Jan-Philipp-Munsch/kartonaut/hardware/mainboard/Fertiger_2026-10-21.md

# Mainboard rev B – Wo fertigen lassen?

Stand 2026-10-21. Gegenstand ist der Auftrag aus `ORDER.md`: 5 Platinen, 4 Lagen, 54 × 120 × 1,6 mm,
ENIG, davon 2 nur oben SMD-bestückt. THT-Teile werden selbst gelötet. Die Zahlen stammen aus einer
Webrecherche von Preisseiten, Hilfe-Artikeln und Forenberichten, **nicht aus Angeboten**. Nur JLCPCB
veröffentlicht vollständige Bestückungspreise; alle Euro-Summen sind Schätzungen (1 USD ≈ 0,92 EUR).
Am Bestelltag mit der echten BOM und CPL in den Kalkulatoren nachrechnen.

**Zoll seit 01.07.2026:** Die Zollfreiheit für Sendungen unter 150 € ist entfallen. Je Warenposition
(HS-Code) fallen pauschal 3 € Zoll an, dazu 19 % Einfuhrumsatzsteuer. Dieser Auftrag liegt über
150 €, IOSS greift also nicht. Die Abgaben werden entweder über die Versandart vorab bezahlt oder bei
Lieferung (dann zusätzlich mit DHL-Auslagenpauschale).

## Entscheidung (21.10.2026 nachts, nach dem Review)

**JLCPCB, 4 Lagen, ENIG, 5 Platinen, davon 2 mit Economic-Bestückung (Oberseite), Versand Global Standard
Direct Line mit vorab bezahlten Abgaben.** Gründe: Die Bibliothek ist für JLC gemacht (LCSC-Footprints), drei der vier
schwierigen Teile liegen dort, die 54-mm-Breite passt zu Economic, und der Preis liegt mit geschätzten 150 bis 220 €
(Bestellplan §3.4) rund 100 € unter Aisler und 150 € unter PCBWay. Eine dritte bestückte Platine kostet nur die
Bauteile (ca. 25 USD) und ist die billigste Versicherung gegen einen Bestückungsfehler; Jan entscheidet das am
Bestelltag.

**Barometer:** Der BMP390 (C5124834) ist bei LCSC am 21.10. nachts „Not available now“, ohne Bestand und Preis. Der
BMP388 (C779278) liegt mit 7362 Stück zu 7,67 USD auf Lager, ist pin- und bibliothekskompatibel und bei Bosch
abgekündigt, was für fünf Platinen keine Rolle spielt. **Für diesen Lauf wird der BMP388 bestückt**; der BMP390
kommt, sobald er wieder gelistet ist. Falls JLC den BMP388 nicht bestückt: Footprint leer lassen und ein Breakout an
J_QWIIC oder (Review B6) an SPI1 anschließen.

**Was das Review an der Fertigung ändert:** zwei Polyfuses, zwei weitere P-FETs, fünf Polymer-Elkos in 7343 (statt
dreier THT-Elkos, die sonst von Hand kämen), ein SN74LV1T34 statt zweier 74AHCT1G125, ein Kelvin-Shunt-Footprint, zwei
zusätzliche Pyro-Kanäle als DNP. Netto etwa 15 USD mehr an Rüstgebühren und Teilen, dafür drei Handlötstellen weniger.
Economic bleibt möglich; das Risiko für Standard-PCBA sind nach wie vor die WS2812B-2020 (dann 5050-Gehäuse nehmen).

**Rückfall Aisler** (Aachen, kein Zoll, ab 1 bestückter Platine), wenn am Bestelltag eines eintritt: ICM-42688-P,
TPS63070 oder E22-400T22S sind bei JLC nicht bestellbar und nicht per Global Sourcing zu bekommen; JLC verlangt
Standard-PCBA mit über 60 USD Mehrkosten; oder die Abgaben lassen sich nicht vorab abrechnen. Dann E22 beistellen
(+15 €), ICM über Distributor; rund 400 bis 480 € gesamt.

**Am Bestelltag** gilt die Liste unten unverändert; dazu Bestellplan §3.3 (Teilestatus) und §7.2 (neue Teile).

## Vergleich

| Fertiger | Leiterplatte | Bestückung | Kritische Teile | Lieferzeit nach DE | Zoll/USt | Gesamt, geschätzt |
|---|---|---|---|---|---|---|
| **JLCPCB** (CN) | 4L ENIG auch in *Economic* möglich; ca. 35–55 $ | Economic ab 2 Stk, eine Seite; Einrichtung 8,18 $, Schablone 1,53 $, 3,07 $ je Extended-Teil, ca. 0,0017 $ je Lötstelle; LGA/QFN automatisch geröntgt | ICM-42688-P, TPS63070, E22-400T22S im LCSC-Lager; **BMP390 nicht verfügbar** | 3–7 Tage Fertigung + 7–11 Tage Direct Line (Express 3–5) | Direct Line: Abgaben vorab bezahlt | **ca. 320–380 €** |
| **PCBWay** (CN) | Preis nur im Angebot | Prototyp-Bestückung ab 29 $ (Aktion), Teile über Digikey/Mouser mit Aufschlag oder beigestellt; Angebot von Hand, 1–2 Tage | E22 nur über Ebyte/LCSC, anfragen oder beistellen | 3–5 Tage + Teilebeschaffung, Express 3–5 Tage | meist bei Lieferung an DHL | ca. 350–500 € |
| **Aisler** (Aachen) | 4L 1,6 mm ENIG Standard; netto 14 € + 0,13 €/cm², nur in 3er-Sätzen (Preisstand 2023) | ab 1 Stk; Teile über Distributoren; **Beistellung 15 € je Position** | E22 beistellen | ca. 2–3 Wochen gesamt | Inland, 19 % USt | ca. 400–480 € |
| **Eurocircuits** (BE) | ENIG wählbar | *PCB Proto* 1–5 Stk, Schablone inklusive, SPI und Röntgen | Beschaffung über Mouser/Digikey/Farnell/TME, E22 beistellen | ca. 6 Werktage + 1–3 Tage Versand | EU, kein Zoll | nicht veröffentlicht, vermutlich > 500 € |
| **Multi-CB** (DE) | ja | keine Prototyp-Bestückung | – | – | **nur an Firmen** | scheidet aus |
| **Beta Layout / PCB-Pool** (DE) | ja, ab 1 Stk | Bestückung mit Kitting angeboten | offen | 8 h bis 6 Werktage | Inland | nur im Kalkulator |

## Empfehlung

**JLCPCB, Economic-Bestückung, 2 von 5 Platinen, Versand per Global Standard Direct Line.**

- Die Bibliothek dieses Projekts ist für JLC gemacht: Die LCSC-Footprints in
  `kicad/lib/lcsc.pretty` sind genau die, mit denen JLC bestückt.
- Drei der vier schwierigen Teile liegen dort auf Lager. Das E22-Modul gibt es außerhalb von Ebyte/LCSC
  kaum.
- 54 mm Breite passt nur zu *Economic*: *Standard* verlangt 70 × 70 mm und bräuchte einen Nutzen oder
  Randstreifen.
- Mit Abstand am günstigsten.

**Das BMP390** ist der offene Punkt. Möglichkeiten in dieser Reihenfolge:

1. Global Sourcing oder Vorbestellung über JLC.
2. Den Platz als DNP bestücken lassen und den Chip selbst mit Heißluft löten: LGA-10, 2 × 2 mm, heikel.
3. BMP388 (pinkompatibel, aber abgekündigt) als Ersatz.
4. Ein Breakout an J_QWIIC (`ORDER.md` §5).

Eigene Teile zu JLC zu schicken (Consignment) lohnt bei 2 Stück nicht.

**Rückfall in der EU: Aisler.** Kein Zoll, deutscher Support, ab 1 bestückter Platine. Das E22 wird
beigestellt (+15 €), das ICM-42688-P beschafft Aisler über Distributoren. Rund 100 € teurer als JLC.

**Billigste Variante:** nur Platinen und Schablone bei JLC, alles selbst bestücken. Lohnt sich nur, wenn
LGA-14 mit 0,5 mm Raster und VQFN-15 per Reflow sicher gelingen.

## Am Bestelltag prüfen

1. Bestand im **JLC**-Teilekatalog (nicht nur bei LCSC) von ICM-42688-P, TPS63070, E22-400T22S und BMP390.
   Dazu Mindestabnahme und Rüstgebühr der Extended-Teile.
2. Ob die Direct Line für Deutschland bei über 150 € Warenwert die Abgaben vorab abrechnet. Welcher Zoll
   je HS-Position angesetzt wird.
3. Ob Economic mit 4L/ENIG/1,6 mm ohne Aufpreis durchgeht. Ob Röntgen automatisch berechnet wird.
4. Bauteildrehungen in der Bestückungsvorschau (WS2812B-2020, E22, HTSSOP-16 mit Wärmepad, VQFN-15).
5. BMP390-Bestand bei Digikey, Mouser und LCSC. Zuletzt waren es bei Digikey zeitweise 0 Stück mit
   8–12 Wochen Lieferzeit.
6. Aisler: Kalkulator mit aktuellen Preisen. Gelten die 3er-Sätze noch? Steht LGA im
   Bestückungsportfolio? Wie läuft die Beistellung?
7. Für einen echten Vergleich mit derselben BOM/CPL ein Angebot bei PCBWay und Eurocircuits einholen.
   Nimmt Eurocircuits Privatkunden an?

## Quellen

- JLCPCB: [Bestückungspreise](https://jlcpcb.com/help/article/pcb-assembly-price), [Fähigkeiten Economic/Standard](https://jlcpcb.com/capabilities/pcb-assembly-capabilities), [Prototyp-Bestückung](https://jlcpcb.com/solutions/pcb-prototype-assembly), [Teilebeschaffung](https://api.jlcpcb.com/help/article/pcba-parts-sourcing-instruction), [Beistellung](https://jlcpcb.com/help/article/how-to-consign-parts-to-jlcpcb), [EU-USt/IOSS](https://jlcpcb.com/help/article/EU-VAT-E-commerce-Rules-%26-Adjustments), [Fertigungszeiten](https://jlcpcb.com/help/article/pcb-fabrication-services-and-production-time)
- Teile: [JLC ICM-42688-P](https://jlcpcb.com/partdetail/TDK_InvenSense-ICM42688P/C1850418), [JLC BMP390](https://jlcpcb.com/partdetail/BoschSensortec-BMP390/C5124834), [LCSC TPS63070](https://www.lcsc.com/product-detail/C109322.html), [LCSC E22-400T22S](https://fat.lcsc.com/product-detail/image/E22-400T22S_C2903765.html), [Digikey BMP390](https://www.digikey.es/en/products/detail/bosch-sensortec/BMP390/16164575)
- Zoll: [EU-Kommission, 3-€-Zoll ab 01.07.2026](https://commission.europa.eu/news-and-media/news/ensuring-fairness-and-safety-eur3-customs-duty-low-value-parcels-2026-06-29_en), [DHL zu den Zollregeln 2026](https://www.dhl.com/de-de/home/wichtige-informationen/2026/new-customs-rules.html)
- Foren zum Versand nach DE und zu Preisen: [EEVblog](https://www.eevblog.com/forum/manufacture/jlcpcb-shipping/msg5538881/), [mikrocontroller.net](https://www.mikrocontroller.net/topic/517292), [EEVblog 4L-Preis](https://eevblog.com/forum/manufacture/a-good-pcb-manufacture-for-hobby-pcb/msg5569241), [EEVblog PCBWay-Turnkey](https://www.eevblog.com/forum/manufacture/turnkey-assembly-costs-price-check/)
- [PCBWay Bestückung](https://www.pcbway.com/pcb-assembly.html), [Aisler Preise](https://community.aisler.net/t/our-simple-pricing/102), [Aisler Bestückung](https://aisler.net/en/products/assembly), [Multi-CB Bestückung](https://www.multi-circuit-boards.eu/en/pcb-assembly.html), [Eurocircuits PCB Proto](https://www.eurocircuits.com/pcb-assembly-proto/), [Beta Layout Prototypen](https://eu.beta-layout.com/pcb/pcb-types/prototype/)
