Jan-Philipp-Munsch/kartonaut/hardware/mainboard/datasheet/MS-MB-B.tex

% Datenblatt Kartonaut Mainboard rev B1. Gebaut mit build.py (pdflatex, MiKTeX).
% Stückliste: bom_generated.tex aus kicad/circuit.py (make_bom.py), nie von Hand.
\documentclass[10pt,a4paper,twoside]{article}
\usepackage[T1]{fontenc}
\usepackage[utf8]{inputenc}
\usepackage[ngerman]{babel}
\usepackage{lmodern}
\usepackage[sfdefault]{roboto}
\usepackage{textcomp}
\usepackage[top=22mm,bottom=20mm,left=18mm,right=18mm,headheight=14pt]{geometry}
\usepackage{graphicx}
\usepackage{booktabs}
\usepackage{longtable}
\usepackage{array}
\usepackage{tabularx}
\usepackage{xcolor}
\usepackage{fancyhdr}
\usepackage{titlesec}
\usepackage{multicol}
\usepackage{enumitem}
\usepackage{siunitx}
\usepackage{tcolorbox}
\usepackage{caption}
\usepackage{microtype}
\usepackage{float}
\usepackage{needspace}
\usepackage[hidelinks]{hyperref}
\input{bom_summary.tex}

\definecolor{msblue}{HTML}{1F4E79}
\definecolor{msred}{HTML}{C0392B}
\definecolor{msgrey}{HTML}{555555}
\definecolor{rowgrey}{HTML}{F2F2F2}
\sisetup{locale=DE,mode=text,per-mode=symbol,range-phrase={ bis },range-units=single,product-units=single}
\setlist{nosep,leftmargin=*}
\captionsetup{font=small,labelfont={bf,color=msblue}}
\renewcommand{\arraystretch}{1.15}
\setlength{\tabcolsep}{4pt}
\setlength{\parindent}{0pt}
\setlength{\parskip}{4pt}
\raggedbottom   % sonst dehnt \flushbottom die Seiten vor unverschieblichen Tabellen und Bildern
\newcolumntype{L}[1]{>{\raggedright\arraybackslash}p{#1}}
\newcommand{\pn}{MS-MB-B1}
\newcommand{\docrev}{0.2}
\newcommand{\docdate}{26.\,10.\,2026}
\newcommand{\pin}[1]{\texttt{#1}}

% --- Kopf- und Fußzeile im Datenblattstil
\pagestyle{fancy}
\fancyhf{}
\fancyhead[L]{\small\bfseries\color{msblue}\pn{} Flugcomputer-Mainboard rev B1}
\fancyhead[R]{\small\color{msgrey}Kartonaut \,·\, Datenblatt \docrev{} \,·\, \docdate}
\fancyfoot[L]{\scriptsize\color{msgrey}Bestellfassung. Schaltung und Layout als KiCad-Projekt \texttt{hardware/mainboard/kicad/} (DRC 0 Fehler, 26.\,10.\,2026); Stückliste aus \texttt{circuit.py}. Kennwerte sind Rechenwerte, am Gerät noch nicht gemessen.}
\fancyfoot[R]{\small\thepage}
\renewcommand{\headrulewidth}{0.6pt}
\renewcommand{\headrule}{\color{msblue}\hrule width\headwidth height\headrulewidth}

\titleformat{\section}{\Large\bfseries\color{msblue}}{\thesection}{0.6em}{}[\vspace{-6pt}{\color{msblue}\rule{\textwidth}{0.4pt}}]
\titleformat{\subsection}{\large\bfseries\color{msblue}}{\thesubsection}{0.6em}{}
\titleformat{\subsubsection}{\normalsize\bfseries}{\thesubsubsection}{0.6em}{}
\titlespacing{\section}{0pt}{14pt}{8pt}
\titlespacing{\subsection}{0pt}{10pt}{4pt}

\begin{document}

% ============================================================ Seite 1
\thispagestyle{empty}
\begin{minipage}[t]{0.62\textwidth}
  \vspace{0pt}
  {\color{msblue}\Huge\bfseries \pn}\\[2pt]
  {\LARGE\bfseries Flugcomputer-Mainboard rev B1}\\[4pt]
  {\large\color{msgrey}Trägerplatine für Teensy 4.1 mit IMU, Barometer, Strommonitor, LoRa, vier Servo-, einer Motor- und vier Pyro-Endstufen für eine 75-mm-Modellrakete mit Schubvektorsteuerung}\\[6pt]
  {\small\color{msgrey}Kartonaut \,·\, Jan-Philipp Munsch \,·\, Datenblatt Version \docrev{} vom \docdate{} \,·\, \textcolor{msblue}{\bfseries BESTELLFASSUNG}}
\end{minipage}
\hfill
\begin{minipage}[t]{0.34\textwidth}
  \vspace{0pt}
  
  \par{\scriptsize\color{msgrey}Platine rev B1, Stand 26.\,10.\,2026 (KiCad-Render)}
\end{minipage}

\vspace{8pt}
\begin{multicols}{2}
\subsection*{Merkmale}
\begin{itemize}
  \item Teensy 4.1 (i.MX RT1062, \SI{600}{MHz}) als gestecktes Modul, SD-Slot und USB bleiben nutzbar
  \item 6-Achsen-IMU LSM6DSV16X an SPI1, exakt auf der Rollachse, \SI{\pm 16}{g}, \SI{\pm 2000}{\degree/s}
  \item Barometer BMP390 (zweites als Footprint), Strom-/Spannungsmonitor INA239 mit \SI{20}{\milli\ohm}-Kelvin-Shunt, alle Flugsensoren an SPI1 über einen CS-Decoder
  \item Magnetometer LIS3MDL und Feuchte/Temperatur SHT40 an I²C, Footprint für ADXL375 (\SI{\pm 200}{g})
  \item LoRa E22-400T22S (SX1268, \SI{433}{MHz}, \SI{22}{dBm}) auf der Platine, IPEX-Antennenanschluss; GPS-Anschluss für ein u-blox-Modul in der Spitze
  \item Zwei getrennte Akkupfade mit Verpolschutz, Polyfuse und FET-Lastschalter: 1S für Elektronik (Buck-Boost \SI{5}{V}/\SI{2}{A}), 2S für Servos, Rollmotor und Pyro; Laden in der Rakete
  \item Vier Servoausgänge am 2S-Akku (bis \SI{8.4}{V}), DRV8833-Motortreiber
  \item Vier Pyro-Kanäle low-side (zwei bestückt) mit externem Arming, Durchgangsprüfung und TVS
  \item Beide Akkuspannungen, Arming und Pyro-Durchgang über einen Analogmux am ADC; WS2812B-Kette, Summer, Kamera-Trigger
  \item Stapelstecker J\_STACK (2 × 10) für Zusatzplatinen: SPI0 mit drei CS, I²C, UART, PWM, IRQ, Reset, \SI{3.3}{V}-LDO; alle Stecker verriegelt
  \item \qtyproduct{54 x 120}{mm}, 4 Lagen, ENIG, Bestückung einseitig
\end{itemize}

\subsection*{Anwendungen}
\begin{itemize}
  \item Flugcomputer einer Modellrakete mit kardanisch aufgehängtem Motor (TVC)
  \item Lageregelung mit \SI{100}{Hz}, Höhenschätzung, Datenlogger, Telemetrie
  \item Bergung mit CO\textsubscript{2}-Ausstoß (Servo) oder pyrotechnisch, später Landung mit zweitem Motor und Landebeinen
  \item TVC-Prüfstand mit Propellerantrieb (Gasausgang über PWM\_EXT)
\end{itemize}

\subsection*{Beschreibung}
Das \pn{} ersetzt den Breakout-Aufbau des Flugcomputers durch eine Platine, die den Teensy 4.1 trägt und alle Sensoren, die Funkstrecke, die Versorgung, die Lader und die Endstufen für Servos, Motor und Zünder enthält. Die beiden Akkus sind so getrennt, dass Servo- und Pyro-Spitzen den Rechner nicht in den Neustart ziehen können; \SI{940}{\micro F} hinter einer Schottky-Diode halten den Teensy über kurze Einbrüche. Die IMU liegt auf der Rollachse der Rakete; die Lage entsteht in der Firmware aus dem Gyro. Die Pyro-Kanäle führen nur mit externem Arming Spannung. Die Platine sitzt als Längs-Schlitten in einem Ring-Stack im Kuppler der Rakete und ist mit beiden Akkus als Modul herausziehbar.
\end{multicols}

\begin{figure}[H]
  \centering
  
  \caption{Blockschaltbild. Extern bleiben nur Akkus, Schalterbrett, Servos, Motor, Zünder, GPS und Antenne.}
\end{figure}

\clearpage
\tableofcontents
\vfill
\begin{tcolorbox}[colback=rowgrey,colframe=msblue,title=Stand dieses Datenblatts]
Schaltung und Layout beschreiben den KiCad-Stand vom 26.\,10.\,2026 (ERC 0/0, DRC 0 Fehler, 0 offene Verbindungen, Schaltplan-Parität 0), nach dem Review vom 21.\,10., den Entscheidungen E1 bis E12 und der Abschlussprüfung vom 26.\,10. Die Stückliste in Abschnitt~\ref{sec:bom} wird aus \texttt{kicad/circuit.py} erzeugt. Fertigungsdaten in \texttt{kicad/fab/} (Gerber, Bohrdaten, BOM, CPL, 26.\,10.\,2026). Verbindlich bleibt die Spezifikation \texttt{hardware/mainboard/README.md}; Abweichungen mit Begründung in \texttt{kicad/README.md} §6.
\end{tcolorbox}
\clearpage

% ============================================================
\section{Grenzwerte und Betriebsbedingungen}

\subsection{Absolute Grenzwerte}
Überschreiten kann die Platine dauerhaft beschädigen. Kein Betrieb an diesen Grenzen.

\begin{tabularx}{\textwidth}{L{44mm} L{16mm} L{16mm} L{12mm} X}
\toprule
\textbf{Größe} & \textbf{min.} & \textbf{max.} & \textbf{Einheit} & \textbf{Bemerkung}\\
\midrule
Spannung J\_BAT1 (1S) gegen GND & $-$16 & 16 & V & Verpolschutz-FET Q2; TPS63070 bis \SI{17}{V}\\
Spannung J\_BAT2 (2S) gegen GND\_PWR & $-$12 & 12 & V & Verpolschutz-FET Q1; TVS SMAJ12CA, DRV8833 \SI{10.8}{V}\\
Spannung J\_CHG1 (USB-C VBUS) & $-$0,3 & 6 & V & MCP73831\\
Strom 1S-Pfad, Dauer & & 2 & A & Polyfuse F2 (Haltestrom)\\
Strom 2S-Pfad, Dauer & & 3 & A & Polyfuse F1 (Haltestrom); \SI{6}{A} Auslösestrom; Shunt \SI{1}{W} bis \SI{7}{A}\\
Strom Pyro-Kanal, Puls & & 5 & A & AO3400A, Puls $\le$ \SI{100}{ms}; Kurzschluss der E-Match möglich\\
Strom je Servo-Stecker & & 2 & A & JST-XH Kontakt\\
Strom J\_STACK VSERVO / 5V\_SYS / 3V3\_EXP & & 2 / 1 / 0,5 & A & zwei VSERVO-Pins; AP2112K \SI{600}{mA}\\
Spannung an Teensy-Pins & $-$0,3 & 3,6 & V & \SI{3.3}{V}-Logik, \emph{nicht} \SI{5}{V}-tolerant\\
Spannung an J\_QWIIC, J\_GPS, J\_CAM, J\_LED, J\_STACK & $-$0,3 & 3,6 & V & außer Versorgungspins\\
USB am Teensy gleichzeitig mit Akku & & & & zulässig (Schottky D1, Abschnitt~\ref{sec:power})\\
Lagertemperatur & $-$40 & 85 & \si{\degreeCelsius} & LiPo-Akkus getrennt lagern\\
\bottomrule
\end{tabularx}

\subsection{Empfohlene Betriebsbedingungen}
\begin{tabularx}{\textwidth}{L{44mm} L{12mm} L{12mm} L{12mm} L{12mm} X}
\toprule
\textbf{Größe} & \textbf{min.} & \textbf{typ.} & \textbf{max.} & \textbf{Einheit} & \textbf{Bemerkung}\\
\midrule
1S-Akku (J\_BAT1) & 3,1 & 3,7 & 4,2 & V & Buck-Boost schaltet ab \SI{3.1}{V} ein, unter \SI{2.7}{V} ab (A2)\\
2S-Akku (J\_BAT2) & 6,0 & 7,4 & 8,4 & V & W5652H bis \SI{8.4}{V}, DRV8833 bis \SI{10.8}{V}\\
1S-Akku Kapazität / Entladerate & 450 & 500 & 600 & mAh & 20--30 C, \emph{ohne} Schutzschaltung (Spitze \SI{1.6}{A})\\
2S-Akku Kapazität / Entladerate & 450 & 850 & & mAh & 50 C; 850 mAh für Landung mit zweitem Motor\\
Ladestrom 1S (J\_CHG1) & & 0,5 & & A & MCP73831, PROG \SI{2}{k\ohm}, Thermoregelung\\
Strom 5V\_SYS gesamt & & 0,4 & 1,5 & A & TPS63070 \SI{2}{A}; Reserve für J\_STACK\\
Strom 3V3\_RF & & 0,15 & 0,5 & A & AP2112K \SI{600}{mA}; LoRa-Sendepuls 100--140 mA\\
Strom 3V3\_EXP (J\_STACK) & & & 0,5 & A & eigener AP2112K\\
Strom Teensy-3V3 für Sensoren und Logik & & 0,03 & 0,25 & A & Teensy-LDO; 3V3\_SENS über Ferrit\\
SPI1-Takt (IMU, BMP390, INA239) & & 7 & 10 & MHz & LSM6DSV16X \SI{10}{MHz}, BMP390 \SI{10}{MHz}\\
SPI0-Takt zur Zusatzplatine & & 4 & 8 & MHz & \SI{114}{mm} MISO mit 16 Vias\\
I²C-Takt & & 400 & 1000 & kHz & \SI{4.7}{k\ohm} Pull-ups an 3V3\\
Zündpuls Pyro & 20 & 50 & 100 & ms & Firmware begrenzt, Abbruch bei Durchgangsverlust; E-Match 3--5 A\\
Betriebstemperatur & $-$10 & 20 & 50 & \si{\degreeCelsius} & begrenzt durch die LiPo-Akkus\\
\bottomrule
\end{tabularx}

\Needspace{80mm}
\subsection{Elektrische Kennwerte}
Rechenwerte aus Datenblättern, Spezifikation und Layoutmessung; am Gerät noch nicht gemessen.

\begin{tabularx}{\textwidth}{L{44mm} L{26mm} L{11mm} L{11mm} L{11mm} L{19mm} X}
\toprule
\textbf{Parameter} & \textbf{Bedingung} & \textbf{min.} & \textbf{typ.} & \textbf{max.} & \textbf{Einheit} & \textbf{Quelle}\\
\midrule
5V\_SYS Ausgangsspannung & 1S 3,1--4,2 V, 0--2 A & 4,93 & 4,98 & 5,03 & V & TPS63070, FB 680 k / 130 k\\
Einschaltschwelle 1S (steigend / fallend) & EN-Teiler 330 k / 115 k & 2,98 & 3,10 / 2,71 & 3,21 & V & TPS63070 $V_{\mathrm{THR}}$ 0,77--0,83 V\\
Anlauf 5V\_SYS & \SI{940}{\micro F} hinter D1 & & 10 & & ms & Softstart, Eingangsstrom typ. \SI{1}{A}\\
Teensy VIN & hinter Schottky D1 & & 4,6 & & V & SS14, \SI{0.4}{V}\\
Hold-up Teensy VIN bei Ausfall 5V\_SYS & \SI{0.15}{A}, 4,6 $\to$ 3,6 V & & 6 & & ms & \SI{940}{\micro F} Polymer\\
3V3\_RF, 3V3\_EXP & $\le$ \SI{0.5}{A} & 3,23 & 3,3 & 3,37 & V & AP2112K\\
Ruhestrom 1S-Pfad & Teensy 600 MHz, Funk Empfang & & 0,6 & & A & Strombudget\\
Betriebsdauer Elektronik & 500 mAh 1S & & 45 & & min & \\
Strommessung Bereich / Auflösung & 20 m$\Omega$, ADCRANGE 0 & & 0,25 & $\pm$8,19 & A / mA & INA239, \SI{163.84}{mV}\\
Spannungsmessung Akkus, ARM & Teiler 100 k / 33 k, 12 bit & & 3,3 & 13,3 & V / mV & über 74HC4051\\
Servo-Spitzenstrom VSERVO & 2 × W5652H blockiert & & 2 & & A & \SI{660}{\micro F} Puffer\\
Pyro-Durchgangsprüfung & Arming an, E-Match gesteckt & & VBAT & & & Teiler 100 k / 33 k am Drain\\
IMU Rauschen Gyro / Accel & High-Performance & & 3,8 / 60 & & mdps, \textmu g je $\sqrt{\mathrm{Hz}}$ & LSM6DSV16X\\
Barometer Rauschen & OSR ×8, IIR 3 & & 0,085 & & Pa & BMP390 (ca. \SI{1}{cm})\\
LoRa Sendeleistung & 433 MHz, 2,4 kbps & & 22 & & dBm & E22-400T22S, 158 mW\\
Kupferbreite 2S-Pfad (XT30 bis Shunt, Arming, Pyro) & gemessen in der Platinendatei & 1,0 & & 1,6 & mm & \SI{2.4}{A} dauernd bei 10 K (IPC-2221)\\
Kupferbreite 1S-Pfad & gemessen & 0,6 & & & mm & In2-Stück 1,2 mm (0,5 oz)\\
Masse Platine bestückt & ohne Teensy, Akkus & & 45 & & g & Schätzung\\
\bottomrule
\end{tabularx}

% ============================================================
\section{Anschlüsse und Pinbelegung}

\subsection{Stecker}
\begin{tabularx}{\textwidth}{L{22mm} L{34mm} L{34mm} X}
\toprule
\textbf{Ref} & \textbf{Typ} & \textbf{Belegung} & \textbf{Funktion}\\
\midrule
J\_BAT2 (J1) & XT30PW-M liegend & 1 +, 2 $-$ & 2S-LiPo 6,0--8,4 V: Servos, Motor, Pyro\\
J\_BAT1 (J2) & JST-PH 2 & 1 +, 2 $-$ & 1S-LiPo 3,1--4,2 V: Elektronik\\
J\_SW (J3) & JST-PH 4 & 1 SW1\_G, 2 GND, 3 SW2\_G, 4 GND\_PWR & zweipoliger Hauptschalter am Schalterbrett (Luke B); schaltet nur die Gates der Lastschalter, führt Mikroampere. JP1/JP2 überbrücken am Tisch; ohne Stecker ist die Rakete aus\\
J\_CHG1 (J17) & JST-PH 3 & 1 VBUS, 2 GND, 3 STAT & USB-C-Buchse am Schalterbrett, 1S-Lader \SI{500}{mA}, Lade-LED (STAT, open-drain)\\
J\_CHG2 (J18) & JST-PH 2 & 1 +, 2 $-$ & 2S-Ladebuchse (XT30 mit Balancer am Schalterbrett), parallel zum Akku vor dem Lastschalter\\
J\_ARM (J4) & JST-XH 2 & 1 VBAT\_PROT, 2 VBAT\_ARMED & Arming-Schlüsselschalter $\ge$ \SI{5}{A}, führt den Zündstrom\\
J\_SERVO1/2 (J5/J6) & JST-XH 3 liegend & S / + / $-$ & TVC Yaw (Pin 28) / Pitch (Pin 29), VSERVO = Akku direkt\\
J\_SERVO3/4 (J7/J16) & JST-XH 3 stehend & S / + / $-$ & Fallschirm (Pin 9) / Landebeine (Pin 10), VSERVO\\
J\_MOT (J8) & JST-XH 2 & OUT1, OUT2 & Rollmotor, DRV8833 Brücken parallel an VSERVO\\
J\_PYRO1/2 (J9/J10) & JST-XH 2 liegend & +, $-$ & E-Matches, + von VBAT\_ARMED\\
J\_PYRO3/4 (J19/J20) & JST-XH 2 liegend & +, $-$ & Kanäle 3/4: Stecker, FET und TVS DNP, Teiler bestückt\\
J\_GPS (J11) & JST-GH 4 & 3V3\_RF, GND, TX, RX & u-blox-Modul in der Spitze, Serial1\\
J\_QWIIC (J12) & JST-SH 4 & GND, 3V3, SDA, SCL & I²C-Erweiterung, Qwiic-Belegung\\
J\_CAM (J13) & JST-GH 3 & 5V, TRIG, GND & Kamera-Auslöser, Pin 7 über \SI{1}{k\ohm}\\
J\_LED (J14) & JST-GH 3 & 5V, DATA, GND & Fortsetzung der WS2812B-Kette (\SI{5}{V}-Pegel)\\
J\_STACK (J15) & Stiftleiste 2 × 10 & siehe Tabelle unten & Zusatzplatinen, Flachband oder Stapel\\
ANT & IPEX (u.FL) am E22 & & Pigtail \SI{10}{cm} zur $\lambda/4$-Antenne in der Spitze; ANT-Pad offen\\
TP1--TP7 & Testpunkte & & VBAT\_PROT, VSYS\_IN, 5V\_SYS, VSERVO, 3V3\_RF, 3V3\_EXP, GND\\
JP1 / JP2 & Lötbrücken & & SW1\_G $\to$ GND / SW2\_G $\to$ GND\_PWR: Hauptschalter am Tisch überbrücken\\
\bottomrule
\end{tabularx}

\subsection{Stapelstecker J\_STACK (2 × 10, 2,54 mm)}
\begin{tabularx}{\textwidth}{L{10mm} L{22mm} X L{10mm} L{22mm} X}
\toprule
\textbf{Pin} & \textbf{Signal} & \textbf{Bemerkung} & \textbf{Pin} & \textbf{Signal} & \textbf{Bemerkung}\\
\midrule
1 & GND & Logikmasse & 11 & CS\_EXT1 & 74HC138 Y5\\
2 & GND\_PWR & Masse Aktoren & 12 & CS\_EXT2 & 74HC138 Y6\\
3 & 3V3\_EXP & eigener LDO, \SI{0.5}{A} & 13 & IRQ\_EXT & Teensy 17\\
4 & 5V\_SYS & \SI{1}{A} & 14 & SDA & Wire, Pull-ups auf der Platine\\
5 & VSERVO & 2S, \SI{2}{A} je Pin & 15 & SCL & Wire\\
6 & VSERVO & & 16 & EXT\_RX & Teensy 21 (RX5)\\
7 & SPI0\_SCK & Teensy 13 & 17 & EXT\_TX & Teensy 20 (TX5)\\
8 & SPI0\_MOSI & Teensy 11 & 18 & PWM\_EXT & Teensy 33\\
9 & SPI0\_MISO & Teensy 12 & 19 & ARM\_EXT & VBAT\_ARMED über \SI{10}{k\ohm} (Sense)\\
10 & CS\_EXT0 & 74HC138 Y4 & 20 & NRST\_EXT & Teensy 15, open-drain\\
\bottomrule
\end{tabularx}

SPI0 ist bewusst ein eigener Bus: Ein Fehler auf der Zusatzplatine kann den Flugbus SPI1 nicht stören (E11).

\subsection{Teensy 4.1}
Alle 42 Pins sind belegt. Die Netzlistenprüfung \texttt{kicad/check\_design.py} vergleicht Schaltung und Tabelle; die Firmware-Pinbelegung prüft \texttt{firmware/tools/check\_board\_pins.py} in der CI.

\begin{tabularx}{\textwidth}{L{24mm} L{40mm} X L{40mm}}
\toprule
\textbf{Pin} & \textbf{Signal} & \textbf{Ziel} & \textbf{Schnittstelle}\\
\midrule
0 / 1 & RX1 / TX1 & J\_GPS & Serial1, \SI{3.3}{V}\\
2 / 3 & MOT\_IN1 / MOT\_IN2 & DRV8833 AIN1=BIN1 / AIN2=BIN2 & PWM \SI{20}{kHz}\\
4 & IMU\_INT & LSM6DSV16X INT1 & Interrupt\\
5 & LED\_DATA & SN74LV1T34 $\to$ WS2812B-Kette $\to$ J\_LED & Digital\\
6 & LORA\_NRST & E22 RESET, \SI{10}{k\ohm} nach 3V3\_RF & Digital, open-drain betreiben\\
7 & CAM\_TRIG & J\_CAM über \SI{1}{k\ohm} & Digital\\
8 & MOT\_FAULT & DRV8833 nFAULT, \SI{10}{k\ohm} Pull-up & Digital, Eingang\\
9 / 10 & SERVO\_CHUTE / SERVO\_LEGS & J\_SERVO3 / J\_SERVO4 & PWM Servo\\
11 / 12 / 13 & SPI0 MOSI / MISO / SCK & J\_STACK 8 / 9 / 7 & SPI0, $\le$ \SI{8}{MHz}\\
14 & PYRO4\_FIRE & Gate Pyro 4 (DNP) & Digital, beim Boot tief\\
15 & NRST\_EXT & J\_STACK 20 & Digital, open-drain\\
16 & LORA\_M0 & E22 M0 & Digital\\
17 & IRQ\_EXT & J\_STACK 13 & Interrupt\\
18 / 19 & SDA / SCL & LIS3MDL (0x1E), SHT40 (0x44), ADXL375 (0x53, DNP), J\_QWIIC, J\_STACK & I²C (Wire), \SI{4.7}{k\ohm}\\
20 / 21 & TX5 / RX5 & J\_STACK 17 / 16 & Serial5\\
22 / 23 & PYRO2\_FIRE / PYRO1\_FIRE & Gate Q4 / Q3 über \SI{100}{\ohm} & Digital, beim Boot tief\\
24 & MUX\_OUT & 74HC4051: Pyro 1--4, VBAT1, VBAT2, ARM, GND & ADC (A10)\\
25 / 30 / 38 & SEL1 / SEL2 / SEL0 & 74HC138 und 74HC4051 gemeinsam & Digital\\
26 / 27 / 39 & MOSI1 / SCK1 / MISO1 & LSM6DSV16X, BMP390 (×2), INA239 & SPI1, \pin{SPI1.setMISO(39)}\\
28 / 29 & SERVO\_YAW / SERVO\_PITCH & J\_SERVO1 / J\_SERVO2 über \SI{220}{\ohm} & PWM Servo\\
31 & CS\_EN & 74HC138 E0, \SI{10}{k\ohm} Pull-up & Digital; hoch = alle CS inaktiv\\
32 & LORA\_M1 & E22 M1 & Digital\\
33 & PWM\_EXT & J\_STACK 18 & PWM\\
34 / 35 & RX8 / TX8 & E22 TXD / RXD & Serial8\\
36 & LORA\_AUX & E22 bereit / Sendepuffer frei & Digital, Eingang (nicht treiben)\\
37 & BUZZER & AO3400A $\to$ Summer & Digital\\
40 & MOT\_NSLEEP & DRV8833 nSLEEP (interner Pull-down) & Digital\\
41 & PYRO3\_FIRE & Gate Pyro 3 (DNP) & Digital, beim Boot tief\\
\bottomrule
\end{tabularx}

\begin{figure}[H]
  \centering
  
  \caption{Pinbelegung des Teensy 4.1 auf dem \pn{} (rev B1). Netzliste gegen diese Tabelle geprüft.}
\end{figure}

\subsection{Chip-Selects und Analogmux}
\textbf{74HC138} (U12): Adresse SEL0..2, Freigabe CS\_EN (aktiv tief). Y0 IMU, Y1 BMP390, Y2 BMP390 Nr.\,2 (DNP), Y3 INA239, Y4--Y6 CS\_EXT0--2 an J\_STACK, Y7 frei. Die Firmware setzt die Adresse und zieht dann CS\_EN tief; zwischen zwei Transfers bleibt CS\_EN hoch, dann sind alle CS inaktiv.

\textbf{74HC4051} (U13): dieselben Adressleitungen; Kanal 0--3 PYRO1--4\_SENSE, 4 VBAT1\_SENSE, 5 VBAT2\_SENSE, 6 ARM\_SENSE, 7 GND (Nullpunkt). Gelesen wird bei CS\_EN hoch, also ohne laufenden SPI-Transfer; Einschwingzeit \SI{10}{\micro s}. Alle Teiler 100 k / 33 k mit \SI{100}{nF} am Mux-Eingang, Vollausschlag \SI{13.3}{V}.

\subsection{Bus-Adressen und Kennungen}
\begin{tabularx}{\textwidth}{L{26mm} L{30mm} L{48mm} X}
\toprule
\textbf{Gerät} & \textbf{Bus} & \textbf{Adresse / Kennung} & \textbf{Bibliothek}\\
\midrule
LSM6DSV16X & SPI1, CS Y0 & WHO\_AM\_I = 0x70 & \texttt{STMicroelectronics/LSM6DSV16X} oder eigener Registertreiber\\
BMP390 & SPI1 4-Draht, CS Y1 (Y2) & CHIP\_ID = 0x60 & Adafruit \texttt{BMP3XX} (SPI)\\
INA239 & SPI1, CS Y3 & MANUFACTURER\_ID = 0x5449 & eigener Treiber, \pin{SHUNT\_CAL} aus \SI{20}{\milli\ohm}\\
LIS3MDL & I²C & 0x1E (SA1 hoch), WHO\_AM\_I = 0x3D & Adafruit \texttt{LIS3MDL}\\
SHT40 & I²C & 0x44 & Sensirion \texttt{arduino-sht}\\
ADXL375 (DNP) & I²C & 0x53 (SDO an GND), DEVID = 0xE5 & Adafruit \texttt{ADXL375}\\
E22-400T22S & Serial8, 9600 Bd & Adresse/Kanal per M0=M1=1 & eigenes \texttt{Radio.cpp}\\
W25Q128 & QSPI-Pads des Teensy & JEDEC 0xEF4018 & \texttt{LittleFS}\\
\bottomrule
\end{tabularx}

% ============================================================
\section{Funktionsbeschreibung}

\subsection{Stromversorgung}\label{sec:power}
\begin{figure}[H]
  \centering
  
  \caption{Versorgungsbaum: 1S-Pfad für die Elektronik, 2S-Pfad für Aktoren und Pyro, Lastschalter in beiden Pfaden, Sternpunkt der Massen am 2S-Minus.}
\end{figure}

\textbf{1S-Pfad.} Der 1S-Akku speist über den Verpolschutz-FET Q2, die Polyfuse F2 (\SI{2}{A}) und den Lastschalter Q7 (AO3401A, Gate über J\_SW oder JP1 an GND) den Buck-Boost U2 (TPS63070, Eingang 2--16 V, Ausgang \SI{5}{V} / \SI{2}{A}, \SI{1.5}{\micro H}, 3 × \SI{22}{\micro F} am Ausgang). Der Buck-Boost statt eines reinen Boosts ist Absicht: Ein versehentlich an J\_BAT1 gesteckter 2S-Akku zerstört nichts. Der EN-Teiler 330 k / 115 k schaltet den Pfad ab \SI{3.1}{V} ein und unter \SI{2.7}{V} ab (A2). 5V\_SYS versorgt über die Schottky D1 den Teensy mit 2 × \SI{470}{\micro F} Polymer als Hold-up (A1; USB darf gleichzeitig stecken, die VIN--VUSB-Brücke auf dem Teensy bleibt), die WS2812B-Kette über den Pegelwandler, den Summer, J\_CAM, J\_LED, und über zwei LDOs (AP2112K) die Schienen 3V3\_RF (Funk, GPS, \SI{100}{\micro F}) und 3V3\_EXP (J\_STACK). INA239, Decoder, Mux und die I²C-Sensoren hängen an den \SI{3.3}{V} des Teensy; IMU und Barometer bekommen daraus über Ferrit FB1 und \SI{10}{\micro F} die ruhige Schiene 3V3\_SENS. Der Lader U11 (MCP73831, \SI{500}{mA}) liegt vor dem Lastschalter an VBAT1\_F und lädt bei ausgeschalteter Rakete aus der USB-C-Buchse am Schalterbrett (E2). Beim Einschalten lädt der TPS63070 die \SI{940}{\micro F} hinter D1 in seiner Softstart-Strombegrenzung (typ. \SI{1}{A}), der Anlauf dauert etwa \SI{10}{ms}.

\textbf{2S-Pfad.} Der 2S-Akku speist über Q1, die Polyfuse F1 (\SI{3}{A} / \SI{6}{A}) und den Lastschalter Q6 (Gate über J\_SW oder JP2 an GND\_PWR) das Netz VBAT\_PROT. Davon zweigen vor dem Shunt der Arming-Pfad (J\_ARM $\to$ VBAT\_ARMED $\to$ Pyro 1--4) ab; Zündströme laufen nicht durch die Strommessung. Hinter dem \SI{20}{\milli\ohm}-Shunt R\_SH1 (2512, Kelvin-Pads, INA239) liegt VSERVO (Akku direkt, 2 × \SI{330}{\micro F} Polymer) für alle vier Servostecker, den DRV8833 und J\_STACK. Die Ladebuchse J\_CHG2 liegt direkt am Akku vor dem Lastschalter. Die Teiler für beide Akkuspannungen liegen vor den Lastschaltern, der Teensy am USB sieht beide Akkus auch bei ausgeschalteter Rakete.

\textbf{Hauptschalter.} Der zweipolige Schiebeschalter am Schalterbrett schaltet nur die Gates der beiden Lastschalter (je \SI{100}{k\ohm} nach Source, \SI{1}{k\ohm} zum Stecker); der Akkustrom bleibt auf der Platine (E1). Die Lastschalter arbeiten mit $V_{\mathrm{GS}} = -V_{\mathrm{Bat}}$, also $-2{,}7$ bis \SI{-4.2}{V} (1S) und $-6$ bis \SI{-8.4}{V} (2S); der AO3401A ist bei \SI{-2.5}{V} spezifiziert.

\textbf{Masse.} GND (Logik, 1S) und GND\_PWR (Servos, Motor, Pyro, 2S) treffen sich in genau einem Punkt, der Netzbrücke NT1 am 2S-Minus. Servo- und Pyro-Rückströme laufen über die GND\_PWR-Fläche auf B.Cu dorthin (gemessen $\ge$ \SI{2.3}{mm} breit zu jedem Servostecker), nicht durch die Massefläche unter IMU und Barometer.

\textbf{Strombudget.}

\begin{tabularx}{\textwidth}{L{30mm} X L{40mm} L{14mm}}
\toprule
\textbf{Akku / Schiene} & \textbf{Verbraucher} & \textbf{Dauer} & \textbf{Spitze}\\
\midrule
1S $\to$ 5V\_SYS & Teensy 0,1 A, 2 × WS2812B 0,12 A, Summer 0,03 A, 3V3\_RF 0,15 A & 0,4 A (0,6 A aus dem Akku) & 0,8 A\\
2S $\to$ VSERVO & 2 × W5652H (TVC), Blockierstrom je ca. 1 A & 0,2 A & 2 A\\
2S $\to$ VSERVO & Servo 3 und 4, Rollmotor ca. 1 A (PWM begrenzt) & 0,3 A & 2 A\\
2S $\to$ Pyro & E-Match 3--5 A für 20 ms & -- & 5 A\\
\bottomrule
\end{tabularx}

\subsection{Sensorik}
\textbf{IMU LSM6DSV16X} (U4, LGA-14, \qtyproduct{2.5 x 3}{mm}) an SPI1 mit \SI{7}{MHz}, CS aus dem Decoder (Y0), auf der Rollachse unter der Teensy-Mitte, Chip so gedreht, dass X quer und Y zur Spitze zeigt; die Achsenlage zur Platine unterscheidet sich vom ICM-42688-P und wird in der Firmware geprüft. Betrieb: Gyro \SI{\pm 2000}{\degree/s}, Accel \SI{\pm 16}{g}, ODR \SI{960}{Hz}, Tiefpass ca. \SI{50}{Hz}; die Firmware mittelt auf die \SI{100}{Hz}-Schleife. Die Sensorfusion im Chip (SFLP) ist eine Option, der Plan bleibt die Gyro-Quaternion in der Firmware, auf der Rampe mit dem Beschleunigungssensor initialisiert. INT1 an Pin 4. SDx/SCx (Pins 2, 3) an GND, INT2 und Aux-Pins (9--11) offen (AN5763 Tab.\,1). Vdd und Vdd\_IO an 3V3\_SENS, Abblockung \SI{100}{nF} + \SI{2.2}{\micro F} und \SI{10}{nF}. Im Radius \SI{5}{mm} um die IMU liegen nur ihre eigenen fünf GND-Vias, keine Bahnen auf In2. Der Spitzenschub des TSP E12 (\SI{28}{N}) ergibt bei \SI{705}{g} etwa \SI{5}{g} am Sensor.

\textbf{Barometer BMP390} (U5, LGA-10) an SPI1 im 4-Draht-Modus (E3), CS Y1, VDD/VDDIO an 3V3\_SENS; Oversampling Druck ×8, Temperatur ×1, IIR 3, \SI{50}{Hz}. Lage im rechten Streifen neben dem DRV8833, Schaum darüber; die Druckausgleichsbohrungen im Rohr B liegen auf dieser Höhe. Ein zweites BMP390 (U15, CS Y2) ist als DNP-Footprint vorgesehen; Rückfall BMP388 ist pinkompatibel.

\textbf{Strommonitor INA239} (U6, VSSOP-10) an SPI1 (CS Y3) mit \SI{20}{\milli\ohm}-Shunt (2512, \SI{1}{\percent}, \SI{1}{W}). Der Footprint teilt beide Lötflächen des Shunts in Strom- und Messfläche (Kelvin, A5); je \SI{10}{\ohm} und \SI{100}{nF} dazwischen filtern die Servo-PWM, VBUS liegt am lastseitigen Kelvin-Abgriff. Bei ADCRANGE 0 (\SI{\pm 163.84}{mV}) misst er \SI{\pm 8.19}{A} mit \SI{0.25}{mA} Auflösung. Nur Telemetrie, nicht in der \SI{100}{Hz}-Schleife.

\textbf{Zusatzsensoren an I²C} (23.\,10.): Magnetometer LIS3MDL (U16, 0x1E) in der linken Spitzenecke, \SI{12}{mm} von den Pyro-FETs; Feuchte/Temperatur SHT40 (U18, 0x44) neben J\_QWIIC; Footprint für den Hoch-g-Beschleunigungssensor ADXL375 (U17, \SI{\pm 200}{g}, 0x53, DNP) hinter dem USB-Ende. Alle drei an 3V3, nicht an 3V3\_SENS. Im Flug ist das Magnetometer durch Servo- und Pyroströme gestört (ca. \SI{9}{\micro T} bei \SI{2}{A} in \SI{45}{mm}); es regelt nichts.

\subsection{Funk und GPS}
\textbf{LoRa E22-400T22S} (U10, SMD \qtyproduct{16 x 26}{mm}, SX1268) an 3V3\_RF mit \SI{100}{\micro F}; TXD/RXD an Serial8 (\SI{3.3}{V}-Pegel, ohne Widerstände), M0/M1 an Pins 16/32, AUX an Pin 36 (nur lesen; extern nach unten gezogen startet das Modul im Upgrade-Modus), RESET an Pin 6 mit \SI{10}{k\ohm} nach 3V3\_RF (Low-Puls $>$ \SI{100}{\micro s}, nur im Fehlerfall). Konfiguration (Adresse, Kanal \SI{433}{MHz}, \SI{9600}{Bd}, Luftrate \SI{2.4}{kbps}, \SI{22}{dBm}) einmalig per M0 = M1 = 1 aus der Firmware. IPEX-Buchse zum Pigtail, $\lambda/4$-Antenne (\SI{17}{cm}) in der Spitze, frei von Kupfer und Akku; das ANT-Pad bleibt offen. Das Modul liegt auf einer Massefläche, Sperrflächen auf F.Cu und In2 darunter. Sendestrom 100--140 mA. Die Bodenstation nutzt das DIP-Modul E22-400T22D mit SMA-Antenne.

\textbf{GPS} nicht auf der Platine: u-blox MAX-M10S oder NEO-M9N in der Spitze, Patchantenne nach oben, mindestens \SI{10}{cm} von der LoRa-Antenne, über J\_GPS an Serial1. Dynamikmodell \emph{airborne $<$ 4 g}.

\subsection{Aktoren}
\textbf{Servos} an J\_SERVO1--4, Signal über \SI{220}{\ohm} von den Pins 28/29/9/10, Versorgung VSERVO = 2S-Akku direkt (E4): FrSky Xact W5652H (\SI{10}{g}, Hall-Sensor, 3,7--8,4 V, \SI{4.8}{kg.cm} und \SI{0.05}{s/60\degree} bei \SI{8.4}{V}) für TVC Yaw/Pitch, Servo 3 für die Bergung (CO\textsubscript{2}-Auslöser in \emph{Kartonaut 1}), Servo 4 für Landebeine. \textbf{Rollmotor} über U7 DRV8833 mit beiden Brücken parallel (AIN=BIN, AOUT=BOUT, ISEN an GND\_PWR), VM an VSERVO (E9), \SI{20}{kHz}-PWM auf Pins 2/3 mit begrenztem Tastverhältnis (\pin{ROLL\_PWM\_MAX} $\approx$ \SI{60}{\percent} für \SI{5}{V} aus \SI{8.4}{V}), nSLEEP an Pin 40 (Motor aus beim Booten), nFAULT an Pin 8. \emph{Kartonaut 1} fliegt ohne Rollmotor.

\subsection{Pyro-Kanäle und Arming}
\begin{figure}[H]
  \centering
  
  \caption{Ein Pyro-Kanal: Plus nur hinter dem externen Arming-Schalter, Low-Side-FET, Durchgangsprüfung am Drain über den Analogmux, TVS.}
\end{figure}
Vier Kanäle (E5), Kanal 1 und 2 bestückt, 3 und 4 nur als Footprint (FET, TVS, Stecker DNP, Teiler bestückt). Jeder Kanal ist ein Low-Side-Schalter AO3400A (\SI{30}{V}, \SI{5.7}{A}) mit \SI{100}{\ohm} am Gate und \SI{100}{k\ohm} Pull-down, damit der FET beim Booten sicher aus bleibt. Plus kommt von VBAT\_ARMED, das nur hinter dem externen Schlüsselschalter Spannung führt: Ohne Arming kann die Firmware nichts zünden. Die Durchgangsprüfung misst den Drain über 100 k / 33 k (Mux-Kanal 0--3): mit Arming und E-Match liegt er auf VBAT, ohne E-Match ziehen \SI{100}{k\ohm} nach GND. Eine bidirektionale TVS SMAJ12CA fängt die Abschaltspitze der Zuleitung. Stecker JST-XH 2 liegend an der Spitzen-Kante, Kabel mit Kabelbinder gesichert. Kupfer: Arming und Pyro-Plus \SI{1.6}{mm}, Rückleitung \SI{1.0}{mm}, FET-Source zur Fläche \SI{1.1}{mm}.

\begin{tcolorbox}[colback=red!4,colframe=msred,title=Sicherheit]
Tischtests nur mit Glühlämpchen oder \SI{2}{\ohm}-Widerstand, nie mit Ladung. Firmware-Regeln: Zünden nur in den Zuständen \emph{Apogäum} oder \emph{Landung}, Puls 50--100 ms mit Abschaltung bei Durchgangsverlust, jeder Kanal höchstens einmal, ohne ARM\_SENSE keine Freigabe; vor dem Start meldet der Summer den Durchgang. Für Schwarzpulver gilt das Sprengstoffrecht.
\end{tcolorbox}

\subsection{Anzeige und Signale}
Zwei WS2812B-2020 auf der Platine als Kette hinter einem SN74LV1T34 als Pegelwandler \SI{3.3}{V} $\to$ \SI{5}{V} (Pin 5, \SI{330}{\ohm} in Reihe), Ausgang zu J\_LED für eine externe Fortsetzung (B8). Aktiver \SI{5}{V}-Summer (BZ1, \SI{12}{mm}) über AO3400A an Pin 37 mit Freilaufdiode (B7). Kamera-Trigger Pin 7 über \SI{1}{k\ohm} an J\_CAM. Der Program-Taster des Teensy ist durch die Luke erreichbar; ein eigener Reset-Taster entfällt.

% ============================================================
\section{Mechanik und Einbau}
\begin{figure}[H]
  \centering
  
  \caption{Längsschnitt des Einbaus: Schlitten im Ring-Stack, Akkus im Träger darunter, Antenne in der Spitze.}
\end{figure}

\begin{itemize}
  \item \textbf{Platine} \qtyproduct{54 x 120}{mm}, \SI{1.6}{mm}, 4 Lagen, ENIG, Eckradius \SI{2}{mm}. Koordinaten: $u$ quer (0 auf der Rollachse), $v$ längs (0 am TVC-Ende). Bestückung nur oben, unten THT-Lötstifte unter \SI{2}{mm} (kürzen, Isolierlage \SI{1}{mm} zum Akkuträger).
  \item \textbf{Einbau} zwischen den Endringen des Ring-Stacks (Ø \SI{69}{mm}) im Kuppler (innen \SI{70.2}{mm}, \SI{150}{mm} lang). Die 8 M2-Stangen laufen \SI{5.7}{mm} neben den Längskanten. Befestigung 4 × M3 bei $u = \pm 23{,}5$, $v = 3{,}5 / 116{,}5$ (NPTH \SI{3.2}{mm}, Kupfer hält \SI{0.25}{mm} Abstand) auf dem gedruckten Träger.
  \item \textbf{Akkus} im Träger unter der Platine: 2S (\qtyproduct{56 x 25.5 x 8}{mm}) bei $v \approx 8$--64, 1S (ca. \qtyproduct{50 x 30 x 7}{mm}) bei $v \approx 68$--118, mit Klettband.
  \item \textbf{Bauhöhe} mittig über \SI{30}{mm} (Teensy auf \SI{8.5}{mm}-Buchsenleisten), am Rand ($|u| > 25$) höchstens \SI{5}{mm}; dort liegen nur 0603, WS2812-2020, SOT-23-5 und das E22-Modul ($\le$ \SI{2.6}{mm}).
  \item \textbf{Teensy} mittig ($v = 30$--91), SD-Slot zum TVC, USB zur Spitze; Freiflächen \SI{6}{mm} vor dem SD-Slot, \SI{12}{mm} vor USB. Luke im Kuppler bei $v \approx 25$--100; Schalterbrett (Schiebeschalter, USB-C, Lade-LED, Ladebuchsen) an Luke B, Kabel zu J\_SW, J\_CHG1, J\_CHG2.
  \item \textbf{IMU} bei $(u, v) = (0, 60{,}5)$, Pfeile im Bestückungsdruck; \textbf{Barometer} rechts bei $v \approx 60$; \textbf{Funkmodul} links bei $v \approx 48$--74, IPEX zur Spitze; \textbf{Wandler} links neben dem Teensy, $\ge$ \SI{25}{mm} von der IMU; \textbf{Magnetometer} in der linken Spitzenecke.
\end{itemize}

\begin{figure}[H]
  \centering
  
  \caption{Platzierungsplan und Querschnitt im Kuppler (\texttt{outline.py}): alle Bauteil-Hüllen bleiben im Kuppler und berühren die M2-Stangen nicht.}
\end{figure}

\begin{figure}[H]
  \centering
  \hfill
  
  \caption{KiCad-Render der Platine rev B1 von oben und unten (Stand 26.\,10.\,2026). Auf der Rückseite die Steckerbelegung und das Missionsabzeichen.}
\end{figure}

\subsection{Lagenaufbau und Layout}
\begin{tabularx}{\textwidth}{L{14mm} L{14mm} X L{60mm}}
\toprule
\textbf{Lage} & \textbf{Kupfer} & \textbf{Inhalt} & \textbf{Regel}\\
\midrule
F.Cu & 1 oz & Bauteile, Signale, 2S-Pfad und Pyro als Kupferflächen & Stromnetze nur hier (A6)\\
In1.Cu & 0,5 oz & durchgehend GND & keine Bahnen; keine Vias im Radius \SI{5}{mm} um die IMU\\
In2.Cu & 0,5 oz & Signale, 3V3-Verteilung & keine 2S-Netze; Sperrfläche unter dem Funkmodul\\
B.Cu & 1 oz & GND\_PWR-Fläche unter allem am 2S, 5V\_SYS-Fläche unter der 1S-Seite, 13 kurze Signalstücke & keine Bauteile\\
\bottomrule
\end{tabularx}

Stackup JLC04161H-7628, DRC-Regeln 0,15 mm Abstand (0,2 mm zur Stromklasse), Via 0,6 / 0,3 mm, Loch-zu-Loch 0,5 mm, Kupfer zum Rand 0,2 mm. Gemessene Mindestbreiten: 2S-Pfad vom XT30 bis zum Shunt \SI{1.0}{mm}, Arming und Pyro-Plus \SI{1.6}{mm}, Pyro-Rückleitung \SI{1.0}{mm}, VSERVO zu den TVC-Servos \SI{1.22}{mm}, zu Servo 3/4 0,72/0,61 mm, 1S-Pfad \SI{0.6}{mm} (In2-Stück \SI{1.2}{mm} in 0,5 oz), GND\_PWR-Rückweg $\ge$ \SI{2.3}{mm}. SPI0\_MISO zur Zusatzplatine ist \SI{114}{mm} lang mit 16 Vias, daher $\le$ \SI{8}{MHz}. Shunt mit Kelvin-Abgriff. Jede Schiene mit Testpunkt. Abschlussprüfung gegen die JLCPCB-Grenzen in \texttt{Abschlusspruefung\_2026-10-26.md}, Bewertung der Strompfade in \texttt{Review\_Bewertung\_2026-10-26.md}.

% ============================================================
\section{Inbetriebnahme}
\begin{enumerate}
  \item Ohne Teensy, beide Akkupfade am Labornetzteil mit \SI{100}{mA} Begrenzung, Schalter über JP1/JP2: 1S-Pfad mit \SI{3.7}{V} $\to$ 5V\_SYS, 3V3\_RF und 3V3\_EXP messen; 2S-Pfad mit \SI{7.4}{V} $\to$ VSERVO messen. Verpolung testen. Lastschalter: ohne JP1/JP2 und ohne Schalterbrett muss alles aus sein. Beim ersten Einschalten den Anlauf von 5V\_SYS mit dem Oszilloskop ansehen (Softstart in die \SI{940}{\micro F}).
  \item Teensy stecken, nur USB: beide Akkuspannungen über den Analogmux; LSM6DSV16X (WHO\_AM\_I = 0x70), BMP390 (CHIP\_ID = 0x60) und INA239 (MANUFACTURER\_ID = 0x5449) über SPI1 und den Decoder; I²C-Scan findet 0x1E und 0x44.
  \item 1S-Akku, Testkonsole \texttt{revb\_test} nach \texttt{firmware/Tischtest\_revB1.md}: Loop-Timing, Teleplot IMU/Baro, Kalibrierung, beide Akkuspannungen, INA239. Lader: USB-C am Schalterbrett, Rakete aus, Ladestrom \SI{500}{mA}, Lade-LED.
  \item 2S-Akku dazu: Servos einzeln bis zum Blockieren, Rollmotor mit begrenztem Tastverhältnis; der Teensy darf nicht neu starten (Watchdog-Zähler im Log 0). Einbruch von VBAT2 und 5V\_SYS mit dem Oszilloskop.
  \item Pyro nur mit Glühlämpchen oder \SI{2}{\ohm}: ohne ARM keine Zündung, ARM\_SENSE, Durchgang, Pulsdauer 50--100 ms, Abbruch bei Durchgangsverlust.
  \item LoRa-Strecke zur Bodenstation im Freien (Reichweite, Paketverlust), GPS-Fix in der Spitze bei sendendem LoRa; Versuche E01/E02 (Servo $\to$ Kardan) nach \texttt{firmware/Versuche\_revB1.md}.
\end{enumerate}

\textbf{Firmware für rev B1} (\texttt{firmware/}): Pinbelegung und Treiber in \texttt{lib/mainboard\_revb/} (BMP390, INA239, LIS3MDL, SHT40, ADXL375, CS-Decoder, Analogmux; der Treiber für den LSM6DSV16X hinter \texttt{Imu.h} ist offen), Testkonsole \texttt{revb\_test} mit Kalibrierung im EEPROM-Emulat, Flug-Firmware in \texttt{src/} mit Gyro-Quaternion, Zustandsautomat (Pad $\to$ Boost $\to$ Coast $\to$ Apogäum $\to$ Bergung $\to$ Landung), Pyro-Logik mit Arming, Telemetrie, Watchdog und Zustandsspeicher. Die CI prüft die Pinbelegung gegen \texttt{circuit.py}.

% ============================================================
\section{Fertigung und Bestellung}
\begin{tabularx}{\textwidth}{L{40mm} X}
\toprule
\textbf{Parameter} & \textbf{Wert}\\
\midrule
Fertiger & JLCPCB, Economic-PCBA (Aisler als Rückfall in der EU, \texttt{Fertiger\_2026-10-21.md})\\
Platine & \qtyproduct{54 x 120}{mm}, 4 Lagen JLC04161H-7628, \SI{1.6}{mm} FR-4 TG135, LeadFree HASL, \SI{1}{oz} außen / \SI{0.5}{oz} innen, Lötstopp grün (bestellt 26.\,10.; ENIG und blau waren 22 USD teurer)\\
Stückzahl & 5 Platinen, davon 2 bestückt (Oberseite SMD); THT (Stecker, Buchsenleisten, Stiftleiste, Summer) selbst; E22 und WS2812B selbst löten (Bestand bzw. Standard-PCBA-Zwang), ggf. BMP390\\
Fertigungsdaten & \texttt{kicad/fab/}: \texttt{mainboard\_gerber.zip} (Gerber, Excellon PTH+NPTH), \texttt{mainboard\_bom.csv} (\bomLines{} Zeilen), \texttt{mainboard\_cpl.csv} (132 SMD-Teile, oben), \texttt{FAB.md}; Export 26.\,10.\,2026 mit \texttt{./make.sh fab}\\
Bohrungen & 0,3 mm (Vias, auch die 12 Thermovias des DRV8833 mit 0,5 mm Pad), 0,75 / 0,95 / 1,0 (JST, Teensy), 1,9, 3,2 NPTH; Via-Option 0,3 mm (Standard, kein Aufpreis)\\
Auftragsnummer & Platzhalter \texttt{JLCJLCJLCJLC} im Bestückungsdruck unter dem Teensy (\emph{Specify a location})\\
Extended-Teile & LSM6DSV16X (C5267406), BMP390 (C5124834), TPS63070 (C109322), DRV8833 (C50506), MCP73831, LIS3MDL, SHT40, Polyfuses, Polymer-Elkos u.\,a.; 111 BOM-Positionen bekommen ihre LCSC-Nummer am Bestelltag (\texttt{Angebot\_JLCPCB\_2026-10-23.md})\\
Lieferrisiken & BMP390 zeitweise ohne Bestand (Rückfall BMP388 C779278, pinkompatibel); E22 geringer Bestand (Handlötung); INA239 nicht bei LCSC (DigiKey, Handlötung VSSOP-10); WS2812B-2020 C965555 ausverkauft (Zweithersteller oder Handlötung)\\
Kosten Platinenlauf & ca. 165 USD für 2 bestückte Platinen plus Versand und Einfuhrumsatzsteuer (Testangebot 23.\,10. mit rev-B-Dateien); Fixkosten ca. 100 USD unabhängig von der Stückzahl\\
Lieferzeit & 2--3 Wochen ab Upload\\
Prüfungen vor dem Upload & ERC 0/0; DRC 0 Fehler, 0 offen, Parität 0 (17 Druckwarnungen, kosmetisch); Netzliste gegen Spezifikation §4; Layoutskript (A5--A8); JLCPCB-Grenzen (Abschlussprüfung 26.\,10.); Reviewfragen 1--10 bewertet, kein A-Punkt\\
\bottomrule
\end{tabularx}

\subsection*{Bestellbezeichnung}
\begin{tabularx}{\textwidth}{L{22mm} X L{52mm}}
\toprule
\textbf{Bezeichnung} & \textbf{Beschreibung} & \textbf{Status}\\
\midrule
MS-MB-B-A & rev A, Längs-Schlitten, ein 2S-Akku, ICM-20948, HC-12 & nur Spezifikation (\texttt{rev\_a\_2026-10-15.md})\\
MS-MB-B & rev B, zwei Akkus, ICM-42688-P, INA219, BMP390 an I²C, J\_EXP & KiCad-Stand 21.\,10., nicht gefertigt\\
\pn{} & rev B1: Review A1--A8, E1--E12, Lastschalter, Lader, SPI1-Flugbus mit Decoder, INA239, LSM6DSV16X, J\_STACK, Zusatzsensoren & \textbf{Bestellfassung}, Fertigungsdaten 26.\,10.\,2026\\
MS-MB-B2 & offene Punkte B4, B5, C1, C2 der Review-Bewertung & geplant\\
\bottomrule
\end{tabularx}

% ============================================================
\section{Stückliste}\label{sec:bom}
Erzeugt aus \texttt{kicad/circuit.py} mit \texttt{make\_bom.py}: \bomParts{} Bauteile in \bomLines{} Positionen (12 davon DNP), \bomNets{} Netze, Stand 26.\,10.\,2026. Gleiche Passivteile eines Blocks sind zusammengefasst. LCSC-Nummern am Bestelltag prüfen; „–“ heißt THT, DNP oder noch ohne Nummer; die Zuordnung erfolgt im JLC-Teileprogramm, Vorschläge stehen im Testangebot vom 23.\,10.

\small
\input{bom_generated.tex}
\normalsize

\subsection*{Extern, nicht auf der Platine}
\begin{tabularx}{\textwidth}{L{70mm} L{30mm} X}
\toprule
\textbf{Teil} & \textbf{Anschluss} & \textbf{Bemerkung}\\
\midrule
Teensy 4.1 & 2 × Buchsenleiste 1 × 24 & vorhanden; W25Q128 auf die QSPI-Pads des Teensy\\
1S-LiPo 450--600 mAh, JST-PH, ohne PCM & J\_BAT1 & RC-Zelle, 20--30 C\\
2S-LiPo 450--850 mAh 50 C, XT30 & J\_BAT2 & \\
Schalterbrett an Luke B: Schiebeschalter (DPDT), USB-C mit \SI{5.1}{k\ohm} CC-Widerständen, Lade-LED mit Vorwiderstand, XT30-Ladebuchse mit XH-3 Balancer & J\_SW, J\_CHG1, J\_CHG2 & Platine oder gedruckt (\texttt{cad/})\\
Schlüsselschalter Arming $\ge$ \SI{5}{A} & J\_ARM & führt den Zündstrom\\
2 × FrSky Xact W5652H, Servo 3 (CO\textsubscript{2}-Auslöser), Servo 4 (Beine) & J\_SERVO1--4 & Servokabel auf JST-XH umcrimpen\\
Rollmotor & J\_MOT & nicht in \emph{Kartonaut 1}\\
E-Matches & J\_PYRO1/2 & \\
u-blox MAX-M10S / NEO-M9N & J\_GPS & in der Spitze\\
Pigtail IPEX $\to$ Draht \SI{17}{cm} & ANT & $\lambda/4$ in der Spitze\\
E22-400T22D mit SMA-Antenne & -- & Bodenstation\\
\bottomrule
\end{tabularx}

% ============================================================
\section{Änderungen gegenüber rev B}\label{sec:changes}
Eingearbeitet aus dem Zweitmeinung-Review (\texttt{review\_kicad\_2026-10-21.md}, A1--A8, B-Punkte), der Fragerunde vom 22.\,10. (\texttt{Komponenten\_2026-10-22.md}, E1--E10), den Entscheidungen E11/E12 vom 23.\,10. und der Review-Bewertung vom 26.\,10.

\begin{tabularx}{\textwidth}{L{14mm} X L{34mm}}
\toprule
\textbf{Nr.} & \textbf{Änderung} & \textbf{Abschnitt}\\
\midrule
A1 / A2 & 2 × \SI{470}{\micro F} Hold-up hinter D1 an TEENSY\_VIN, am TPS63070-Ausgang 3 × \SI{22}{\micro F}; EN-Teiler 330 k / 115 k (3,1 V ein, 2,7 V aus) & 1.2, 3.1\\
A3 / E1 & Hauptschalter schaltet die Gates zweier P-FET-Lastschalter (Q6/Q7), J\_SW führt Mikroampere, JP1/JP2 am Tisch & 2.1, 3.1\\
A4 & Polyfuse je Akku direkt hinter dem Verpolschutz (2S 3 A/6 A, 1S 2 A); Zündpuls 50--100 ms mit Abbruch & 1.1, 3.4\\
A5 & Shunt mit Kelvin-Footprint, \SI{10}{\ohm} + \SI{100}{nF} am INA-Eingang & 3.2\\
A6--A8 & 2S-Netze nur auf F.Cu als Flächen, VSYS\_IN $\ge$ \SI{0.6}{mm}, Sperrzone \SI{5}{mm} um die IMU & 4.1\\
E2 & Laden in der Rakete: MCP73831 an J\_CHG1 (USB-C am Schalterbrett), 2S-Ladebuchse J\_CHG2; beides vor dem Lastschalter & 2.1, 3.1\\
E3 & Alle Flugsensoren an SPI1 über 74HC138: BMP390 im SPI-Modus, INA239 (SPI) statt INA219; I²C nur noch Zusatzsensoren, J\_QWIIC, J\_STACK & 2.2--2.5, 3.2\\
E4 / E9 & Alle Servos und der Rollmotor an VSERVO (2S direkt, PWM begrenzt); TPS563201 und 5V\_SERVO entfallen & 1.2, 2.1, 3.1, 3.3\\
E5 & Vier Pyro-Kanäle (3/4 DNP), vierter Servo-Stecker (Pin 10), DRV8833 nSLEEP (Pin 40), zweites BMP390 als DNP (Y2), E22 RESET an Pin 6 & 2.1, 2.3\\
B7 / B8 & Summer auf Pin 37; eine WS2812B-Kette mit einem SN74LV1T34 (Pin 5) & 2.3, 3.6\\
E10 & Stapelstecker J\_STACK (2 × 10) statt J\_EXP: I²C, Serial5, PWM, IRQ, ARM, nRST, 3V3\_EXP (eigener LDO), 5V\_SYS, VSERVO; 74HC4051 für alle langsamen Analogsignale (Pin 24) & 2.1, 2.2, 2.4\\
E11 & J\_STACK Pins 7--9 an SPI0 (Teensy 13/11/12) statt an SPI1; dafür nSLEEP 40, PYRO3 41, PWM\_EXT 33, LORA\_M0 16 & 2.2, 2.3\\
E12 & IMU LSM6DSV16X statt ICM-42688-P (gleicher Footprint, gleiche Rauschklasse, JLC 3,4 statt 21,5 USD) & 1.3, 3.2\\
B3 / B4 & Polymer-Elkos 7343 statt THT; Ferrit + \SI{10}{\micro F} als 3V3\_SENS für IMU und Barometer & 3.1, 3.2, BOM\\
23.\,10. & Magnetometer LIS3MDL und SHT40 bestückt, ADXL375 als DNP-Footprint, alle an I²C & 2.5, 3.2\\
26.\,10. & Review-Bewertung B1--B3: VSYS\_IN 0,6 mm außen / 1,2 mm innen, Stich zu D1 0,6 mm, Korridor zum DRV8833 VM-Pin; Netzlistenexport in \texttt{make.sh} & 4.1\\
\bottomrule
\end{tabularx}

\textbf{Offen für rev B2:} GND\_PWR an DRV8833 BISEN 0,4 mm (B4); VSERVO/GND\_PWR zu Servo 3/4 unter 1,0 mm (B5); ADXL375 Pin 3 RESERVED an GND statt VS/offen, vor Bestückung prüfen (C1); TPS63070 PS/SYNC ohne Vorwiderstand an VIN (C2).

% ============================================================
\section{Änderungsverlauf}
\begin{tabularx}{\textwidth}{L{16mm} L{24mm} X}
\toprule
\textbf{Version} & \textbf{Datum} & \textbf{Änderung}\\
\midrule
0.1 & 22.\,10.\,2026 & Erste Fassung aus Spezifikation rev B, KiCad-Projekt (Stand 21.\,10.) und Komponentenübersicht vom 22.\,10. Stückliste aus \texttt{circuit.py}.\\
0.2 & \docdate & Bestellfassung rev B1: Lastschalter, Lader, SPI1-Flugbus mit CS-Decoder und Analogmux, INA239, LSM6DSV16X, J\_STACK, Zusatzsensoren, vier Pyro-Kanäle; Pinbelegung, Kennwerte und Layoutregeln nach der Abschlussprüfung und Review-Bewertung vom 26.\,10.; Abbildungen und Renders rev B1; Stückliste \bomParts{} Bauteile.\\
\bottomrule
\end{tabularx}

\vspace{10pt}
{\small\color{msgrey}\raggedright Quellen im Repository \texttt{kartonaut}: \texttt{hardware/mainboard/README.md} (Spezifikation rev B1), \texttt{kicad/} (Schaltung als Code, Schaltplan-PDF in \texttt{kicad/out/}, Fertigungsdaten in \texttt{kicad/fab/}), \texttt{review\_kicad\_2026-10-21.md}, \texttt{review\_brief\_2026-10-23.md}, \texttt{Review\_Bewertung\_2026-10-26.md}, \texttt{Abschlusspruefung\_2026-10-26.md}, \texttt{ORDER.md}, \texttt{Komponenten\_2026-10-22.md}, \texttt{docs/DesignGuide\_Mainboard\_revB.md}. Datenblätter: TI TPS63070 (SLVSC58B), INA239, DRV8833; ST LSM6DSV16X und AN5763, LIS3MDL; Bosch BMP390; Sensirion SHT4x; Analog Devices ADXL375; Microchip MCP73831; Ebyte E22-T-Serie; PJRC Teensy 4.1.\par}

\end{document}
