Jan-Philipp-Munsch/kartonaut/PROJECT.md

# Kartonaut – Projektdatei

Die zentrale Übersicht über das Raketenprojekt: was es gibt, wo es liegt, wie weit es ist
und was als Nächstes kommt. **Bei jedem Arbeitsschritt hier den Fortschritt und das
Änderungsprotokoll nachtragen.**

Stand: 2026-10-23 (Zusammenführung der Sessions vom 22.10., Leichtbau, Gewichtshebel, Reglergewinne, Landestudie)

Kartonaut 1 in Modulbauweise (Z1)

## 1. Ziel

Eine Modellrakete mit Schubvektorsteuerung (TVC), aufgebaut nach dem Vorbild von BPS.space
„Scout F“. Sie fliegt mit kardanisch aufgehängtem Motor, Fallschirmbergung und später Landebeinen,
Landebrennen mit einem zweiten Motor und Rollregelung. An Bord sitzt ein selbst programmierter
Flugcomputer (Teensy 4.1) mit Funk-Telemetrie zu einer Bodenstation, die vom Handy bedient wird.

**Erstflug *Kartonaut 1*** (Entscheidungen Jan 21./22.10.2026): geregelter Aufstieg mit einem TSP E12,
Fallschirm über CO₂-Ausstoß, keine Beine, kein Rollmotor, kein Pyro. Ziel ist Stabilisierung und
sichere Bergung, nicht Höhe. Gebaut wird nach der Bauanleitung in Modulbauweise, Stand 2b.

## 2. Eckdaten (Ist-Stand aus Modellen und Code)

| Größe | Wert | Quelle |
|---|---|---|
| Rumpf *Kartonaut 1* | Klima-Rohr Ø 75 mm außen, **72,6 mm innen**, 0,24 g/mm, in drei Modulen: **Rohr A 125 mm** (Kardan, gebaut), **Rohr B 176 mm** (Avionik, gebaut), **Rohr C 195 mm** (Bergung, Reststück); zwei halbe Kuppler 75 mm (72,4/70,2); Klima-Spitze 8539. Gesamtlänge **731 mm**. Alle Radialschrauben M3 auf 0°/90°/180°/270°, Rohr C um 45° versetzt | `cad/modular_params.py`, `docs/Bauanleitung_Kartonaut1.md` §2.4 |
| Rumpf (Konfiguration `voll`, später) | 2 × 500 mm + Kuppler 150 mm, 1000 mm; Landebeine aus Carbonstäben | `cad/params.py`, `docs/BUILD.md` §1 |
| Spitze | Klima-Kunststoffspitze 75 mm (Artikel 8539) mit Holzplatte und Haken 25 mm über der Unterkante; sitzt über dem zweiten halben Kuppler (25 mm in der Spitze verklebt, 50 mm in Rohr C). Der Schirm passt nicht in die Spitze, er liegt in Rohr C | Klima 23.10.2025, Jan 22.10.2026 |
| Motor | **TSP E12-0** (24 mm, 39 Ns, 28 g Treibstoff, 64 g, Brennschluss 3,55 s, ohne Ausstoßladung), 4 Stück vorhanden, im 29→24-mm-Adapter, bündig mit der Unterkante von Rohr A. Die E12-Schubkurve der Simulation ist diese TSP-Kurve | SRT 28.04.2025, thrustcurve.org, `simulation/data/` |
| Masse *Kartonaut 1* | **704 g** im Massenbudget (Stand 2d, 27.10.; vorher 705 g) (Stand 2b mit den Leichtbau-Druckteilen Stand 2c vom 23.10.: ein Motor, zwei Akkus, CO₂-Modul mit Kapsel und Servo, LoRa-Wendel, GPS); Brennschluss 677 g, ohne Motor 641 g. Ziel unter 750 g mit 45 g Reserve erreicht. Weitere Hebel bis 593 g (Befund 21). Vorgänger: `voll` 981 g, `erstflug` 761 g, Stand 2b 723 g. Gewogen ist noch nichts | `cad/mass_stand2b.md`, `docs/Gewicht_und_Landung_2026-10-23.md` |
| Schwerpunkt, Hebelarm | Schwerpunkt **260 mm** über der Düse (Start, Stand 2d). Kardanpunkt der gebauten Druckdatei 69,5 mm → **Hebelarm Kardan–Schwerpunkt 0,190 m**. Firmware rechnet noch mit 0,30 m, `voll` hatte 0,372 m; mit dem echten Wert müssen die Gewinne kleiner werden (Befund 22) | `cad/mass_stand2b.md`, `Config.h` |
| Trägheitsmomente *Kartonaut 1* | Ixx = Iyy = 0,0211 kg·m², Izz = 0,00047 kg·m² (Start), ein Fünftel des Werts, für den die Gewinne gefunden wurden. `voll`: 0,110 / 0,00105 | `cad/mass_stand2b.json` |
| Schub-Gewicht, Flugbild | 12 N / 6,9 N = **1,7** (Spitzenschub 28,3 N: 4,1). Simulation (Firmware-Regler mit wahrer Masse und wahrem Hebelarm, ein Motor, Treibstoff 28 g, Boden, kein Luftwiderstand): Gipfel **74 m** (mit Luftwiderstand etwa 10 % weniger), Brennphase 2,4 bis 2,5° Kipp mit Kp 2 / Ki 1 / Kd 0,45 (Bayes-Optimierung), mit den alten Gewinnen Kp 5 / Kd 1 zwei Drittel der Brennzeit am Anschlag | `simulation/README.md`, `docs/Gewicht_und_Landung_2026-10-23.md` |
| TVC | **Schubstangen-Kardan, gebaut** (Druckdateien `outer/inner_gimbal_dual_TVC.blend` vom 12.06.2025): 2 × FrSky Xact W5652H (10 g, 3,7–8,4 V, Hall-Sensor) flach über dem Außenrahmen, Hebel 15 mm, Stangen 2 mm Stahl; Kardanschrauben 4 × M3 bei 44 mm, Servofenster ca. 20 × 20 ab 60 mm bei 207°/336°. `cad/tvc.py` (Direktantrieb) ist ein nicht gedruckter Entwurf. Servo-Umrechnung (`SERVO_*_GAIN`, 23 oder 6) am gebauten Kardan messen | Jan 22.10.2026 (Fotos, Maße), `cad/modular_params.py`, Befund 13 |
| Bergung | **CO₂-Kapsel 8 g** (ca. 2 l Gas, Aufbau ca. 10 g, Auslösung über ein Servo an `J_SERVO3`) auf dem Spant; Fallschirm 125 cm gepackt 100 × Ø 70 in Rohr C, Schockschnur Kevlar + Gummi im Spitzen-Kuppler, Spitze ohne Abscherstifte (Spant 5 mm hält bis 2,6 bar, falls sie klemmt). Schwarzpulver-Kolben und Pyro-Kanäle bleiben für später | Bauanleitung §1.1, §5.6; 5 × CO₂-Kapsel vorhanden |
| Flugcomputer | Mainboard rev B als Längs-Schlitten 54 × 120 mm auf vier Säulen eines **gedruckten Schlittens mit Spant** in Rohr B (z 167 … 287), keine Gewindestangen, kein Ring-Stack mehr. Luke A1 (SD) und A2 (USB) bei 90°, Luke B (Schalterbrett: Hauptschalter, USB-C-Laden, LED, XT30- und XH-3-Laden) bei 270°, Schraubschalter für ARM daneben | `docs/Bauanleitung_Kartonaut1.md`, `hardware/mainboard/` |
| Akku | **Zwei Akkus:** 2S LemonRC 450 mAh 35C (55 × 30 × 10, 29 g, XT30, Reichelt) für Servos; 1S 600 mAh für Teensy, Sensorik, Funk und GPS über Buck-Boost. Mechanischer Hauptschalter schaltet nur die Gates zweier P-FET-Lastschalter (E1); beide Akkus laden in der Rakete (E2) | `hardware/mainboard/Komponenten_2026-10-22.md` |
| Funk, GPS | LoRa E22-400T22S auf der Platine, Antenne als **433-MHz-Wendel axial unten am Schlitten** (ragt durch die untere Scheibe); GPS-Modul 20 × 20 flach unter dem Spant, Patch nach oben, ca. 12 cm Abstand. Bodenstation mit E22-400T22D. Offen: Sendeleistung und Tastgrad im SRD-Band (Befund 18) | Bauanleitung §1.1, `groundstation/README.md` §6 |
| Schnittstellen rev B | Alle Flugsensoren an SPI1 (ICM-42688-P, BMP390, INA239) mit Chip-Selects aus einem 74HC138, Analogkanäle über 74HC4051, I²C nur `J_QWIIC`; alle Servos und der Rollmotor direkt am 2S, kein 5-V-Buck; vier Pyro-Kanäle (2 bestückt), Stapelstecker `J_STACK`; 40 → 31 belegte Teensy-Pins | `hardware/mainboard/Komponenten_2026-10-22.md` §5, §8, §9 |
| Bodensystem | **Bodenstation:** ESP32-S3-DevKitC, E22-400T22D, 3S-Akku, Relais + MOSFET im Zündpfad, Schlüssel und ARM, WLAN-Zugangspunkt mit Weboberfläche, Zündleitung 15 m, Sparvariante ca. 80 €. **Startrampe:** Siebdruckplatte 600 × 600 mit Loch Ø 130, drei M10-Beine (bis 23° Neigung), drei Führungen 160 mm mit 1,5 mm Luft, Zündkasten mit LEITUNG- und SHUNT-Buchse; 6,5 kg, ca. 86 € | `groundstation/`, `cad/landingpad.py`, `docs/Schnittstellen_Bodensystem_2026-10-22.md` |
| Budget bis zum Erstflug | noch ca. **870 €** offen (Platinenlauf 350, Tischelektronik 190, Bodenstation 80, Rampe 90, Mechanik und Bergung 70, Prüfstand 60, Prüfmittel 30; Versicherung entfällt), mit 15 % Reserve ca. 1000 €; schon ausgegeben grob 350 … 500 € plus Servos | `docs/Budget_2026-10-22.md` |

## 3. Wo liegt was

| Bereich | Ort | Inhalt |
|---|---|---|
| Flug-Firmware | `firmware/` | PlatformIO, Teensy 4.1. `src/` ist modular: main, Config, Sensors, KalmanZ, Control, SDLogger, Timing, Indicators. `lib/mainboard_revb/`: Pinbelegung mit CS-Decoder und Analogmux, SPI-Treiber ICM-42688-P, BMP390, INA239 (22.10.2026). `examples/`: Test-Sketches als eigene Umgebungen (Funk-Beacon, I²C-Scan, Pyro-MOSFET, `revb_bringup`). `tools/check_board_pins.py` prüft die Pins gegen `circuit.py`. Die alten Monolithe (`sketches/`) sind seit dem 20.10.2026 nur noch in der Git-Historie (bis `3b152c9`). Doku: `firmware/README.md` |
| CI | `.github/workflows/ci.yml` | bei jedem Push: alle PlatformIO-Umgebungen bauen, Simulationstests, Pin-Abgleich rev B |
| **Bodenstation (neu)** | `groundstation/` | Konzept, Sicherheitskonzept, Ablauf am Startplatz, Stückliste in zwei Varianten (`README.md`), Schaltung mit Zündkreis und Pinbelegung (`Schaltung.md`), PlatformIO-Firmware für ESP32-S3 (`firmware/`: Zustandsautomat `Launch`, Zündkreis `Igniter`, E22 `Radio`, Platzhalter-Protokoll `Protocol`, Webserver und WebSocket `Web`, Oberfläche `index.html`) |
| Bodenstation (alt) | `kartonaut-ground/` | Eigenes Repo (`git.rwth-aachen.de:jan_philipp.munsch/space`), hier per `.gitignore` ausgeklammert. Arduino Nano mit HC-12-Empfänger, MPU6050-Test, Fan-ESC-Test. Wird von `groundstation/` abgelöst |
| Mainboard | `hardware/mainboard/` | Spezifikation rev B (`README.md`, Stand 21.10.), **Entscheidungen E1–E10 und Bauteile nach Schiene/Schnittstelle** (`Komponenten_2026-10-22.md`), Bestellplan (`ORDER.md`), Umriss-DXF, Platzierungsplan, Abbildungen (`figures.py` → `img/`). Design Guide: `docs/DesignGuide_Mainboard_revB.md` (+ PDF). **Datenblatt** `hardware/mainboard/datasheet/MS-MB-B.pdf` (LaTeX, `build.py`, Stückliste aus `kicad/circuit.py`). KiCad aus Code: `kicad/` (`circuit.py`, Generatoren, Prüfskripte, Renders). Reviews: `review_netlist_2026-10-21.md`, `review_kicad_2026-10-21.md`; Fertiger: `Fertiger_2026-10-21.md`. Rev A: `rev_a_2026-10-15.md` |
| **Bauanleitung *Kartonaut 1* (Modulbauweise, Stand 2b)** | `docs/Bauanleitung_Kartonaut1.md` (+ PDF, Zeichnungen und Bohrschablonen in `docs/bauanleitung/`) | Entscheidungen und Prüfbefunde, Module M1–M4 mit Trennstellen, Winkel, Stapel (z-Tabelle), Masse, Teileliste mit Bestell- und Druckstatus (Reichelt, Berrybase, Ebyte, Schrauben), Druckeinstellungen, Bauschritte, Wartung, Flugvorbereitung, Kabelplan, offene Punkte O1–O8. Zeichnungen Z1–Z6 und Schablonen S1–S4 aus `docs/bauanleitung/zeichnungen.py`; Druckteile, Kollisionsprüfung, Gesamtmodell (STEP/GLB mit dem gedruckten Kardan als Netz) aus `cad/modular.py`, Maße in `cad/modular_params.py` |
| **Massenbudget Stand 2b** | `cad/mass_stand2b.py` → `mass_stand2b.md/.json` | Stabmodell der Modulbauweise: Masse, Schwerpunkt, Hebelarm, Trägheit je Flugzustand, Teileliste, Vergleich mit `voll`, `erstflug` und `modular.py`; JSON liest die Simulation (`--vehicle stand2b`) |
| **Startrampe (neu)** | `cad/landingpad.py`, Abschnitt in `cad/README.md` | Rampe in Raketenkoordinaten, Prüfung gegen die Rakete (Kardan ±7°, Abheben 200 mm, Strahlkegel, Kippsicherheit), `export/landingpad.step`, drei Renders `docs/img/cad/landingpad*.png`, Stückliste |
| **Schnittstellen Bodensystem** | `docs/Schnittstellen_Bodensystem_2026-10-22.md` | S1 Rakete→Pad (mechanisch), S2 Station↔Pad (Zündleitung), S3 Station↔Rakete (Funk, Rahmen, Startsperre), S4 Handy↔Station (WLAN, WebSocket); wer was baut |
| **Budget** | `docs/Budget_2026-10-22.md` | offene Ausgaben bis zum Erstflug nach Blöcken, Inventar, Zeitplan, Sparhebel, Unsicherheiten (Versicherung, Recht, Funk) |
| Baudokumentation | `docs/BUILD.md` | Inventar (Bestellungen, Elektronik, Drucke), Mechanik, Verdrahtung as-built, Software-Stand, Tests, Bautagebuch, Regeln. Angelegt 21.10.2026, viele `[?]` |
| Planung | `docs/Plan_2026-10-21.md`, `docs/Plan_2026-10-22.md` | 21.10.: Platinen-Review, Portierung der Simulation, Baudokumentation. 22.10.: Arbeitsstränge A–E und Meilensteine M1–M7 bis zum Erstflug |
| Recherche | `docs/Rohrmaterial_2026-10-22.md` | Verbundrohre 75 mm gegen Klima-Pappe: Pappe bleibt |
| Marke | `docs/brand/` | Missionsabzeichen und Logo (SVG), aus `hardware/mainboard/kicad/logo.py` |
| Elektronik-Notizen | `eLab/` (lokal, per `.gitignore` ausgeklammert) | OneNote-Abschnitt (HC-12-Modul, 14.10.2025) |
| Simulation | `simulation/` | Python-Paket `tvcsim`: 1:1-Port des Simulink-6DOF (Dynamik, Schub, Rauschen, Regler, Servo-PT2, Boden), zweiter Regler wie `Control.cpp`, Fahrzeugsätze `nominal`, `preload`, `cad` (981 g), `stand2b` (723 g), Monte-Carlo, PID-Raster, Servo-Fit, 25 Tests. Doku: `simulation/README.md`. Das MATLAB-Original `6DOF_model` bleibt lokal |
| Simulation (Vorlage) | lokal, MATLAB-Projekt `BPS_TVC` (nicht im Repo) | MathWorks-Beispiel „simpleTVCRocketModel“ |
| CAD (eigen) | `cad/` | Parametrisches CadQuery-Modell (`params.py` mit Konfigurationen `voll`/`erstflug`, Module Rumpf/Kardan/Flugcomputer/Kolben/Beine, `build.py` mit Export, Kollisionsprüfung, Renderbildern), Massenmodell `mass_model.py`, Prüfstand `testrig.py`, Startrampe `landingpad.py`, Modulbauweise `modular.py`/`modular_params.py` mit Massenbudget `mass_stand2b.py`, Inventur der Blender-Dateien `blender_inventory.md`. Doku: `cad/README.md` |
| CAD (Blender, abgelöst) | lokal (nicht im Repo); der gedruckte Kardan als STL in `cad/export/asbuilt/` | `model_rocket`, `flight_computer`, `TVC`, `TVC_V2`, `Inner_gimbal(_V2)`, `dual_tvc`, `inner/outer_gimbal_dual_TVC` (gedruckt, 12.06.2025), `LegConnectors`, `rocket nose`, `flywheel(V2)` |
| CAD/Doku (fremd) | lokal, Ordner „Space Mission“ (nicht im Repo) | BPS.space Scout F STEP/OBJ, BPS-Blip-Platine, Piston-Ejection-Bulkheads, `Gewicht.csv`, `Übersicht.ods` |

Die Blender-Dateien sind in Millimetern modelliert, obwohl die Szene auf „Meter“ steht.
`docs/render_blend.py` rendert eine Ansicht aus einer .blend-Datei.

## 4. Fortschritt

Status: ✅ fertig · 🟡 in Arbeit · ⬜ offen

| # | Arbeitspaket | Status | Stand / Nachweis |
|---|---|---|---|
| 1 | Konzept, Massen- und Strombudget | ✅ | `Gewicht.csv` (Juni 2025), `Übersicht.ods` (März 2025); Strombudget je Akku in `hardware/mainboard/README.md`; Massenbudget Stand 2b (Befund 16) |
| 2 | 6DOF-Simulation und PID-Auslegung | 🟡 | MATLAB (Mai/Juni 2025) nach Python portiert (21.10.2026, `simulation/`). Physik-Durchsicht 23.10.2026 (`docs/Physik_Review_2026-10-23.md`): Luftwiderstand als Option (`cd_a`), Landemodus für den zweiten Motor, Bodenkontakt; Befunde P1–P8. Ergebnis: Firmware-Gewinne stabilisieren, Tuner-Gewinne schwingen (Befund 11). Offen: `tf5` aus MATLAB exportieren, W5652H vermessen (**Experiment E01 vorbereitet, 22.10.2026**: `docs/experiments/E01_servo_ident.md`, Sketch `servo_ident`, Auswertung `ident_servo.py`), Trägheitsmomente aus `cad/`. Mit `stand2b` (723 g, Zusammenführung 22.10.): 63 m Gipfel, Brennphase ≤ 1,9° Kipp; Stand 2c (705 g): Gewinne Kp 2 / Ki 1 / Kd 0,45 per Bayes-Optimierung (Befunde 16, 22). |
| 3 | TVC-Kardan | ✅ gebaut | **Schubstangen-Kardan mit zwei W5652H in Rohr A 125 mm gebaut und eingepasst** (Jan, 22.10.2026; Druckdateien vom 12.06.2025, STL in `cad/export/asbuilt/`, Lage im Gesamtmodell nach den Schrauben bei 44 mm). `cad/tvc.py` beschreibt einen anderen, nicht gedruckten Direktantrieb (Bauanleitung O4). Offen: Servo-Umrechnung messen (Befund 13), Spiel am Gestänge prüfen, Servoarme in den Fenstern |
| 4 | Rumpf und Spitze | 🟡 | **Modulbauweise Stand 2b** (`cad/modular.py`, Bauanleitung): Rohr A 125 (gebaut), Rohr B 176 (gebaut, vier alte Löcher werden Druckausgleich), Rohr C 195 (Reststück ablängen), zwei halbe Kuppler (Kuppler J1 in B verkleben, Spitzen-Kuppler in der Spitze), Luken A1/A2/B und Schraubschalter-Loch in Rohr B, Schrauben T1–T3. 1:1-Bohrschablonen S1–S4. Das Erstflug-CAD vom 22.10. nachmittags (`config="erstflug"`, 500 + 200 mm, Luken im Kuppler, 761 g) ist durch Stand 2b überholt, bleibt aber als Variante in `params.py`. Landebeine (Carbonstäbe gekauft) erst für `voll` |
| 5 | Bergung | 🟡 | **Entschieden 22.10. abends: CO₂-Ausstoß** (Kapsel 8 g quer auf dem Spant, Auslösung über Servo an `J_SERVO3`), Schirm 100 × Ø 70 in Rohr C unter der Spitze, Schnur im Spitzen-Kuppler, Ringschraube M4 im Spant, Spant 5 mm gegen den Gasdruck, keine Abscherstifte bis zum Test. Offen: CO₂-Modul konstruieren (Anstecher, Kapselgröße, O6), Bodentest dreimal, auch kalt. Pyro-Tests mit ca. 1 g Schwarzpulver bleiben als Erfahrung für später |
| 6 | Flugcomputer-Mechanik | 🟡 | **Stand 2d (27.10.):** GPS-Halter für den vorhandenen NEO-6M (Querleisten mit Auflagekante), Fenster in beiden Zapfen und neben den Akkus, Kabeldurchführung verlegt; Schlitten 64 → 58 g, Start bleibt 705 g (GPS +6 g), Kollisionsprüfung frei. **Stand 2c (23.10.): Leichtbau umgesetzt**, Druckteile 96 → 80 g (Slicer-Modell), STL neu, Kollisionsprüfung frei: Spantplatte 3,5 mm mit 5-mm-Rand, Zapfen 2 mm, U-Profil statt Klotz, Bodenfenster, Scheibe 2 mm, Schraubring 2 mm. Vorher: **Schlitten mit Spant** (ein Druckteil 74 g: Band Ø 75 × 5 zwischen B und C, Zapfen nach unten und oben mit je vier Augen, Träger mit vier Säulen für die Platine, Fächer für 2S und 1S, GPS-Leisten, Kabeldurchführung, Ringschraube), untere Scheibe mit Steckerfenster und Kabelloch, Schalterbrett hinter Luke B, Schraubring J1. Muttern in Sechskant-Taschen statt Einschmelzmuttern. STL in `cad/export/modular/`, Kollisionsprüfung frei. Der Ring-Stack mit M2-Stangen und die Luken im Kuppler (Erstflug-CAD) sind verworfen. [Leichtbau erledigt 23.10., siehe oben] |
| 7 | Sensorik: IMU (DMP), Barometer, INA219 | ✅ | `Sensors.cpp` (Okt. 2025, Breakouts). Für rev B: SPI-Treiber ICM-42688-P, BMP390, INA239 in `lib/mainboard_revb/` (22.10.2026, nicht am Gerät getestet) |
| 8 | Höhenschätzung (Kalman z/vz) | ✅ | `KalmanZ.cpp` |
| 9 | SD-Logger (Binär → CSV) | ✅ | `SDLogger.cpp` |
| 10 | Regler Pitch/Yaw und Roll | 🟡 | Commit „Controls under control“ (21.10.2025). Seit 22.10.2026 nachts: Reglergleichungen in `ControlLaw.*` ohne Hardware, Software-in-the-Loop gegen `tvcsim` identisch (Branch `firmware/flight-core`); Regelfehler aus der Gyro-Quaternion statt `rot_deg += ω·dt` (Befund 3 erledigt); Servos als 16-Bit-PWM mit `SERVO_FRAME_HZ`. In `Config.h` sind beide aus. Prüfstand (E02) und Flugtest stehen aus. **Rollregler entfällt für *Kartonaut 1*** (kein Rollmotor); Masse, Hebelarm und Gewinne nach dem Wiegen aus `cad/mass_stand2b.md` in `Config.h` (Befund 22). |
| 11 | Funkstrecke HC-12 | 🟡 | Beacon-Test Teensy → Nano (Okt. 2025). **Telemetrieprotokoll definiert (22.10.2026 nachts, `firmware/src/Telemetry.h`):** Rahmen A5 5A mit CRC-16/CCITT, TLM 16 Byte bei 10 Hz, EVT bei jedem Zustandsübergang, ACK, Kommandos PING/CALIBRATE/PAD_READY/ABORT/SAFE. Die Bodenstation übernimmt die Datei; Funktest offen. Rev B: LoRa E22-400T22S, Antenne als Wendel unten am Schlitten. Die Bodenstation (`groundstation/firmware/src/Protocol.h`) hat noch den Platzhalter S3 und übernimmt `Telemetry.h`/`Crc16.h`. |
| 12 | GPS | ⬜ | Platz 20 × 20 × 7 unter dem Spant, `J_GPS` an Serial1. Altes Modul (Typ `[?]`, Bauanleitung §3.6) oder u-blox M10. Für den Erstflug verzichtbar |
| 13 | Flugzustandsautomat (Pad → Boost → Coast → Apogäum → Bergung → Landung) | 🟡 | **Geschrieben und ohne Hardware getestet (22.10.2026 nachts, Branch `firmware/flight-core`):** `FlightState.*` mit SAFE → PAD_READY → BOOST → COAST → APOGEE → DESCENT → LANDED und ABORT, Schwellen in `Config.h`, Ereignisse mit Zeitstempel; Pyro-Logik `Pyro.*` (Zustand, Flugzeit, ARM, Durchgang; auf Breakouts gesperrt); Watchdog 250 ms und Zustandsspeicher in DMAMEM für die Wiederaufnahme nach einem Neustart; Sensoren hinter einer Schnittstelle mit Rückenden für Breakouts (ICM-20948 roh) und rev B; 32 native Tests (`pio test -e native`), darunter die Zustandsfolge auf dem simulierten Flug. Nicht am Gerät gelaufen. Für *Kartonaut 1* löst die Bergung die CO₂-Kapsel über den Servo an `J_SERVO3` aus statt eines Pyro-Kanals; noch nicht im Zustandsautomaten. |
| 14 | **Mainboard rev B** | 🟡 | Rev B spezifiziert 21.10. (zwei Akkus, ICM-42688-P, BMP390, LoRa, W5652H am 2S, 20-mΩ-Shunt). Design Guide, Bestellplan, Datenblatt (17 Seiten). **KiCad aus Code** (`circuit.py`, 134 Bauteile, 89 Netze, 7 Blätter, ERC 0/0; Platine 4 Lagen, alle Teile platziert und geroutet, DRC 0, 3 offene Verbindungen; Renders, Lagenbilder, Bestückungsdruck mit Abzeichen, Lötstopp blau). Zweitmeinung-Review mit acht A-Punkten (Buck-Boost-Ausgangskapazität, 1S-Abschaltung, Hauptschalter im Strompfad, Sicherungen, Kelvin-Shunt, 2S-Netze auf In2, Leiterbreiten). Fertiger JLCPCB Economic, Aisler als Rückfall. **Entscheidungen 22.10. (E1–E10, `Komponenten_2026-10-22.md`):** FET-Lastschalter hinter mechanischem Schalter, Laden in der Rakete (MCP73831 + USB-C, 2S-Ladebuchse mit Balancer), BMP390 und INA239 an SPI1, alle Servos am 2S, vier Pyro-Kanäle, nSLEEP, zweites Barometer DNP, E22-NRST, Rollmotor direkt am 2S ohne Buck, Stapelstecker `J_STACK`, 74HC138-CS-Decoder und 74HC4051-Mux (40 → 31 Pins). **Rev B1 in Arbeit** (Session „Rev B Platine“, Branch `claude/rev-b1`): A1–A8 und E1–E10 in `circuit.py`/`gen_pcb.py`, IMU-Drehung in `BoardRevB.h`, Papierprobe im gedruckten Rohr B, Gerber/BOM/CPL. **Bestellt wird erst nach Jans Freigabe.** Aus der Bauanleitung: Antennenlage (GPS unter dem Spant, LoRa-Wendel unten) in die Spezifikation (O7); Stecker J5/J6/J1 ragen 12 mm über die TVC-Stirnseite (untere Scheibe mit Fenster) |
| 15 | Bodentests | 🟡 | **TVC-Prüfstand** (`cad/testrig.py`, 21.10.; **27.10. auf die gebaute Rakete umgestellt**): eigenständiges Skript um `modular.build_all()`, Antrieb im gebauten Motorrohr (Adapter mit Zapfen Ø 28,4 und Flansch Ø 34, kippt unter den Kardanrahmen durch), Drehpunkt im Schwerpunkt mit Antrieb (908 g, z = 200), Klemmkragen um Rohr B mit Fenstern für Luke B, Schraubschalter und Luke A1, Käfig-Klemmring an Rohr A unter den Kardanschrauben; Prüfungen frei (Kardan ±7°, Rig ±20°), fünf Druckteile als STL in `cad/export/testrig/`. Offen: Gurt-Anschläge, Kabel, Gas-Ausgang in der Firmware, BR2814 und Motorrohr-Bohrung nachmessen, Drehpunkt nach dem Auswiegen. **CO₂-Bodentest** (Bauanleitung §5.6, dreimal, auch kalt). **Funk:** Reichweite mit zwei E22, GPS-Fix bei sendendem LoRa. **Startsperre Ende zu Ende** (Meilenstein M5): Countdown vom Handy, Zündung in ein Lämpchen. Pyro-Test 1 g erledigt (Datum `[?]`) |
| 16 | Erstflug *Kartonaut 1* | ⬜ | Ein Motor, Fallschirm über CO₂, keine Beine, kein Rollmotor. **Landung mit Beinen statt Fallschirm geprüft und für den Erstflug verworfen** (Befund 23). Flugbereitschaft (M6): gewogene Masse, Schwerpunkt, Ausstoßtest, Checkliste (Bauanleitung §6.1). Startplatz, Erlaubnis, Versicherung klären (Befund 19) |
| 17 | **Bodenstation** | 🟡 | Konzept, Sicherheitskonzept (Schlüssel, ARM, Relais, MOSFET, zwei Sicherungen, Durchgangsprüfung, Herzschlag vom Handy, Fehlerfälle), Ablauf am Startplatz, Schaltung (`Schaltung.md`), Stückliste Sparvariante ca. 80 € (Module, Schraubklemmen, ein Abend) und Lochraster-Referenz ca. 130 €, ESP32-S3-Firmware mit Zustandsautomat, Startsperre S3, WebSocket 10 Hz und eingebetteter Oberfläche. Nicht gebaut, nicht geflasht. Offen: Protokoll mit der Flug-Firmware, Luftrate/Tastgrad, Zündkreis mit Lastwiderstand abgleichen, E22-Register prüfen, Test mit zweitem E22 am USB-UART |
| 18 | **Startrampe** | 🟡 | Zweiter Stand 22.10. (`cad/landingpad.py`): Siebdruckplatte 600 × 600 × 18 mit Loch Ø 130 (Strahl in die Erde), Stahlblech 250 × 250, drei M10-Beine einzeln verstellbar (Platte 80 … 274 mm über dem Boden, bis 23° Neigung), drei Startstützen aus Alu-Vierkantrohr (Führung 160 mm, Auflage unter der Rohrunterkante, Schrägstrebe, Fußplatte mit Langlöchern), Libelle. **27.10. auf die gebaute Rakete umgestellt:** Stützen bei 45°/135°/250°, 2 mm Führungsluft, Zündkasten entfällt (Bordzündung); 6,1 kg, ca. 68 €; Prüfungen gegen `modular.build_all()` mit Schraubenköpfen frei (Kardan ±7°, Abheben, Strahlkegel, Kippfaktor 2,1). Der erste Entwurf (Achteck 1250 mit Stahldeck, 34 kg, 230 €) ist verworfen; Landefläche für `voll` später. **Offen:** Steifigkeit der Stützen am Muster, Temperatur der Alu-Auflagen, Servoarme in den Fenstern (O1) |
| 19 | **Bauanleitung *Kartonaut 1*** | 🟡 | Stand 2b vom 22.10. abends (Session läuft weiter): Entscheidungen, neun Prüfbefunde, Module, Winkel, Stapel, Masse, Teileliste mit Status (bestellen: 2 × LemonRC 450, SMA-Pigtail und Antennen, XT30, USB-C-Breakout, 2 × E22-400T22D, M3-Schrauben und Muttern, Ringschraube; drucken: Schlitten mit Spant, untere Scheibe, Schalterbrett, Schraubring, CO₂-Modul), Druckeinstellungen, Bauschritte 5.1–5.6, Wartung, Flugvorbereitung, Kabelplan, offene Punkte O1–O8. PDF, Zeichnungen Z1–Z6, Bohrschablonen S1–S4. Gesamtmodell `Kartonaut1_Stand2b.step/.glb` mit dem gedruckten Kardan, Servos und Gestänge |
| 20 | **Budget** | ✅ | `docs/Budget_2026-10-22.md`: offen ca. 930 € (mit Reserve 1070 €), ausgegeben grob 350 … 500 € plus Servos; Zeitplan der Ausgaben, Sparhebel, Unsicherheiten |
| 21 | **Landung mit zweitem Motor** | 🟡 | **Studie und Code 23.10.2026** (`docs/Physik_Review_2026-10-23.md`): Zündplaner über Aufsetzkosten in Simulation (`tvcsim/landing.py`, Landemodus mit Bodenkontakt und Hüpfern) und Firmware (`LandingBurn.*`, Zustand `LANDING_BURN`, `RECOVERY_MODE`, Rückfall auf den Fallschirm). Befund: mit der E12 auf beiden Seiten landet die Rakete nur bei 0,75 bis 0,80 kg nominal unter 3 m/s; leichter wird härter (0,6 kg: 9 m/s, 0,5 kg: 18 m/s), weil der E12-Gipfel schneller fällt, als die E12 bremsen kann, und der Schwanz der Kurve (11 N, T/W > 1) kein Schweben erlaubt. Schubtoleranz ±10 % dominiert die Streuung. **Mit Schubdrossel (Scout-F-Pads, Jan 23.10.):** Drosselmodell, Landeregler (Zündung mit Reserve, Schubschätzung in der Spitze, zeitbasierte Führung zum Brennschluss) in Simulation (`tvcsim/throttle.py`) und Firmware (`ThrottleLaw.*`, dritter Servokanal); das Bild dreht sich: die leichte Rakete (0,5–0,6 kg) wird landbar (nominal 1,5–2 m/s, Monte-Carlo 2–3 m/s), ab 0,7 kg hilft die Drossel nichts. Kennlinie der Pads: Experiment E05. Nicht am Gerät. |

## 5. Befunde aus den Durchsichten

Das ist beim Einlesen aufgefallen. Was davon erledigt ist, steht beim jeweiligen Punkt in eckigen Klammern.

1. **Masse uneinheitlich:** `Config.h` rechnet mit `MASS_KG = 0.70`, die Simulation mit 0,94 kg, `Gewicht.csv` mit 902 g. Die Masse geht direkt in den TVC-Winkel ein (`asin(M / (l·m·|a|))`). [22.10.2026: maßgeblich ist jetzt das Massenbudget Stand 2b, 723 g, Hebelarm 0,186 m; `Config.h` nach dem Wiegen setzen.]
2. **Reglerparameter weichen von der Simulation ab:** Die Firmware nutzt für Pitch/Yaw Kp = 5, Ki = 0, Kd = 1 auf skalierten Grad. `pid_tuner.m` hat zuletzt Kp = 3,1, Ki = 5, Kd = 0,385 gesucht. [aufgelöst in Befund 11]
3. **Lage rein aus dem Gyro, aber komponentenweise aufsummiert:** Rein inertial ist für den Flug richtig. Die DMP-Quaternion (`Quat9`, mit Magnetometer) ist bewusst verworfen worden, weil sie sprang und den PID verrauschte. Schwach ist nur `rot_deg += omega·dt`: Das gilt nur ohne Rollen und bei kleinen Winkeln. Rollt die Rakete, landet ein Neigungsfehler in der falschen Servoachse. Besser wäre eine eigene Quaternion nur aus dem Gyro, auf der Rampe mit dem Beschleunigungssensor initialisiert. Der Regelfehler kommt dann aus dem Oben-Vektor im Körpersystem, `u = R(q)ᵀ·ẑ`, mit Pitch = atan2(u.x, u.z) und Yaw = atan2(u.y, u.z). [erledigt 20.10.2026: der doppelte Integrationsschritt ist weg. **Quaternion ist seit dem Verzicht auf den Rollmotor (22.10.) Pflicht vor dem Erstflug**; laut Jan (22.10. nachts) schon umgestellt, der Code liegt aber noch in keinem Branch des Repos (`main.cpp` integriert dort weiter `rot_deg`), bitte committen. `a_nav` weiter offen.]
4. **Beschleunigungsbereich ±4 g:** Die E12-Schubkurve hat ihr Maximum bei 28,3 N. Bei 0,72 kg misst der Beschleunigungssensor dann 4,0 g, also an der Grenze des ICM-20948-DMP. [rev B: ICM-42688-P mit ±16 g (E6); am Breakout-Aufbau bleibt die Grenze.]
5. **Gyro-Offsets fest im Code.** [20.10.2026: nach `Config.h` verschoben (`GYRO_BIAS_LSB_*`), Rampenkalibrierung weiter offen.]
6. **SDFrame-Felder** `load_V`, `power_mW` und `ina_overflow` werden nicht befüllt.
7. **Fallschirm-Servo** läuft über `Servo`, die TVC-Servos über `PWMServo`. Zwei Bibliotheken teilen sich die Timer. [Der Fallschirm-Servo löst jetzt die CO₂-Kapsel aus, der Punkt bleibt.]
8. **Verkabelung** mit Breakouts und Dupont-Kabeln ist das größte Ausfallrisiko im Flug (Vibration). Das löst Paket 14.
9. **Gyro-Dekodierung am falschen FIFO-Bit** (20.10.2026). [erledigt 20.10.2026, am Gerät noch nicht gegengeprüft.]
10. **Logger ohne Slack** (20.10.2026). [erledigt 20.10.2026.]
11. **Reglergewinne, aufgelöst (21.10.2026, Simulation):** Firmware (Kp 5, Ki 0, Kd 1 auf Skala −100) entspricht im Simulink-Regler kp 5, ki 0, kd 0,01 und **stabilisiert** die Rakete in der Brennphase. Die Tuner-Gewinne kp 3,1, ki 5, kd 0,385 haben einen 40-mal größeren D-Anteil: sofort ±5°-Sättigung, Grenzzyklus bei 3 bis 4 Hz. Ein kleines Ki würde den statischen Servo-Fehler ausregeln. Warum `pid_tuner.m` 0,385 fand, klärt nur ein Export von `tf5` aus MATLAB.
12. **Schub-Gewichts-Verhältnis (21.10.2026, Simulation):** Mit 1,0 kg hebt der TSP E12 kaum ab (Schub-Gewicht 1,1, mit Boden 20 m Gipfel), mit 0,7 kg sind es 62 m. [22.10.2026: Der Motor bleibt der E12 (E6); die Rakete wurde leichter: Erstflug-CAD 761 g, Stand 2b 723 g (Befund 16). Verbundrohre lohnen nicht (`docs/Rohrmaterial_2026-10-22.md`).]
13. **Servo-Umrechnung (21.10.2026, Simulation):** Mit `SERVO_*_GAIN = 23` und dem Fenster 70 bis 115 Servo-Grad hat die Firmware nur ±0,98° TVC; die Identifikation von 2025 sagt 6 Servo-Grad je TVC-Grad (±3,75°). Am gebauten Schubstangen-Kardan messen (Hebel 15 mm, Stangen 29/30 mm): Servo um 10° stellen, Kardanwinkel messen.
14. **Eigenheiten des Simulink-Modells (21.10.2026):** zwei Nominalsätze, Beschleunigungssensor misst `rdd`, kein Boden, zweite Zündung nach Zeit. [Boden eingebaut 21.10.; `--single-motor` für den Erstflug.]
15. **Massenmodell `voll` (21.10.2026, CAD):** Start 981 g, Hebelarm 0,37 m, Ixx = Iyy = 0,110 kg·m², **Izz = 0,0011 kg·m²**, hundertmal kleiner als der Platzhalter 0,1. Landesystem und Flugcomputer waren Vorgaben ohne Konstruktion.
16. **Massenbudget Stand 2b (22.10.2026 nachts, `cad/mass_stand2b.py`):** Die Modulbauweise wiegt im Stabmodell **723 g** beim Start (Brennschluss 695 g), Schwerpunkt 256 mm, **Hebelarm 0,186 m** (halb so lang wie bei `voll`), Ixx = Iyy = 0,0213 kg·m², Izz = 0,00047 kg·m². Das 750-g-Ziel ist mit 27 g Reserve erreicht; die Schätzung in `modular.py` (689 g) vergaß LoRa-Wendel (5 g), CO₂-Servo (9 g), Schalterbrett-Bauteile (8 g), Ringschraube (4 g), Servohebel (3 g), 1S (+2 g), Holzplatte der Spitze (3 g). Größte Posten: Rohre und Kuppler 136 g, Flugcomputer mit Akkus 109 g, Spitze 100 g, Druckteile 98 g, Kardan 88 g. Simulation (`--vehicle stand2b`, Firmware-Regler, ein Motor, Boden, Rauschen, statischer Fehler 1°/0,6°): **Gipfel 63,7 m**, Monte-Carlo 100 Läufe 63,4 ± 0,4 m, Kipp in der Brennphase max. 1,9° (Gain 23) bzw. 1,9° (Gain 6), seitlich 0,9 m bei Brennschluss, Landung 9,3 s. Der kurze Hebelarm und das kleine Trägheitsmoment machen die Rakete wendiger; der Firmware-Regler bleibt stabil, die Tuner-Gewinne kippen in der Brennphase auf 14°. Nach Brennschluss gibt es keine Stellmöglichkeit, der Kippwinkel bis zur Landung ist deshalb kein Reglermaß. Alles Modellwerte; der Schlitten ist mit 75 % Volumen eher zu schwer angesetzt (mit 3 Wänden und 25 % Füllung etwa 60 g), die Spitze (100 g Shop-Angabe) und die Kapsel (25 g gefüllt) sind zu wiegen.
17. **Rampenführungen gegen Schrauben und Servofenster (22.10.2026):** **Erledigt 27.10.:** `landingpad.py` hat jetzt Stützen bei 45°/135°/250°, 2 mm Führungsluft (Linsenköpfe M3 gehen bei jeder Rolllage durch) und prüft gegen `modular.build_all()` samt Schraubenköpfen, alles frei; der Zündkasten ist mit der Bordzündung entfallen. Vorher: Die Startrampe hatte Stützen bei 60°/180°/300° und wurde gegen das Erstflug-CAD geprüft (Schlüsselschalter +x, Luken ±y). Die Modulbauweise hat alle Schrauben bei 0°/90°/180°/270°, Luken bei 90° und 270° und laut Druckdatei Servofenster bei 207° und 336°; `modular_params.py` schlägt Führungen bei **45°/135°/250°** vor, die Bauanleitung (O1, O8) bittet, die Fensterlage am Rohr nachzusehen. `landingpad.py` muss die Führungen auf diese Winkel setzen und gegen `modular.py` statt gegen `build.py` prüfen; das Schlüsselschalter-Loch entfällt. Ein Problem ist es nur, wenn ein Servoarm über die Rohroberfläche ragt (prüfen, Bauanleitung §3.4).
18. **Funk im 433-MHz-SRD-Band (22.10.2026, Bodenstation):** höchstens 10 mW ERP und 10 % Tastgrad ohne Amateurfunkgenehmigung. Die E22 senden bis 22 dBm; 10 Hz Telemetrie mit 33 Byte je Rahmen überschreitet die 10 % auch bei 9,6 kbit/s Luftrate (S3 sah 2,4 kbit/s vor, das reicht für 10 Hz nicht). Lösungen: Amateurfunk (70 cm, Rufzeichen), weniger Telemetrie (2 Hz am Boden, volle Rate nur im Flug) oder 868 MHz (E22-900T22, zwei neue Module ca. 20 €). Station und Rakete müssen dieselbe Luftrate haben (`groundstation/firmware/src/Config.h`, `E22_AIR_RATE`). [Entscheidung Jan 22.10.2026: Gestartet wird in einer sehr abgelegenen Region, der Tastgrad ist dort praktisch nicht relevant; 10 Hz bei 9,6 kbit/s bleiben. Kein Modulwechsel.]
19. **Versicherung und Recht (22.10.2026, Budget):** Verbandsversicherungen für Modellflug decken Raketenmodelle oft nur bis 20 g Treibsatz; der TSP E12 hat 28 g. Vor dem Abschluss schriftlich klären (AGM, DAeC). Mit dem CO₂-Ausstoß fällt die Schwarzpulver-Frage für *Kartonaut 1* weg; ob Motoren über 20 g eine Erlaubnis oder Aufstiegsgenehmigung brauchen, ist offen. [Entscheidung Jan 22.10.2026: Start in einer sehr abgelegenen Region, keine Versicherung über einen Verband nötig; Block I im Budget entfällt.]
20. **Gestänge-Kardan statt Direktantrieb (22.10.2026, Bauanleitung Befund 4):** Gebaut ist ein Schubstangen-Kardan (Servos flach über dem Außenrahmen, Hebel 15 mm, Draht Ø 2), `cad/tvc.py` zeichnet einen Direktantrieb mit der Welle auf der Drehachse. Für den Bau gilt das gebaute Teil; `tvc.py` nachziehen oder als Entwurf kennzeichnen. Die Servo-Übertragungsfunktion (`ServoParams`, SG90-Fit von 2025) und die Umrechnung sind neu zu messen.

21. **Gewichtshebel über die ganze Rakete (23.10.2026, `cad/mass_stand2b.py`, `docs/Gewicht_und_Landung_2026-10-23.md`):** Ausgangslage mit den Leichtbau-Druckteilen 705 g. Ohne Konzeptänderung (2S 300 mAh −9 g, Motoradapter als Ringe −8 g, Mikroservo −4 g, Spitzen-Kuppler 50 mm −12 g) **672 g (P1)**; mit Federausstoß statt CO₂ (−31 g) und 100-cm-Schirm (−20 g, Sinkrate 4,3 statt 3,4 m/s) **631 g (P2)**; mit gedruckter Spitze (−38 g) **593 g (P3)**, dann aber Hebelarm 157 statt 190 mm. Die Druckteile sparen real nur 16 g, obwohl ihr Volumen um 36 % sinkt: dünne Wände druckt der Slicer voll, dicke waren innen schon hohl. Massen nach einem Slicer-Modell (Oberfläche × 1 mm voll, Rest 25 %) statt 75 % des Volumens.
22. **Reglergewinne für die leichte Rakete (23.10.2026, `scripts/check_stand2b_levers.py`, `scripts/tune_bayes.py`):** Rechnet die Firmware mit der wahren Masse und dem wahren Hebelarm (so wird `Config.h` nach dem Wiegen gesetzt), steht der Kardan mit Kp 5 / Kd 1 bei 705 g zwei Drittel der Brennzeit am Anschlag (67 %, bei 593 g 82 %). Das Quer-Trägheitsmoment ist fünf- bis achtmal kleiner als bei den Fahrzeugen, für die die Gewinne gefunden wurden. Raster und Bayes-Optimierung (Gauß-Prozess, vier Flüge je Punkt mit Servo-Totzeit 30 und 50 ms) finden übereinstimmend **Kp ≈ 2, Kd ≈ 0,45** (Raster: 2 / 0,5) mit 2,3 bis 2,5° Kipp und nie am Anschlag (705 und 672 g); der reine Raster-Satz Kp 2 / Kd 0,5 ohne I-Anteil steht mit 50 ms Servo-Totzeit bei 631 g schon 19 % am Anschlag. Ki ≈ 1 drückt den seitlichen Versatz um ein Drittel, liegt aber am Rand des Suchraums und ist mit Vorsicht zu nehmen (Windup auf der Rampe). Unter 600 g muss Kd auf etwa 0,25. Die Läufe vom 22.10. nachts (unter 2° Kipp, 63 m) waren zu gut: `Config.h` rechnete mit 0,30 m Hebelarm, und das Simulink-Treibstoffmodell setzte 60 statt 28 g an. Alles hängt an der Servo-Umrechnung (6 angenommen) und der Servo-Dynamik (SG90-Fit); nach Experiment E01 neu suchen.
23. **Landung mit Beinen statt Fallschirm (23.10.2026, Landestudie der Cloud-Session `landing-burn` mit unseren Massen nachgerechnet):** Eine Landeversion von Stand 2c wöge bei der Landezündung 762 bis 882 g (Beine 80 bis 200 g, ohne Schirm und CO₂, mit zweitem Motor, leerer Hülse und Doppelhalter). Mit je einem E12 für Aufstieg und Landung setzt sie nominal bei 0,85 bis 0,90 kg mit 0,6 bis 1,5 m/s auf, im Monte-Carlo (Schub ±10 %, Zündverzug 50 bis 200 ms, Masse ±20 g, Höhe ±0,3 m) aber nur in 2 bis 5 % der Läufe unter 2 m/s, im Median mit 7 bis 8 m/s. Leichter macht es härter (0,70 kg: 0 % unter 2 m/s, Median 12 m/s). Dazu fehlen Doppelmotor-Halter (+95 mm am gebauten Kardan) und Beinmechanik, und die Lage im freien Fall ist unbekannt. **Entscheidung offen bei Jan, Empfehlung: Kartonaut 1 am Fallschirm**, Daten für die Landung im Erstflug sammeln (Schubkurve, freier Fall 1 bis 2 s vor dem Schirm, Barometer), Zündverzug am Boden messen, Laser-Höhe für die letzten Meter.

## 6. Nächste Schritte

1. **Platine rev B1** (PR #5, gemergt 24.10.): fertig geroutet, Bestelldateien in `hardware/mainboard/kicad/fab/`, IMU LSM6DSV16X. Jetzt: Review nach der Prüfanleitung, 1:1-Papierausdruck im Rohr B, JLCPCB-Angebot mit den rev-B1-Dateien. **Bestellt wird erst nach Jans Freigabe** (M1).
2. **Bauanleitung umsetzen:** Druckteile Stand 2c drucken (PETG, 3 Wände, 25 %) und wiegen; Gewichtspaket P1 (Befund 21) entscheiden, CO₂-Modul konstruieren (O6), Bestellliste §3.1 abschicken (Reichelt, Berrybase, Ebyte, Schrauben), GPS bestimmt und Halter angepasst (O3, 27.10.), Servofenster am Rohr nachsehen (O1), `tvc.py` auf den gebauten Kardan (O4).
3. **Firmware:** ~~Gyro-Quaternion, Zustandsautomat, Telemetrie, Watchdog, Zustandsspeicher, native Tests, Sensor-Schnittstelle~~ (B1–B8, gemergt 26.10.). Offen: Treiber LSM6DSV16X hinter `Imu.h`, CO₂-Auslösung im Zustandsautomaten, Kalibrierwerte aus `lib/calstore/` an den rev-B-Sensorpfad, `Telemetry.h` in die Bodenstation übernehmen, `Config.h` auf die gewogene Masse und die Gewinne Kp 2 / Ki 1 / Kd 0,45 (Befund 22), Befunde 1–4 aus §5 vor dem ersten Flug mit aktiver Regelung.
4. **Rakete aufbauen und messen:** nach Bauanleitung §5; wiegen, Schwerpunkt auswiegen, Servo-Umrechnung messen (Experiment E01 am alten Kardan als Prüfung der Messkette, dann E02 auf rev B1), Bifilarpendel; `mass_stand2b.py`, `Config.h` und `ServoParams` korrigieren; Simulation mit den gemessenen Werten neu rechnen.
5. **Bodentests:** Tischtest rev B1 mit `revb_test` (`firmware/Tischtest_revB1.md`), CO₂-Ausstoß dreimal (auch kalt), Barometer-Druckausgleich, Funkreichweite und GPS-Fix bei sendendem LoRa, TVC-Prüfstand bauen (`cad/testrig.py`, Druckteile in `cad/export/testrig/`, Drehpunkt 200 mm nach dem Auswiegen setzen; Gas-Ausgang in der Firmware), geschlossener Regelkreis am Prüfstand (M4).
6. **Bodensysteme bauen:** Bodenstation Sparvariante (ca. 80 €, Messplatine löten, Module verdrahten, flashen, Zündkreis mit Lastwiderstand abgleichen), Startrampe (ca. 68 €, CAD seit 27.10. auf der gebauten Rakete, Stützen 45°/135°/250°, kein Zündkasten); Startsperre Ende zu Ende vom Handy bis zum Lämpchen (M5).
7. **Erstflug vorbereiten:** Startplatz ist eine sehr abgelegene Region (Jan, 22.10.; Versicherung und Funk-Tastgrad damit nicht relevant), Checklisten (Bauanleitung §6.1, Bodenstation §4), Flugbereitschaft (M6), *Kartonaut 1* (M7).
8. **Später, nach dem Erstflug:** Landung mit zweitem Motor und Schubdrossel (Paket 21): Drosselmechanik konstruieren (Pads, zwei Servos, ca. 60 g), Experiment E05, dann `THROTTLE_F_MIN` und `LANDING_IGNITER_DELAY_S` eintragen und die Studie wiederholen; TVC-Prüfstand-Teile nach `cad/testrig.py` beschaffen.
9. **Repo:** Umbenennung des Bodenstation-Repos `groundcode` → `kartonaut-ground` auf GitHub/RWTH steht noch aus.

## 7. Änderungsprotokoll

| Datum | Was |
|---|---|
| 2025-03 | Projektstart: PlatformIO-Projekt `spacecode` (heute `firmware/`), erste TVC- und Schwungrad-Modelle, Strombudget |
| 2025-04 bis 06 | MATLAB-6DOF und PID-Tuning, TVC V2 und dual TVC, Landebeine, Gesamtmodell, Massenbudget, Piston Ejection; Kardan `inner/outer_gimbal_dual_TVC` (12.06.2025) gedruckt |
| 2025-10-12 bis 31 | Git-Repo angelegt, Firmware modularisiert, Kalman, SD-Logger, HC-12-Test, Regler. `flight_computer.blend` überarbeitet. |
| 2026-10-15 | `groundcode/` (heute `kartonaut-ground/`) als eigenes Repo ausgeklammert. Projektdatei angelegt. Mainboard rev A spezifiziert (`hardware/mainboard/`), erst rund, dann als Längs-Schlitten neu ausgelegt. Befund 3 korrigiert: Lage nur aus dem Gyro ist richtig. |
| 2026-10-20 | Aufräumrunde für die Veröffentlichung. Repo: `README.md` angelegt, `eLab/` und die maschinenabhängige VS-Code-Datei aus dem Index genommen, PlatformIO-Platzhalter und die auskommentierten Monolithe in `sketches/` gelöscht. Firmware: `Main.ino` → `main.cpp` mit wiederhergestellter Flugschleife, alle Gewinne, Servo-Geometrie, Fenster und Gyro-Offsets in `Config.h`, Regler-Schnittstelle ohne doppelte Integration (`RollOutput`), Slack an den Logger, Gyro-Bit-Fix (Befund 9), CSV-Format-Fix (Befund 10), `lib_deps` auf die genutzten Bibliotheken gekürzt. Test-Sketches als Umgebungen unter `examples/` (`radio_beacon`, `i2c_scanner`, `pyro_mosfet_test`). Alle vier Umgebungen bauen warnungsfrei. Nicht am Gerät getestet. Danach: MIT-Lizenz, englisches `README.md` (deutsch als `README.de.md`), lokale Pfade aus dieser Datei entfernt, Repo auf GitHub öffentlich geschaltet. |
| 2026-10-21 | Planungsrunde: `docs/Plan_2026-10-21.md` (Review Mainboard rev A, Bauteilalternativen ICM-42688-P / BMP390 / LoRa E22-400T22D, Kostenschätzung, Portierungsplan der Simulink-Simulation nach Python, Konzept Baudokumentation, Fragen). `docs/BUILD.md` angelegt mit dem Inventar aus den Bestellungen bei Klima (09.06. und 23.10.2025) und Space Rocket Technology (28.04.2025). Dabei geklärt: Rohr innen 72,6 mm, Motor ist der TSP E12-0 (4 Stück), die E12-Schubkurve der Simulation ist die TSP-Kurve. Jan: Funk wird LoRa, Servos FrSky W5652H bestellt. Danach Plan §2.5 (Versorgung) und §2.6 (Layout-Checkliste). Jan entscheidet Variante B: 1S-Akku für die Elektronik, 2S für Servos, Rollmotor und Pyro. Weitere Entscheidungen: ICM-42688-P, erster Flug mit einem Motor, Pyro-Bergung mit Kolben und Klima-Spitze, Flugcomputer im Kuppler (70,2 mm), CAD-Neuaufbau in eigener Session (`cad/`). Abends: Design Guide `docs/DesignGuide_Mainboard_revB.md` (Markdown und PDF), Bestellplan `hardware/mainboard/ORDER.md`; READMEs auf rev B. Simulation nach Python portiert (`simulation/`, 21 Tests, Befunde 11–14), Blender-Inventur, Massenmodell und parametrisches CAD in `cad/` (Befund 15), README in beiden Sprachen neu gegliedert, Stand auf GitHub und RWTH gepusht. Bestellungen Conrad (Carbonstäbe) und Banggood (Prüfstand-Antrieb) ins Inventar, Prüfstand als `cad/testrig.py` konstruiert. Simulation: Boden eingebaut; Befund 12 korrigiert (20 m statt 9 m). KiCad-Projekt rev B angelegt (Session „Rev B Platine“): Schaltplan aus `circuit.py`, ERC sauber, Platinen-Generator. Tor-1-Prüfung der Netzliste (`review_netlist_2026-10-21.md`). Nachts: Platine komplett platziert und geroutet (DRC 0 Fehler, 3 offene Verbindungen, Renders und Lagenbilder), Fertigervergleich. Zweitmeinung-Review (`review_kicad_2026-10-21.md`, `review_check_layout.py`) mit acht A-Punkten; READMEs, Projektdatei, Design Guide, Bestellplan (§7 Bestellliste nach Händlern) und Fertiger-Entscheidung nachgezogen. |
| 2026-10-22 | **Vormittag, Fragerunde mit Jan.** Entscheidungen E1–E8 (`hardware/mainboard/Komponenten_2026-10-22.md`): Hauptschalter mechanisch an FET-Gates; Laden in der Rakete (MCP73831 mit USB-C, 2S-Ladebuchse mit Balancer, beides vor dem Lastschalter); alle Flugsensoren an SPI1 (BMP390 mit CS, INA239 statt INA219), I²C nur `J_QWIIC`; alle Servos am 2S; Zukunftsfähigkeit (vier Pyro-Kanäle, vierter Servo, nSLEEP, zweites Barometer DNP, E22-NRST); `J_EXP` verkleinert; Motor bleibt E12, Masse muss runter. Recherche Rohrmaterial (`docs/Rohrmaterial_2026-10-22.md`): Verbundrohre 3- bis 4-mal schwerer als Klima-Pappe, Pappe bleibt. Schnittstellen Rakete/Pad/Bodenstation/Handy (`docs/Schnittstellen_Bodensystem_2026-10-22.md`), Sessions Landepad und Bodenstation gestartet. Reihenfolge: erst Platine, Firmware nur design-unabhängig parallel; noch nichts bestellt. **Nachmittag.** E9 (Rollmotor direkt am 2S, kein Buck), E10 (Stapelstecker `J_STACK`), Pin-Bilanz mit 74HC138 und 74HC4051 (40 → 31 Pins). CAD-Session: Erstflug-Konfiguration zuerst 719 g (`284c2dc`), nach unabhängiger Prüfung **761 g** bei 700 mm Rohr (500 + 200 mit Stoßkuppler; `1fcb17e`), zwei Luken im Kuppler, Schlüsselschalter-Kragen; 750-g-Ziel um 11 g verfehlt. Datenblatt `hardware/mainboard/datasheet/MS-MB-B.pdf` (17 Seiten). Name **Kartonaut** (Karton + Astronaut), Flüge hochgezählt (*Kartonaut 1*), „Papputnik“ als Spitzname einer späteren Nutzlast; Missionsabzeichen aus `kicad/logo.py` (`docs/brand/`); Ordner `spacecode/` → `firmware/`, Bodenstation-Repo `groundcode` → `kartonaut-ground` (lokal). Platine: Lötstopp blau, Bestückungsdruck neu (`gen_pcb.py silk`), Druckwarnungen 167 → 14. **Abends.** Firmware für rev B vorbereitet: `firmware/lib/mainboard_revb/` (Pins mit Decoder und Mux, SPI-Treiber ICM-42688-P/BMP390/INA239), `examples/revb_bringup/`, `tools/check_board_pins.py`; baut warnungsfrei, nicht am Gerät getestet. Plan bis zum Erstflug (`docs/Plan_2026-10-22.md`, Stränge A–E, Meilensteine M1–M7). CI auf GitHub Actions. PR #1 (`firmware-revb`) nach `main` gemergt. **Bodenstation** (Session, Branch `claude/bodenstation-498fb1`, Paket 17): Konzept, Sicherheitskonzept, Schaltung mit Zündkreis, Stückliste (Sparvariante 80 €, Lochraster 130 €), ESP32-S3-Firmware mit Weboberfläche; **Budgetplan** `docs/Budget_2026-10-22.md`. **Start- und Landepad** (Session, Branch `claude/landepad-923e99`, Paket 18): erster Entwurf Achteck 1250 mit Stahldeck (34 kg, 230 €), nach Jans Einwand zweiter Stand als **Startrampe** 600 × 600 mit Loch, drei M10-Beinen und drei Stützen (6,5 kg, 86 €), Landefläche später. **Bauanleitung in Modulbauweise** (Session, Branch `claude/bauanleitung`, Paket 19): Prüfung des Erstflug-CAD (Kolben blockiert am Stoßkuppler, Antenne und GPS in der abgesprengten Spitze, Stecker ragen in den Endring, Druckteile zu leicht angesetzt, Kardanschrauben an der Rampenführung), Konzept ohne Gewindestangen (≈ 757 g), Zeichnungen und Bohrschablonen. **Stand 2** nach Jans gebautem Kardan (Schubstangen, W5652H, Rohr A 125, Rohr B 176, halber Kuppler): kein Rollmotor, CO₂-Ausstoß statt Schwarzpulver, Schraubschalter statt Schlüsselschalter, Schirm im neuen Rohr C, GPS unter dem Spant, LoRa-Wendel unten, alle Schrauben auf 0/90/180/270° (≈ 706 g). **Stand 2b:** Muttern in Taschen statt Einschmelzmuttern, 2S LemonRC 450, Spitze über den zweiten halben Kuppler (Rohr C 195 mm, 731 mm, Schätzung ≈ 689 g), konkrete Bestellliste. Gedruckter Kardan (Blender 12.06.2025) als Netz ins Gesamtmodell, Servos und Gestänge schematisch, Servofenster aus der Druckdatei (207°/336°), Rampenführungen 45°/135°/250°. |
| 2026-10-22, nachts (Firmware) | Nachts: **Experimente als vorgefertigte Versuche** (`docs/experiments/`): E01 Servo → Kardan mit Sketch `servo_ident` (Treppe, Sprünge, Wechselsprünge, zwei Chirps; ICM-20948 auf dem Motorrohr, 500-Hz-CSV über USB), Aufnahme `firmware/tools/capture_serial.py`, Auswertung `simulation/scripts/ident_servo.py` (Modul `tvcsim/ident.py`, 7 Tests, auf einer künstlichen Messung geprüft: Kennlinie, Hysterese, Totzeit, Rate, PT2-Fit, Frequenzgang). Dabei gefunden: der Fit von 2025 hat die Totzeit nie bewegt (ganzzahliger Shift), mit gebrochener Totzeit kommt trotzdem 30 ms heraus. Nicht am Gerät gefahren; Reihenfolge SG90 zuerst, dann W5652H bei 5 V und 2S (Jan, 22.10.). **Später nachts: Plan B1–B8 abgearbeitet** (Jan: „hake diese Punkte ab“; Entscheidungen: IMU roh über Register, Watchdog 250 ms, Pyro auf Breakouts gesperrt, Servos später mit 250 Hz): Gyro-Quaternion `Attitude.*`, Zustandsautomat `FlightState.*`, Pyro `Pyro.*`, Telemetrie `Telemetry.h`/`Crc16.h`, Watchdog `Watchdog.*`, Zustandsspeicher `StateMemory.*`/`StateStore.*`, Reglergleichungen `ControlLaw.*` (SIL gegen `tvcsim`), Sensor-Schnittstelle mit zwei Rückenden, Umgebungen `teensy41_revb` und `native` (32 Tests, eigenes Testgerüst ohne Unity), `Config.h` mit Erstflug-Masse und Hebelarm, neue `main.cpp`. CI-Job für die nativen Tests. Branch `firmware/flight-core`. |
| 2026-10-22, nachts | **Zusammenführung** (Branch `claude/konsolidierung`, von `claude/bauanleitung` abgezweigt): Bodenstation und Startrampe gemergt. **Massenbudget Stand 2b** als eigenes Stabmodell (`cad/mass_stand2b.py` → `.md/.json`): **723 g** Start, Schwerpunkt 256 mm, Hebelarm 0,186 m, Ixx 0,0213, Izz 0,00047 kg·m²; ergänzt gegenüber `modular.py` LoRa-Wendel, CO₂-Servo, Schalterbrett-Bauteile, Ringschraube, Servohebel (Befund 16). Simulation: Fahrzeugsatz `stand2b` (`--vehicle stand2b`, Test), Nominal- und Monte-Carlo-Läufe: Gipfel 63 m, Brennphase ≤ 1,9° Kipp, Landung 9,3 s; 25 Tests grün. Befunde 16–20 (Massenbudget, Rampenführungen gegen Modulbauweise, 433-MHz-Tastgrad, Versicherung 20 g, Gestänge-Kardan gegen `tvc.py`), Arbeitspakete 17–20 (Bodenstation, Startrampe, Bauanleitung, Budget). READMEs (de/en) auf *Kartonaut 1* Stand 2b umgeschrieben (Übersicht, Projektstand, Bauanleitung, Massenbudget, Simulation, Hardware mit E1–E10, Bodenstation und Startrampe, Dokumente), `cad/README.md`, `simulation/README.md`, `docs/BUILD.md` (Inventar und Tagebuch 22.10.), `docs/Budget_2026-10-22.md` (Rampe 86 statt 230 €, Name Kartonaut), `groundstation/` (Verweise `spacecode/` → `firmware/`), `hardware/mainboard/README.md` (Hinweis auf E1–E10 und rev B1), `docs/Schnittstellen_Bodensystem_2026-10-22.md` (S1 auf Stand 2b) nachgezogen. |
| 2026-10-23 | **Gewicht und Landung** (Branch `claude/konsolidierung`): neuen Stand der Bauanleitung (Servohebel nach Jans Fotos) gemergt; Cloud-Branches gesichtet (`firmware/flight-core`: Gyro-Quaternion, Zustandsautomat, Telemetrie, Watchdog; `firmware-flightcore`: Gewichtshebel, SIL, Landung mit E12 nicht machbar; `landing-burn`: Physik-Durchsicht, Landebrennen; `experiments/servo-ident`: Experiment E01), nicht gemergt. **Druckteile Stand 2c** im Leichtbau (`cad/modular.py`, `modular_params.py`): 96 → 80 g nach einem Slicer-Modell, STL, Zeichnungen, Schablonen und Renders neu, Kollisionsprüfung frei. **Massenbudget** 723 → 705 g mit Hebeltabelle und Paketen P1–P3 bis 593 g (Befund 21). **Regelung:** `scripts/check_stand2b_levers.py` zeigt, dass die alten Gewinne mit echtem Hebelarm zwei Drittel der Brennzeit am Anschlag stehen; Bayes-Optimierer `tvcsim/bayesopt.py` (Gauß-Prozess mit Expected Improvement, nur numpy/scipy, Test) und `scripts/tune_bayes.py` finden Kp 2 / Ki 1 / Kd 0,45 (Befund 22). **Landung:** Landestudie mit 0,70 bis 0,90 kg nachgerechnet, 2 bis 5 % weiche Landungen, Empfehlung Fallschirm für den Erstflug (Befund 23). Dokument `docs/Gewicht_und_Landung_2026-10-23.md`; READMEs, Bauanleitung, cad- und simulation-README nachgezogen. |
| 2026-10-23 (Landung) | Jan: Physik prüfen und Landung mit zweitem Motor schreiben/simulieren; Entscheidungen: E12 als Landemotor, Massen deutlich unter 700 g durchrechnen, Simulation und Firmware. Physik-Durchsicht mit acht Befunden (`docs/Physik_Review_2026-10-23.md`): Luftwiderstand fehlte (jetzt `cd_a`), Beschleunigungsmodell, Treibstoffmodell, Zündung nach Zeit, Boden ohne Hüpfer, Servos im freien Fall, Trägheitsplatzhalter, konstante Masse. Landebrennen: Zündplaner über Aufsetzkosten (1D mit Bodenkontakt) in `tvcsim/landing.py` und `firmware/src/LandingBurn.*`, Landemodus in `sim.py`, Studie `scripts/landing_study.py` (Massen 0,5–0,9 kg, Monte-Carlo), Firmware-Zustand `LANDING_BURN` mit `RECOVERY_MODE`, Pyro je Kanal, Rückfall auf den Fallschirm; 6 Simulations- und 6 Firmware-Tests neu (38 native). Ergebnis: leichter landet härter, 0,75–0,80 kg ist mit der E12 die einzige weiche Zone (Paket 17). Branch `landing-burn`. Danach Jans Hinweis auf die geplante Schubdrossel nach Scout F: Drosselmodell und Landeregler in Simulation und Firmware (Zündung mit Reserve, Schubspitze ungedrosselt mit Schubschätzung, zeitbasierte Führung, Schubabbruch beim Aufsetzen), 1D-Monte-Carlo nach Masse und Drosselspanne, 6DOF-Lauf, E05-Anleitung; drei verworfene Reglervarianten dokumentiert. 42 Simulations- und 42 Firmware-Tests grün, beide Teensy-Umgebungen bauen. |
| 2026-10-26 | Zusammenführung in `main` (Jan: „alles mergen und pushen“): PR #2 (E01), #3 (Flug-Firmware B1–B8) und #4 (Physik-Durchsicht, Landebrennen, Schubdrossel) sowie `claude/konsolidierung` (Bauanleitung, Massenbudget Stand 2b/2c, Bodenstation, Startrampe, Budget) gemergt; Konflikte mit rev B1 (#5) und dem Tischtest (#6) gelöst: `main.cpp` lädt die Kalibrierung und startet Watchdog/Zustandsspeicher, `revb_test` erbt die Teensy-Basis. READMEs auf den gemeinsamen Stand, `CLAUDE.md` mit der Regel zur README-Pflege. |
