Jan-Philipp-Munsch/kartonaut/docs/Plan_2026-10-22.md

# Plan ab 22.10.2026: vom Platinenentwurf zum Erstflug *Kartonaut 1*

Stand 2026-10-22, abends. Grundlage: `PROJECT.md` §4 und §6, Entscheidungen E1–E10
(`hardware/mainboard/Komponenten_2026-10-22.md`), CAD-Ergebnis Erstflug (761 g), Schnittstellen
Bodensystem. Ziel ist der geregelte Aufstieg mit einem TSP E12, Fallschirm über Pyro-Kolben, ohne
Landesystem.

## 1. Was heute neu ist: Firmware für rev B vorbereitet

E7 sagte „Treiber warten auf die fertige Platine“. Das gilt für die **Pinbelegung**, nicht für die
**Bausteine**: ICM-42688-P, BMP390 und INA239 stehen fest, ihre Registerkarten ändern sich nicht mit
dem Layout. Deshalb liegt jetzt in `firmware/lib/mainboard_revb/`:

| Datei | Inhalt |
|---|---|
| `BoardRevB.h` | Pins, CS-Decoder-Slots und Mux-Kanäle nach dem Stand der Platinen-Session (74HC138 + 74HC4051) |
| `BusRevB.*` | SPI1 auf 26/27/**39** (ab Werk wäre MISO1 Pin 1 = GPS), CS über den Decoder, Analogmessung über die Mux |
| `ICM42688.*` | ±2000 °/s, ±16 g, 1 kHz, INT1 „Daten bereit“, ohne DMP |
| `BMP390.*` | SPI mit Füllbyte, Kalibrierung, Kompensation nach Bosch, BMP388 wird erkannt |
| `INA239.*` | SPI Modus 1, SHUNT_CAL für 20 mΩ, Bus/Shunt/Strom/Leistung/Temperatur |

Dazu `examples/revb_bringup/` (Umgebung `revb_bringup`): das erste Programm für die bestückte Platine,
prüft Mux, IMU, Barometer, INA239, LoRa-Parameter und GPS und meldet je Baustein OK/FEHL.
`firmware/tools/check_board_pins.py` vergleicht `BoardRevB.h` mit `circuit.py`; solange die Platine
sich ändert, vor jedem Commit laufen lassen.

Zwei Regeln aus der Decoder-Lösung gelten ab jetzt für die ganze Firmware (stehen in `BusRevB.h`):
kein SPI-Zugriff aus einer ISR, und Analogmessungen nie zwischen `select()` und `deselect()`.

Nicht am Gerät getestet; es gibt die Platine noch nicht.

## 2. Arbeitsstränge

Der kritische Pfad ist die Platine: Bestellung, 2–3 Wochen Fertigung und Versand, Inbetriebnahme.
Alles andere läuft daneben.

### A. Platine (Session „Rev B Platine“, Worktree `rev-b1`)

1. A1–A8 und E1–E10 fertig einarbeiten, `make.sh`, letzte Verbindungen, DRC 0.
2. Lage der IMU auf der Platine festhalten (Drehung Chip → Körperachsen) und in `BoardRevB.h`
   eintragen; `check_board_pins.py` grün.
3. 1:1-Papierausdruck, Probe im gedruckten Kuppler (Luken, Stecker, Schlüsselschalter).
4. Gerber, BOM, CPL; Bestellung JLCPCB Economic, dazu INA239 (DigiKey), Buchsenleisten, Stecker.
   **Bestellen erst nach Jans Freigabe** (Jan, 22.10.).

### B. Firmware, jetzt möglich

Reihenfolge nach Nutzen für den Erstflug:

1. **Gyro-Quaternion und Oben-Vektor** (Befund 3): `q̇ = ½ q ⊗ ω`, auf dem Pad aus dem
   Beschleunigungssensor initialisiert; Regelfehler aus `u = R(q)ᵀ ẑ`. Ersetzt `rot_deg += ω·dt`.
2. **Flugzustandsautomat**: `SAFE → PAD_READY → BOOST → COAST → APOGEE → DESCENT → LANDED`, dazu
   `ABORT`. Start erkannt bei > 2 g für 50 ms, Brennschluss über die Beschleunigung, Apogäum über
   Kalman-vz < 0 **und** Barometer, Rückfall über die Zeit (Brennschluss + x s). Jeder Übergang mit
   Zeitstempel ins Log und in die Telemetrie.
3. **Pyro-Logik**: zünden nur im Zustand APOGEE/DESCENT, nur bei ARM-Spannung und Durchgang, Puls
   50–100 ms, abschalten beim Verlust des Durchgangs (A4). Zwei unabhängige Bedingungen pro Zündung.
4. **Telemetrieprotokoll** (S3 in `docs/Schnittstellen_Bodensystem_2026-10-22.md`): Rahmen `A5 5A`,
   Typ, Länge, Nutzlast, CRC-16/CCITT, 10 Hz bei 2,4 kbit/s Luftrate (≈ 25 Byte je Rahmen möglich).
   Als eigene Header-Datei, die die Bodenstation übernimmt; mit der Bodenstation-Session abstimmen.
5. **Watchdog und Zustandsspeicher**: Teensy-WDT, Flugzustand und Lage im `DMAMEM`/noinit-RAM, damit
   ein Neustart im Flug nicht wieder in `SAFE` beginnt.
6. **Tests ohne Hardware**: Umgebung `native` mit Unity für Quaternion, Zustandsautomat (Flugdaten aus
   `tvcsim` als Eingabe) und CRC. Danach Software-in-the-loop: der Regler aus `Control.cpp` gegen die
   Python-Simulation.
7. **Sensoren hinter eine Schnittstelle**: `Sensors.*` bekommt zwei Rückenden (Breakouts heute,
   rev B morgen), umgeschaltet über eine Build-Variable. Dann läuft die Flug-Firmware am Tag der
   Platine ohne Umbau.
8. `Config.h` auf den Erstflug: Masse 0,761 kg, Hebelarm 0,242 m, Ixx/Izz aus `cad/`; Servo-Werte
   nach der Vermessung der W5652H (Befund 13).

### C. Mechanik und Bodentests

1. Kardan für die W5652H drucken, Servo-Sprungantwort messen, `simulation/` neu anpassen (`fit_servo.py`).
2. TVC-Prüfstand bauen (`cad/testrig.py`), Gas-Ausgang in der Firmware (Pin `PWM_EXT` 13 oder ein Servo-Ausgang).
3. Erstflug-Teile drucken, alles wiegen, Schwerpunkt auswiegen; 11 g über dem 750-g-Ziel.
4. Bodentest Ausstoß: Kolben mit Platine und E-Match zünden, Fallschirm kommt frei.
5. Funkreichweite mit zwei E22 messen.

### D. Bodensysteme (eigene Sessions)

Bodenstation (`groundstation/`, ESP32-S3, Handy-Oberfläche) und Landepad (`cad/landingpad.py`)
laufen schon. Gemeinsame Abhängigkeit: das Telemetrieprotokoll aus B4.

### E. Erstflug

Startplatz, Erlaubnis und Versicherung klären (Verein oder Modellfluggelände), Checklisten für Aufbau,
Scharfschalten und Bergung, Flugbereitschaftsprüfung.

## 3. Meilensteine

| # | Meilenstein | Hängt ab von | Nachweis |
|---|---|---|---|
| M1 | Platine bestellt | A1–A4 | Bestellbestätigung, Gerber im Repo |
| M2 | Platine in Betrieb | M1, Lieferung | `revb_bringup` alles OK, Strom im Ruhezustand gemessen |
| M3 | Flug-Firmware in der Simulation | B1–B6 | `pio test -e native` grün, Zustandsfolge am simulierten Flug |
| M4 | Geschlossener Regelkreis am Prüfstand | M2, C1, C2 | Log mit Störung und Ausregelung |
| M5 | Funkstrecke und Startsperre Ende zu Ende | B4, Bodenstation | Countdown vom Handy, Zündung in ein Lämpchen |
| M6 | Flugbereitschaft | M4, M5, C3, C4 | gewogene Masse, Ausstoßtest, Checkliste |
| M7 | *Kartonaut 1* | M6, E | Log, Video |

## 4. Was die nächste Firmware-Runde braucht

Nichts von Jan, außer der Reihenfolge in B. Vorschlag: B1 und B2 zuerst (sie machen den Regler
flugfähig und sind in der Simulation prüfbar), dann B6 als Netz darunter, dann B3–B5.
