Jan-Philipp-Munsch/kartonaut/docs/Plan_2026-10-21.md

# Plan vom 21.10.2026: Platine neu durchdenken, Simulation nach Python, Bau dokumentieren

Dieses Dokument ist die Planungsrunde vor der Arbeit. Es bewertet die Mainboard-Spezifikation
rev A (`hardware/mainboard/README.md`), schlägt Bauteile und eine Kostenschätzung vor, legt die
Portierung der MATLAB-Simulation nach Python fest und entwirft die Baudokumentation. Die
offenen Fragen stehen in §6; erst nach ihrer Beantwortung beginnt die Umsetzung.

Grundlage: `PROJECT.md` (Stand 20.10.2026), die Firmware in `firmware/` (damals `spacecode/`), das Simulink-Modell
`TVC6DOF_sim.slx` mit `TVC6DOF.m` und `pid_tuner.m` (lokal, OneDrive), die Blender-Modelle und
`Gewicht.csv`/`Übersicht.ods` (lokal, D:).

## 1. Wo das Projekt steht

Die Hardware existiert als Breakout-Aufbau: Teensy 4.1, ICM-20948, BMP280, INA219, HC-12,
SD-Karte, zwei SG90 im Kardan, Rollmotor an einer H-Brücke, alles mit Dupont-Kabeln. Die
Firmware läuft am Tisch, geflogen ist noch nichts. Die Reglerparameter der Firmware und der
Simulation passen nicht zusammen (Befund 2 in `PROJECT.md`), die Masse ist dreimal verschieden
notiert (Befund 1), und die Lage wird komponentenweise integriert (Befund 3).

Das Ziel nach dem Vorbild Scout F ist eine geregelte Aufstiegsphase, Fallschirmbergung und
später eine Landung mit zweitem Motor. Das Simulink-Modell enthält diese zweite Zündung schon
(Variable `secondburn = 730`, also 7,3 s nach dem Start). Mein Vorschlag für die Reihenfolge:

1. **Erst der geregelte Aufstieg mit Fallschirm.** Dafür reicht ein Motor, und das ist der
   Meilenstein, an dem sich Regler, Sensorik und Mechanik beweisen müssen.
2. **Die Landung als eigene Stufe danach.** Sie braucht die zweite Zündung, Beine und ein ganz
   anderes Fehlerbudget. In der Simulation bleibt sie drin, in der Hardware zunächst nicht.

Das verändert die Platine nicht, nur die Reihenfolge der Tests.

## 2. Platine: Bewertung von rev A und was ich ändern würde

Die Grundentscheidungen von rev A halte ich für richtig: Teensy 4.1 als gestecktes Modul,
Längs-Schlitten 54 × 120 mm mit IMU auf der Rollachse, zwei getrennte 5-V-Wandler, zwei
Pyro-Kanäle mit externem Arming, Stecker an den Stirnseiten, 4 Lagen bei JLCPCB mit Bestückung.
Ändern würde ich die Sensorwahl und den Funk, und ein paar Kleinigkeiten.

### 2.1 Was bleibt

| Block | Bauteil | Grund |
|---|---|---|
| MCU | Teensy 4.1 auf Buchsenleisten | vorhanden, Firmware fertig, SD-Slot und USB bleiben |
| Buck 5 V (1×, Aktoren) | TPS563201, 2,2 µH | 3 A, ca. 0,10 € bei LCSC, Basic Part, bewährt. Der zweite Buck aus rev A entfällt, siehe §2.5 |
| Buck-Boost 5 V (Elektronik, aus 1S) | TPS63070, 1,5 µH | 2–16 V ein, 2 A, ca. 2 €; neu, §2.5 |
| LDO 3,3 V Funk | AP2112K-3.3 | 600 mA, reicht für LoRa und GPS |
| Strommessung | INA219 + 20 mΩ 2512 (rev A: 0,1 Ω) | Code vorhanden, Kalibrierung auf 20 mΩ ändern. INA226 wäre feiner, bringt hier nichts |
| Rollmotor | DRV8833, beide Brücken parallel | 2× 1,5 A, ca. 0,70 € |
| Pyro | 2× AO3400A low-side, Pull-down, TVS, Durchgangsprüfung | Konzept aus rev A ist sauber |
| Schutz | AO3401A Verpolschutz, Schottky zu VIN | wie rev A |
| Signal | 2× WS2812B-2020 mit 74AHCT1G125, aktiver Summer | wie rev A |
| Flash | W25Q128 unter den Teensy löten | erschütterungsfestes Zweit-Log, LittleFS ist schon in `lib_deps` |

### 2.2 Was ich ändern würde

**IMU: ICM-20948 ersetzen.** Der ICM-20948 ist bei TDK und bei DigiKey als *Not For New Designs*
geführt, der Bestand bei LCSC schwankt zwischen 0 und ein paar hundert Stück, der Preis
zwischen 8 und 21 USD. Für eine Platine, die in einem Jahr nachbestellt werden soll, ist das
ein Risiko. Die Firmware nutzt vom ICM-20948 nur noch Rohdaten aus dem DMP-FIFO; die
DMP-Quaternion ist für die Regelung schon verworfen (Befund 3), und das Magnetometer ist im
Flug ohnehin nutzlos. Der Ersatz ist der **ICM-42688-P** (6 Achsen, SPI bis 24 MHz, ±16 g,
±2000 °/s, rauschärmer als der 20948, LGA-14 2,5 × 3 mm, ca. 10–17 USD). Damit fällt auch
Befund 4 (±4 g reichen nicht für die F35) weg, weil der Bereich frei wählbar ist. Der Preis: die
Treiberschicht in `Sensors.cpp` wird neu geschrieben, ohne DMP, mit eigener
Gyro-Quaternion. Das war ohnehin der nächste Schritt.

Wer das Risiko lieber vermeidet, lässt den 20948 und kauft ein paar Stück auf Vorrat; die
Platine muss dann nicht geändert werden. Beides zugleich auf dem Board (zwei Footprints) ist
nicht sinnvoll, weil nur einer auf der Achse liegen kann.

**Barometer: BMP280 durch BMP390 ersetzen.** Gleiches Gehäuse-Prinzip (LGA-10, 2 × 2 mm),
etwa halbes Rauschen (0,085 Pa statt 0,16 Pa), Adafruit-Bibliothek `BMP3XX` mit derselben
Schnittstelle, ca. 3–4 USD. Der Kalman-Filter bekommt dadurch eine kleinere `KALMAN_MEAS_STD_M`
und reagiert schneller am Apogäum.

**Funk: HC-12 durch ein LoRa-UART-Modul ersetzen (Jan am 21.10.: ja).** Der HC-12 (Si4438,
FSK) ist in der Praxis auf wenige hundert Meter begrenzt. Ein LoRa-Modul mit UART-Schnittstelle
wie das **Ebyte E22-400T22D** (SX1268, 433 MHz, 22 dBm, 3,3 V) hängt an derselben Serial8 und
bekommt in der Firmware nur einen anderen Konfigurationsblock. Zum Preis: Die UART-Variante
mit Stiftleiste kostet beim Hersteller über eBay oder Tindie etwa 8 bis 12 € je Stück, die
SMD-Variante E22-400T22S bei LCSC 3,30 USD. Zwei Module liegen also bei 20 bis 25 €, der
Unterschied zum HC-12 (2 × 4 €) ist für die Reichweite gut angelegt. Die Bodenstation braucht das
gleiche Modul statt des HC-12. 433 MHz bleibt erlaubt, der Antennenanschluss ist SMA statt
Drahtantenne, also ein kurzes Pigtail in die Spitze. Alternative, wenn die Bodenstation nicht
angefasst werden soll: HC-12 behalten und die Stiftleiste so legen, dass beide passen (beide
sind 2,54-mm-Leisten, aber mit anderer Belegung, also zwei Leisten nebeneinander).

**GPS: nicht auf die Platine, sondern als Modul am JST-GH.** Das ist in rev A schon so
vorgesehen und bleibt. Empfehlung für das Modul: **u-blox MAX-M10S** oder **NEO-M9N** als
Breakout (17–30 €), weil sich bei u-blox das Dynamikmodell *airborne <4 g* setzen lässt und
10 Hz möglich sind. Der billige ATGM336H (ca. 5 €) funktioniert, hält aber bei 3 g Beschleunigung
den Fix schlechter. Für den ersten Flug ist GPS ohnehin nur Komfort zum Wiederfinden.

**Servos: erledigt, FrSky Xact W5652H sind bestellt (Jan, 21.10.2026).** 10 g, 19 × 8 × 23 mm,
Hall-Sensor statt Poti, 3,7 bis 8,4 V. Bei 4,2 V 2,4 kg·cm und 0,10 s/60°, bei 8,4 V 4,8 kg·cm
und 0,05 s/60°. Das ist eine andere Klasse als der SG90 und hat zwei Folgen für die Platine:

- Die Servos dürfen **direkt am 2S-LiPo** laufen und sind dort doppelt so schnell wie an 5 V.
  Rev B bekommt deshalb für die Servo-Schiene eine Wahl per Lötbrücke: `5V_SERVO` aus dem Buck
  (wie rev A) oder `VBAT_PROT` direkt. Der Buck bleibt bestückt, weil der Fallschirm-Servo
  und der Rollmotor-Treiber 5 V brauchen können. Die Firmware braucht nach dem Wechsel neue
  `SERVO_PULSE_*`, und die Servo-Systemidentifikation (`tf5`) muss wiederholt werden, weil die
  Simulation sonst mit der Trägheit des SG90 rechnet.
- Der Abtrieb hat 15 Zähne auf 4 mm (SG90: 21 Zähne, 4,8 mm). Die Servohörner und die
  Aufnahme im Kardan (`dual_tvc.blend`) müssen angepasst werden, ebenso die Gehäusemaße
  (19 × 8 mm statt 23 × 12 mm). Das ist eine CAD-Änderung am inneren Rahmen.

**Kleinigkeiten an rev A**

- `J_SW`: statt JST-XH einen zweipoligen Stecker mit Verriegelung (JST-PH mit Rastnase oder
  Molex PicoBlade), damit der Hauptschalter im Flug nicht abrutscht. Gleiches für `J_ARM`.
- Pyro-Klemmen 3,5 mm sind schwer; zweipolige JST-XH mit Zugentlastung sind leichter und
  rütteln weniger. Oder die Klemmen behalten und die Kabel verkleben.
- Der Elko 470 µF stehend (11,8 mm) ist der höchste Punkt im Streifen WANDLER. Zwei
  Polymer-Elkos 220 µF liegend oder ein 330-µF-Tantal-Polymer in 7343 sparen Höhe und
  halten Vibration besser.
- Ein Testpunkt pro Schiene (VBAT, 5V_SERVO, 5V_SYS, 3V3_RF) und einer an SDA/SCL.
- Ein Reset-Taster neben dem Teensy, erreichbar durch die Luke.

### 2.3 Kostenschätzung

Die Preise sind aus Händlerseiten und Erfahrungswerten zusammengetragen, nicht aus einem
Angebot. JLCPCB rechnet in USD, dazu kommen Versand und bei der Einfuhr 19 % Einfuhrumsatzsteuer.
Alle Zahlen sind Schätzungen für eine Kleinserie von 5 Platinen, davon 2 bestückt.

| Posten | Schätzung | Bemerkung |
|---|---|---|
| Platine 4 Lagen, 54 × 120 mm, 5 Stück | 25–40 USD | über 100 mm Kantenlänge, also außerhalb des 2-USD-Angebots |
| Bestückung (Setup, Schablone, Lötstellen) für 2 Platinen | 15–25 USD | Economic PCBA, ca. 250 Lötstellen je Board; Extended Parts kosten 3 USD Ladegebühr je Typ |
| SMD-Bauteile je bestückter Platine (mit ICM-42688-P und BMP390) | 20–35 USD | IMU 10–17, BMP390 3–4, INA219 ca. 1, DRV8833 ca. 0,7, 2× TPS563201 ca. 0,2, Rest Kleinteile |
| Versand und Einfuhrumsatzsteuer | 25–35 EUR | DHL/Euro-Packet, 19 % auf Ware plus Versand |
| **Summe Platinenlauf** | **ca. 100–150 EUR** | für 5 Platinen, 2 davon bestückt |
| Teensy 4.1 | 0 (vorhanden), Ersatz 33–40 EUR | Elecena/Reichelt 2026 |
| 2× LoRa E22-400T22D (Rakete und Boden) | 16–20 EUR | entfällt, wenn der HC-12 bleibt |
| GPS-Modul u-blox M9/M10 | 17–30 EUR | optional für den ersten Flug |
| Servos FrSky Xact W5652H | 0 (bestellt) | ca. 20–25 € je Stück, schon gekauft |
| THT-Teile (XT30, JST, Buchsenleisten, Summer, Elkos, zweipoliger Schalter) | 10–15 EUR | aus Deutschland (Reichelt, Eckstein) |
| 1S-LiPo 450–600 mAh mit JST-PH, Ladegerät-Adapter | 8–12 EUR | neu durch Variante B, §2.5 |
| **Summe Elektronik gesamt** | **ca. 170–280 EUR** | ohne Teensy, ohne Motoren und Akku |

Sources für die Zahlen: [JLCPCB 4-Lagen-Angebot](https://jlcpcb.com/news/discount-on-quality-4-layer-pcbs),
[JLCPCB Bestückungsgebühren](https://lcsc.com/pcba), [LCSC ICM-20948](https://fat.lcsc.com/product-detail/C726001.html),
[LCSC TPS563201](https://www.lcsc.com/product-image/C116592.html), [LCSC DRV8833](https://www.lcsc.com/product-image/C50506.html),
[DigiKey ICM-20948 (Not For New Designs)](https://www.digikey.com/en/products/detail/tdk-invensense/ICM-20948/6623535),
[BMP390 Rauschen](https://learn.adafruit.com/adafruit-bmp388/overview), [TME MAX-M10S](https://www.tme.eu/dk/en/katalog/moduly-gnss-gps_113723/),
[Teensy 4.1 Preise](https://elecena.pl/product/18537146/rss), [HC-12 vs. LoRa](https://forum.arduino.cc/t/modern-replacement-for-the-hc-12/1204225).

### 2.4 Weg zur Platine

1. KiCad 9 installieren (fehlt noch). Projekt `hardware/mainboard/kicad/`.
2. Spezifikation rev A nach den Antworten aus §6 zu **rev B** fortschreiben (IMU, Baro, Funk,
   Kleinigkeiten). Pinbelegung und Stückliste mit LCSC-Nummern.
3. Schaltplan, dann Layout mit `mainboard_outline.dxf`. Maßgeblich ist nicht das Rohr
   (innen 72,6 mm), sondern der **Kuppler, in dem der Flugcomputer sitzt: innen 70,2 mm**.
   Die 69 mm aus rev A waren also richtig, die Platine bleibt 54 mm breit. Vorher die Lage
   der Servoachsen zum Schlitten festlegen (offene Punkte §9 in rev A).
4. Firmware parallel: `Sensors.cpp` für den neuen IMU-Treiber, Gyro-Quaternion,
   Flugzustandsautomat, Pyro-Logik. Das lässt sich am Breakout-Aufbau mit einem
   ICM-42688-P-Breakout (ca. 10 €) vorab testen.
5. Bestellung bei JLCPCB, Inbetriebnahme nach dem Testplan in rev A §8.

### 2.5 Versorgung: eine Batterie oder zwei (Jans Punkt vom 21.10.)

Die Sorge ist berechtigt: Ein Neustart des Teensy im Flug ist das Ende des Flugs. Die Frage
ist, ob zwei Akkus die beste Antwort sind. Erst die Zahlen, dann die beiden Varianten.

**Wo die Spannung einbricht.** Zwischen Akku und Wandler liegen in rev A:

| Glied | Widerstand | Abfall bei 3 A Spitze |
|---|---|---|
| 2S-LiPo 450–850 mAh, 50 C (ca. 25 mΩ je Zelle) | 50 mΩ | 0,15 V |
| XT30 und 2 × 15 cm AWG 22 (53 mΩ/m) | ca. 20 mΩ | 0,06 V |
| Verpolschutz-FET AO3401A | ca. 50 mΩ | 0,15 V |
| Shunt INA219 (rev A: 0,1 Ω) | 100 mΩ | **0,30 V** |
| Leiterbahnen, Stecker | ca. 20 mΩ | 0,06 V |
| **Summe** | ca. 240 mΩ | **ca. 0,7 V** |

Ein leerer 2S-Akku liegt bei 6,0 V unter Last. Minus 0,7 V bleiben 5,3 V am Eingang des
5-V-Bucks. Der TPS563201 schafft 5 V daraus gerade noch, aber ohne Reserve. Ein Pyro-Puls
(E-Match, bis 5 A für 20 ms, Kurzschluss beim Durchbrennen) macht denselben Einbruch noch
einmal, liegt in rev A aber vor dem Shunt und trifft nur Akku, Stecker und FET.

Drei Maßnahmen nehmen den größten Teil weg, ganz ohne zweiten Akku:

1. **Shunt 20 mΩ statt 100 mΩ.** Der INA219 misst bis ±320 mV, mit 20 mΩ also bis 16 A bei
   2 mA Auflösung. Das reicht. Spart 0,24 V.
2. **Buck-Boost statt Buck für die Elektronik.** Ein TPS63070 (2 bis 16 V Eingang, 2 A,
   ca. 2 €) liefert 5 V auch dann, wenn der Eingang auf 4 V einbricht. Damit ist die
   Elektronik-Schiene von Servo- und Pyro-Spitzen entkoppelt, solange der Akku nicht unter
   etwa 3,5 V fällt, was bei 2S nie vorkommt.
3. **Energiespeicher hinter dem Wandler.** 1000 µF Polymer-Elko an 5V_SYS plus die Schottky
   zum Teensy-VIN überbrücken einen 10-ms-Einbruch bei 0,3 A mit 3 V Reserve. Wer mehr will,
   setzt einen 0,5-F-Supercap mit Ladewiderstand hinter die Schottky; das hält den Teensy
   Sekunden.

Dazu die Servo-Schiene getrennt: Die W5652H laufen direkt am Akku (VBAT_PROT), nicht über
einen Wandler, mit 1000 µF Low-ESR und einer eigenen Polyfuse 3 A. Ihre Stromspitzen sehen den
Shunt und den FET, aber nicht den Buck-Boost, der davor sitzt und seinen Eingang bis 4 V
toleriert. Funk und GPS kommen hinter den Buck-Boost auf eine eigene LDO-Schiene mit 100 µF;
ein LoRa-Sendepuls mit 130 mA ist dort unkritisch.

**Variante A: ein 2S-Akku mit den drei Maßnahmen.** Vorteile: ein Akku, ein Ladegerät, ein
Schalter, ein Arming, weniger Masse (ein 1S-Akku mit Stecker wiegt 15 bis 25 g, dazu ein
zweiter Schalter), und die Strommessung sieht alles. Nachteil: Elektronik und Aktoren teilen
sich die Masse und den Akku-Innenwiderstand, der Buck-Boost muss das abfangen.

**Variante B: 1S für die Elektronik, 2S für Servos, Rollmotor, Pyro.** Vorteile: Die
Elektronik sieht keinen Servo- oder Pyro-Einbruch, egal was passiert, und ein leerer
Servo-Akku lässt den Flugcomputer weiterlaufen und loggen. Nachteile: Der 1S-Akku liefert 3,0
bis 4,2 V, der Teensy-VIN braucht aber 3,6 bis 5,5 V und die WS2812B und der Summer 5 V, also
kommt ein Boost (oder derselbe TPS63070) ohnehin dazu. Zwei Akkus heißt zwei Ladezustände, zwei
Stecker, zwei Spannungen im Telemetriestrom, 20 bis 30 g mehr, und die Masse muss zwischen
beiden Systemen trotzdem verbunden sein, sonst haben die Servosignale keinen Bezug.

**Entscheidung (Jan, 21.10.2026): Variante B, fest ausgelegt.** Ein 1S-Akku versorgt die
Elektronik, ein 2S-Akku Servos, Rollmotor und Pyro. Die Schaltung für rev B:

```
1S LiPo (3,0–4,2 V) ─ J_BAT1 (JST-PH 2) ─ Q2 Verpolschutz ─ SW1a ─ VSYS_IN ─ Teiler → ADC (VBAT1_SENSE)
   └─ U2 TPS63070 Buck-Boost (2–16 V ein, 5 V / 2 A) → 5V_SYS, 1000 µF
         ├─ D1 Schottky → Teensy VIN (USB darf gleichzeitig stecken)
         ├─ WS2812B (über 74AHCT1G125), Summer
         └─ U3 AP2112K-3.3 → 3V3_RF (100 µF): LoRa, GPS
   Teensy 3V3 → IMU, Barometer, INA219, I²C-Pull-ups

2S LiPo (6,0–8,4 V) ─ J_BAT2 (XT30) ─ Q1 Verpolschutz ─ SW1b ─ VBAT_PROT ─ Teiler → ADC (VBAT2_SENSE)
   ├─ J_ARM (Arming-Schalter) ─ VBAT_ARMED ─ Pyro 1/2 (+), TVS
   └─ R_SHUNT 20 mΩ (INA219, Kelvin) ─ VBAT_MEAS
         ├─ Polyfuse 3 A → VSERVO = VBAT direkt, 1000 µF Low-ESR: 2× W5652H (TVC)
         └─ U1 TPS563201 Buck → 5V_SERVO (3 A), 470 µF: Fallschirm-Servo, DRV8833 (Rollmotor)

GND beider Akkus auf der Platine an einem Punkt verbunden (Sternpunkt am 2S-Minus).
```

- **Ein Hauptschalter mit zwei Polen** (`SW1a/b`, zweipoliger Schiebeschalter am Rumpf)
  schaltet beide Akkus zugleich; so kann keiner vergessen werden. Der Arming-Schalter bleibt
  getrennt. Auf dem Tisch überbrücken zwei Lötbrücken die Schalter.
- **TPS63070 als Buck-Boost** statt eines reinen Boosts: Er nimmt 2 bis 16 V. Wer versehentlich
  den 2S-Akku an `J_BAT1` steckt, zerstört nichts; die Stecker sind trotzdem verschieden
  (JST-PH gegen XT30).
- **Die W5652H laufen direkt am 2S-Akku** (bis 8,4 V, dort am schnellsten). Sollte der
  Fallschirm-Servo ein SG90 bleiben, hängt er an 5V_SERVO. Der DRV8833 (2,7 bis 10,8 V)
  könnte auch direkt an VBAT, bekommt aber 5V_SERVO, weil der Rollmotor für 5 V ausgelegt ist.
- **Messung:** INA219 misst Strom und Spannung des 2S-Pfads vor Servo-Schiene und Buck, Pyro
  liegt davor. Beide Akkuspannungen gehen zusätzlich über Teiler auf ADC-Pins (rev A: Pin 40
  für VBAT2, neu Pin 41 für VBAT1; ARM_SENSE wandert auf Pin 24). Die Firmware loggt beide und
  warnt per Summer, wenn einer unter seine Grenze fällt (1S: 3,5 V, 2S: 6,6 V).

**Strombudget nach Akkus**

| Akku | Verbraucher | Dauerstrom | Spitze | Vorschlag |
|---|---|---|---|---|
| 1S | Teensy 0,1 A, 2× WS2812B 0,12 A, Summer 0,03 A, LoRa + GPS 0,15 A, zusammen 0,4 A an 5 V, also 2 W | ca. 0,6 A bei 3,7 V | 0,8 A (LoRa-Sendepuls) | 1S 450–600 mAh, 20 C, JST-PH, ca. 10–12 g |
| 2S | 2× W5652H (Blockierstrom je ca. 1 A bei 8,4 V), Fallschirm-Servo 0,65 A, Rollmotor 1 A, Pyro-Puls 3–5 A für 20 ms | ca. 0,5 A | ca. 4 A | 2S 450–850 mAh, 50 C, XT30, 30–55 g |

Die Masse im Budget (`Gewicht.csv`: Flugcomputer 100 g) steigt um den 1S-Akku, seinen Stecker
und den zweiten Verpolschutz um etwa 15 bis 20 g. Dafür entfällt in der Telemetrie die Sorge,
ob eine Servospitze gerade den Logger gestört hat.

Verworfen damit: der zweite Buck `5V_SYS` aus rev A, die Schottky vom 2S-Pfad zum Teensy und
die Lötbrücke für einen gemeinsamen Akku.

Zwei Dinge gehören in die Firmware, egal welche Variante: ein **Watchdog**, der einen hängenden
Teensy in 100 ms neu startet, und ein **Zustandsspeicher** (Flugphase, Startzeit, Nullpunkt
der Höhe) im nichtflüchtigen Speicher, aus dem der Zustandsautomat nach einem Neustart in
der laufenden Phase weitermacht, statt wieder auf der Rampe zu stehen. Dann ist ein Neustart
im Flug ein Aussetzer von 200 ms und nicht das Ende.

### 2.6 Layout-Checkliste für rev B

Punkte, die vor der Bestellung abgehakt werden. Sie kommen als Prüfliste in die
rev-B-Spezifikation.

**Strompfade**

- Leiterbahnbreite nach IPC-2221 für 1 oz Kupfer, 10 K Erwärmung: 1 mm trägt 2,5 A, 2 mm 4 A,
  3 mm 5,5 A. VBAT, Servo-Schiene und Pyro-Pfad 2 mm auf beiden Außenlagen, mit Vias
  verbunden; Pyro-Rückleitung ebenso. 5V_SYS 0,8 mm, 3V3 0,5 mm, Signale 0,2 mm.
- Vias für Hochstrom: mindestens 4 × 0,5 mm je Übergang.
- Masse: Lage 2 durchgehend. Servo- und Pyro-Masse laufen auf Lage 1 als breite Bahn zum
  Akku-Minus und treffen die Massefläche erst dort (Sternpunkt), damit der Servostrom nicht
  unter IMU und Barometer durch die Fläche fließt.
- Shunt mit Kelvin-Anschluss (vier Pads), Messleitungen direkt vom Shunt zum INA219.
- Jede Schiene bekommt einen Testpunkt und eine Polyfuse: Servo 3 A, 5V_SYS 1 A, 3V3_RF 0,5 A.

**Stecker**

- Alle Stecker auf der Bestückungsseite (oben), keiner unter dem Akku. Jeder Stecker mit
  Verriegelung oder Rastnase: XT30 (Akku), JST-PH mit Rastnase oder JST-GH (Schalter, Arming,
  Motor, GPS, Kamera), JST-XH 3-polig mit Gehäuse für die Servos statt offener Stiftleisten,
  damit sich kein Servostecker verdreht oder abrüttelt. Die Servokabel der W5652H bekommen
  dafür ein JST-XH-Gehäuse (Crimpzange nötig) oder die Stiftleiste bleibt und bekommt eine
  gedruckte Steckerführung.
- Pin-1-Markierung und Belegung (S / + / −) im Bestückungsdruck neben jedem Stecker, Plus und
  Minus zusätzlich als Text. Stecker, die gleich aussehen (Servo 1/2/3, Pyro 1/2), haben
  unterschiedliche Lage oder Farbe der Gehäuse.
- Steckrichtung: Servo- und Akkustecker zeigen axial zum TVC-Ende, Pyro, Funk und GPS zur
  Spitze, wie in rev A. Keiner zeigt seitlich auf das Rohr.
- THT-Stecker werden von oben bestückt und unten gelötet; die Lötstifte bleiben unter 2 mm,
  sonst treffen sie den Akku. Für JLC-Bestückung: THT entweder selbst löten oder als
  „THT assembly“ bestellen (teurer).

**IMU**

- Genau auf der Rollachse, möglichst nah am Schwerpunkt (Hebelarm zum Schwerpunkt unter
  50 mm, sonst sieht der Beschleunigungssensor bei Drehraten Zentripetalanteile).
- Steif montiert: Die Platine sitzt mit vier M3 auf dem gedruckten Träger, der Träger
  formschlüssig zwischen den Endringen. Keine Gummipuffer unter der Platine; die Servos und
  der Rollmotor regen bei 50 bis 300 Hz an, das filtert man digital (IMU-Tiefpass auf
  50 Hz, 1 kHz abtasten, auf 100 Hz mitteln), nicht mechanisch mit einer Platine, die dann
  selbst schwingt.
- Freiraum: 5 mm um den Chip keine Spulen, keine Elkos, keine Hochstrombahnen auf allen
  Lagen; auf der Rückseite unter dem Chip eine ruhige Massefläche ohne Vias.
- Thermisch: nicht neben Wandler und Teensy-CPU; Gyro-Bias driftet mit der Temperatur, die
  Rampenkalibrierung fängt den Startwert, nicht die Drift.
- Achsenrichtung als Pfeile im Bestückungsdruck (x quer, y zur Spitze, z aus der Platine).

**Funk und GPS**

- LoRa-Modul am Spitzen-Ende, Antenne per u.FL-Pigtail oder SMA-Winkel in die gedruckte
  Spitze; Antenne (λ/4 bei 433 MHz = 17 cm) frei von Kupfer, Kohlefaser und dem Akku.
- GPS-Patchantenne braucht freie Sicht nach oben und eine Massefläche unter sich: in der
  Spitze, oben auf dem Modul, nicht unter dem Fallschirm, mindestens 10 cm von der
  LoRa-Antenne, sonst stopft der Sendepuls den GPS-Empfänger zu. Modul mit SAW-Filter und LNA
  (u-blox M9/M10).
- Unter beiden Modulen eine Massefläche auf Lage 1, kein Teiler und kein Signal darunter.
- Antennenkabel so verlegen, dass sie beim Fallschirmausstoß nicht abreißen; lieber 5 cm
  länger und mit Schlaufe.

**Barometer**

- Von Schaum abgedeckt (Licht, Fahrtwind), 3 bis 4 Druckausgleichsbohrungen Ø 2 mm im Rohr
  auf seiner Höhe, Avionik-Sektion sonst dicht gegen den Fallschirmraum (Ausstoßdruck).

**Kabel**

- Akku: AWG 20 Silikon, 10 bis 15 cm, XT30. Servos: AWG 22 Silikon oder das Originalkabel,
  verdrillt, 15 bis 25 cm, keine Verlängerung. Pyro: AWG 22, verdrillt, zweipolig gesteckt.
  Signale (GPS, Kamera, I²C): AWG 26–28 Silikon, JST-GH-Konfektion.
- Keine Dupont-Kabel im Flug. Jeder Stecker mit Zugentlastung (Kabelbinder an der Platine
  oder Tropfen Heißkleber), Kabel in gedruckten Clips geführt, nicht lose im Rohr.
- Servokabel laufen gebündelt an einer Seite der Platine entlang, auf der Seite des Bucks,
  nicht auf der IMU-Seite.

**Allgemein**

- 4 Lagen, 1,6 mm, ENIG (planare Pads für LGA), Bestückung nur oben.
- DRC mit JLC-Regeln (0,127 mm Bahn/Abstand, 0,3 mm Via), Prüfung der 3D-Ansicht gegen die
  Hüllen aus `outline.py`.
- Vor der Bestellung: Ausdruck 1:1 auf Papier, Teensy und Stecker drauflegen, in das Rohr
  halten.

## 3. Simulation: von MATLAB/Simulink nach Python

### 3.1 Was im Simulink-Modell steckt

Aus `TVC6DOF_sim.slx` gelesen (die MATLAB-Function-Blöcke stehen im Klartext in der Datei):

| Teil | Inhalt |
|---|---|
| **Dynamics Model** | Starrkörper mit Quaternion. Schubvektor im Körpersystem über zwei Drehungen `th_y`, `th_z` (Grad), Hebelarm `r = [-l, mis_y, mis_z]`, Moment `M = r × T_b`, Euler-Gleichungen mit `Ix, Iy, Iz`, Translation im Inertialsystem mit `g`. Masse `m = m_dry + m_fuel/1000`, `m_fuel` aus einem Signal Builder (nicht lesbar, Annahme §3.3). Prozessrauschen auf `w` (Varianz 0). |
| **Schub** | Lookup auf `time/thrust` (E12), zweiter Motor mit `Delay` um `secondburn = 730` Schritte (7,3 s). F35-Lookups liegen daneben, unbenutzt. Die E12-Kurve ist punktgleich mit der RASP-Datei des **TSP E12** auf thrustcurve.org (39 Ns, 28 g Treibstoff, 64 g gesamt, Brennschluss 3,55 s), also mit dem Motor, der gekauft ist (4× TSP E12-0). Die Estes-E12-Kurve (27 Ns, 2,44 s) ist ein anderer Motor. |
| **Avionics** | Zero-Order-Hold mit `dt = 0,01`. Quaternion mit zufälliger Kleinstdrehung (σ = 0,01 rad) verfälscht, Drehrate mit σ = 0,4 °/s, Beschleunigung mit Zufallszahl. |
| **Estimator** | Durchreichen: `w_est = w_n`, `q_est = q_n`, `T_est = |a| · m_meas`. |
| **Controller** | Regelgröße `rot = ∫ w_est` in Grad, mit `-0,01` skaliert (entspricht `PY_ERROR_SCALE = -100` in `Config.h`). Je Achse PID `kp, ki, kd` (D auf `-w_est`), Integratoren werden bei `secondburn/100` zurückgesetzt. `Moments2Commands`: `T_b = [0, Mz/l, -My/l]`, `th_y = asin(T_b3/T_est)`, `th_z = asin(T_b2 / (-T_est cos th_y))`. |
| **Aktuator** | ZOH, Sättigung ±5°, identifizierte Servo-Übertragungsfunktion `tf5` (aus den Sprungantworten in `system identification*.xls`), Gain 6 (Servo-Grad → TVC-Grad, DC-Gain-Korrektur), statischer Fehler `static_error_y/z` (y als Stufenprofil bei 2, 7, 9 s). |
| **Monte-Carlo** | `TVC6DOF.m`: 100 Läufe, Streuung von `I`, `m_dry`, `l`, Servo-Delay, Fehlausrichtung, statischem Fehler. `pid_tuner.m`: Raster über `kp, ki, kd`, Zielgröße `maxHeight`. |

`tf5` ist ein `idtf`-Objekt (System Identification Toolbox) und ohne MATLAB nicht lesbar.
Die Rohdaten der Sprungantworten liegen aber vor (`system identification.txt`: Zeit in ms,
Servo-Soll in Grad, gemessener Kardanwinkel in Grad). Daraus fitte ich die Übertragungsfunktion
in Python neu (PT2 mit Totzeit) und vergleiche sie mit `servo_delay_n = 0,08 s`.

### 3.2 Zielstruktur im Repo

Vorschlag: ein Python-Paket `simulation/` in diesem Repo (das Raketen-Repo hat noch keinen
Python-Teil; `docs/render_blend.py` und `hardware/mainboard/outline.py` bleiben, wo sie sind).

```
simulation/
  pyproject.toml           numpy, scipy, matplotlib; pip install -e .
  README.md                Modell, Koordinaten, wie man läuft
  data/
    E12_thrustcurve.csv    aus dem MATLAB-Projekt übernommen
    F35_thrustcurve.csv
    servo_step_response.csv   aus system identification.txt
  tvcsim/
    params.py              VehicleParams, ControlParams, NoiseParams (Nominalwerte aus TVC6DOF.m)
    motors.py              Schubkurve laden, interpolieren, zweite Zündung
    dynamics.py            EOM: Port der Simulink-Function, Quaternion-Kinematik
    actuator.py            Servo-PT2 mit Totzeit, Sättigung, statischer Fehler
    sensors.py             Rauschmodelle aus dem Avionics-Block
    controller.py          PID + Moments2Commands (1:1 wie Simulink) und
                           FirmwareController (1:1 wie Control.cpp, mit asin(M/(l·m·|a|)))
    sim.py                 Lauf mit 100-Hz-Regelschleife und scipy-Integrator dazwischen
    montecarlo.py          Port von TVC6DOF.m
    tuning.py              Port von pid_tuner.m, Raster und Zielgröße
    plots.py               Trajektorien, Winkel, Servo-Winkel
  tests/
    test_dynamics.py       Quaternionnorm, Schwebe-Gleichgewicht, Momentenvorzeichen
    test_controller.py     Simulink-Regler und Firmware-Regler liefern bei gleichen Gewinnen dasselbe
  scripts/
    run_nominal.py, run_montecarlo.py, tune_pid.py, fit_servo.py
```

Der Punkt, der über die Simulation hinaus hilft: `FirmwareController` rechnet genau wie
`Control.cpp`. Damit lässt sich Befund 2 (Gewinne der Firmware gegen die Simulation) in der
Simulation klären, bevor etwas fliegt. Später kann derselbe Code die SD-Logs eines Flugs gegen
die Simulation legen.

### 3.3 Annahmen, bis sie bestätigt sind

- Treibstoffmasse: 28 g (TSP E12), abgebrannt proportional zum Impuls der Schubkurve, zweiter
  Motor gleich. Der Signal Builder im Modell ist nicht auslesbar.
- `tf5` wird aus den Sprungantworten neu gefittet; der DC-Gain 1/6 aus dem Simulink-Gain 6
  dient als Kontrolle. Die 23 Servo-Grad je TVC-Grad aus `Config.h` passen nicht zu diesen 6;
  das ist eine Frage an dich (§6).
- Trägheitsmomente 0,1 kg m² auf allen Achsen aus `TVC6DOF.m` sind Platzhalter. [erledigt 21.10.2026:
  Massenmodell in `cad/mass_properties.json`: Ixx = Iyy = 0,110, Izz = 0,0011 kg·m², Hebelarm 0,37 m.]
- Nominalwerte wie in `TVC6DOF.m`: m = 0,94 kg, l = 0,30 m, Servo-Delay 0,08 s, dt = 0,01 s.

### 3.4 Abnahme

[erledigt 21.10.2026: `simulation/` ist portiert, 21 Tests grün, Monte-Carlo und Gewinnvergleich
in `simulation/README.md`; Ergebnisse als Befunde 11–14 in `PROJECT.md`.]

Die Python-Simulation gilt als portiert, wenn der Nominallauf (ohne Rauschen) die Flugbahn des
Simulink-Nominallaufs trifft (Vergleich mit `Images/Monte-Carlo (1).png` reicht als
Plausibilität, einen MATLAB-Export habe ich nicht) und die Monte-Carlo-Streuung in derselben
Größenordnung liegt. Die beiden Tests in `tests/` laufen mit `pytest`.

## 4. Baudokumentation

Der Bau ist bisher nur über Git-Commits, Dateidaten und `PROJECT.md` rekonstruierbar. Vorschlag:
eine Datei `docs/BUILD.md` (deutsch, wie `PROJECT.md`) mit festem Aufbau, dazu ein Bilderordner.

```
docs/BUILD.md
  1. Inventar: was physisch existiert (Bauteil, Stückzahl, Quelle, Zustand)
  2. Mechanik: Rohr, Spitze, Koppler, TVC-Generation, Ring-Stack, Beine; Maße, Druckparameter
  3. Elektronik as-built: Verdrahtungsplan des Breakout-Aufbaus (welcher Pin an welchem Modul),
     Akku, Schalter
  4. Software-Stand: welcher Commit auf dem Teensy ist, welche Config.h-Schalter
  5. Durchgeführte Tests mit Datum und Ergebnis (Servo-Fenster, I2C-Scan, Beacon, Pyro-MOSFET)
  6. Bautagebuch: ein Eintrag je Arbeitssitzung (Datum, was, Fotos, offene Punkte)
  7. Regeln für die Zukunft (unten)
docs/img/build/YYYY-MM-DD_<thema>.jpg
```

Die Abschnitte 1 bis 5 fülle ich vor, so weit es aus Code, CAD und Git hervorgeht, und
markiere alles Unbekannte als `[?]`. Die Lücken sind dann deine Liste für einen Abend am
Basteltisch mit dem Handy: Inventar aufnehmen, messen, fotografieren.

Regeln ab jetzt, damit es nicht wieder auseinanderläuft:

- Jede Arbeitssitzung am Gerät bekommt einen Tagebuch-Eintrag in `BUILD.md`, auch ein
  Dreizeiler. Fotos dazu nach `docs/img/build/`.
- Jede Änderung an Verdrahtung oder Pins wird am selben Tag in `Config.h` **und** in
  `BUILD.md` §3 nachgezogen.
- Was auf dem Teensy läuft, ist immer ein Commit; `BUILD.md` §4 nennt den Hash.
- Messwerte (Servo-Pulsbreiten, Gyro-Offsets, Massen) stehen mit Datum und Methode in
  `BUILD.md`, `Config.h` verweist darauf.

## 5. Reihenfolge der Umsetzung

1. `docs/BUILD.md` anlegen und vorfüllen (hängt nicht von den Fragen ab).
2. `simulation/` aufbauen: Daten übernehmen, Servo fitten, Dynamik und Regler portieren,
   Tests, Nominallauf, Monte-Carlo, PID-Raster. Dann die Firmware-Gewinne in der Simulation
   nachrechnen (Befund 2).
3. Mainboard rev B spezifizieren (nach den Antworten), KiCad-Projekt beginnen.
4. Firmware: IMU-Treiber, Gyro-Quaternion, Zustandsautomat. Erst danach Bestellung.

## 6. Fragen

Beantwortet am 21.10.2026: Funk wird LoRa (Frage 2), Servos sind FrSky W5652H (Frage 3), der
Motor ist der TSP E12-0 (4 Stück vorhanden), das Rohr hat innen 72,6 mm. Die Bestellungen bei
Klima und Space Rocket Technology stehen im Inventar in `docs/BUILD.md` §1.

Alle weiteren Fragen hat Jan am 21.10.2026 beantwortet:

1. **IMU:** ICM-42688-P. Folge: neuer Treiber in `Sensors.cpp` ohne DMP, Gyro-Quaternion in
   der Firmware; zum Vorabtest am Breakout-Aufbau ein ICM-42688-P-Breakout kaufen.
2. **Versorgung:** Variante B (§2.5). Die W5652H laufen direkt am 2S-Akku mit bis zu 8,4 V.
3. **Servo-Umrechnung:** unbekannt. Wird am angepassten Kardan mit den W5652H neu gemessen
   (Sprungantworten wie 2025, dann Faktor und Übertragungsfunktion). Bis dahin Parameter.
4. **Motoren:** Erster Meilenstein ist der geregelte Aufstieg mit **einem** Motor und
   Fallschirm. Die Landung mit zweitem Motor kommt danach; die Simulation behält beide Fälle.
5. **Simulation:** Paket `simulation/` in diesem Repo (läuft).
6. **Trägheitsmomente:** In Simulink stehen nur Platzhalter (0,1 kg·m²), gemessen ist nichts.
   Sie werden aus einem neuen parametrischen CAD-Modell berechnet; dabei werden die
   Blender-Dateien auf Aktualität geprüft und durch ein präsentableres Modell als Code im
   Repo ersetzt (eigene Session, Ordner `cad/`).
7. **Bauzustand:** Der Flugcomputer sitzt **im Kuppler** (innen 70,2 mm), daher der
   Ring-Stack mit Ø 69. Die Klima-Spitze ersetzt die gedruckte; der Fallschirm liegt in der
   Spitze, die lose sitzt und beim Ausstoß von einem Kolben aus einem Kuppler mit
   Schwarzpulver abgestoßen wird (BPS-Prinzip). Das 50-mm-Rohr war vermutlich als
   Motorhalterung gedacht. Jan will eine Rakete, die leicht zu warten und einfach zu montieren
   ist. Das Papprohr ist ihm zu schwer und zu weich; langfristig Alternativen suchen (Glasfaser
   bleibt funktransparent, Kohlefaser nicht).
8. **Bergung:** Pyro. Tests mit etwa 1 g Schwarzpulver haben gut funktioniert. Rev B behält
   beide Pyro-Kanäle; der Servo-Ausgang für den Fallschirm bleibt als Reserve.

Damit ist die rev-B-Spezifikation freigegeben (§2.4, Schritt 2).
