Jan-Philipp-Munsch/kartonaut/hardware/mainboard/kicad/RUNDGANG_PLATINE.pdf

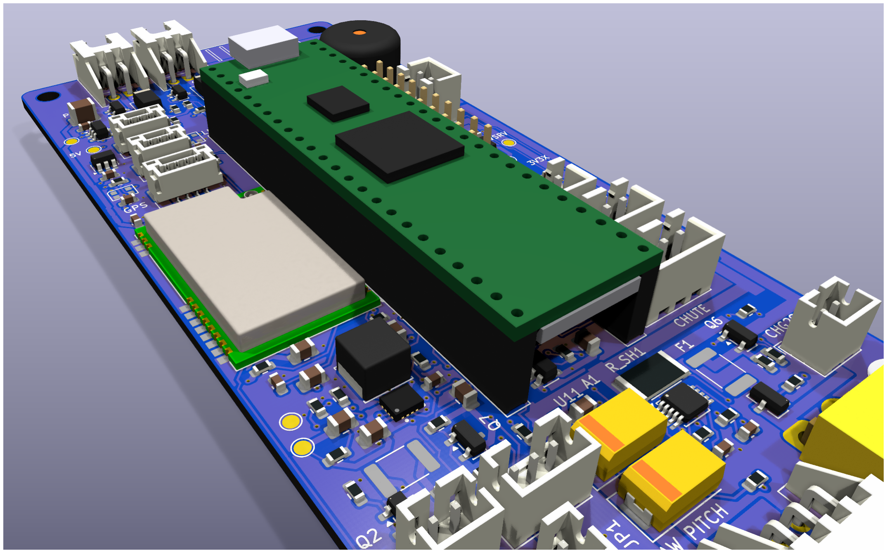
[picture p17: figure]

Kartonaut Mainboard rev B1 · Rundgang durch die Platine | Seite 1

# Rundgang durch die Platine

### Kartonaut Mainboard rev B1 · 54 × 120 mm · vier Kupferlagen · Stand 23.10.2026

3D-Ansicht aus KiCad, mit dem Teensy auf seinen Buchsenleisten und dem LoRa-Modul daneben.

Diese Anleitung erklärt, wo die Bauteile sitzen, wie Leitungen und Vias funktionieren, warum die Platine vier Lagen hat, wie sie entstanden ist und was KiCad dabei prüft. Alle Bilder sind aus der aktuellen Platinendatei gezeichnet. Bei den Draufsichten liegt die Spitze der Rakete oben und das Heck mit dem Triebwerk unten, genau wie im KiCad-Leiterplatteneditor.

Kennzahl | Wert
Bauteile | 166, davon 9 unbestückt (Pyro 3 und 4, zweites Barometer)
Netze (elektrisch getrennte Verbindungen) | 113
Leiterbahn-Segmente | 2194
Vias (Durchkontaktierungen) | 374
Design Rule Check | 0 Fehler, 0 offene Verbindungen, 0 Abweichungen vom Schaltplan

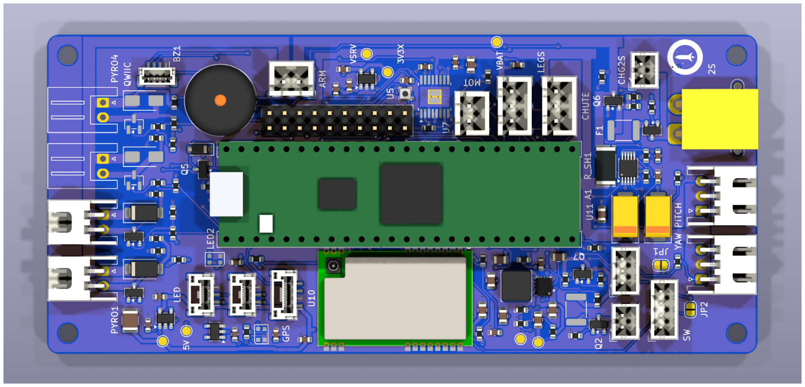
[picture p18: figure]
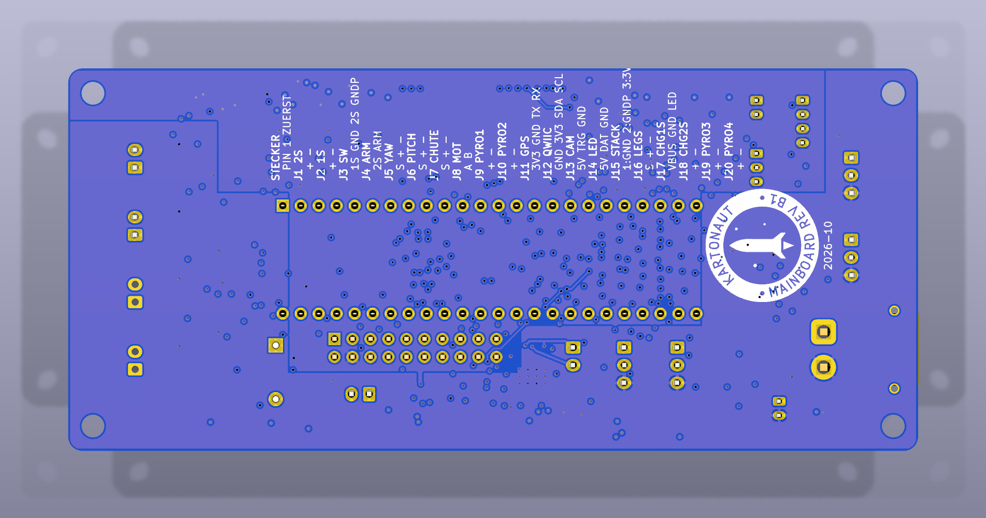
[picture p19: figure]

Kartonaut Mainboard rev B1 · Rundgang durch die Platine | Seite 2

## 1 Orientierung

Draufsicht, hier quer gelegt: links die Spitze mit den vier Pyro-Steckern, rechts das Heck mit dem XT30-Akkustecker (gelb). In der Mitte die Buchsenleisten für den Teensy, darunter das LoRa-Funkmodul.

Eine Platine ist ein Stapel aus Glasfaser-Epoxid (FR4) mit Kupferschichten dazwischen und außen. Die Bauteile sitzen alle auf der Oberseite. Grün oder hier blau ist der Lötstopplack: er deckt das Kupfer ab, nur die Lötflächen (Pads) bleiben frei. Weiß ist der Bestückungsdruck mit Namen und Markierungen.

In KiCad gibt es ein Koordinatensystem in Millimetern: x nach rechts, y nach unten. Unsere Platine liegt zwischen x 100 und 154 und zwischen y 50 (Spitze) und 170 (Heck). Die Statusleiste unten in KiCad zeigt die Position des Mauszeigers. Die Positionsangaben in dieser Anleitung beziehen sich darauf.

Unterseite: keine Bauteile, nur die Versorgungsfläche, Bohrungen und Testpunkte.

## 2 Wo die Bauteile sitzen

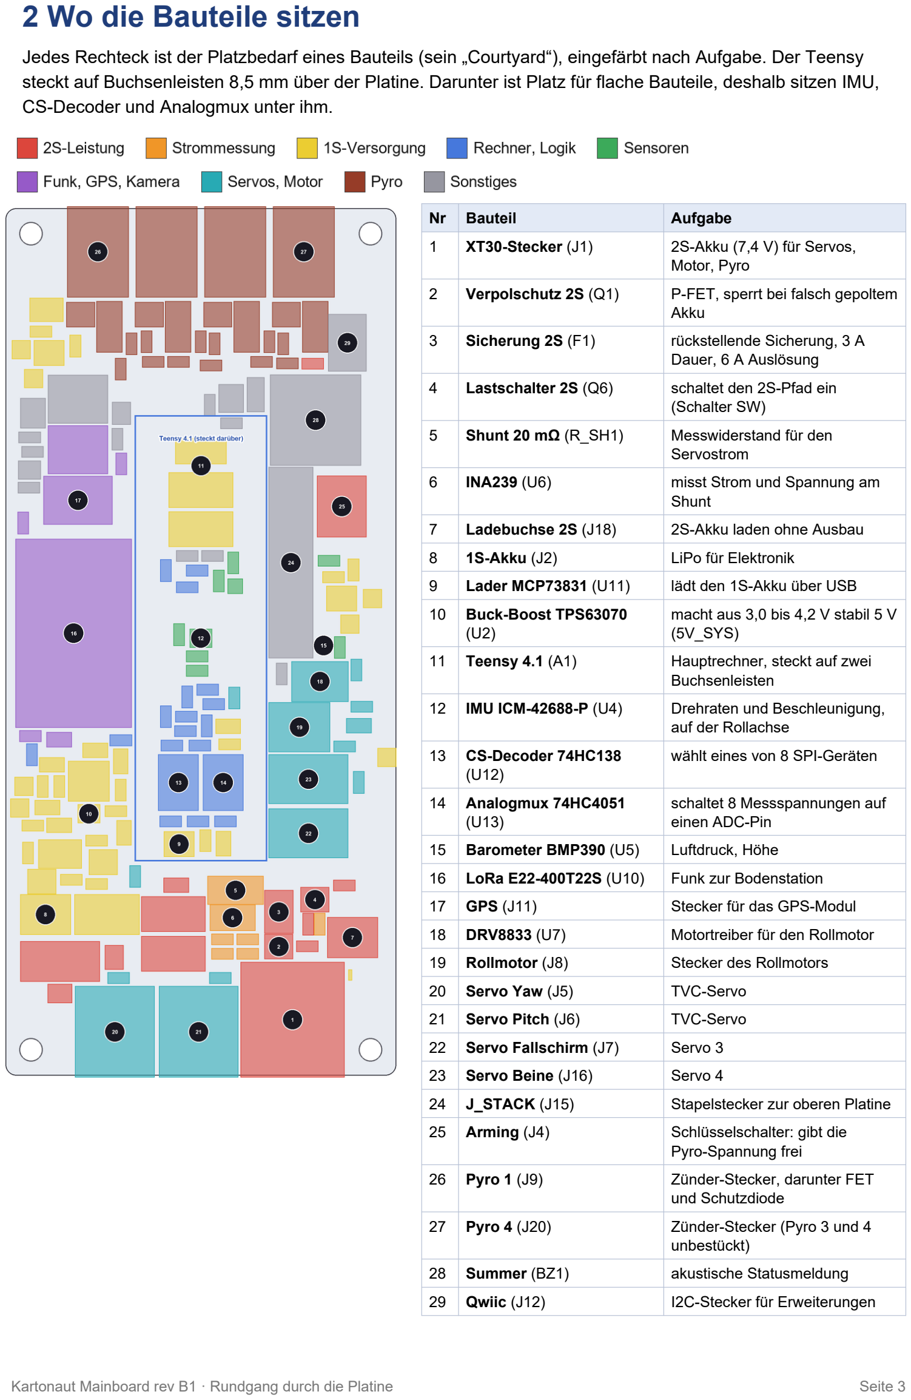
[picture p20: page 3]

Kartonaut Mainboard rev B1 · Rundgang durch die Platine | Seite 3

Jedes Rechteck ist der Platzbedarf eines Bauteils (sein „Courtyard“), eingefärbt nach Aufgabe. Der Teensy steckt auf Buchsenleisten 8,5 mm über der Platine. Darunter ist Platz für flache Bauteile, deshalb sitzen IMU, CS-Decoder und Analogmux unter ihm.

Nr | Bauteil | Aufgabe
1 | XT30-Stecker (J1) | 2S-Akku (7,4 V) für Servos, Motor, Pyro
2 | Verpolschutz 2S (Q1) | P-FET, sperrt bei falsch gepoltem Akku
3 | Sicherung 2S (F1) | rückstellende Sicherung, 3 A Dauer, 6 A Auslösung
4 | Lastschalter 2S (Q6) | schaltet den 2S-Pfad ein (Schalter SW)
5 | Shunt 20 mΩ (R_SH1) | Messwiderstand für den Servostrom
6 | INA239 (U6) | misst Strom und Spannung am Shunt
7 | Ladebuchse 2S (J18) | 2S-Akku laden ohne Ausbau
8 | 1S-Akku (J2) | LiPo für Elektronik
9 | Lader MCP73831 (U11) | lädt den 1S-Akku über USB
10 | Buck-Boost TPS63070 (U2) | macht aus 3,0 bis 4,2 V stabil 5 V (5V_SYS)
11 | Teensy 4.1 (A1) | Hauptrechner, steckt auf zwei Buchsenleisten
12 | IMU ICM-42688-P (U4) | Drehraten und Beschleunigung, auf der Rollachse
13 | CS-Decoder 74HC138 (U12) | wählt eines von 8 SPI-Geräten
14 | Analogmux 74HC4051 (U13) | schaltet 8 Messspannungen auf einen ADC-Pin
15 | Barometer BMP390 (U5) | Luftdruck, Höhe
16 | LoRa E22-400T22S (U10) | Funk zur Bodenstation
17 | GPS (J11) | Stecker für das GPS-Modul
18 | DRV8833 (U7) | Motortreiber für den Rollmotor
19 | Rollmotor (J8) | Stecker des Rollmotors
20 | Servo Yaw (J5) | TVC-Servo
21 | Servo Pitch (J6) | TVC-Servo
22 | Servo Fallschirm (J7) | Servo 3
23 | Servo Beine (J16) | Servo 4
24 | J_STACK (J15) | Stapelstecker zur oberen Platine
25 | Arming (J4) | Schlüsselschalter: gibt die Pyro-Spannung frei
26 | Pyro 1 (J9) | Zünder-Stecker, darunter FET und Schutzdiode
27 | Pyro 4 (J20) | Zünder-Stecker (Pyro 3 und 4 unbestückt)
28 | Summer (BZ1) | akustische Statusmeldung
29 | Qwiic (J12) | I2C-Stecker für Erweiterungen

Kartonaut Mainboard rev B1 · Rundgang durch die Platine | Seite 4

### Die Aufteilung folgt den Strömen

- Heck (unten): Hier kommt die Energie an. Rechts der 2S-Akku über den XT30-Stecker J1, dann die Kette Verpolschutz Q1, Sicherung F1, Lastschalter Q6 und der Shunt R_SH1 zur Strommessung. Links die 1S-Seite: Akku J2, Schalter J3, Lader und der Wandler U2, der daraus 5 V macht. Ganz unten die zwei TVC-Servos, damit ihr Strom kurz bleibt.
- Mitte: der Teensy als Rechner. Die IMU U4 sitzt auf der Rollachse, also genau in der Mitte. Decoder U12 und Mux U13 liegen direkt an den Teensy-Pins, die sie bedienen.
- Rechter Streifen: alles, was Kraft braucht: Servos J7 und J16, Rollmotor J8 mit Treiber U7, dann Stapelstecker J15 und Arming-Stecker J4. Am Rand laufen die breiten Strompfade.
- Linker Streifen: Funk und Peripherie: LoRa-Modul U10, GPS, Kamera, LEDs.
- Spitze (oben): die vier Pyro-Ausgänge. Unter jedem Stecker eine Spalte aus Schutzdiode und Schalt-FET, damit der Zündstrom auf kürzestem Weg fließt.

Faustregel für die Platzierung: Erst kommen die Bauteile, die mechanisch festliegen: Stecker am Rand, Teensy, Bohrungen. Dann die, durch die viel Strom fließt, möglichst kurz hintereinander. Kleinteile wie Kondensatoren gehören direkt an den Pin, den sie versorgen. Erst danach wird verlegt. Fast alle Probleme beim Verlegen haben ihre Ursache in der Platzierung.

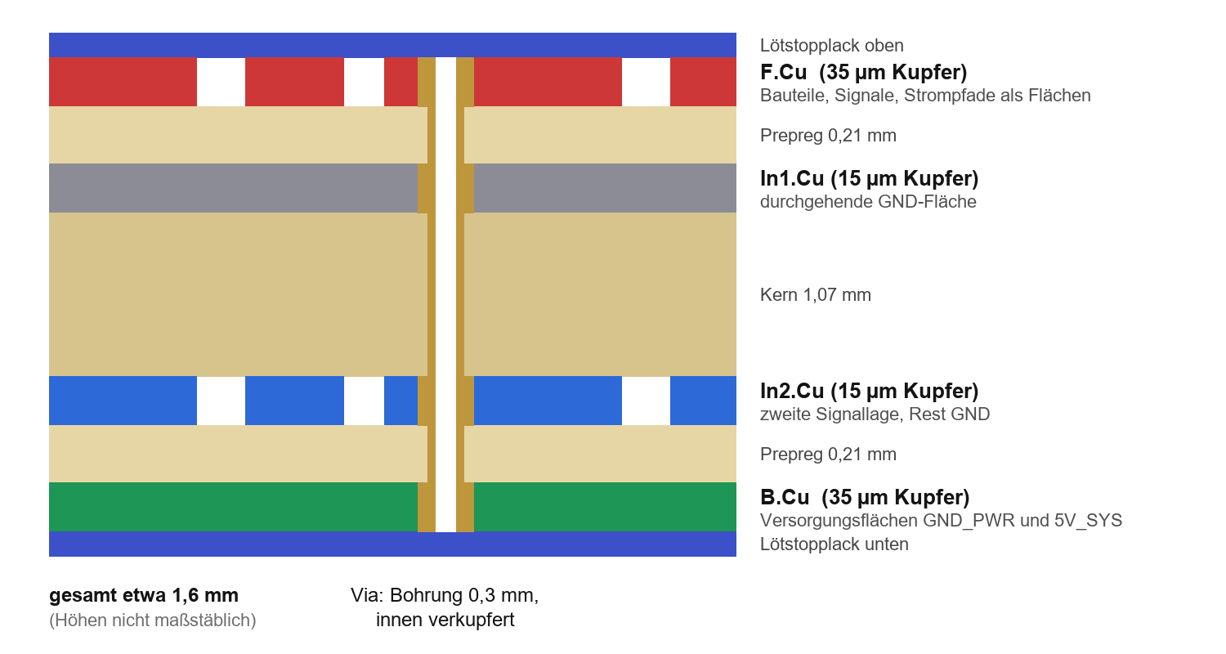
[picture p21: figure]

Kartonaut Mainboard rev B1 · Rundgang durch die Platine | Seite 5

## 3 Warum vier Lagen?

Querschnitt durch die Platine. Kupfer ist farbig, Isolierstoff beige. Ein Via ist eine verkupferte Bohrung, die alle Lagen an einer Stelle verbinden kann.

Eine einfache Platine hat zwei Lagen: oben und unten. Unsere hat zwei weitere im Inneren. Jede hat eine feste Aufgabe:

Lage | Aufgabe | Warum
F.Cu (oben) | Bauteile, die meisten Signale, Strompfade als Flächen | Hier sitzen die Pads, also beginnt und endet hier fast jede Leitung.
In1.Cu | eine durchgehende GND-Fläche | Jede Leitung braucht einen Rückweg für ihren Strom. Liegt direkt unter ihr eine geschlossene Massefläche, fließt der Rückstrom genau darunter zurück. Das hält Störungen klein und die Messwerte ruhig.
In2.Cu | zweite Signallage, Lücken mit GND gefüllt | Mit 166 Bauteilen auf 54 × 120 mm passen nicht alle Leitungen auf eine Lage. Wo sich zwei kreuzen müssen, geht eine über ein Via nach In2.
B.Cu (unten) | Versorgungsflächen GND_PWR und 5V_SYS | Breite Kupferflächen verteilen Strom mit wenig Widerstand, ohne dass dafür Leitungen gezogen werden müssen.

Mit nur zwei Lagen müsste die Massefläche zwischen den Leitungen zerstückelt werden. Rückströme liefen dann Umwege, und genau diese Umwege strahlen und stören. Für die IMU, die feine Drehraten misst, und den Funk ist das kritisch. Bei JLCPCB kostet die vierlagige Platine nur wenig mehr als die zweilagige.

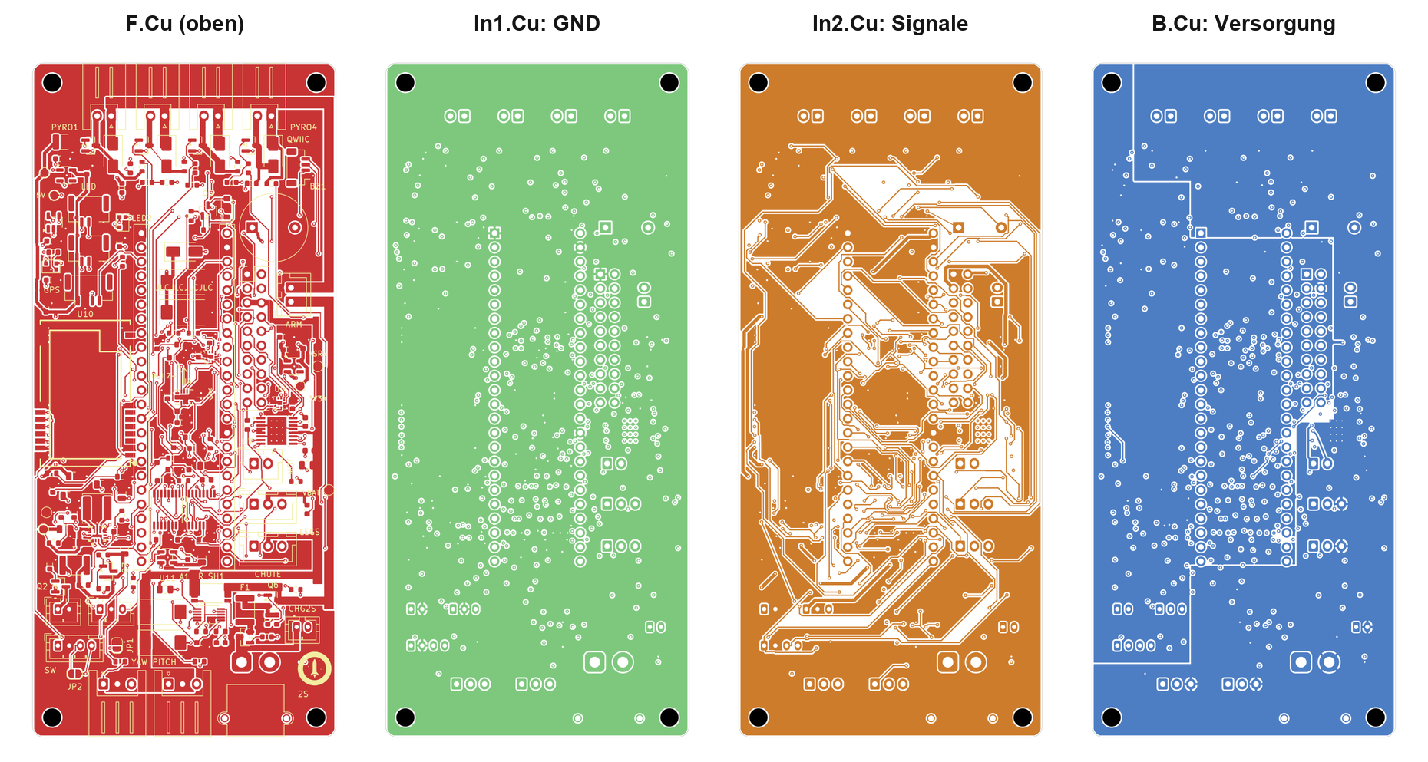
[picture p22: figure]

Kartonaut Mainboard rev B1 · Rundgang durch die Platine | Seite 6

Die vier Kupferlagen einzeln, jede in ihrer KiCad-Farbe: F.Cu rot, In1 grün, In2 orange, B.Cu blau. Weiß ist kupferfrei. In1 ist fast geschlossen, die weißen Punkte sind Vias anderer Netze, die hindurchgehen.

Auf F.Cu sieht man die feinen Leitungen zwischen den Pads, auf In2 die längeren Wege quer über die Platine. In1 ist eine einzige Fläche. Auf B.Cu erkennt man die Teilung in zwei Flächen, mehr dazu auf der nächsten Seite.

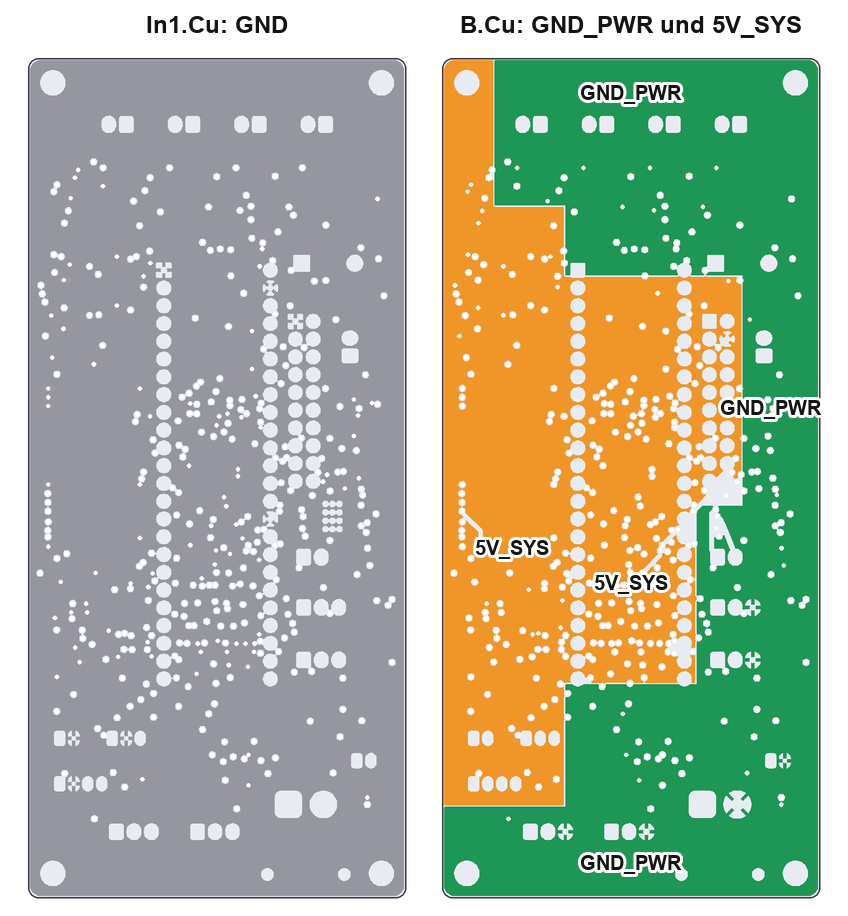
[picture p23: figure]

Kartonaut Mainboard rev B1 · Rundgang durch die Platine | Seite 7

## 4 Die Flächen: Masse und Versorgung

Links In1 (GND, durchgehend), rechts B.Cu: grün GND_PWR, orange 5V_SYS. Weiße Punkte sind Vias, weiße Linien kurze Signalstücke, die auf B.Cu laufen.

- GND ist die Masse der Elektronik: Rechner, Sensoren, Funk. Sie liegt als ganze Lage auf In1. Jedes GND-Pad bekommt direkt daneben ein eigenes Via dorthin.
- GND_PWR ist die Masse der Leistung: Servos, Motor, Pyro und der 2S-Akku. Diese Ströme sind groß und springen beim Anlaufen eines Servos. Sie sollen nicht durch die empfindliche Masse fließen.
- Beide Massen sind an genau einer Stelle verbunden, am Sternpunkt NT1 direkt am Minuspol des XT30. So können die Leistungsströme nicht durch die Elektronikmasse zurückfließen.
- 5V_SYS ist die 5-V-Versorgung aus dem Wandler U2. Sie liegt als Fläche unter der 1S-Seite und unter dem Teensy.

Warum die Flächen nicht zerschnitten werden sollen: Ein Schlitz in einer Fläche zwingt den Strom zu einem Umweg. Deshalb liegen auf B.Cu nur wenige kurze Signalstücke, und die Strom-Netze nie. Wo ein Signal doch durch die Fläche musste, ist das in README §5.5 mit Länge aufgeführt.

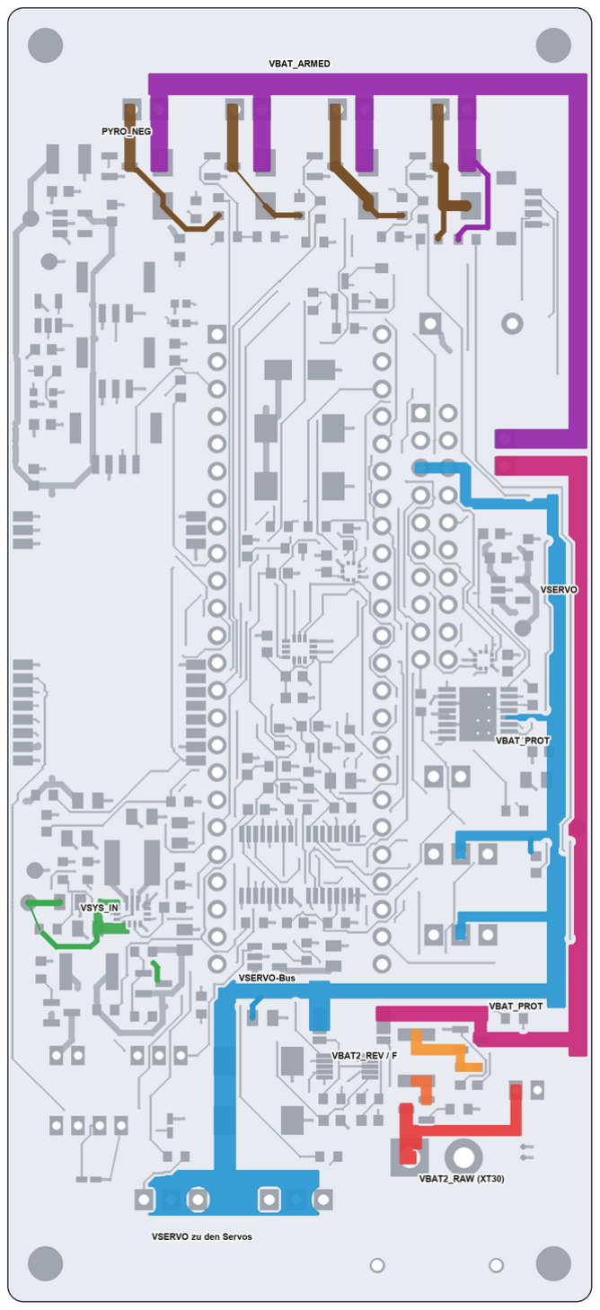
[picture p24: figure]

Kartonaut Mainboard rev B1 · Rundgang durch die Platine | Seite 8

## 5 Die Strompfade

Strompfade auf F.Cu, farbig hervorgehoben. Grau sind alle anderen Leitungen und Pads der Oberseite.

Durch einige Netze fließen mehrere Ampere: der 2S-Akkustrom, die Servo-Versorgung VSERVO und beim Zünden kurz bis zu 5 A durch einen Pyro-Kanal. Dafür reichen normale Leiterbahnen nicht. Diese Netze sind breite Kupferflächen auf der Oberseite, im Generator „Korridore“ genannt:

- 2S-Kette: XT30 J1 → VBAT2_RAW → Verpolschutz Q1 → VBAT2_REV → Sicherung F1 → VBAT2_F → Lastschalter Q6 → VBAT_PROT.
- VBAT_PROT geht von Q6 nach links über F1 zum Shunt und nach rechts an den Rand, dort hoch zum Arming-Stecker J4.
- VBAT_ARMED kommt aus J4 zurück und läuft als Band hinter den vier Pyro-Steckern entlang.
- VSERVO kommt aus dem Shunt, läuft als Bus unter dem Teensy quer zu den TVC-Servos und als Schiene am rechten Rand zu Servo 3 und 4, zum Motortreiber und zum Stapelstecker.
- PYRO_NEG: vom Schalt-FET jedes Kanals senkrecht zum Stecker.
Strom-Netze bleiben ausschließlich auf der Oberseite und haben kein Via. Ein Via verträgt nur etwa 1 A, und die Innenlagen haben dünneres Kupfer (15 statt 35 µm). Außerdem soll die 2S-Spannung nicht neben empfindlichen Innenlagen-Signalen liegen.

Damit kein Autorouter eine fremde Leitung quer durch einen Strompfad legt, hat jeder Korridor eine 0,2 mm schmale Sperre auf seiner Mittellinie. Sie gilt nur während des Routens und wird danach gelöscht.

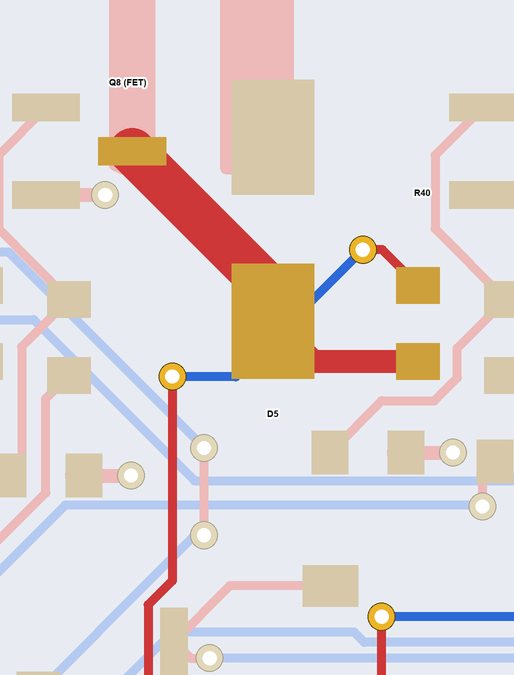
[picture p25: figure]

Kartonaut Mainboard rev B1 · Rundgang durch die Platine | Seite 9

## 6 Leitungen und Vias

Eine Leiterbahn verbindet zwei Pads desselben Netzes. Zwei Größen bestimmen sie: die Breite und der Abstand zu fremdem Kupfer. Beides ist über Netzklassen festgelegt:

Netzklasse | Breite | Abstand | Beispiele
Strom | 1,0 mm (Fläche) | 0,2 mm | VBAT2_*, VBAT_PROT, VSERVO, VBAT_ARMED, PYRO*_NEG
Rückstrom | 0,8 mm | 0,2 mm | GND_PWR, wo es nicht über die Fläche geht
Versorgung | 0,6 mm | 0,2 mm | 5V_SYS, 3V3_RF, VSYS_IN, MOT_A/B
Wandler | 0,4 mm | 0,15 mm | U2_L1, U2_L2 (Spule des Wandlers)
Default | 0,2 mm | 0,15 mm | alle Signale wie SPI, I2C, UART, Chip-Selects

Die Breite richtet sich nach dem Strom: Eine 0,2-mm-Bahn auf der Oberseite trägt etwa 0,5 A, eine 1-mm-Bahn etwa 2,5 A. Der Abstand verhindert Kurzschlüsse bei der Fertigung. JLCPCB fertigt sicher ab 0,127 mm Abstand und 0,09 mm Breite.

### Wann braucht man ein Via?

Zwei Leitungen auf derselben Lage dürfen sich nicht kreuzen. Muss eine Leitung über eine andere hinweg, wechselt sie über ein Via auf eine andere Lage und kommt danach mit einem zweiten Via zurück. Das Beispiel zeigt Pyro-Kanal 3:

Pyro 3. Rot: Oberseite, blau: In2, gelbe Kreise: Vias. Hervorgehoben sind PYRO3_NEG und PYRO3_SENSE, alles andere ist blass.

- Die breite rote Bahn ist PYRO3_NEG: Zündstrom vom FET Q8 zur Schutzdiode D5, als Strom-Netz nur oben.
- Die Messleitung PYRO3_SENSE von R40 musste diese Bahn kreuzen. Sie taucht über ein Via auf In2 ab, läuft unter der Zündbahn durch und kommt über das zweite Via wieder hoch.
- Die anderen Leitungen weichen in Abstand aus, die zwei Wege berühren sich nirgends.

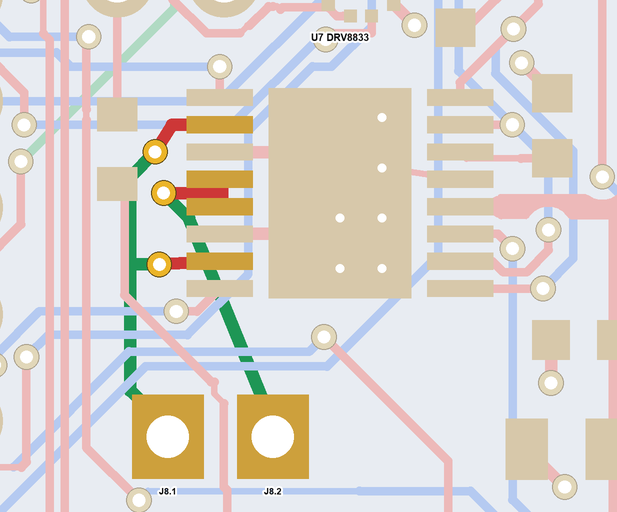
[picture p26: figure]
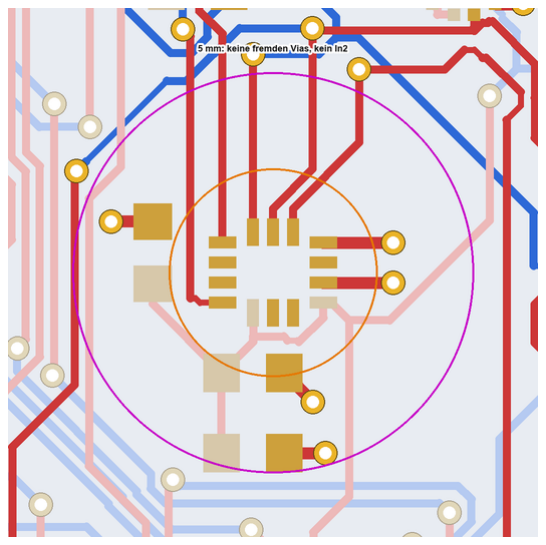
[picture p27: figure]

Kartonaut Mainboard rev B1 · Rundgang durch die Platine | Seite 10

### Ein schwieriges Beispiel: der Motortreiber

DRV8833 (U7). Rot: Oberseite, blau: In2, grün: B.Cu. Hervorgehoben MOT_A und MOT_B zum Motorstecker J8.

Der DRV8833 hat seine Ausgänge abwechselnd an den Pins: MOT_A an Pin 2 und 7, MOT_B an Pin 4 und 5 dazwischen. Auf einer Lage kann man nicht beide Paare zum Stecker J8 führen, ohne dass sich eine Bahn einschließt. Gelöst ist es so: Jeder Ausgang bekommt ein Via direkt am Pin und läuft auf B.Cu (grün) zu seinem Steckerpin. J8 ist ein bedrahteter Stecker, sein Pin geht durch alle Lagen und lässt sich deshalb auch von unten erreichen.

Warum manche Bahnen ihre Breite wechseln: Eine Bahn kann nicht breiter sein als das Pad, in das sie läuft. Der Autorouter verjüngt sie deshalb kurz vor kleinen Pads, etwa von 0,6 auf 0,4 mm. Das ist normal. Elektrisch zählt die engste Stelle, und die ist nur ein kurzes Stück. Die feinen Treppen aus 0,05-mm-Stufen, die beim Nacharbeiten entstanden waren, sind inzwischen zu geraden Stücken zusammengefasst. Keine Bahn ist schmaler als 0,15 mm.

### Sonderzonen

IMU U4: violett der 5-mm-Kreis, orange der 2,6-mm-Kreis direkt unter dem Chip.

- IMU: Im Kreis von 5 mm um den Chip liegen nur seine eigenen fünf GND-Vias und keine Leitungen auf In2. Die Masse unter dem Sensor bleibt so ungestört.
- LoRa-Modul: Unter dem Modul liegen keine Leitungen auf F.Cu und In2. Das Funkmodul braucht eine ruhige Massefläche unter sich. Die Pins sitzen an seinem Rand, die Leitungen gehen außen herum.

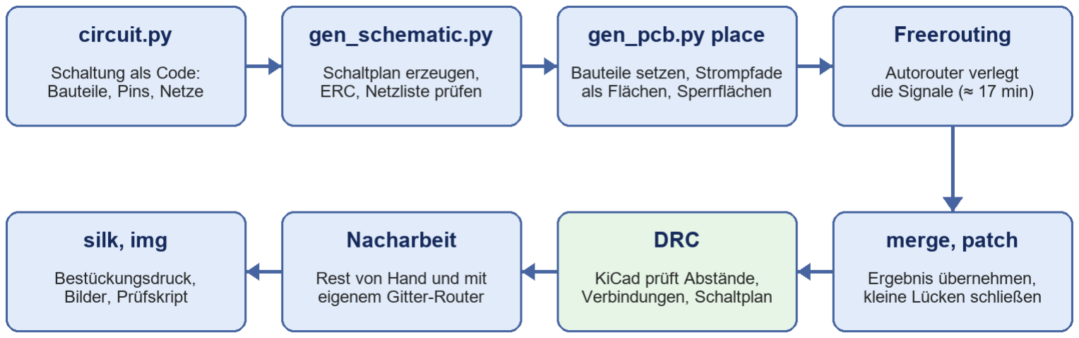
[picture p28: figure]

Kartonaut Mainboard rev B1 · Rundgang durch die Platine | Seite 11

## 7 Wie die Platine entstanden ist

Die Kette aus Skripten, mit der Schaltplan und Platine erzeugt werden.

Die Platine ist nicht von Hand gezeichnet, sondern aus Code erzeugt. Das hat einen Vorteil: Jede Entscheidung steht nachvollziehbar in einer Datei und lässt sich wiederholen.

- circuit.py beschreibt die Schaltung: jedes Bauteil mit Gehäuse und welcher Pin an welchem Netz hängt.
- gen_schematic.py zeichnet daraus den Schaltplan. Der ERC prüft ihn, etwa auf offene Eingänge oder zwei Ausgänge an einem Netz. check_design.py vergleicht die Netzliste mit der Spezifikation.
- gen_pcb.py place setzt die Bauteile: feste Positionen für Stecker, Teensy und Leistungsteile, die Kleinteile sucht ein Platzierer neben ihrem IC. Dann zeichnet es die Strompfade als Flächen, legt Sperrflächen an und setzt die Vias der GND- und Versorgungs-Pads.
- Freerouting ist ein Autorouter. Er bekommt die Platine als Datei, verlegt in etwa 17 Minuten die Signale und gibt das Ergebnis zurück. Zwei kurze Nachläufe versuchen die Reste.
- Der DRC in KiCad prüft das Ergebnis.

### Was am 23.10. passiert ist

- Nach Freerouting blieben 21 Verbindungen offen. Sieben davon gingen von Hand in KiCad und per Skript zu.
- Die anderen 14 lagen an der Platzierung. Ein Beispiel: Der Strompfad VBAT_PROT war im Generator vorgesehen, aber Freerouting legte Signalleitungen quer hindurch, weil die Sperrfläche bei schmalen Pfaden zu nichts schrumpfte. Außerdem saßen zwei Kondensatoren des Motortreibers 8 bis 14 mm von ihm entfernt.
- Also wurde der Generator korrigiert: Jeder Strompfad hat jetzt eine schmale Sperre auf seiner Mittellinie. Die Kondensatoren haben feste Plätze am Treiber, Q6, R2 und R4 sind neu angeordnet, und J18 und J15 bekommen eigene Strompfade.
- Neuer Lauf: 18 offene Stellen, aber andere und leichtere. Die gingen mit einem eigenen Gitter-Router und Einzelkorrekturen zu. Am Ende wurden die Treppenwege begradigt.

Wichtig: Ab jetzt ist die Platinendatei die Quelle. Ein neuer Lauf von ./make.sh pcb würde eine andere Platine erzeugen und die Nacharbeit löschen. Kleine Änderungen macht man ab hier direkt in KiCad.

Kartonaut Mainboard rev B1 · Rundgang durch die Platine | Seite 12

## 8 Was KiCad prüft und was nicht

Der Design Rule Check (DRC) vergleicht jede Bahn, jedes Pad und jedes Via mit den Regeln aus dem Projekt. Er unterscheidet Fehler, die behoben werden müssen, und Warnungen, die man bewerten kann.

KiCad prüft | Beispiel auf unserer Platine
Abstand zwischen Kupfer verschiedener Netze | mindestens 0,127 mm, Strom- und Versorgungsklassen 0,2 mm
Mindestbreite von Bahnen | 0,09 mm (Fertigungsgrenze), tatsächlich ab 0,15 mm
Vias und Bohrungen | Via 0,6/0,3 mm, Restring, Abstand Loch zu Loch
Abstand zum Platinenrand | 0,2 mm
Offene Verbindungen | jedes Pad eines Netzes muss mit den anderen verbunden sein
Kurzschlüsse | zwei Netze, die sich berühren
Sperrflächen | unter dem LoRa-Modul, um die IMU
Bestückungsdruck | Text über Pads oder über dem Rand: bei uns nur Warnungen
Übereinstimmung mit dem Schaltplan | jedes Bauteil und jedes Netz wie im Schaltplan
KiCad prüft nicht | Wer es stattdessen prüft
ob eine Bahn breit genug für ihren Strom ist | Netzklassen und Strompfade im Generator; Liste im Prüfskript
„Strom-Netze nur oben, ohne Via“ | review_check_layout.py
„keine fremden Vias und kein In2 nahe der IMU“ | teils Sperrflächen, sonst review_check_layout.py
Schlitze in den Flächen, Rückstromwege, EMV | Review mit dem Kollegen anhand der Lagenbilder
Wärme, z. B. am Motortreiber | Datenblatt, Wärmepad mit Vias zur GND_PWR-Fläche
ob die Schaltung richtig ist | ERC, check_design.py, Review
ob alles mechanisch passt | 1:1-Ausdruck in den Kuppler halten

Ein bestandener DRC heißt also: Die Platine ist fertigbar und richtig verbunden. Ob sie gut ist, zeigt erst der Blick eines Menschen. Deshalb steht als Nächstes das Review mit dem Kollegen an.

Kartonaut Mainboard rev B1 · Rundgang durch die Platine | Seite 13

## 9 Selbst in KiCad nachsehen

Was | Wie im Leiterplatteneditor
Ein Netz hervorheben | Mauszeiger auf eine Bahn oder ein Pad, Taste ` (Gravis, links neben der 1). Noch einmal drücken hebt es wieder auf.
Eine Lage allein ansehen | Rechts im Panel „Darstellung“ auf das Auge neben einer Lage klicken; Bild hoch und Bild runter wechseln die aktive Lage.
Nur die aktive Lage kräftig zeigen | Menü Ansicht → Hochkontrastmodus
Eigenschaften einer Bahn | Bahn anklicken: links stehen Netz, Breite und Lage.
Messen | Menü Inspektion → Messwerkzeug, dann zwei Punkte anklicken
3D-Ansicht | Menü Ansicht → 3D-Betrachter
DRC laufen lassen | Menü Inspektion → Designregeln überprüfen, dann „DRC starten“

## Kleines Glossar

Begriff | Bedeutung
Pad | Lötfläche eines Bauteils
Leiterbahn (Track) | Kupferstreifen zwischen zwei Punkten auf einer Lage
Via | verkupferte Bohrung, verbindet Lagen an einer Stelle
Netz | alles, was elektrisch zusammengehört, z. B. GND oder SPI1_SCK
Netzklasse | Gruppe von Netzen mit gleicher Breite und gleichem Abstand
Zone, Fläche | Kupferfläche, die KiCad selbst ausfüllt und um fremdes Kupfer herum ausspart
Sperrfläche (Keepout) | Bereich, in dem keine Bahnen oder Vias liegen dürfen
Courtyard | Platzbedarf eines Bauteils; zwei Courtyards dürfen sich nicht überlappen
DRC / ERC | Regelprüfung der Platine / des Schaltplans
Autorouter | Programm, das Leitungen selbst verlegt; hier Freerouting
Schiebe-Router | KiCads Werkzeug, das beim Verlegen fremde Bahnen beiseiteschiebt
Shunt | kleiner, genauer Widerstand, an dem man den Strom misst
Sternpunkt | die eine Stelle, an der zwei Massen verbunden sind
THT / SMD | Bauteil mit Drahtbeinen durch die Platine / Bauteil zum Auflöten auf die Oberfläche
