Jan-Philipp-Munsch/kartonaut/docs/img/cad/blender_dual_tvc.png

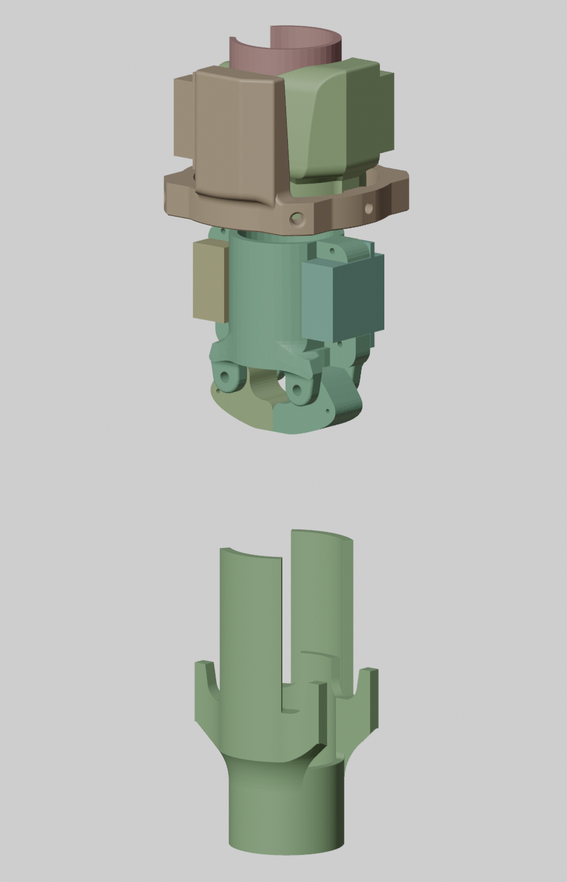
docs/img/cad/blender_dual_tvc.png
