Jan-Philipp-Munsch/kartonaut/docs/img/cad/blender_flight_computer.png

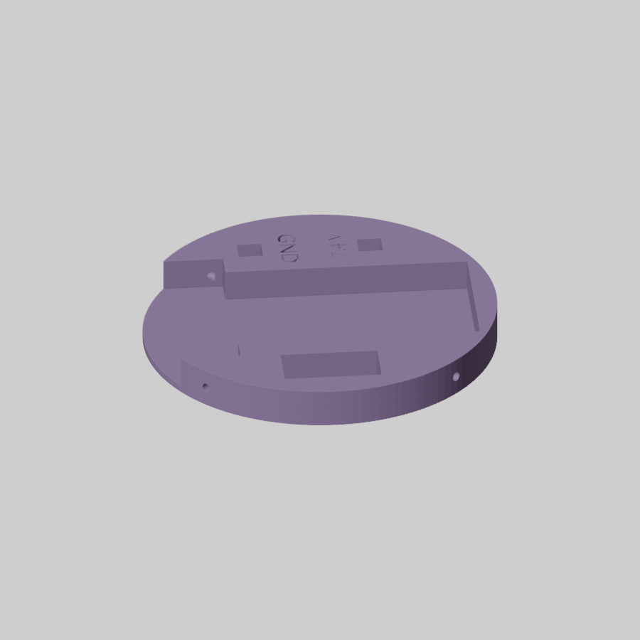
docs/img/cad/blender_flight_computer.png
