Jan-Philipp-Munsch/kartonaut/docs/img/cad/blender_flight_computer_obj.png

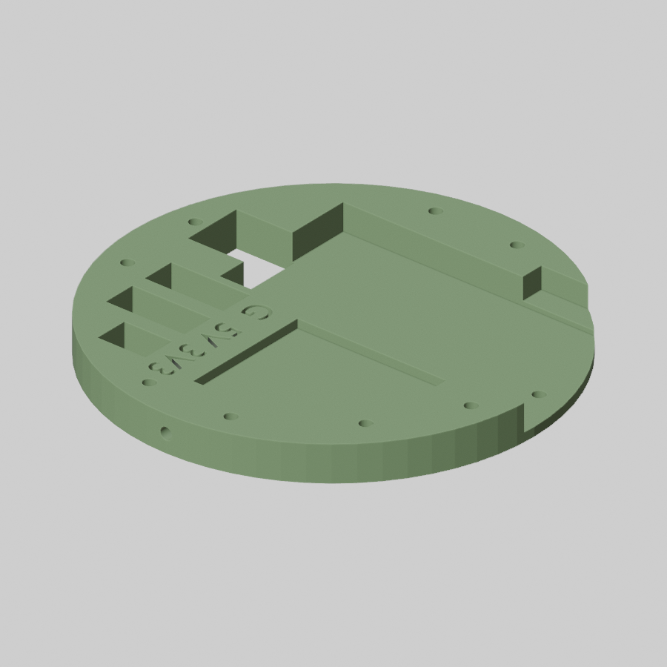
docs/img/cad/blender_flight_computer_obj.png
