Jan-Philipp-Munsch/kartonaut/docs/img/cad/blender_flight_computer_stack.png

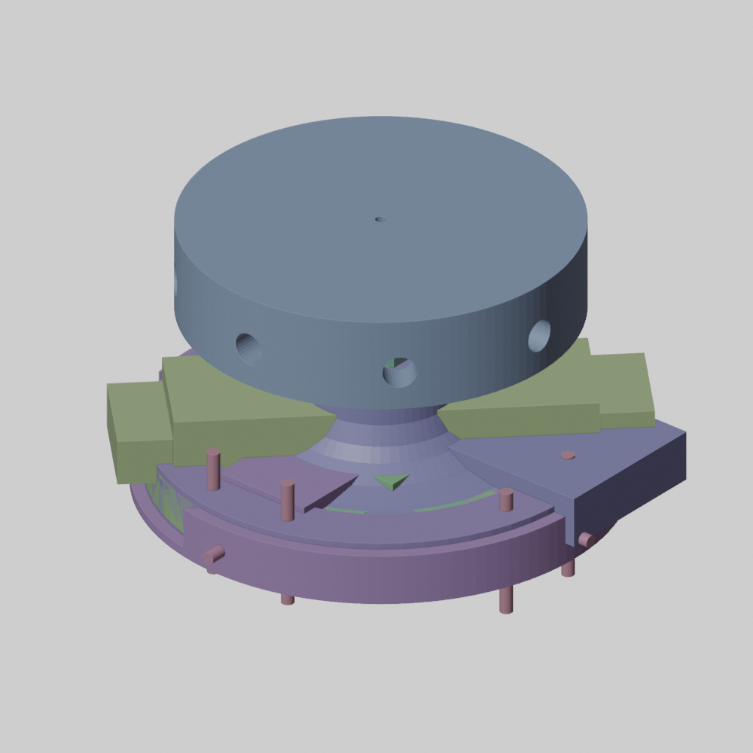
docs/img/cad/blender_flight_computer_stack.png
