Jan-Philipp-Munsch/kartonaut/docs/img/cad/blender_flywheel.png

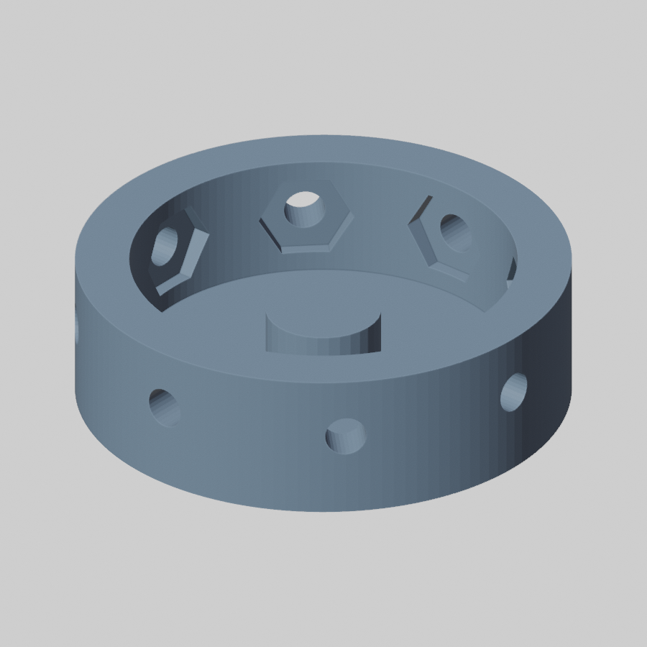
docs/img/cad/blender_flywheel.png
