Jan-Philipp-Munsch/kartonaut/docs/img/cad/blender_Inner_gimbal.png

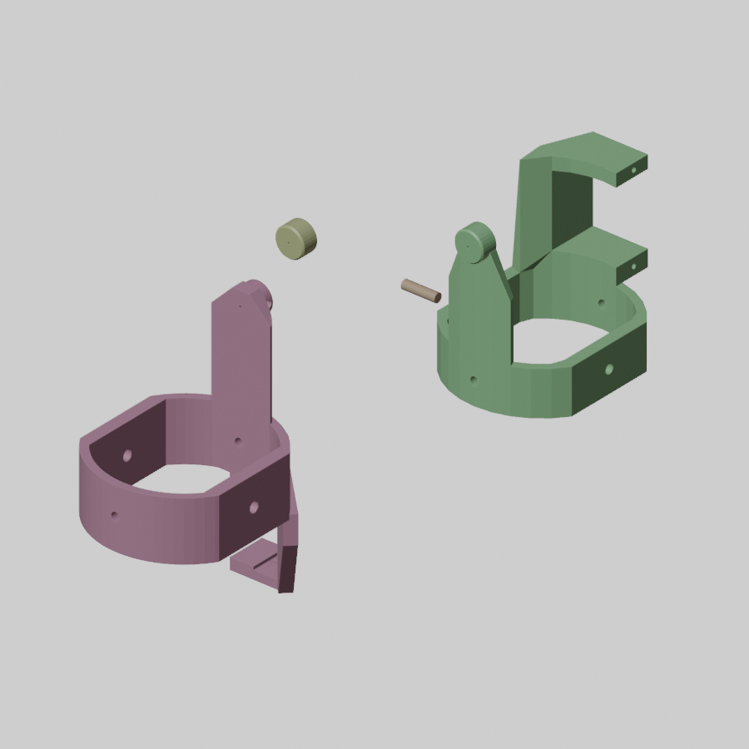
docs/img/cad/blender_Inner_gimbal.png
