Jan-Philipp-Munsch/kartonaut/docs/img/cad/blender_inner_gimbal_dual_TVC.png

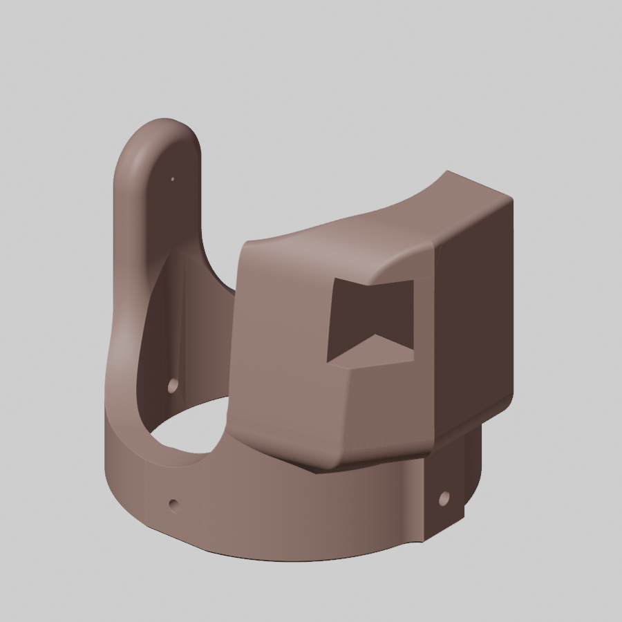
docs/img/cad/blender_inner_gimbal_dual_TVC.png
