Jan-Philipp-Munsch/kartonaut/docs/img/cad/blender_Inner_gimbal_V2.png

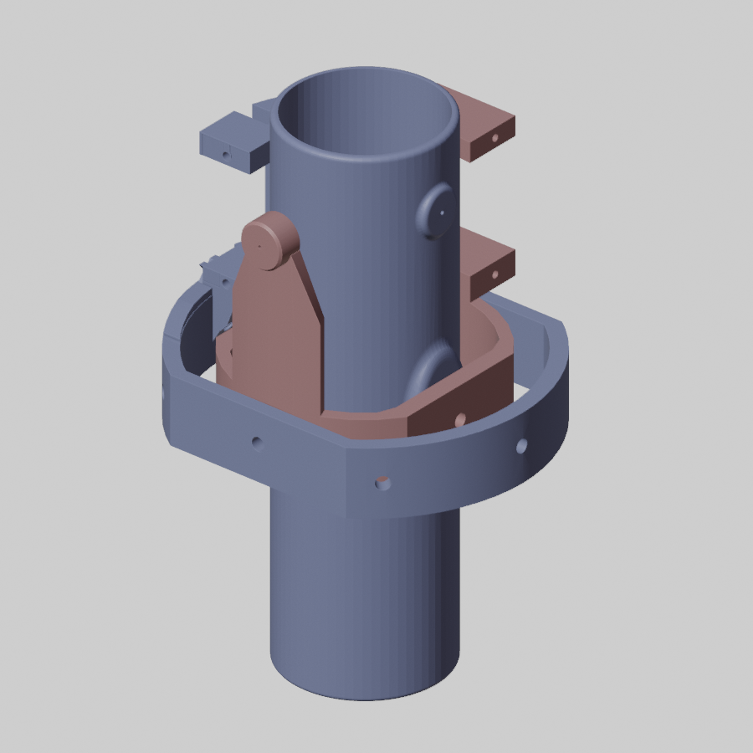
docs/img/cad/blender_Inner_gimbal_V2.png
