Jan-Philipp-Munsch/kartonaut/docs/img/cad/blender_LegConnectors.png

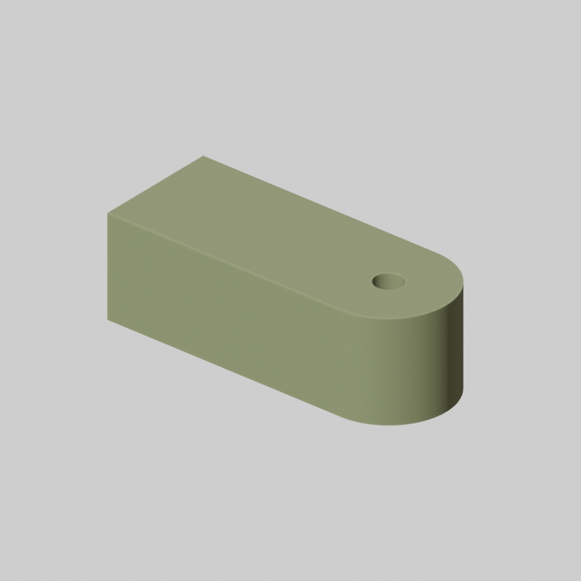
docs/img/cad/blender_LegConnectors.png
