Jan-Philipp-Munsch/kartonaut/docs/img/cad/blender_model_rocket.png

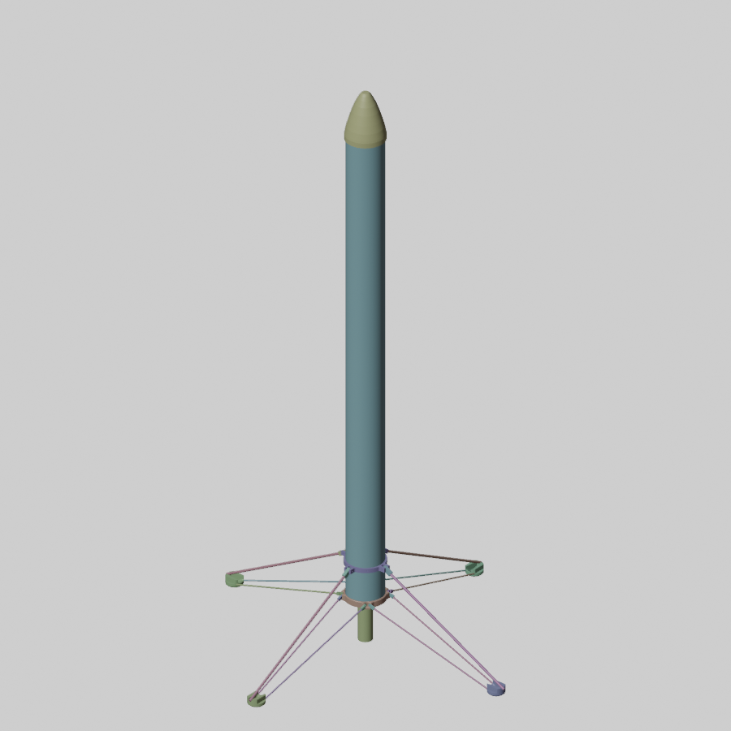
docs/img/cad/blender_model_rocket.png
