Jan-Philipp-Munsch/kartonaut/docs/img/cad/blender_outer_gimbal_dual_TVC.png

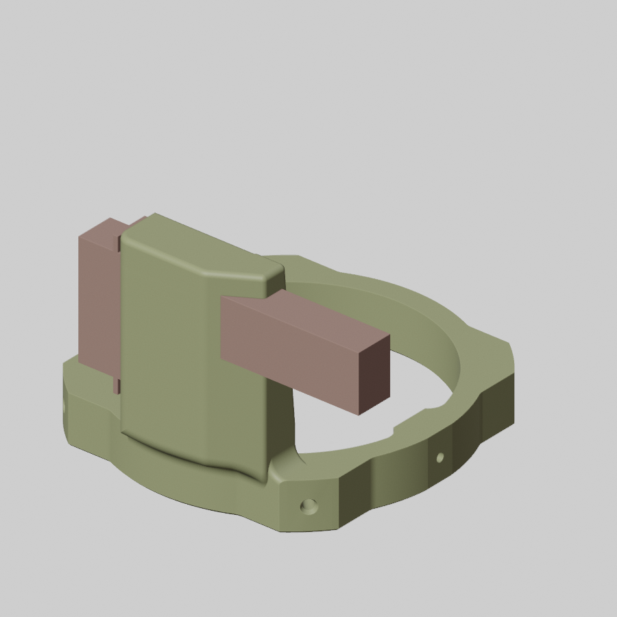
docs/img/cad/blender_outer_gimbal_dual_TVC.png
