Jan-Philipp-Munsch/kartonaut/docs/img/cad/blender_rocket_nose.png

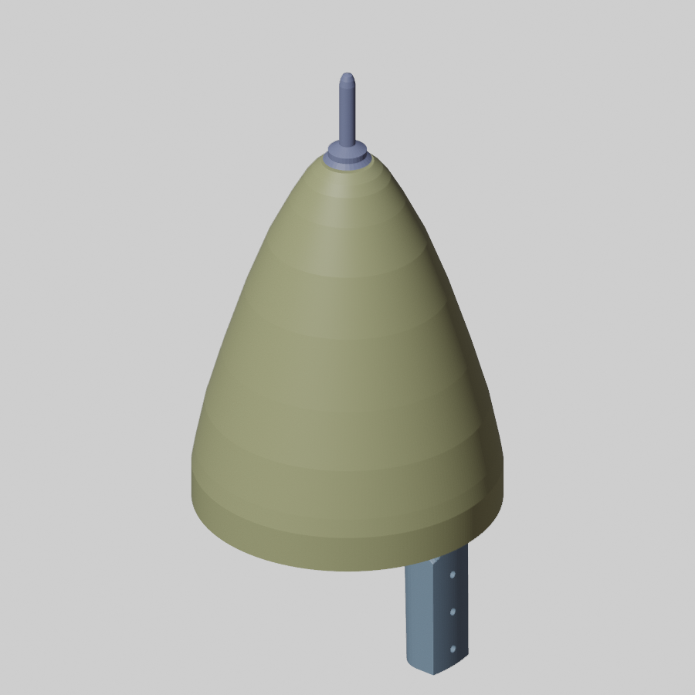
docs/img/cad/blender_rocket_nose.png
