Jan-Philipp-Munsch/kartonaut/docs/img/cad/blender_TVC.png

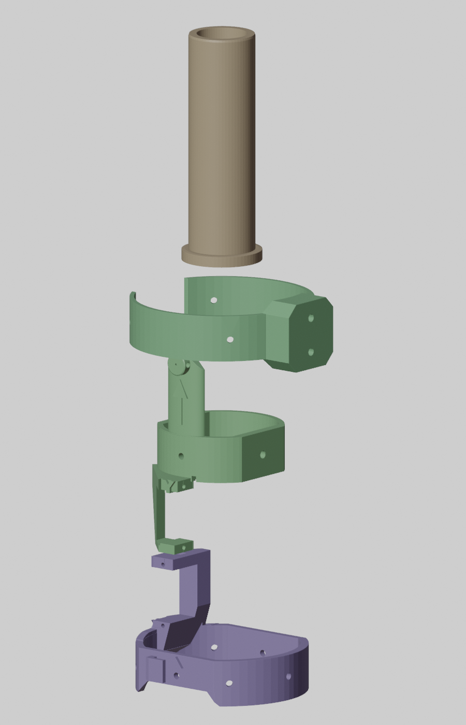
docs/img/cad/blender_TVC.png
