Jan-Philipp-Munsch/kartonaut/docs/img/cad/blender_TVC_V2.png

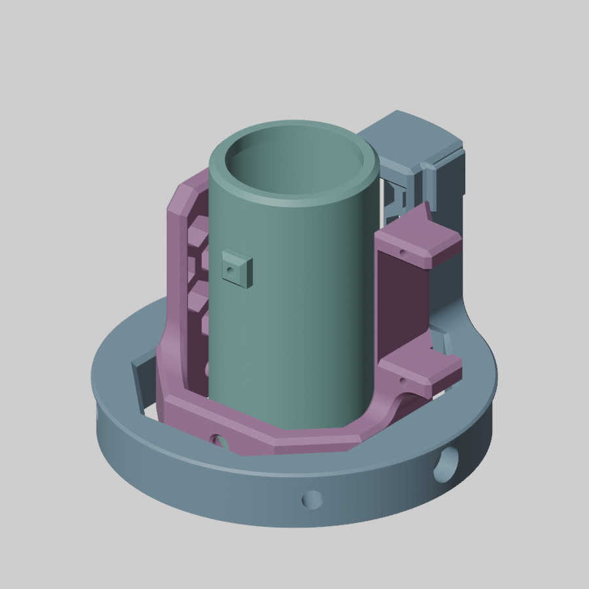
docs/img/cad/blender_TVC_V2.png
