Jan-Philipp-Munsch/kartonaut/docs/img/cad/hatches_b.png

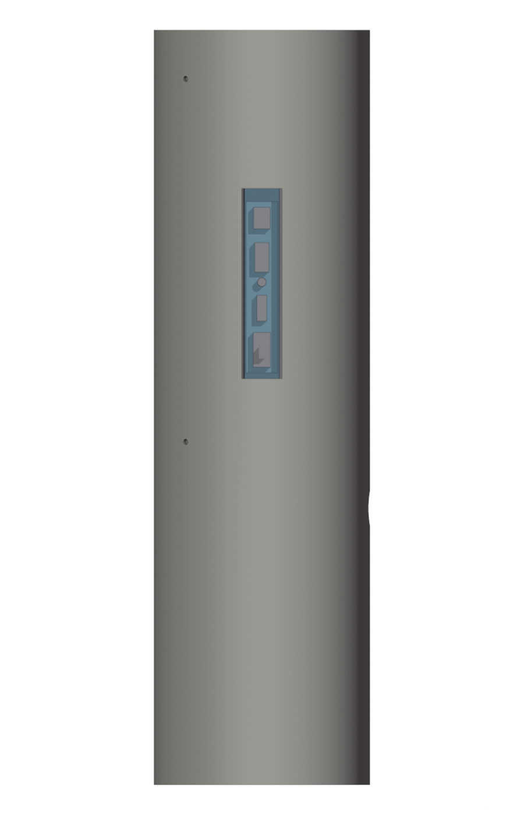
docs/img/cad/hatches_b.png
