Jan-Philipp-Munsch/kartonaut/docs/img/foto/flugcomputer_breakout.jpg

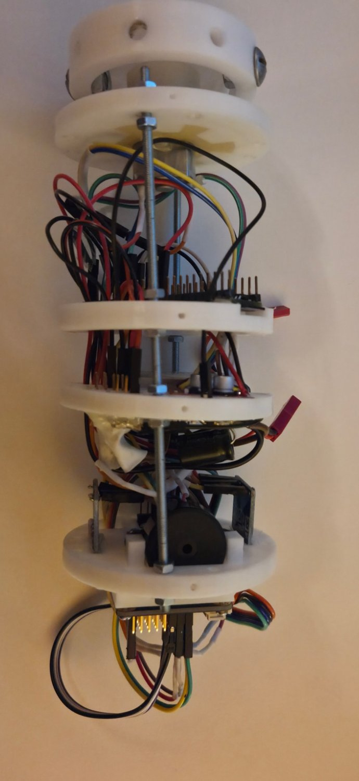
docs/img/foto/flugcomputer_breakout.jpg
