Jan-Philipp-Munsch/kartonaut/docs/img/model_rocket.png

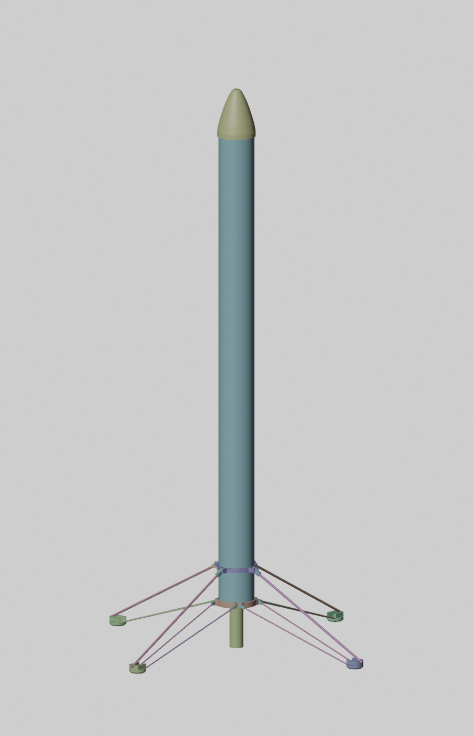
docs/img/model_rocket.png
