Jan-Philipp-Munsch/kartonaut/docs/img/sim/montecarlo_preload.png

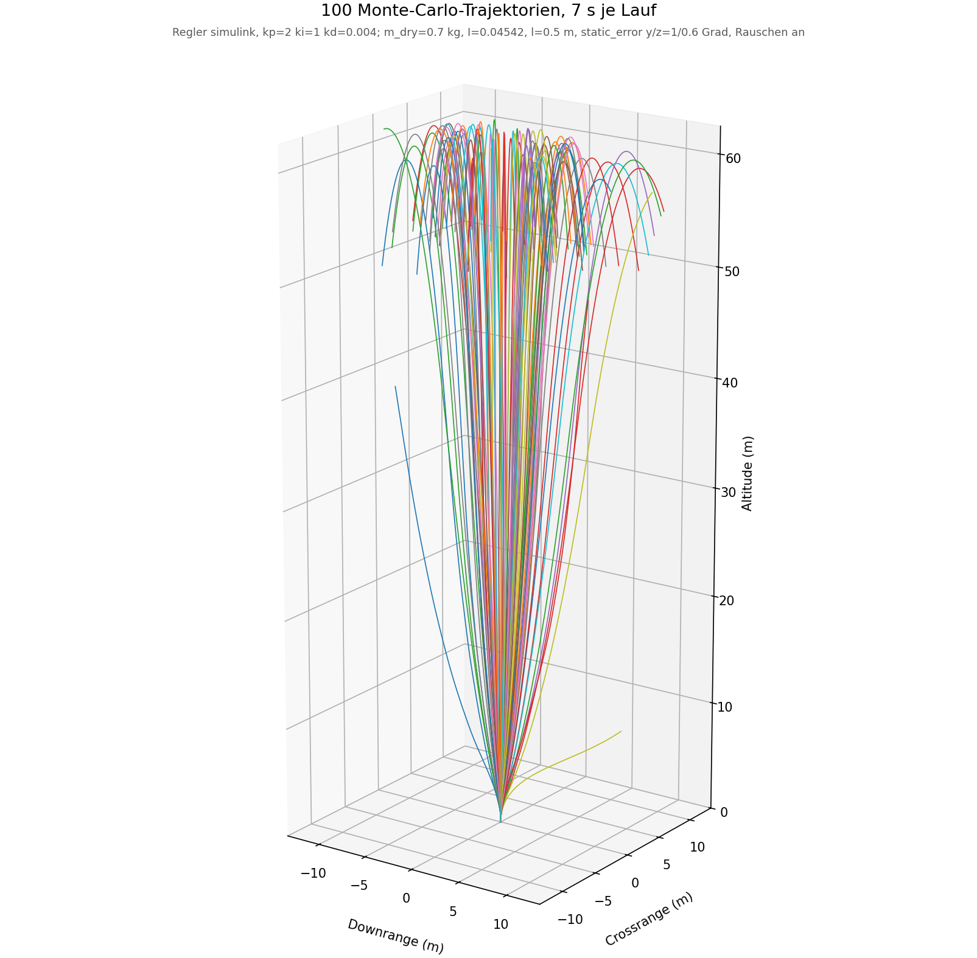
docs/img/sim/montecarlo_preload.png
