Jan-Philipp-Munsch/kartonaut/docs/img/sim/servo_fit.png

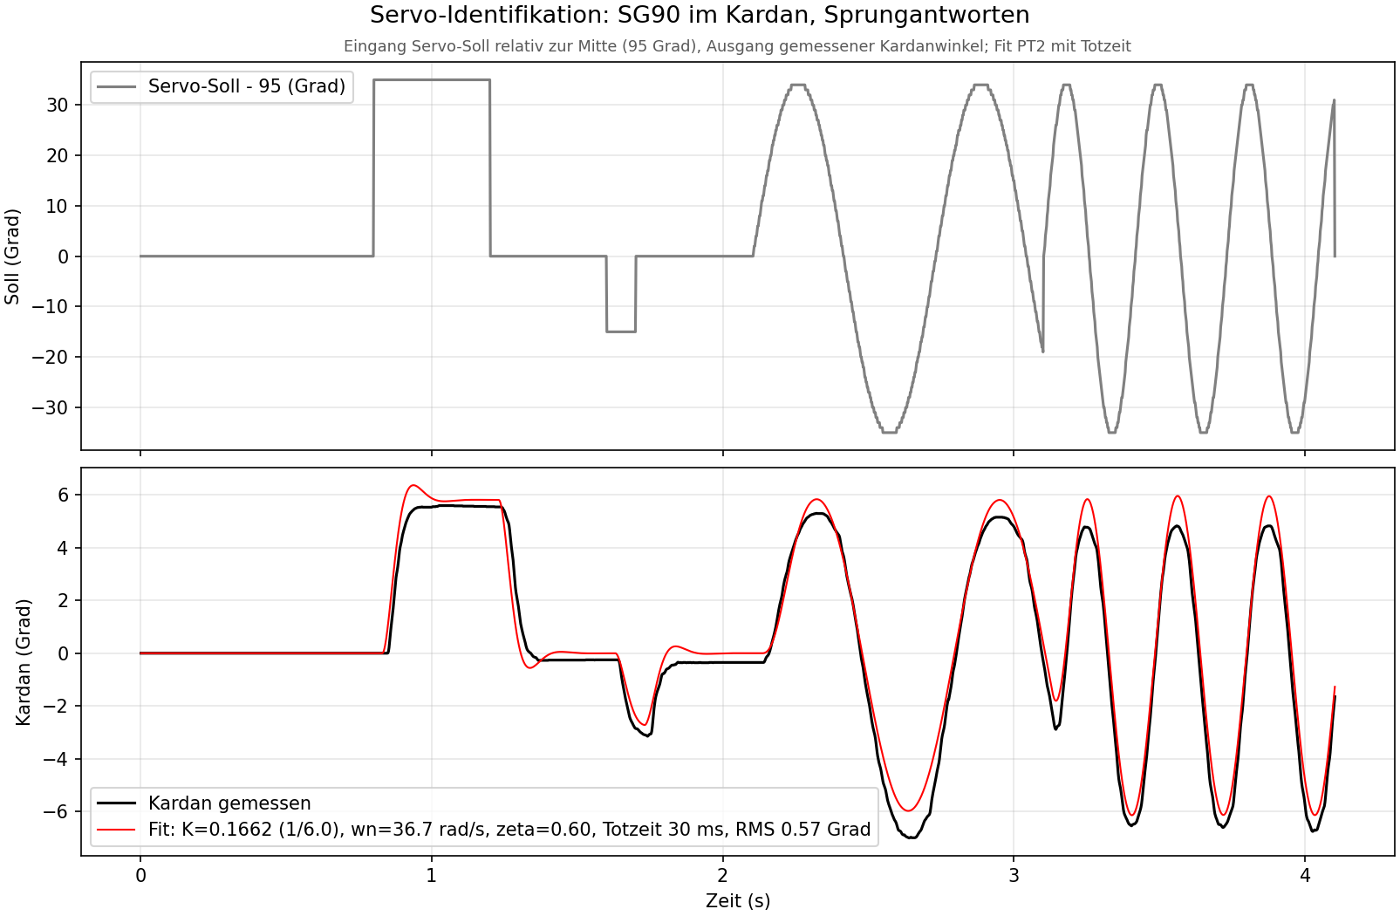
docs/img/sim/servo_fit.png
