Jan-Philipp-Munsch/kartonaut/hardware/mainboard/kicad/img/layer_B_Cu.png

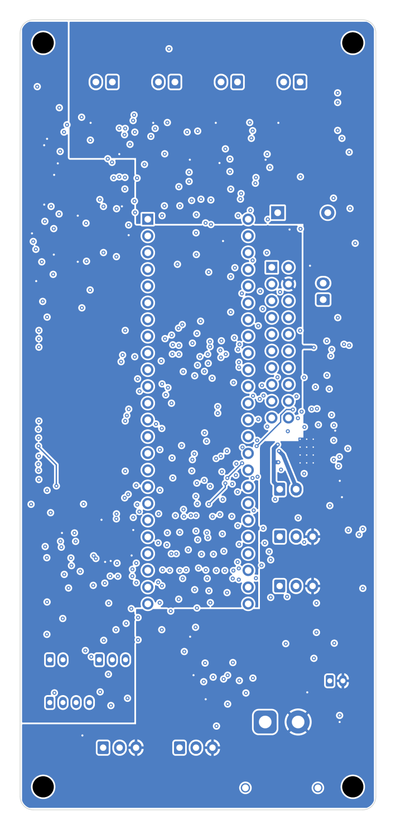
hardware/mainboard/kicad/img/layer_B_Cu.png
