Jan-Philipp-Munsch/kartonaut/hardware/mainboard/kicad/img/layer_Bestueckung.png

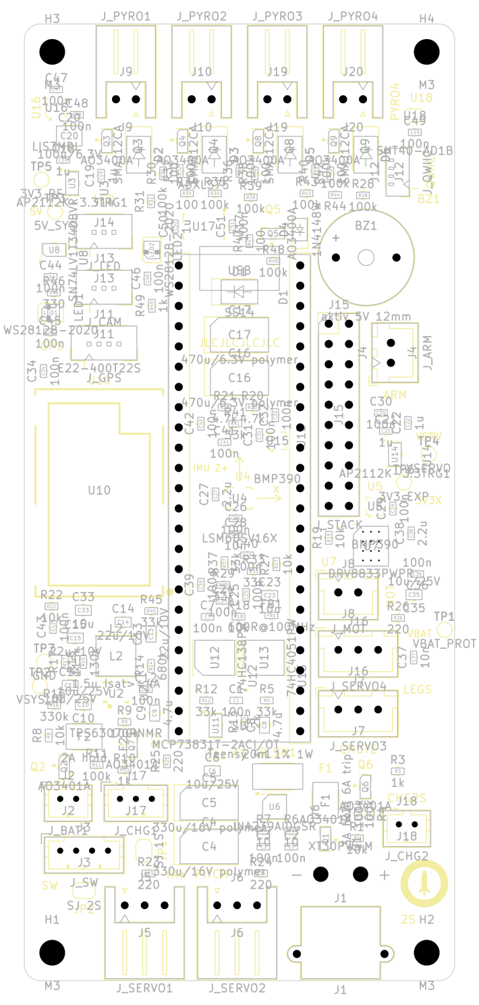
hardware/mainboard/kicad/img/layer_Bestueckung.png
