Jan-Philipp-Munsch/kartonaut/hardware/mainboard/kicad/img/layer_F_Cu.png

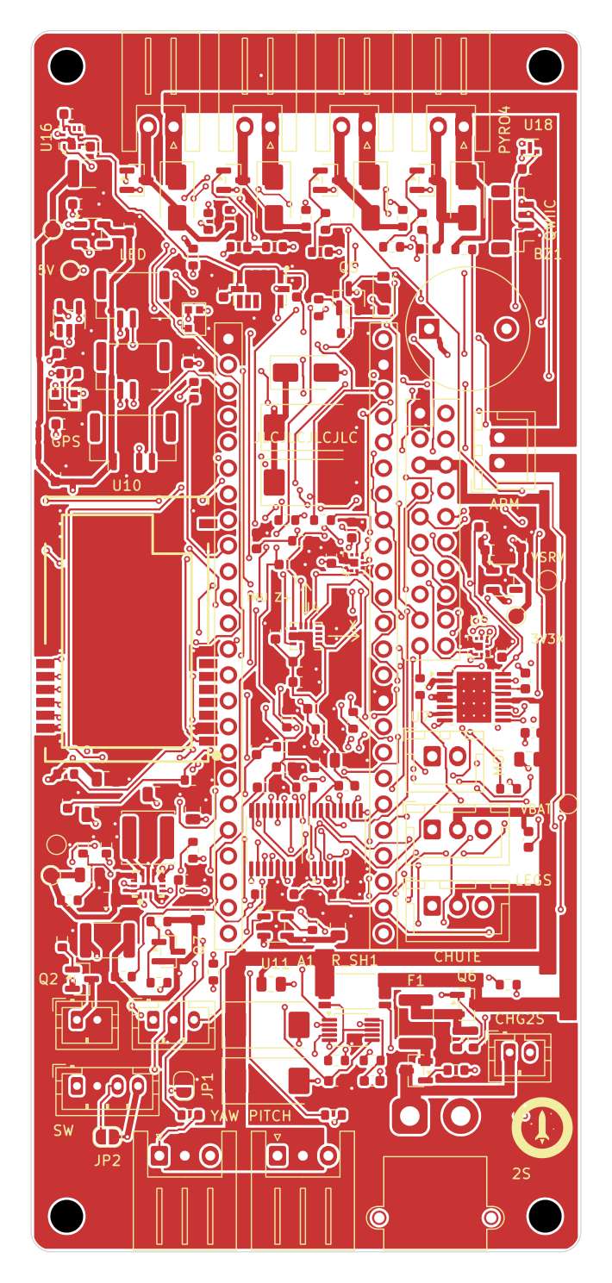
hardware/mainboard/kicad/img/layer_F_Cu.png
