Jan-Philipp-Munsch/kartonaut/hardware/mainboard/kicad/img/layer_In1_Cu.png

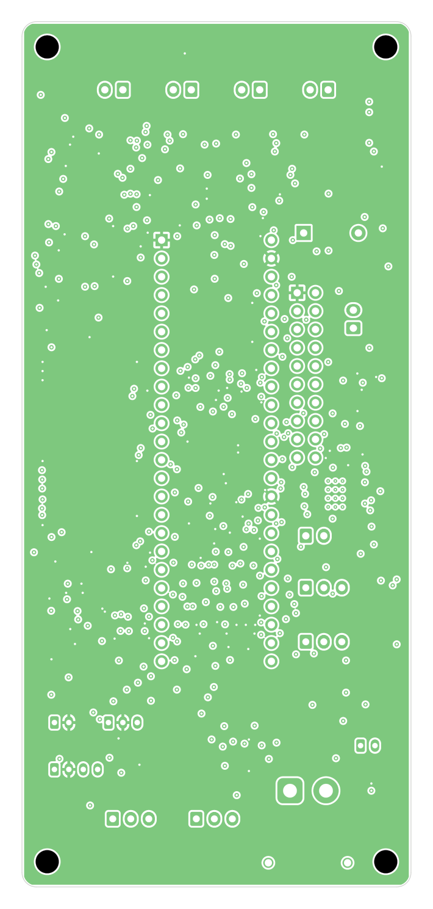
hardware/mainboard/kicad/img/layer_In1_Cu.png
