Jan-Philipp-Munsch/kartonaut/hardware/mainboard/kicad/img/layer_In2_Cu.png

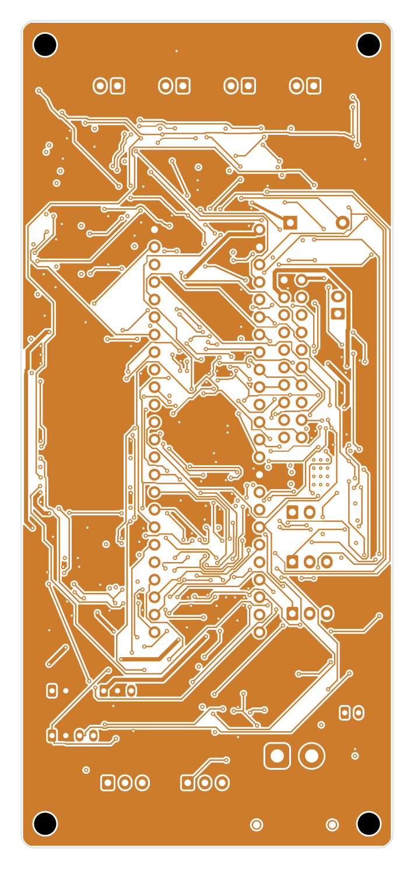
hardware/mainboard/kicad/img/layer_In2_Cu.png
