Jan-Philipp-Munsch/kartonaut/docs/Rohrmaterial_2026-10-22.md

# Körperrohr: Material und Masse (Recherche 22.10.2026)

Frage von Jan: Gibt es günstige Verbundmaterialien für den Raketenkörper, die leichter sind als das
Klima-Papprohr? Hintergrund: Befund 12 (`PROJECT.md`), der TSP E12 hebt 1 kg nur knapp
(Schub-Gewicht 1,1); das Papprohr mit 240 g/m ist der größte Einzelposten im Massenmodell.

## 1. Ergebnis in einem Satz

Fertige Verbundrohre mit 75 mm Außendurchmesser sind **schwerer und viel teurer** als das Klima-Rohr;
Gewicht spart nur ein selbst laminiertes Dünnwandrohr (ca. 100 bis 150 g/m, Aufwand) oder, ohne jeden
Aufwand, ein **kürzeres Rohr** und eine leichtere Erstflug-Konfiguration.

## 2. Was es zu kaufen gibt (75 mm außen)

| Material | Wand | Masse | Preis je m | Quelle | Bewertung |
|---|---|---|---|---|---|
| **Klima Papprohr** (Ist) | 1,2 mm (75 / 72,6) | **240 g/m** (120 g je 0,5 m) | 20 € (2 × 9,90 €) | [Klima](https://www.raketenmodellbau-klima.de/Raketenmodellbau/Zubehoer/Ersatz-Bauteile/Koerperrohre/Koerperrohr-75mm-500mm-lang.htm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), [SRT](https://www.spacerockettechnology-shop.de/en/Klima-body-tube-75mm---500mm.html) | Referenz; 0,86 g/cm³, für Pappe schon dünn |
| CFK Filament Winding 75 / 70 | 2,5 mm | 840 g/m | 213 € | [carbonrohr.net](https://carbonrohr.net/produit.php?cat=TEFC3) | 3,5-mal schwerer, Druckbehälter-Qualität, unbrauchbar |
| CFK Präzisionsrohr 75 / 70 | 2,5 mm | k. A. (ähnlich) | 250 € | [carbon-composite.com](https://www.carbon-composite.com/Carbon-Praezisionsrohr-Telescopic-Tube-OE-75mm-x-oe-70mm/TT075070-1-W) | wie oben |
| GFK Filament Winding 75 / 70 | 2,5 mm | 1080 g/m | ca. 110 € (0,11 €/mm) | [carbonscout](https://www.carbonscout-shop.de/GFK-Glasfaser-Rohr-Filament-Winding-75x70mm-geschliffen.html), [carbonrohr.net](https://carbonrohr.net/produit.php?cat=TFVD) | 4,5-mal schwerer |
| CFK ±45° gewickelt 76 / 69 | 3,5 mm | ca. 1270 g/m (204 g je 160 mm) | hoch | [carbonscout](https://www.carbonscout-shop.de/CFK-Carbon-Rohr-CG-UHP-TUBES-gewickelt-45-76x69x160mm-Wickeloberflaeche.html) | unbrauchbar |
| GFK Feuerwerks-Mörser 3" | 3 mm, 82 mm außen | ca. 4 kg/m | 15 € | [pyroweb](https://www.pyroweb.de/abschussrohr-gfk-kal-75/) | falscher Durchmesser, Gewicht |
| Blue Tube 2.0 / Phenol (USA) | 1,5 – 2 mm | ca. 570 g/m (Größe in der Quelle unklar) | Import | [rocketreviews](https://www.blog.rocketreviews.com/review-251125013805.html), [Vergleichstabelle](https://definityproject.atlassian.net/wiki/spaces/CPLC/pages/6095104) | schwerer als Klima, Zoll-Maße passen nicht zu den Kupplern |
| CFK / GFK mit 1 mm Wand | 1 mm | – | – | [carbonscout 1 mm](https://www.carbonscout-shop.de/Carbon-Made-in-Germany-Wickeltechnik-s-10.html), [carbon-composite 1 mm](https://www.carbon-composite.com/Produkte/Carbon-Rohre-rund/Sortiert-nach-Wandstaerke/Praezisionsrohre-1mm/) | **nicht in 75 mm lieferbar**, nur Sonderanfertigung (Wickelauftrag) |

Rechnung für ein 1-mm-CFK-Rohr, falls es jemand wickelt: Wandvolumen π · 74 · 1 mm² = 232 cm³/m,
bei 1,5 g/cm³ also **350 g/m**. Selbst die dünnste käufliche Wand ist schwerer als Pappe, weil die
Dichte von Verbund (1,5 bis 1,9 g/cm³) das Doppelte von Pappe ist und Wickelrohre nicht unter 1 mm gehen.

## 3. Selbst laminieren: die einzige Verbundlösung, die Gewicht spart

Ein Körperrohr muss nur Knickung, Flossenkräfte und den Ausstoßdruck aushalten; 0,3 bis 0,5 mm Laminat
genügen bei 75 mm (so sind die BPS-Rohre und die 29-mm-Carbonrohre der Modellbauer gebaut). Umfang
0,232 m, Harzanteil 50 % Gewicht:

| Aufbau | Flächengewicht trocken | Rohrmasse | Wand | Material je m |
|---|---|---|---|---|
| 2 × Glasgewebe 163 g/m² Köper | 326 g/m² | **ca. 150 g/m** | 0,35 mm | ca. 8 € |
| 1 × Carbon 200 g/m² + 1 × Glas 49 g/m² außen | 249 g/m² | **ca. 115 g/m** | 0,3 mm | ca. 15 € |
| 2 × Carbon 93 g/m² Köper | 186 g/m² | ca. 90 g/m | 0,25 mm | ca. 20 € |

Ersparnis gegenüber 240 g/m: **90 bis 125 g auf 1 m**. Dazu nötig: ein Kern mit 72,6 mm Außenmaß (damit
die Klima-Kuppler 72,4 mm weiter passen), zum Beispiel ein PVC- oder Alurohr auf Maß gedreht oder das
Klima-Rohr selbst mit Trennfolie als Kern, Epoxid (R&G L + Härter), Abreißgewebe, Schrumpfschlauch oder
Vakuum. Risiko: ein erster Versuch wird selten rund und glatt; Ovalität stört den Kolben-Ausstoß. Aufwand
ein Wochenende plus Trocknung.

## 4. Was mehr bringt als das Material

Massenmodell `cad/mass_properties.md`: Start 981 g. Hebel in der Reihenfolge ihres Ertrags:

1. **Landesystem weglassen für den Erstflug (−200 g).** Entschieden ist ein Erstflug nur mit Fallschirm
   (`PROJECT.md` Paket 16); dann gehören Beine und Landemotor nicht an Bord. 781 g, Schub-Gewicht 1,55.
2. **Rohr kürzen.** 1000 mm sind für Kardan (ca. 150 mm), Avionik-Kuppler (150 mm), Kolben und Fallschirm
   (ca. 200 mm) großzügig; 700 mm sparen 72 g Rohr und etwas Schnur. Prüfen im CAD (`cad/params.py`), ob
   der Fallschirmraum reicht.
3. **Platine statt Breakouts und 2S-Akku 450 statt 850 mAh** (zusammen ca. −40 bis −60 g).
4. **Rohr selbst laminieren (−90 bis −125 g),** erst wenn 1 bis 3 nicht reichen.

Ziel: **unter 750 g** Startmasse für den Erstflug (Schub-Gewicht ≥ 1,6, Gipfel laut Simulation
über 50 m). Die Pappe bleibt dafür die billigste und am schnellsten verfügbare Lösung.

Quellen allgemein: [MIT Rocketry Materialvergleich](https://wikis.mit.edu/confluence/x/sjr_Bg),
[Dichte GFK/CFK](https://www.boote-forum.de/showthread.php?t=216689),
[Klima Katalog Körperrohre](https://www.raketenmodellbau-klima.de/Raketenmodellbau/Zubehoer/Ersatz-Bauteile/Koerperrohre.htm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).
