Jan-Philipp-Munsch/kartonaut/hardware/mainboard/kicad/fab/mainboard_bom_jlc.csv

Comment | Designator | Footprint | LCSC Part #
100n | C1,C2,C3,C7,C12,C24,C25,C26,C29,C30,C34,C36,C39,C40,C41,C42,C43,C44,C45,C46,C47,C48,C49 | C_0603_1608Metric | C14663
330u/16V polymer | C4,C5 | CP_EIA-7343-31_Kemet-D
10u/25V | C6,C10,C11,C35 | C_0805_2012Metric | C15850
4.7u | C8,C9 | C_0805_2012Metric
22u/10V | C13,C14,C15 | C_0805_2012Metric | C45783
470u/6.3V polymer | C16,C17 | CP_EIA-7343-31_Kemet-D
1u | C18,C19,C21,C22 | C_0603_1608Metric | C15849
100u/6.3V | C20 | C_1210_3225Metric | C426103
10u | C23,C33 | C_0805_2012Metric | C15850
2.2u | C27,C38 | C_0603_1608Metric | C23630
10n | C28,C37 | C_0603_1608Metric | C57112
SS14 | D1 | D_SMA | C2480
SMAJ12CA | D2,D3 | D_SMA
1N4148W | D4 | D_SOD-123 | C81598
3A hold 6A trip | F1 | Fuse_1812_4532Metric | C883162
2A hold | F2 | Fuse_1812_4532Metric
600R@100MHz | FB1 | L_0603_1608Metric
J_GPS | J11 | JST_GH_BM04B-GHS-TBT_1x04-1MP_P1.25mm_Vertical | C161692
J_QWIIC | J12 | JST_SH_BM04B-SRSS-TB_1x04-1MP_P1.00mm_Vertical | C160390
J_CAM | J13 | JST_GH_BM03B-GHS-TBT_1x03-1MP_P1.25mm_Vertical | C161691
J_LED | J14 | JST_GH_BM03B-GHS-TBT_1x03-1MP_P1.25mm_Vertical | C161691
1.5u Isat>=4A | L2 | L_Changjiang_FNR5040S | C167955
AO3401A | Q1,Q2,Q6,Q7 | SOT-23 | C15127
AO3400A | Q3,Q4,Q5 | SOT-23 | C20917
10k | R1,R8,R18,R19,R22,R27 | R_0603_1608Metric | C25804
100k | R2,R4,R9,R11,R28,R31,R32,R35,R36,R39,R40,R43,R44,R48 | R_0603_1608Metric | C25803
1k | R3,R10,R49 | R_0603_1608Metric | C21190
33k | R5,R12,R29,R33,R37,R41,R45 | R_0603_1608Metric | C4216
10 | R6,R7 | R_0603_1608Metric
2k | R13 | R_0603_1608Metric
680k | R14 | R_0603_1608Metric | C25822
130k | R15 | R_0603_1608Metric | C22795
330k | R16 | R_0603_1608Metric | C23137
115k | R17 | R_0603_1608Metric
4.7k | R20,R21 | R_0603_1608Metric | C23162
220 | R23,R24,R25,R26 | R_0603_1608Metric | C22962
100 | R30,R34,R38,R42,R47 | R_0603_1608Metric | C22775
330 | R46 | R_0603_1608Metric | C23138
20m 1% 1W | R_SH1 | R_2512_Kelvin
TPS63070RNMR | U2 | VQFN-15_L3.0-W2.5-P0.50-BL | C109322
AP2112K-3.3TRG1 | U3,U14 | SOT-23-5 | C51118
LSM6DSV16X | U4 | LGA-14_L3.0-W2.5-P0.50-TL | C5267406
BMP390 | U5 | LGA-10_L2.0-W2.0-P0.50-BL | C5124834
INA239AIDGSR | U6 | MSOP-10_3x3mm_P0.5mm
DRV8833PWPR | U7 | HTSSOP-16-1EP_4.4x5mm_P0.65mm_EP3.4x5mm_Mask2.46x2.31mm_ThermalVias | C50506
SN74LV1T34DBVR | U8 | SOT-23-5 | C100024
MCP73831T-2ACI/OT | U11 | SOT-23-5 | C424093
74HC138PW | U12 | TSSOP-16_4.4x5mm_P0.65mm
74HC4051PW | U13 | TSSOP-16_4.4x5mm_P0.65mm
LIS3MDL | U16 | LGA-12_L2.0-W2.0-P0.50-BL | C478483
SHT40-AD1B | U18 | DFN-4_L1.5-W1.5-P0.8-TL-EP | C2848306
