Jan-Philipp-Munsch/kartonaut/hardware/mainboard/datasheet/bom_summary.tex

\newcommand{\bomParts}{134}
\newcommand{\bomLines}{110}
\newcommand{\bomNets}{89}
