Jan-Philipp-Munsch/kartonaut/hardware/mainboard/mainboard_outline.dxf

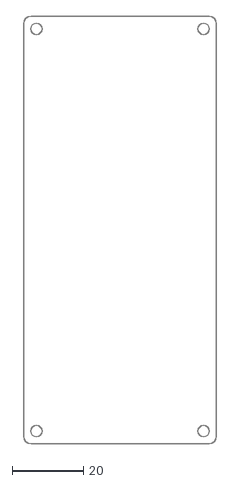
[picture p53: CAD file, 2026-10-20]
hardware/mainboard/mainboard_outline.dxf
54.0 x 120.0
