Jan-Philipp-Munsch/kartonaut/cad/export/asbuilt/MotorTube.003.stl

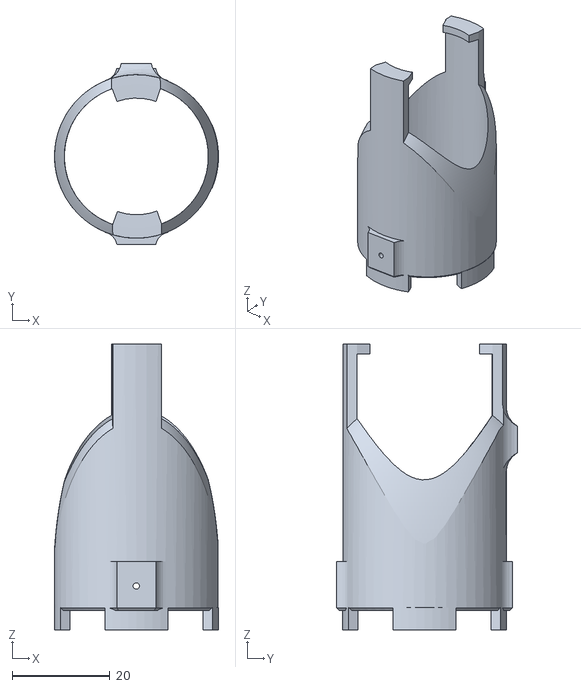
[picture p54: CAD file, 2026-10-26]
cad/export/asbuilt/MotorTube.003.stl
33.6 x 37.0 x 58.6
