Jan-Philipp-Munsch/kartonaut/cad/export/groundbridge/Funkbruecke_Unterteil.stl

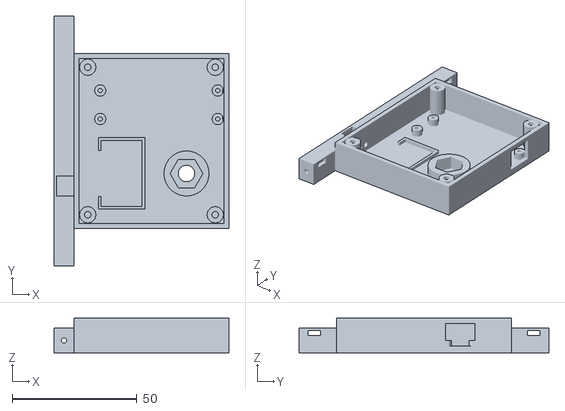
[picture p55: CAD file, 2026-10-27]
cad/export/groundbridge/Funkbruecke_Unterteil.stl
70.0 x 100.0 x 14.0
