Jan-Philipp-Munsch/kartonaut/cad/export/landingpad.step

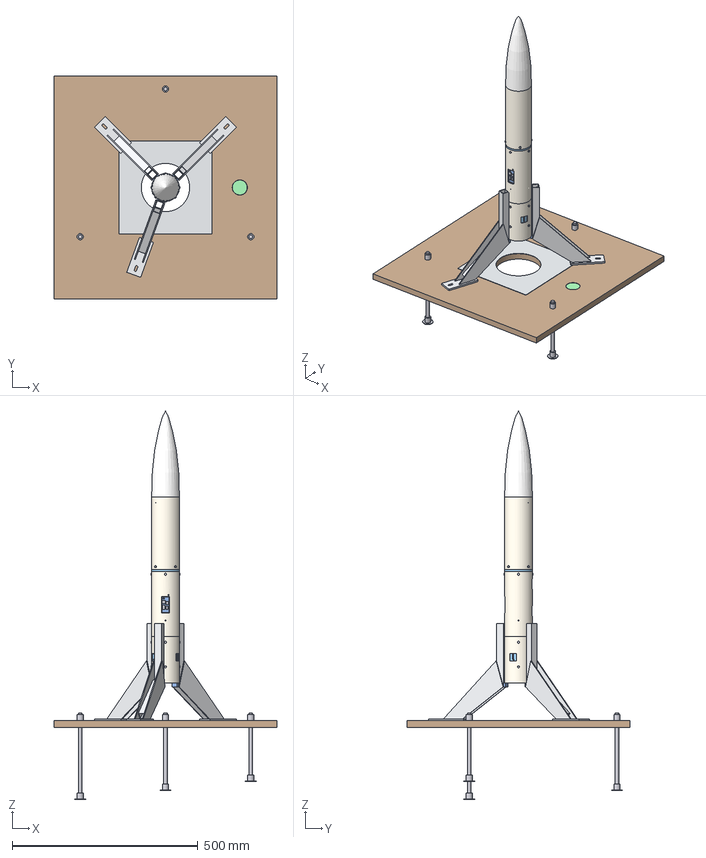
[picture p56: CAD file, 2026-10-27]
cad/export/landingpad.step
600.0 x 600.0 x 1044.1 mm
pad_000_Platte Siebdruck 600x600x18
pad_001_Stahlblech 250x250x1
pad_002_Dosenlibelle
pad_003_Bein 1 Gewindestange M10
pad_004_Bein 1 Muttern und Scheibe
pad_005_Bein 2 Gewindestange M10
pad_006_Bein 2 Muttern und Scheibe
pad_007_Bein 3 Gewindestange M10
pad_008_Bein 3 Muttern und Scheibe
pad_009_StÃ¼tze 45Â° FuÃplatte Alu 40x5
pad_010_StÃ¼tze 45Â° FÃ¼hrung Alu 20x20
pad_011_StÃ¼tze 45Â° Auflage
pad_012_StÃ¼tze 45Â° Strebe Alu 20x20
pad_013_StÃ¼tze 45Â° Knotenbleche Alu 3
pad_014_StÃ¼tze 135Â° FuÃplatte Alu 40x5
pad_015_StÃ¼tze 135Â° FÃ¼hrung Alu 20x20
pad_016_StÃ¼tze 135Â° Auflage
pad_017_StÃ¼tze 135Â° Strebe Alu 20x20
pad_018_StÃ¼tze 135Â° Knotenbleche Alu 3
pad_019_StÃ¼tze 250Â° FuÃplatte Alu 40x5
pad_020_StÃ¼tze 250Â° FÃ¼hrung Alu 20x20
pad_021_StÃ¼tze 250Â° Auflage
pad_022_StÃ¼tze 250Â° Strebe Alu 20x20
pad_023_StÃ¼tze 250Â° Knotenbleche Alu 3
rumpf_024_Rohr A 125 (Kardan, gebaut)
rumpf_025_Rohr B 176 (Avionik)
rumpf_026_Rohr C (Bergung)
rumpf_027_Kuppler J1 75 (in B verklebt)
rumpf_028_Schraubring J1
antrieb_029_Kardan (gebaut, HÃ¼llkÃ¶rper)
antrieb_030_Motor TSP E12-0
antrieb_031_Servo W5652H AuÃenrahmen (treibt Innenrahmen) (schematisch)
antrieb_032_Servohebel W5652H AuÃenrahmen (treibt Innenrahmen) (schematisch)
antrieb_033_DrahtbÃ¼gel W5652H AuÃenrahmen (treibt Innenrahmen) (schematisch)
antrieb_034_Servo W5652H Innenrahmen (treibt Motorrohr) (schematisch)
antrieb_035_Servohebel W5652H Innenrahmen (treibt Motorrohr) (schematisch)
antrieb_036_DrahtbÃ¼gel W5652H Innenrahmen (treibt Motorrohr) (schematisch)
avionik_037_Schlitten mit Spant
avionik_038_Untere Scheibe
avionik_039_Schalterbrett
avionik_040_Hauptschalter 2-polig (J_SW)
avionik_041_USB-C Laden 1S (J_CHG1)
avionik_042_Lade-LED
avionik_043_XT30 Laden 2S (J_CHG2)
avionik_044_XH-3 Balancer 2S
avionik_045_Platine rev B1
avionik_046_Teensy 4.1
avionik_047_Stecker Servo Gieren J5
avionik_048_Stecker Servo Nicken J6
avionik_049_Stecker XT30 2S J1
avionik_050_Akku 2S
avionik_051_Akku 1S
avionik_052_GPS-Modul (Patch nach oben)
avionik_053_LoRa-Wendel 433 MHz
bergung_054_COâ-Modul (Kapsel quer, Servo-AuslÃ¶sung)
bergung_055_Fallschirm (gepackt 100 Ã Ã 70)
spitze_056_Spitze Schulter (Klima)
spitze_057_Spitze Holzplatte mit Haken (Klima)
spitze_058_Spitze Klima 8539
rumpf_059_Schraubenkopf M3 0Â° z 44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
