Jan-Philipp-Munsch/kartonaut/cad/export/modular/Schlitten_mit_Spant.stl

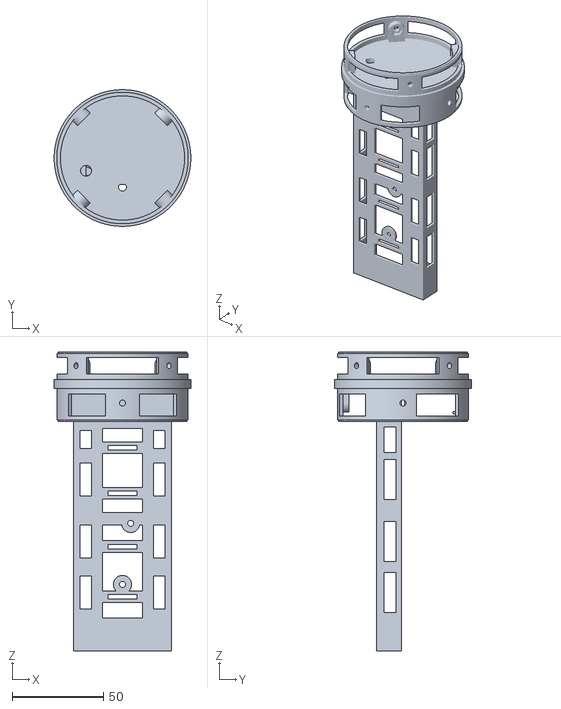
[picture p57: CAD file, 2026-10-27]
cad/export/modular/Schlitten_mit_Spant.stl
75.0 x 75.0 x 164.0
