Jan-Philipp-Munsch/kartonaut/cad/export/testrig/Prop_Adapter.stl

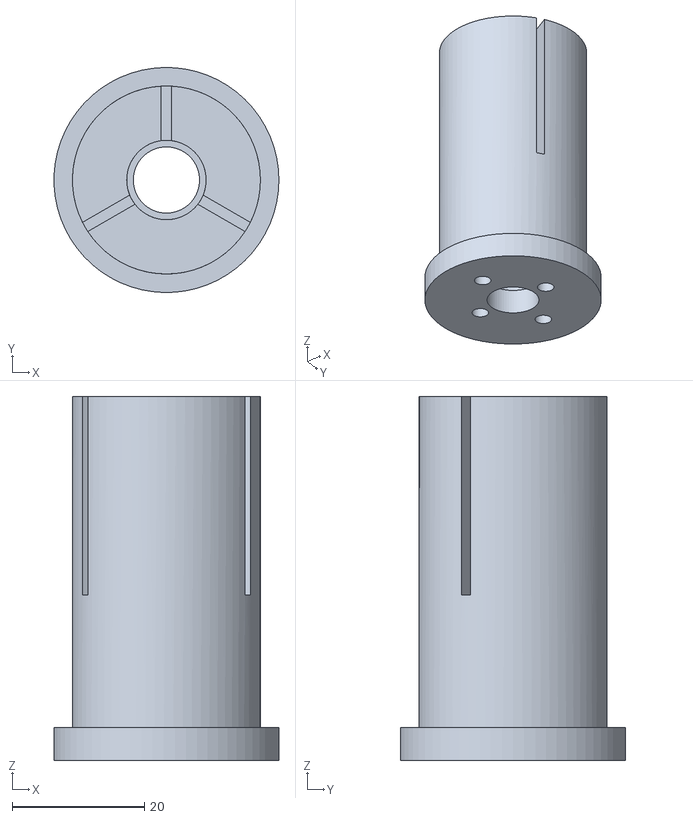
[picture p58: CAD file, 2026-10-27]
cad/export/testrig/Prop_Adapter.stl
34.0 x 34.0 x 55.0
