Jan-Philipp-Munsch/kartonaut/cad/export/modular/Kartonaut1_Stand2b.step

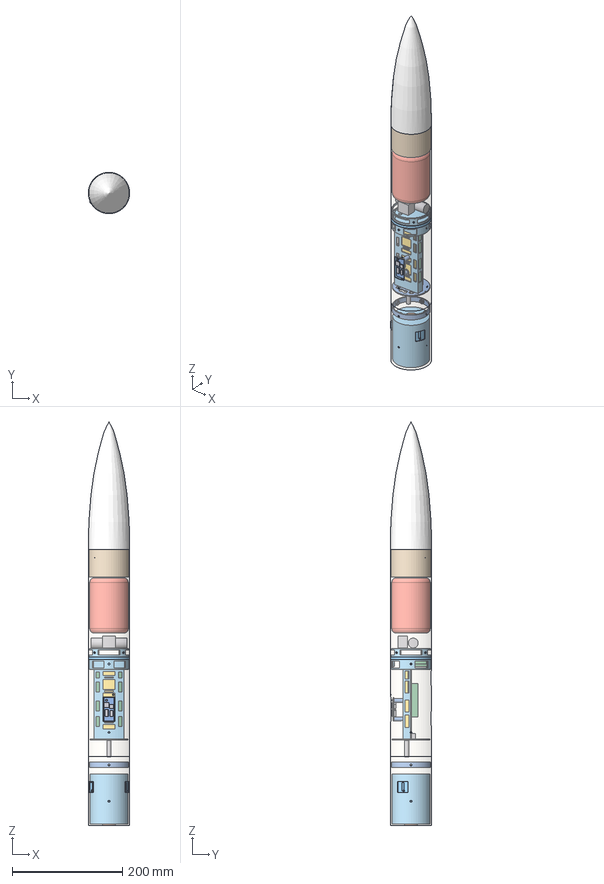
[picture p59: CAD file, 2026-10-27]
cad/export/modular/Kartonaut1_Stand2b.step
75.0 x 75.0 x 731.0 mm
00 Rohr A 125 (Kardan, gebaut)
01 Rohr B 176 (Avionik)
02 Rohr C (Bergung)
03 Kuppler J1 75 (in B verklebt)
04 Schraubring J1
05 Kardan (gebaut, HÃ¼llkÃ¶rper)
06 Motor TSP E12-0
07 Servo W5652H AuÃenrahmen (treibt Innenrahmen) (schematisch)
08 Servohebel W5652H AuÃenrahmen (treibt Innenrahmen) (schematisch)
09 DrahtbÃ¼gel W5652H AuÃenrahmen (treibt Innenrahmen) (schematisch)
10 Servo W5652H Innenrahmen (treibt Motorrohr) (schematisch)
11 Servohebel W5652H Innenrahmen (treibt Motorrohr) (schematisch)
12 DrahtbÃ¼gel W5652H Innenrahmen (treibt Motorrohr) (schematisch)
13 Schlitten mit Spant
14 Untere Scheibe
15 Schalterbrett
16 Hauptschalter 2-polig (J_SW)
17 USB-C Laden 1S (J_CHG1)
18 Lade-LED
19 XT30 Laden 2S (J_CHG2)
20 XH-3 Balancer 2S
21 Platine rev B1
22 Teensy 4.1
23 Stecker Servo Gieren J5
24 Stecker Servo Nicken J6
25 Stecker XT30 2S J1
26 Akku 2S
27 Akku 1S
28 GPS-Modul (Patch nach oben)
29 LoRa-Wendel 433 MHz
30 COâ-Modul (Kapsel quer, Servo-AuslÃ¶sung)
31 Fallschirm (gepackt 100 Ã Ã 70)
32 Spitze Schulter (Klima)
33 Spitze Holzplatte mit Haken (Klima)
34 Spitze Klima 8539
