Jan-Philipp-Munsch/kartonaut/cad/export/rocket_erstflug.step

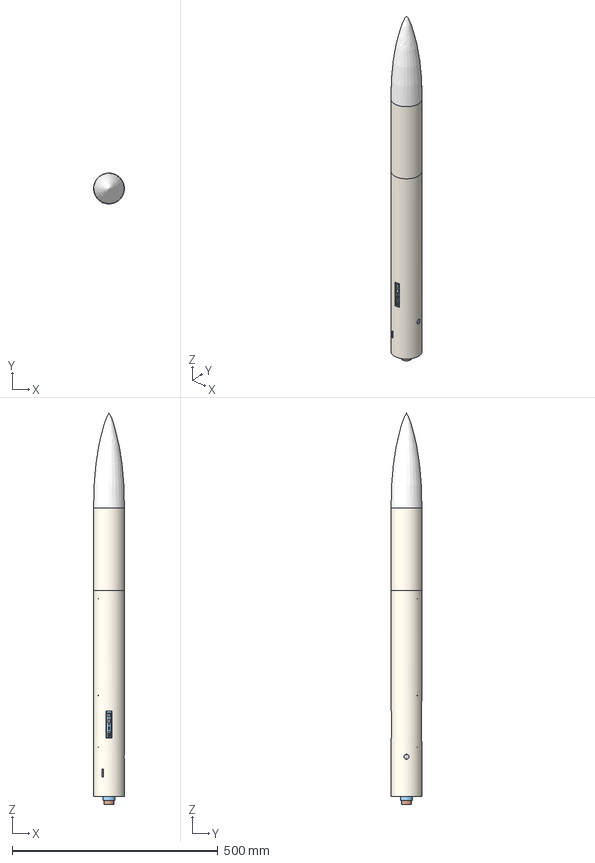
[picture p60: CAD file, 2026-10-22]
cad/export/rocket_erstflug.step
74.9 x 75.0 x 950.0 mm
airframe_000_Rohr unten 75x500
airframe_001_StoÃkuppler (im oberen Rohr verklebt)
airframe_002_Rohr oben 75x500 (mit Luke)
nose_003_Spitze Schulterkuppler
nose_004_Spitze Spant mit Ãse
nose_005_Spitze Klima 8539
tvc_006_AuÃenrahmen
tvc_007_Servo AuÃenrahmen W5652H
tvc_008_Motorrohr
tvc_009_Servohebel innen
tvc_010_Adapter 29â24
tvc_011_Motor TSP E12-0
tvc_012_Innenrahmen
tvc_013_Servo Innenrahmen W5652H
tvc_014_Servohebel auÃen
avionics_015_Kuppler Flugcomputer 150
avionics_016_Endring unten
avionics_017_Endplatte oben (Spant, Ladungsschale)
avionics_018_Gewindestange M2 1
avionics_019_Gewindestange M2 2
avionics_020_Gewindestange M2 3
avionics_021_Gewindestange M2 4
avionics_022_Gewindestange M2 5
avionics_023_Gewindestange M2 6
avionics_024_Gewindestange M2 7
avionics_025_Gewindestange M2 8
avionics_026_TrÃ¤ger (gedruckt)
avionics_027_Platine 54x120
avionics_028_Teensy 4.1
avionics_029_Akku 2S
avionics_030_Akku 1S
avionics_031_Schalterbrett (Luke B)
avionics_032_Schiebeschalter 2-polig
avionics_033_USB-C-Buchse
avionics_034_Lade-LED
avionics_035_XT30-Buchse (2S Laden)
avionics_036_XH-3-Buchse (Balancer)
avionics_037_SchlÃ¼sselschalter-Kragen
avionics_038_SchlÃ¼sselschalter
recovery_039_Kolben (Kuppler-StÃ¼ck mit Platte)
recovery_040_Fallschirm 125 cm (gepackt, Platzhalter)
