Jan-Philipp-Munsch/kartonaut/cad/export/testrig/Klemmkragen_Haelfte_LukeB.stl

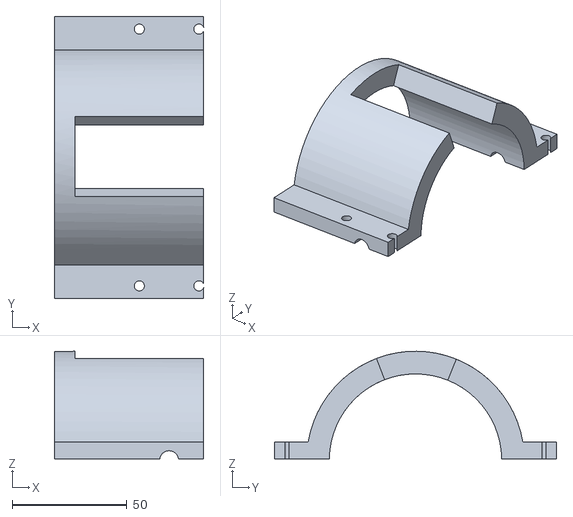
[picture p61: CAD file, 2026-10-27]
cad/export/testrig/Klemmkragen_Haelfte_LukeB.stl
65.0 x 123.0 x 46.9
