Jan-Philipp-Munsch/kartonaut/cad/export/modular/Untere_Scheibe.stl

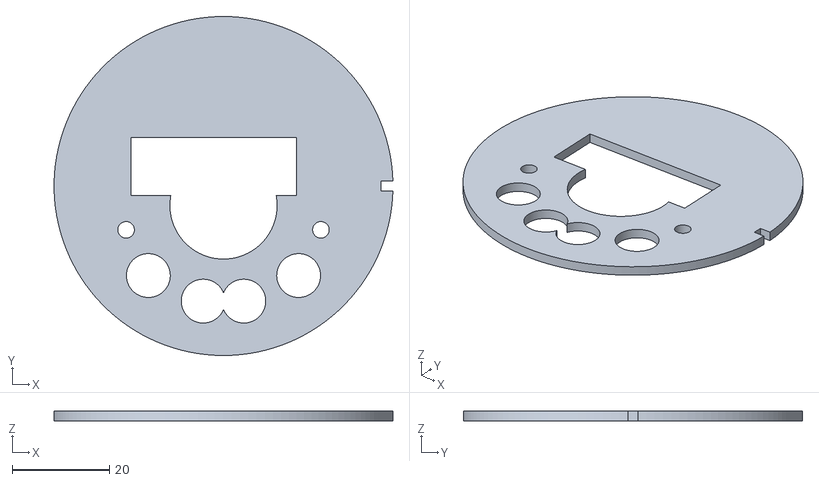
[picture p62: CAD file, 2026-10-26]
cad/export/modular/Untere_Scheibe.stl
69.6 x 69.6 x 2.00
