Jan-Philipp-Munsch/kartonaut/cad/export/rocket.step

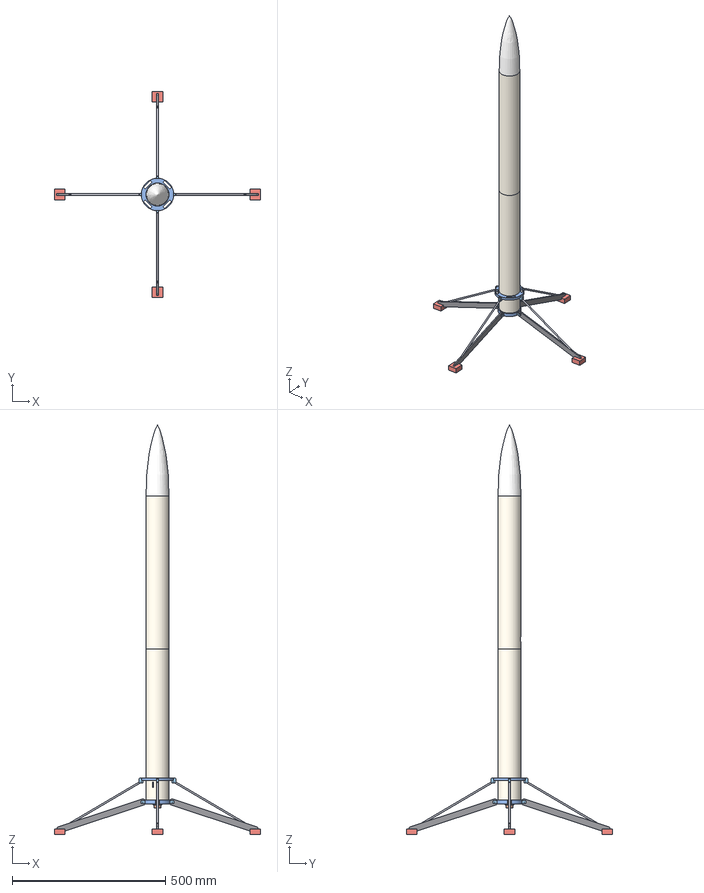
[picture p63: CAD file, 2026-10-22]
cad/export/rocket.step
674.1 x 674.1 x 1335.8 mm
airframe_000_Rohr unten 75x500
airframe_001_Rohr oben 75x500 (mit Luke)
nose_002_Spitze Schulterkuppler
nose_003_Spitze Spant mit Ãse
nose_004_Spitze Klima 8539
tvc_005_AuÃenrahmen
tvc_006_Servo AuÃenrahmen W5652H
tvc_007_Motorrohr
tvc_008_Servohebel innen
tvc_009_Adapter 29â24
tvc_010_Motor TSP E12-0
tvc_011_Innenrahmen
tvc_012_Servo Innenrahmen W5652H
tvc_013_Servohebel auÃen
avionics_014_Kuppler Flugcomputer 150
avionics_015_Endring unten
avionics_016_Endplatte oben (Spant, Ladungsschale)
avionics_017_Gewindestange M2 1
avionics_018_Gewindestange M2 2
avionics_019_Gewindestange M2 3
avionics_020_Gewindestange M2 4
avionics_021_Gewindestange M2 5
avionics_022_Gewindestange M2 6
avionics_023_Gewindestange M2 7
avionics_024_Gewindestange M2 8
avionics_025_TrÃ¤ger (gedruckt)
avionics_026_Platine 54x120
avionics_027_Teensy 4.1
avionics_028_Akku 2S
avionics_029_Akku 1S
recovery_030_Kolben (Kuppler-StÃ¼ck mit Platte)
recovery_031_Fallschirm 125 cm (gepackt, Platzhalter)
legs_032_Beinring unten (HÃ¼lse)
legs_033_Beinring oben
legs_034_Bein 1 Hauptstrebe
legs_035_Bein 1 obere Strebe
legs_036_Bein 1 FuÃ
legs_037_Bein 1 Gelenk unten
legs_038_Bein 1 Gelenkbock oben
legs_039_Bein 2 Hauptstrebe
legs_040_Bein 2 obere Strebe
legs_041_Bein 2 FuÃ
legs_042_Bein 2 Gelenk unten
legs_043_Bein 2 Gelenkbock oben
legs_044_Bein 3 Hauptstrebe
legs_045_Bein 3 obere Strebe
legs_046_Bein 3 FuÃ
legs_047_Bein 3 Gelenk unten
legs_048_Bein 3 Gelenkbock oben
legs_049_Bein 4 Hauptstrebe
legs_050_Bein 4 obere Strebe
legs_051_Bein 4 FuÃ
legs_052_Bein 4 Gelenk unten
legs_053_Bein 4 Gelenkbock oben
