Jan-Philipp-Munsch/kartonaut/cad/export/testrig.step

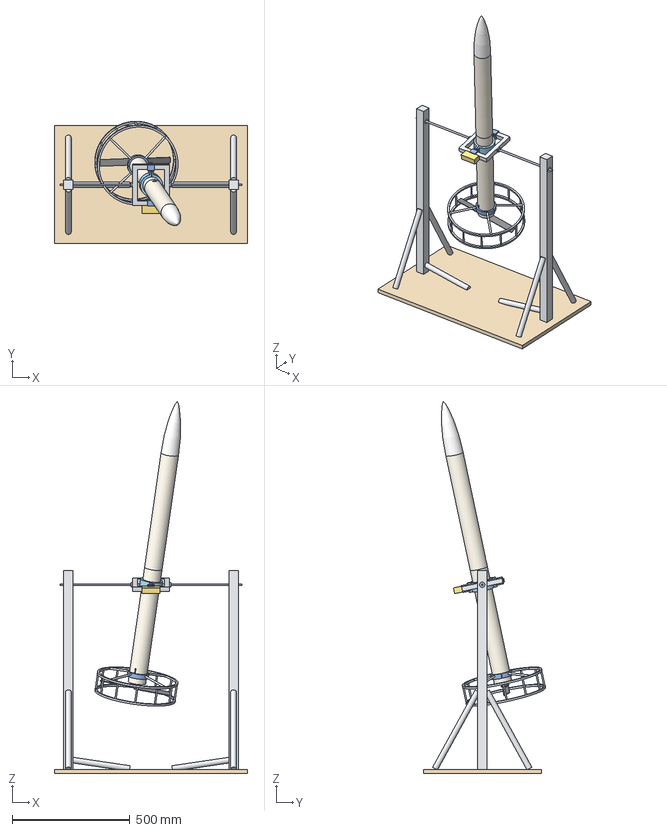
[picture p65: CAD file, 2026-10-22]
cad/export/testrig.step
820.0 x 518.8 x 1576.8 mm
airframe_000_Rohr unten 75x500
airframe_001_Rohr oben 75x500 (mit Luke)
nose_002_Spitze Schulterkuppler
nose_003_Spitze Spant mit Ãse
nose_004_Spitze Klima 8539
tvc_005_AuÃenrahmen
tvc_006_Servo AuÃenrahmen W5652H
tvc_007_Motorrohr
tvc_008_Servohebel innen
tvc_009_Prop-Adapter 29 mm (gedruckt)
tvc_010_Motor BR2814
tvc_011_Propeller 12x6
tvc_012_Innenrahmen
tvc_013_Servo Innenrahmen W5652H
tvc_014_Servohebel auÃen
avionics_015_Kuppler Flugcomputer 150
avionics_016_Endring unten
avionics_017_Endplatte oben (Spant, Ladungsschale)
avionics_018_Gewindestange M2 1
avionics_019_Gewindestange M2 2
avionics_020_Gewindestange M2 3
avionics_021_Gewindestange M2 4
avionics_022_Gewindestange M2 5
avionics_023_Gewindestange M2 6
avionics_024_Gewindestange M2 7
avionics_025_Gewindestange M2 8
avionics_026_TrÃ¤ger (gedruckt)
avionics_027_Platine 54x120
avionics_028_Teensy 4.1
avionics_029_Akku 2S
avionics_030_Akku 1S
recovery_031_Kolben (Kuppler-StÃ¼ck mit Platte)
recovery_032_Fallschirm 125 cm (gepackt, Platzhalter)
testrig_033_Propellerschutz KÃ¤fig
testrig_034_Propellerschutz Klemmring
testrig_035_Klemmkragen (gedruckt, 2-teilig)
testrig_036_Zapfen Ã 8
testrig_037_Rahmen 20x20
testrig_038_Lagerbock ây
testrig_039_Lager 608 Rahmen ây
testrig_040_Lagerbock +y
testrig_041_Lager 608 Rahmen +y
testrig_042_ESC + Akku 4S
testrig_043_Grundplatte Sperrholz
testrig_044_StÃ¼tze links 40x40
testrig_045_Strebe links 1
testrig_046_Strebe links 2
testrig_047_Strebe links 3
testrig_048_Lager 608 StÃ¼tze links
testrig_049_StÃ¼tze rechts 40x40
testrig_050_Strebe rechts 1
testrig_051_Strebe rechts 2
testrig_052_Strebe rechts 3
testrig_053_Lager 608 StÃ¼tze rechts
testrig_054_Achsstummel Ã 8 links
testrig_055_Achsstummel Ã 8 rechts
