Jan-Philipp-Munsch/kartonaut/docs/bauanleitung/Bohrschablonen_1zu1.pdf

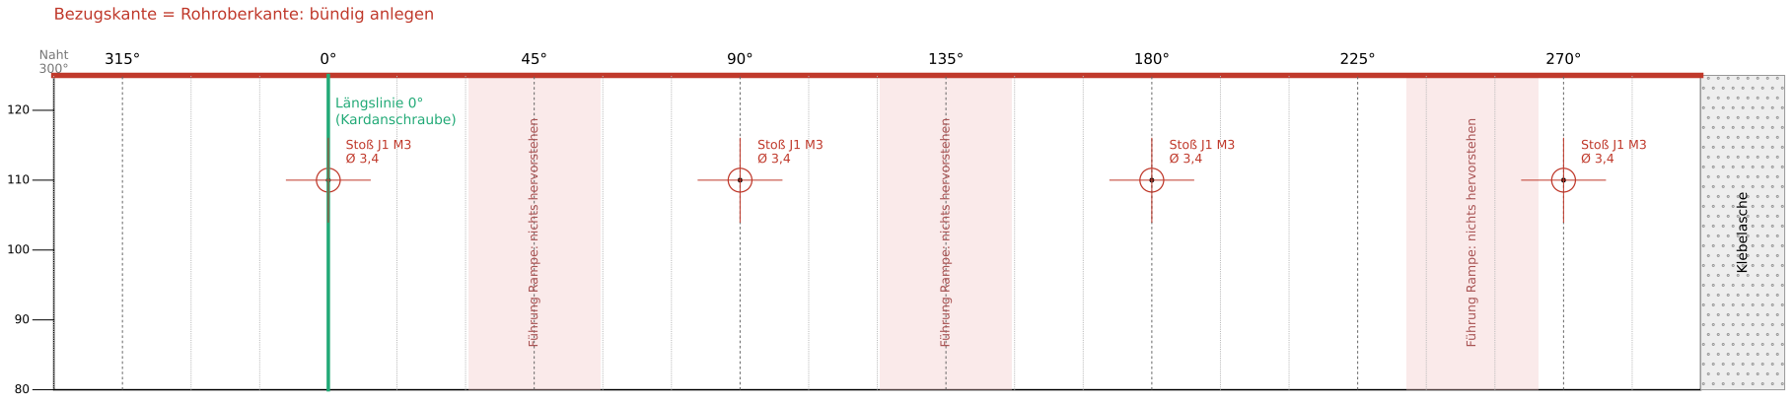
[picture p79: figure]
Klebelasche; Bezugskante = Rohroberkante: bündig anlegen; 270° Naht; Längslinie 0° (Kardanschraube); Führung Rampe: nichts hervorstehen; Stoß J1 M3 Ø 3,4

Prüfmaß 100 mm: nach dem Druck nachmessen | S1 Rohr A, Oberkante (Stoß J1)
| A4 quer drucken, Tatsächliche Größe / 100 % , nicht An Seite anpassen . Umfang 235,6 mm.

Zuerst den Kuppler J1 in Rohr B kleben und Rohr A aufstecken. Streifen um Rohr A, rote Kante an die Oberkante von A (Stoß), grüne Linie auf die Kardanschraube 0°. Die 4 Löcher T1 Ø 3,4 durch Rohr A und Kuppler bohren. Danach den Schraubring (Muttern innen eingedrückt) in den Kuppler schieben, mit M3 durch die Löcher ausrichten und erst dann einkleben.

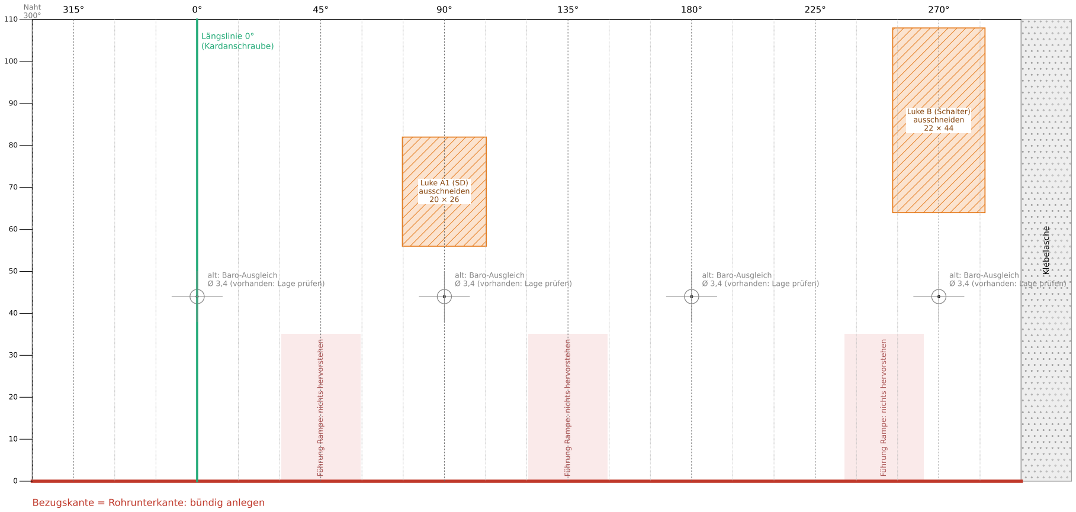
[picture p80: figure]
Klebelasche; Bezugskante = Rohrunterkante: bündig anlegen; 270° Naht; Längslinie 0° (Kardanschraube); Führung Rampe: nichts hervorstehen; alt: Baro-Ausgleich Ø 3,4 (vorhanden: Lage prüfen); Luke A1 (SD) ausschneiden 20 × 26; Luke B (Schalter) ausschneiden 22 × 44

Prüfmaß 100 mm: nach dem Druck nachmessen | S2 Rohr B, Unterkante (Luken A1 und B, Schraubschalter)

Rohr B mit verklebtem Kuppler, Bezugskante an die Unterkante von B (Stoß), Längslinie von Rohr A über den Stoß verlängert. Grau = alte Löcher (bleiben als Druckausgleich offen). Luken mit Cutter, Schalterloch Ø 3.

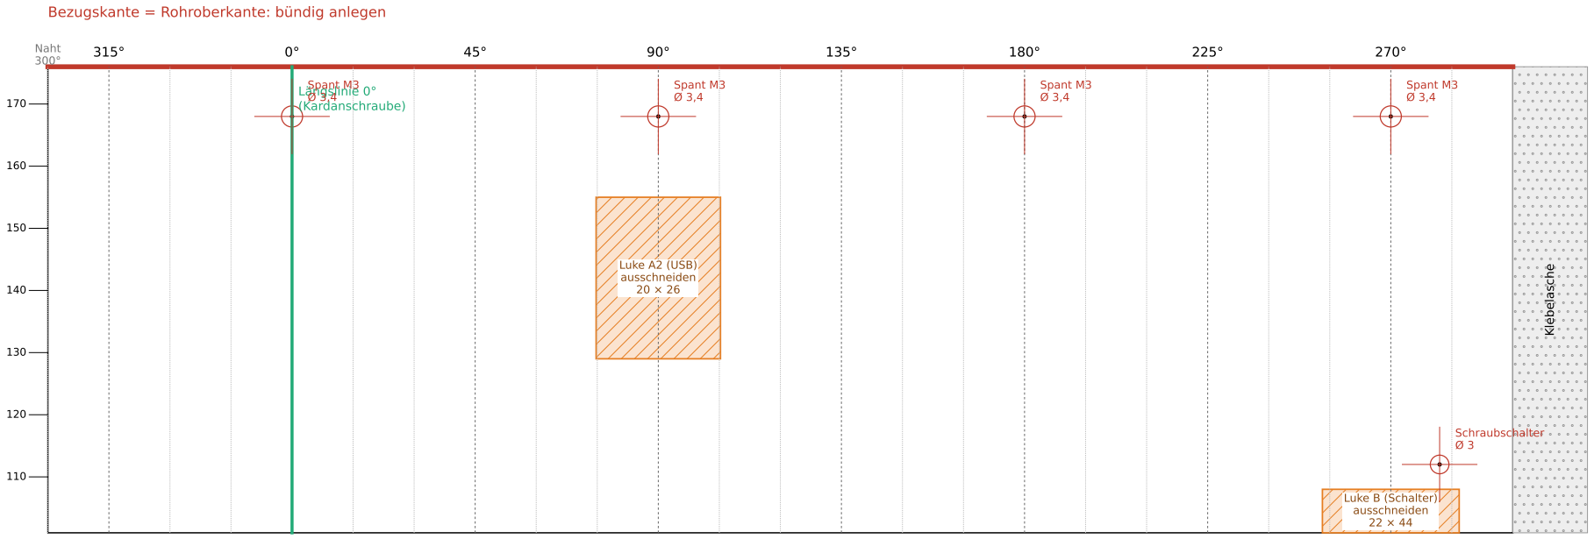
[picture p81: figure]
Klebelasche; Bezugskante = Rohroberkante: bündig anlegen; 270° Naht; Längslinie 0° (Kardanschraube); Spant M3 Ø 3,4; Schraubschalter Ø 3; Luke A2 (USB) ausschneiden 20 × 26; Luke B (Schalter) ausschneiden 22 × 44

Prüfmaß 100 mm: nach dem Druck nachmessen | S3 Rohr B, Oberkante (Luke A2, Spant T2)

Bezugskante an die Oberkante von B. Löcher T2 Ø 3,4, Luke A2 ausschneiden. Danach Schlitten einsetzen: die Augen fluchten in 4 Lagen, die richtige ist die mit Luke A über dem USB-Stecker.

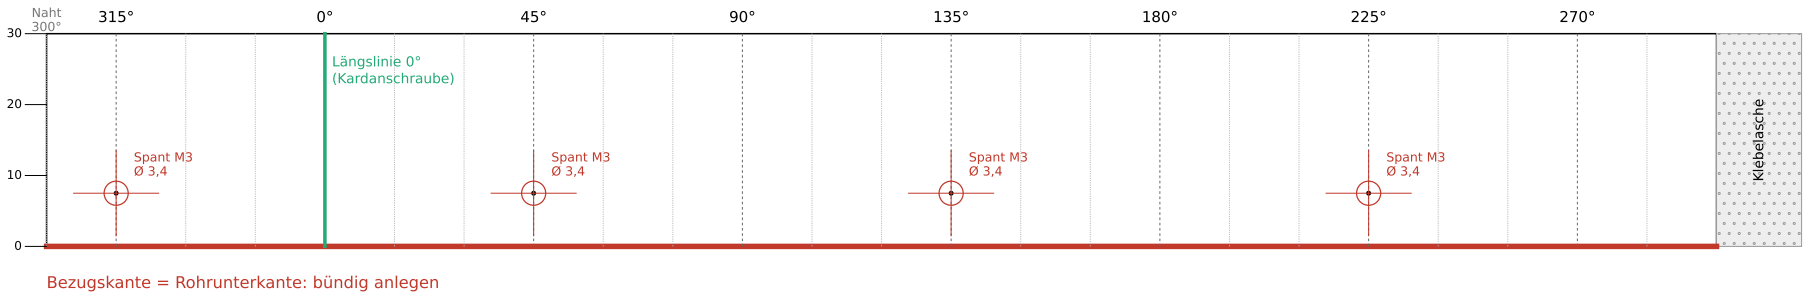
[picture p82: figure]
Klebelasche; Bezugskante = Rohrunterkante: bündig anlegen; 270° Naht; Längslinie 0° (Kardanschraube); Spant M3 Ø 3,4

Prüfmaß 100 mm: nach dem Druck nachmessen | S4 Rohr C, beide Enden (Spant T3, Abscherstifte)

Unteres Ende: Löcher T3 Ø 3,4 bei 45°/135°/225°/315°, 7,5 mm über der Unterkante. Für die Abscherstifte (optional, h = 180) denselben Streifen an der Oberkante anlegen: Stifte bei 45° und 225°, 15 mm unter der Kante.
