Jan-Philipp-Munsch/kartonaut/docs/img/bauanleitung/S1_schablone.png

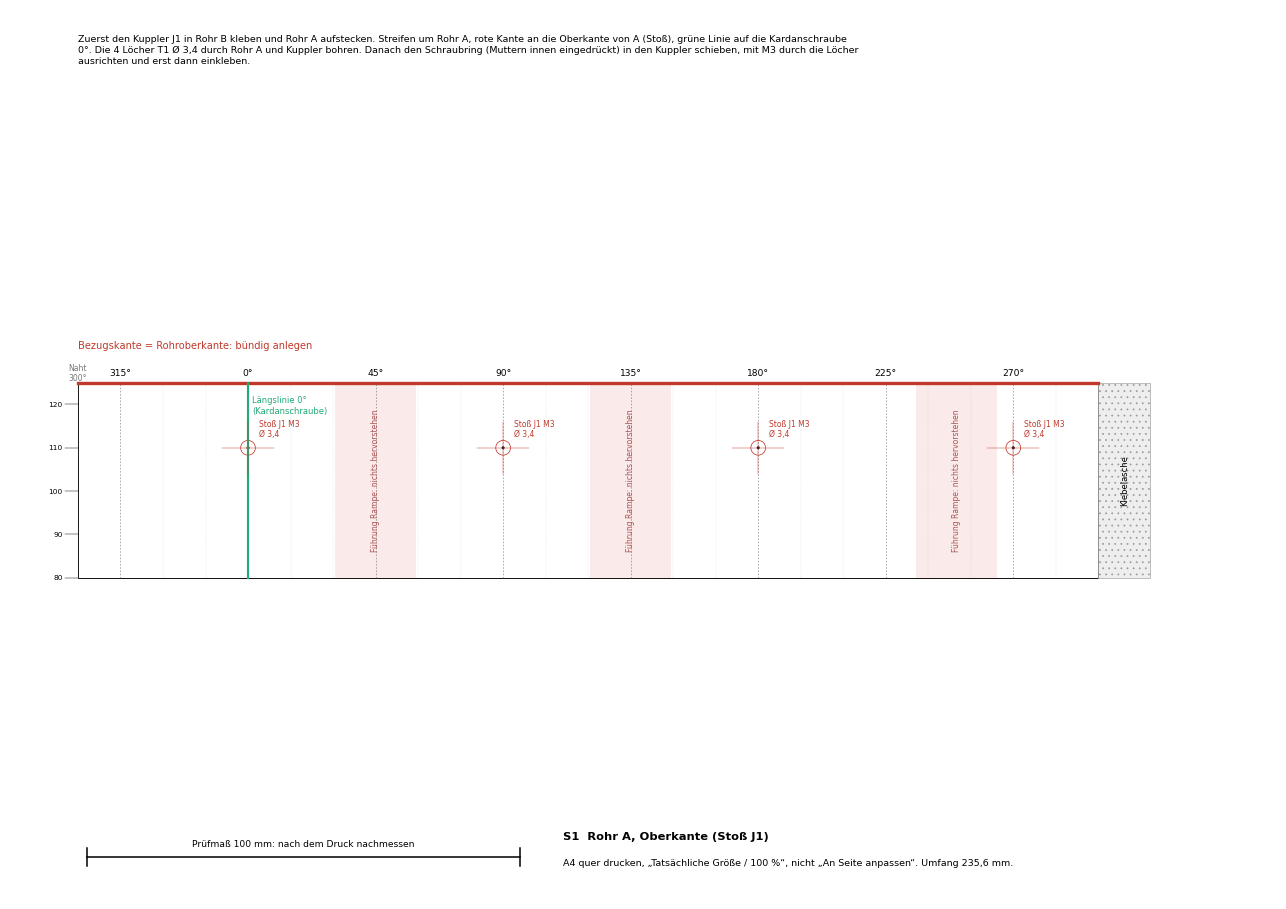
docs/img/bauanleitung/S1_schablone.png
