Jan-Philipp-Munsch/kartonaut/firmware/test/data/sil_controller_ki1.csv

t_s | dt_s | angle_x_deg | angle_y_deg | omega_x_dps | omega_y_dps | a_norm_filt | yaw_moment_nm | pitch_moment_nm | yaw_servo_deg | pitch_servo_deg
0.000 | 0.01 | 0.000000 | 0.000000 | 0.000000 | 0.000000 | 8.829000 | -0.00000000 | -0.00000000 | 92.50000 | 82.50000
0.010 | 0.01 | 0.000000 | 0.000000 | 0.000000 | 0.000000 | 7.956251 | -0.00000000 | -0.00000000 | 92.50000 | 82.50000
0.020 | 0.01 | 0.000000 | 0.000000 | 0.000000 | 0.000000 | 7.180929 | -0.00000000 | -0.00000000 | 92.50000 | 82.50000
0.030 | 0.01 | 0.000000 | 0.000000 | 0.000000 | 0.000000 | 6.492879 | -0.00000000 | -0.00000000 | 92.50000 | 82.50000
0.040 | 0.01 | 0.000000 | 0.000000 | 0.000000 | 0.000000 | 5.881721 | -0.00000000 | -0.00000000 | 92.50000 | 82.50000
0.050 | 0.01 | 0.000000 | 0.000000 | 0.000000 | 0.000000 | 5.339766 | -0.00000000 | -0.00000000 | 92.50000 | 82.50000
0.060 | 0.01 | 0.000000 | 0.000000 | 0.000000 | 0.000000 | 4.860095 | -0.00000000 | -0.00000000 | 92.50000 | 82.50000
0.070 | 0.01 | 0.000000 | 0.000000 | 0.000000 | 0.000000 | 4.435796 | -0.00000000 | -0.00000000 | 92.50000 | 82.50000
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
