Jan-Philipp-Munsch/kartonaut/docs/img/cad/blender_test123.png

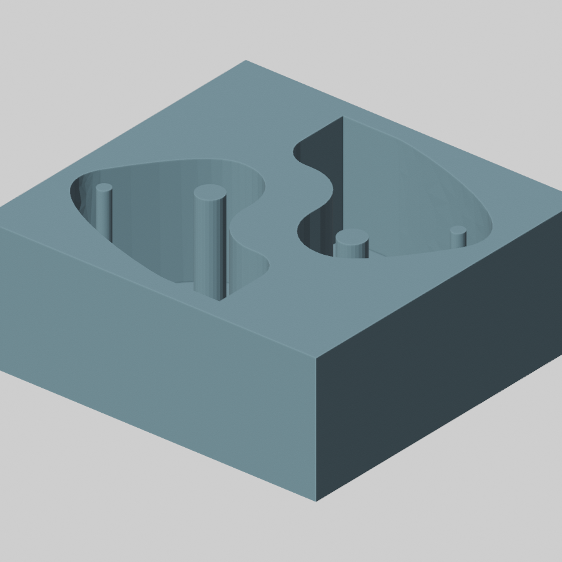
docs/img/cad/blender_test123.png
