Jan-Philipp-Munsch/kartonaut/hardware/mainboard/kicad/out/mainboard_schematic.pdf

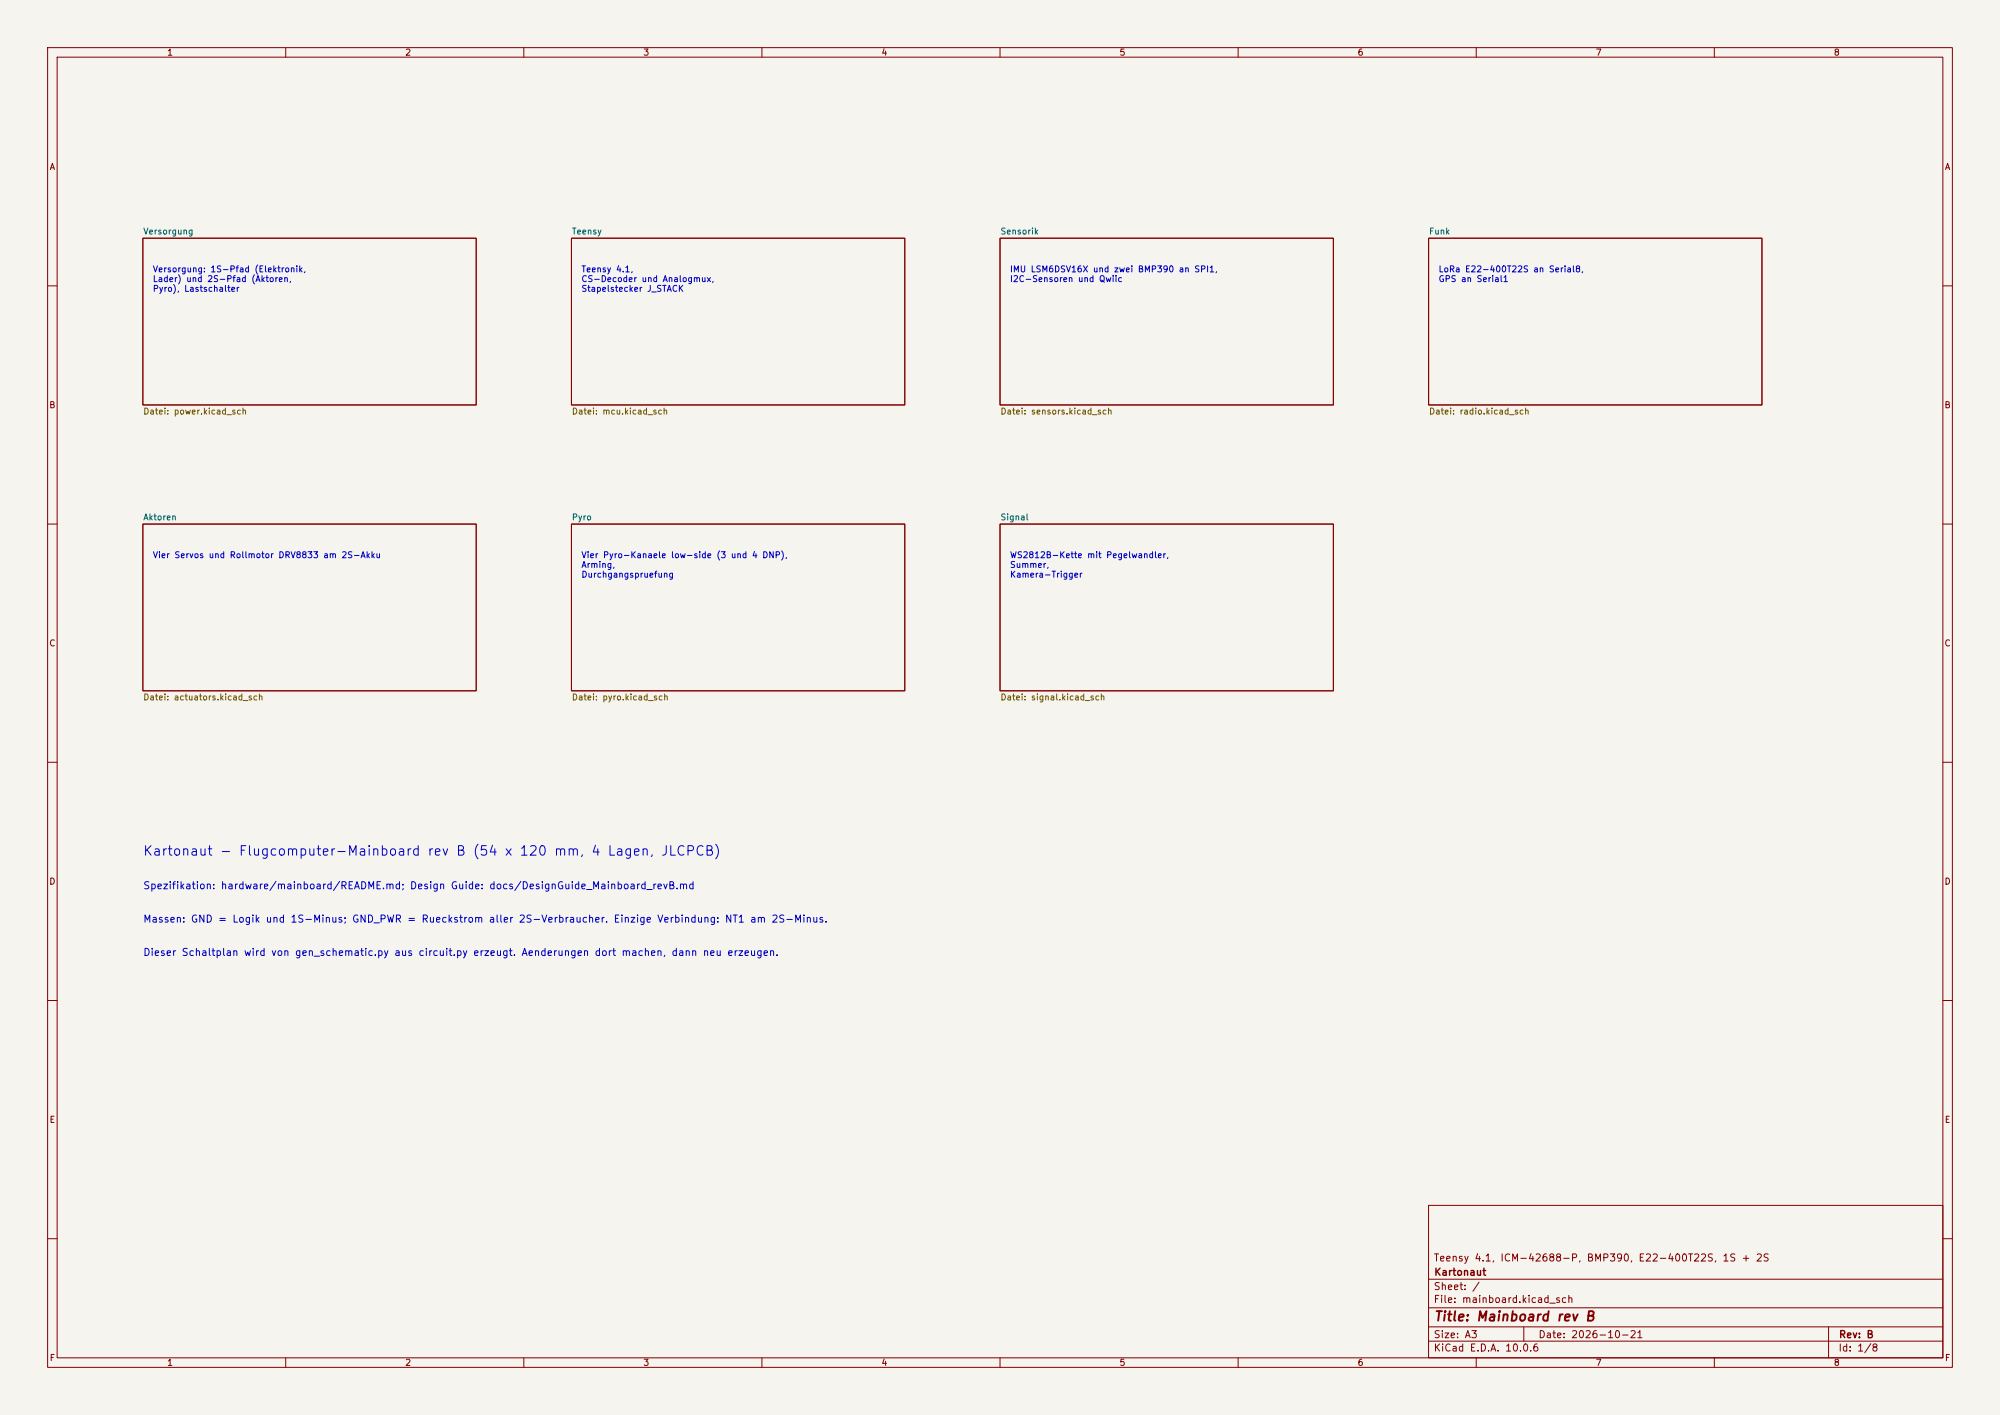
[picture p85: page 1]

Teensy Datei: mcu.kicad_sch Pyro Datei: pyro.kicad_sch

Funk Datei: radio.kicad_sch Signal Datei: signal.kicad_sch

Versorgung: 1S-Pfad (Elektronik, Lader) und 2S-Pfad (Aktoren, Pyro), Lastschalter Vier Servos und Rollmotor DRV8833 am 2S-Akku Kartonaut - Flugcomputer-Mainboard rev B (54 x 120 mm, 4 Lagen, JLCPCB)

Teensy 4.1, CS-Decoder und Analogmux,

LoRa E22-400T22S an Serial8, GPS an Serial1 WS2812B-Kette mit Pegelwandler,
IMU LSM6DSV16X und zwei BMP390 an SPI1,
I2C-Sensoren und Qwiic

Vier Pyro-Kanaele low-side (3 und 4 DNP),
Arming,
Durchgangspruefung

Spezifikation: hardware/mainboard/README.md; Design Guide: docs/DesignGuide_Mainboard_revB.md

Massen: GND = Logik und 1S-Minus; GND_PWR = Rueckstrom aller 2S-Verbraucher. Einzige Verbindung: NT1 am 2S-Minus.

Dieser Schaltplan wird von gen_schematic.py aus circuit.py erzeugt. Aenderungen dort machen, dann neu erzeugen.

Size: A3 | Rev: B | F Date: 2026-10-21
KiCad E.D.A. 10.0.6 | Id: 1/8

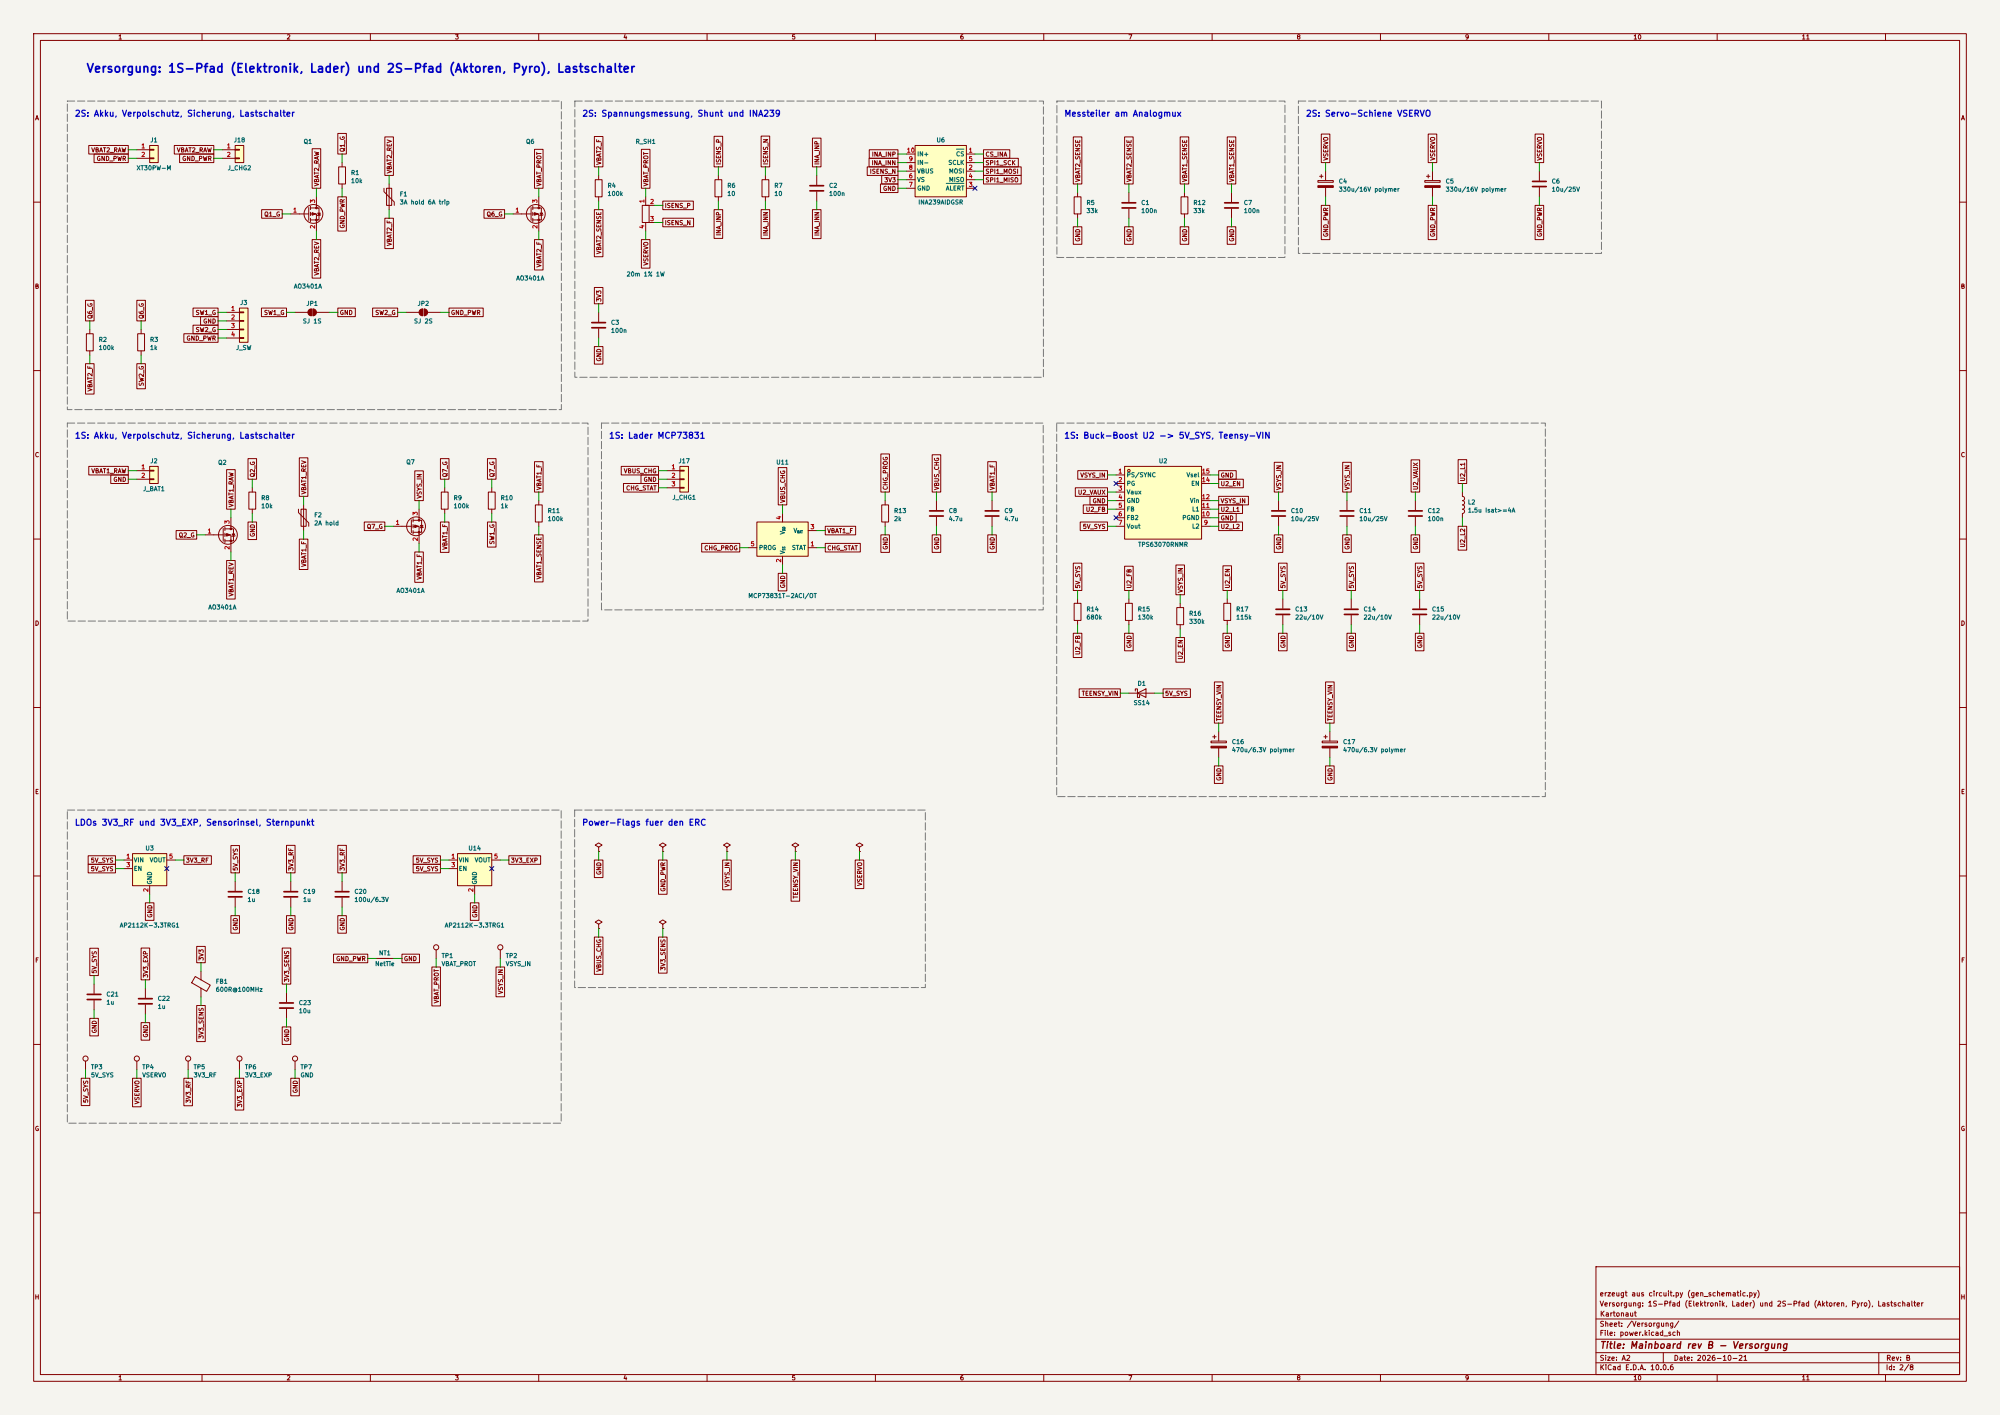
[picture p86: page 2]

Versorgung: 1S-Pfad (Elektronik, Lader) und 2S-Pfad (Aktoren, Pyro), Lastschalter

2S: Akku, Verpolschutz, Sicherung, Lastschalter

1S: Akku, Verpolschutz, Sicherung, Lastschalter

erzeugt aus circuit.py (gen_schematic.py)
Kartonaut
Sheet: /Versorgung/
File: power.kicad_sch
Title: Mainboard rev B - Versorgung

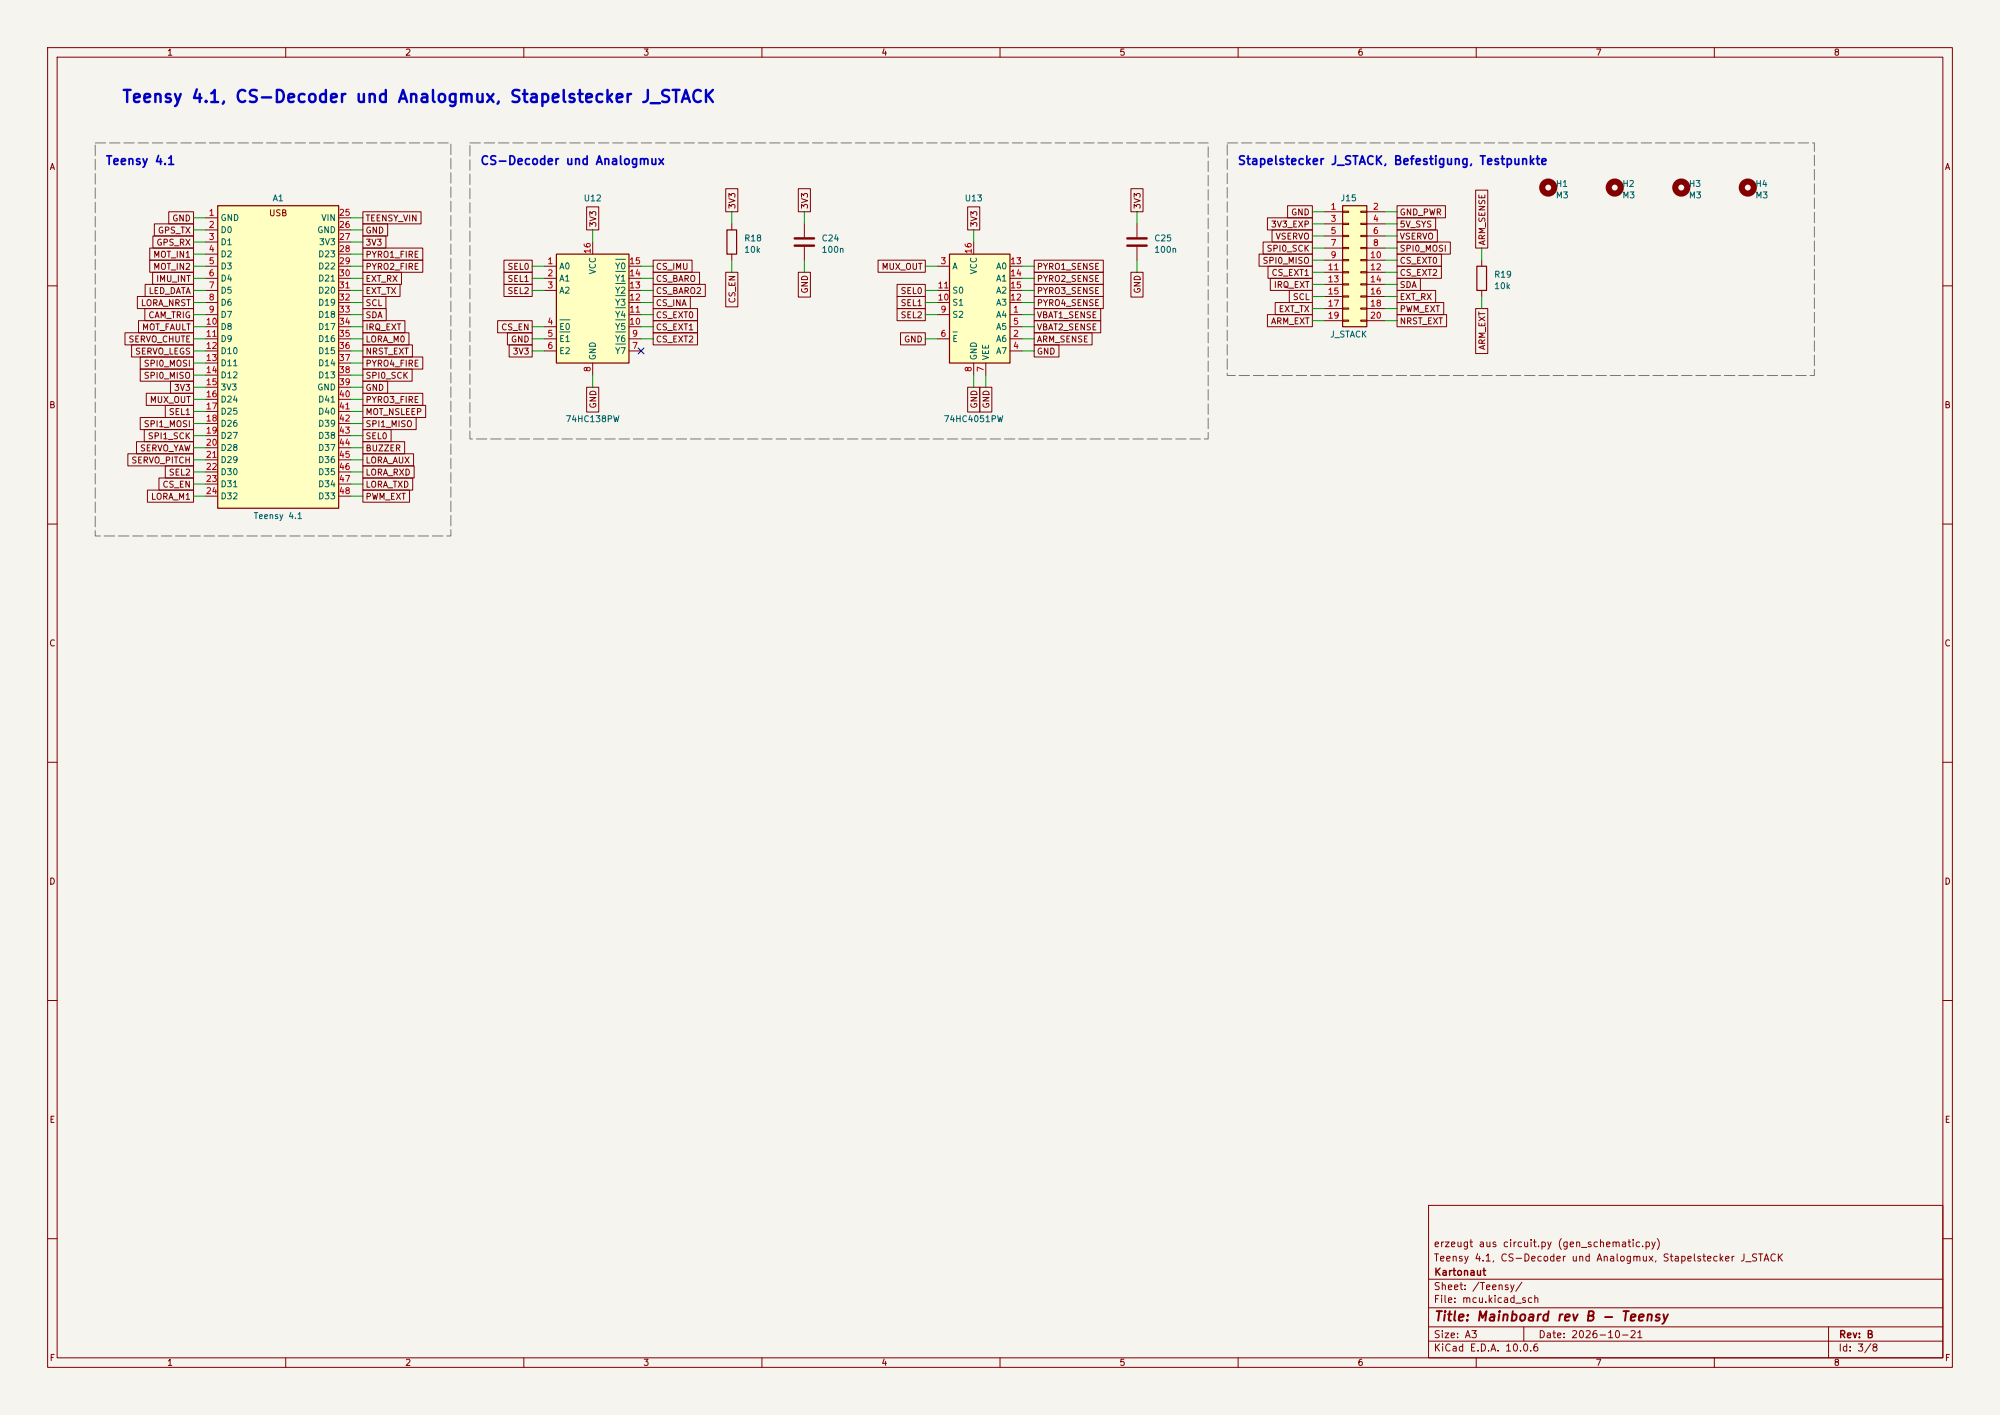
[picture p87: page 3]

Teensy 4.1, CS-Decoder und Analogmux, Stapelstecker J_STACK

erzeugt aus circuit.py (gen_schematic.py)
Kartonaut
Sheet: /Teensy/
File: mcu.kicad_sch
Title: Mainboard rev B - Teensy

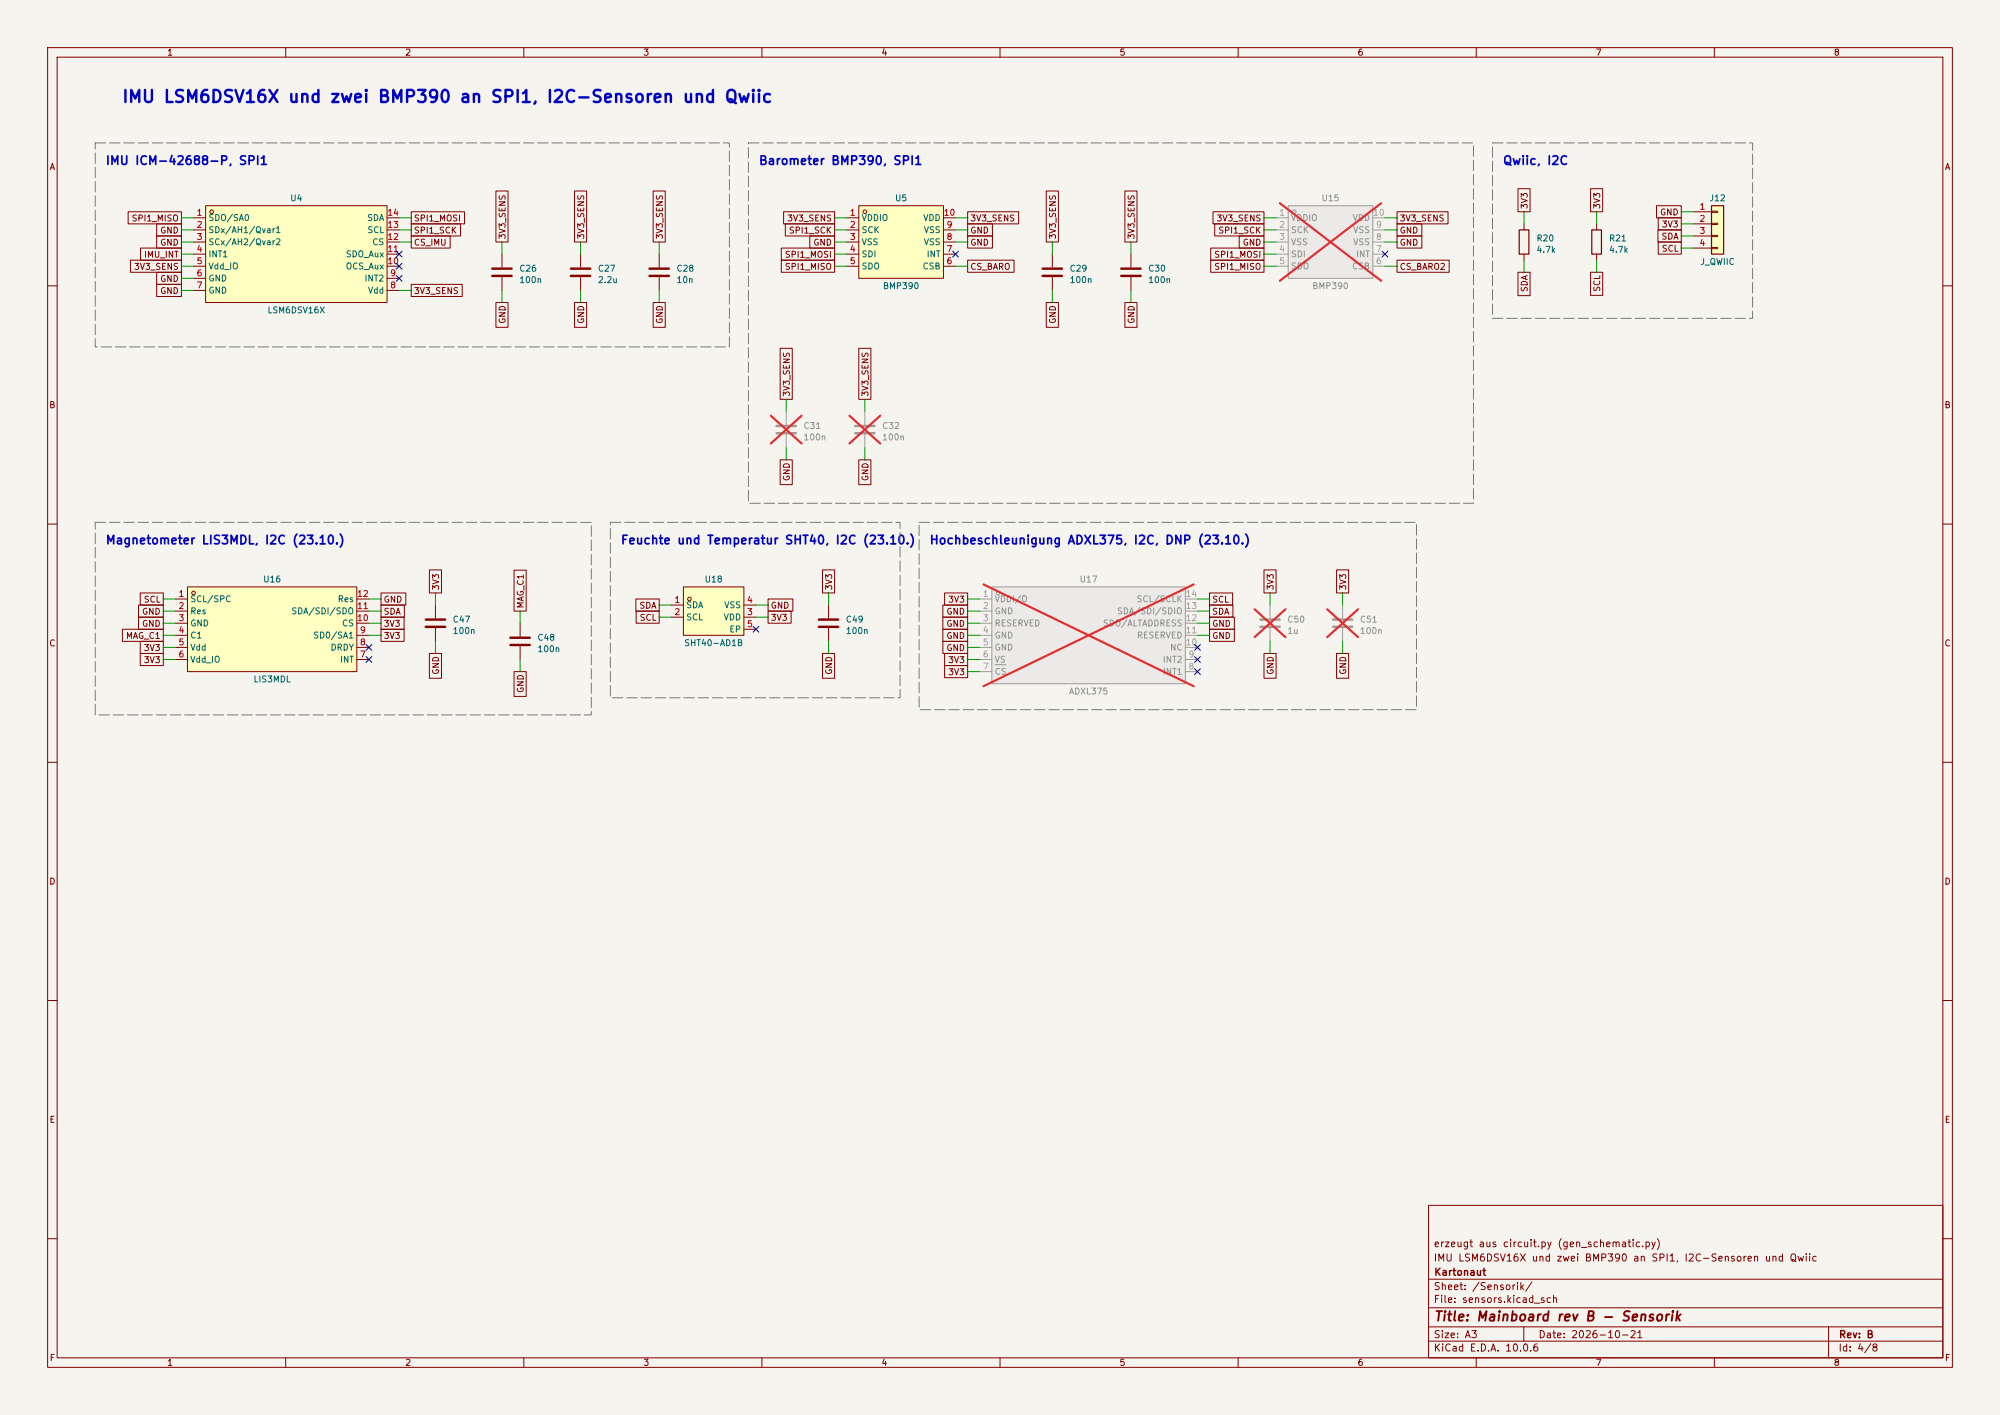
[picture p88: page 4]

IMU LSM6DSV16X und zwei BMP390 an SPI1, I2C-Sensoren und Qwiic

SDA SCL SDA GND

erzeugt aus circuit.py (gen_schematic.py)
Kartonaut
Sheet: /Sensorik/
File: sensors.kicad_sch
Title: Mainboard rev B - Sensorik

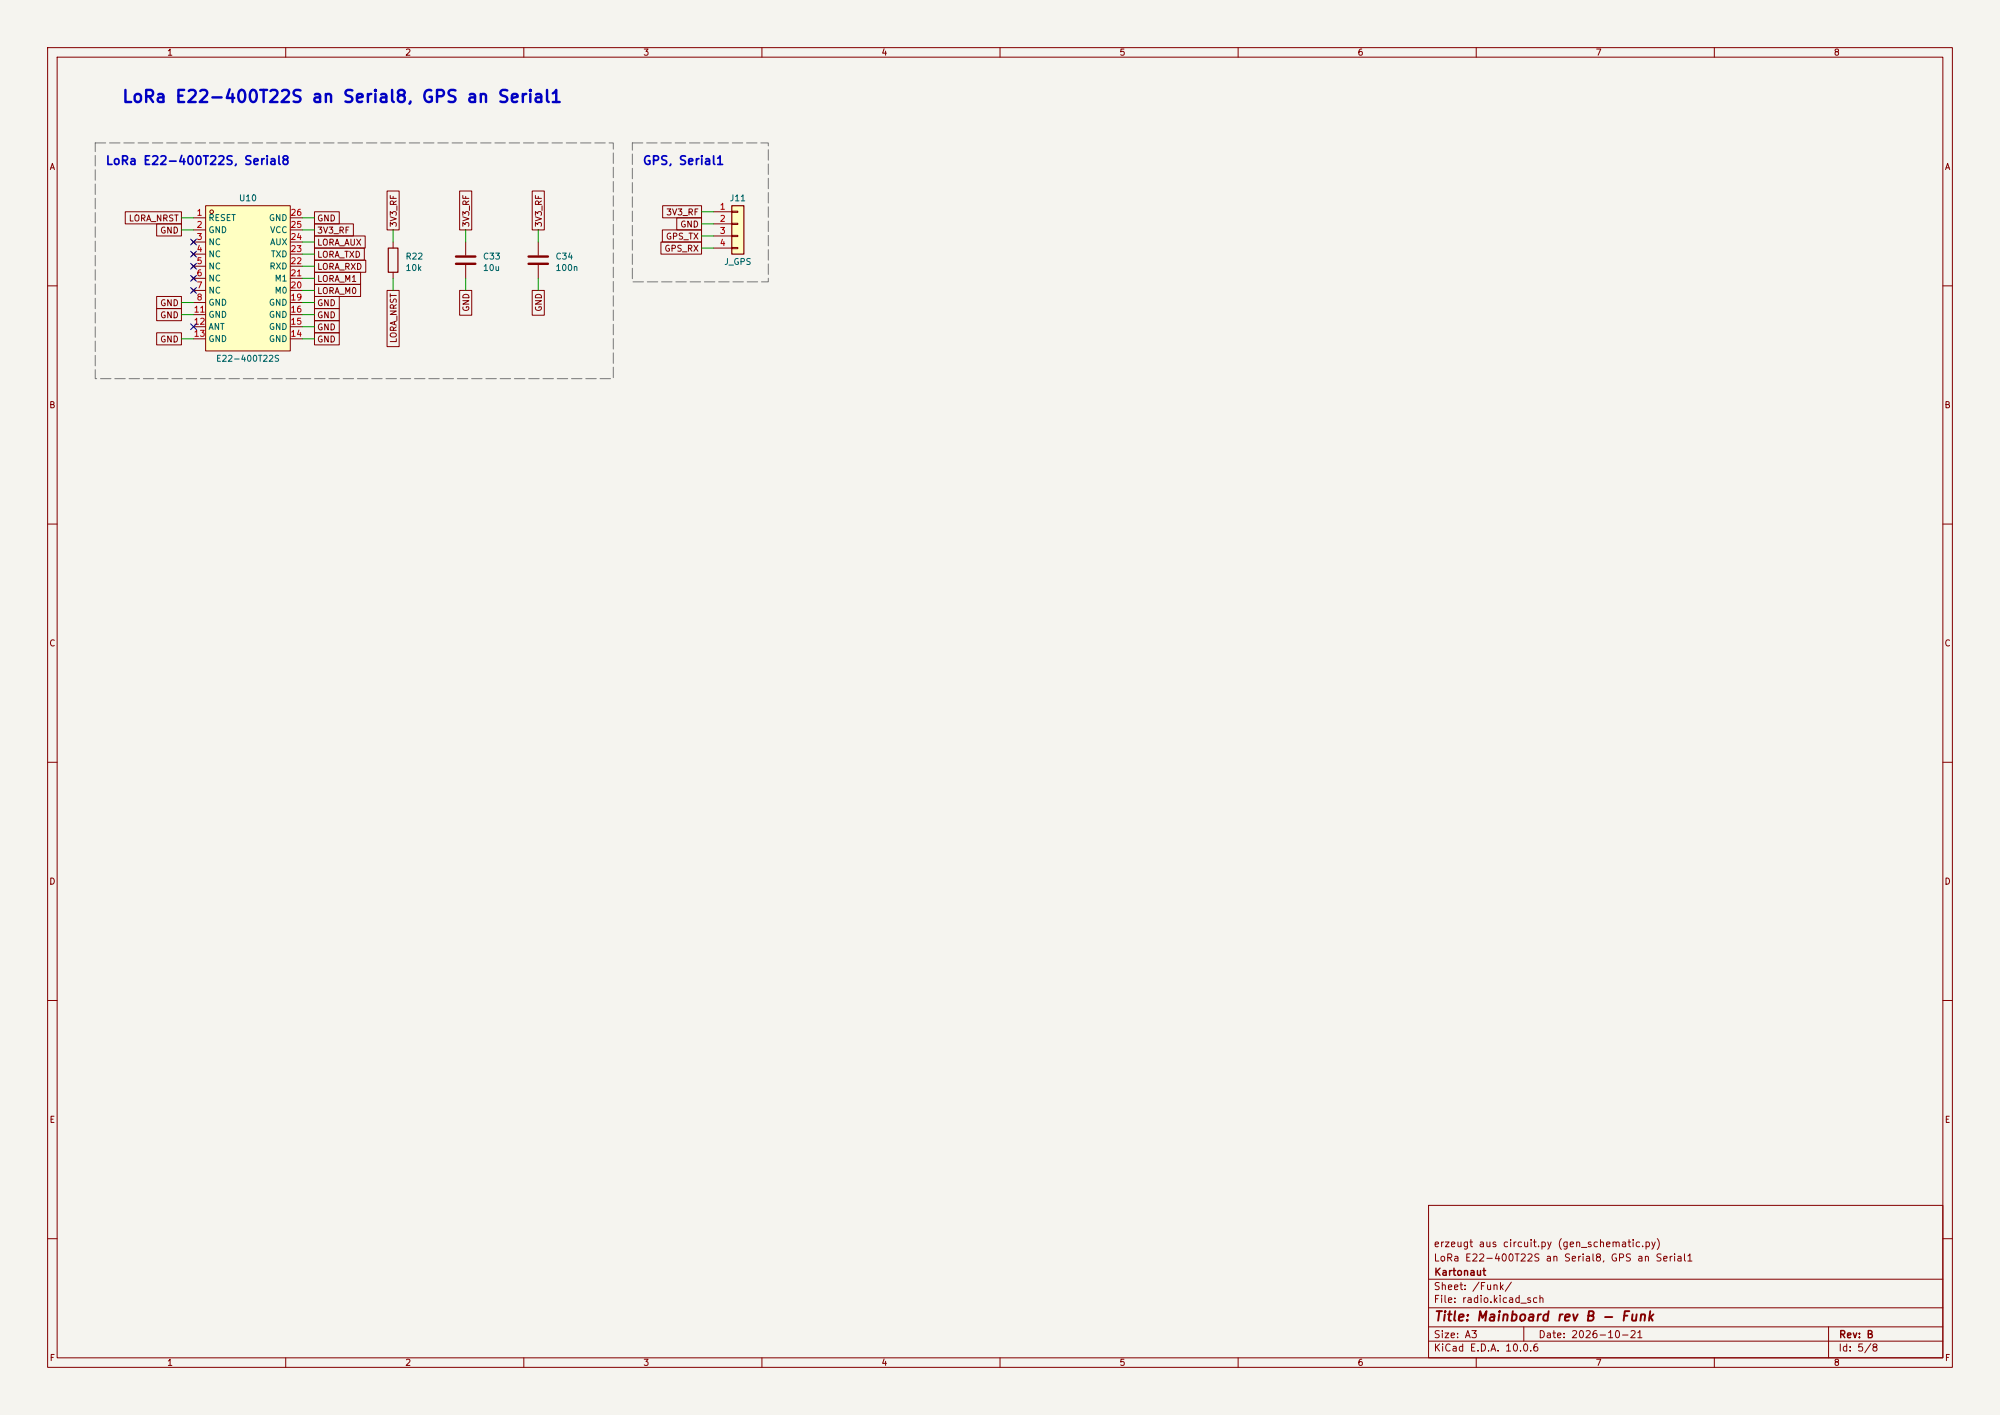
[picture p89: page 5]

LoRa E22-400T22S an Serial8, GPS an Serial1

erzeugt aus circuit.py (gen_schematic.py)
Kartonaut
Sheet: /Funk/
File: radio.kicad_sch
Title: Mainboard rev B - Funk

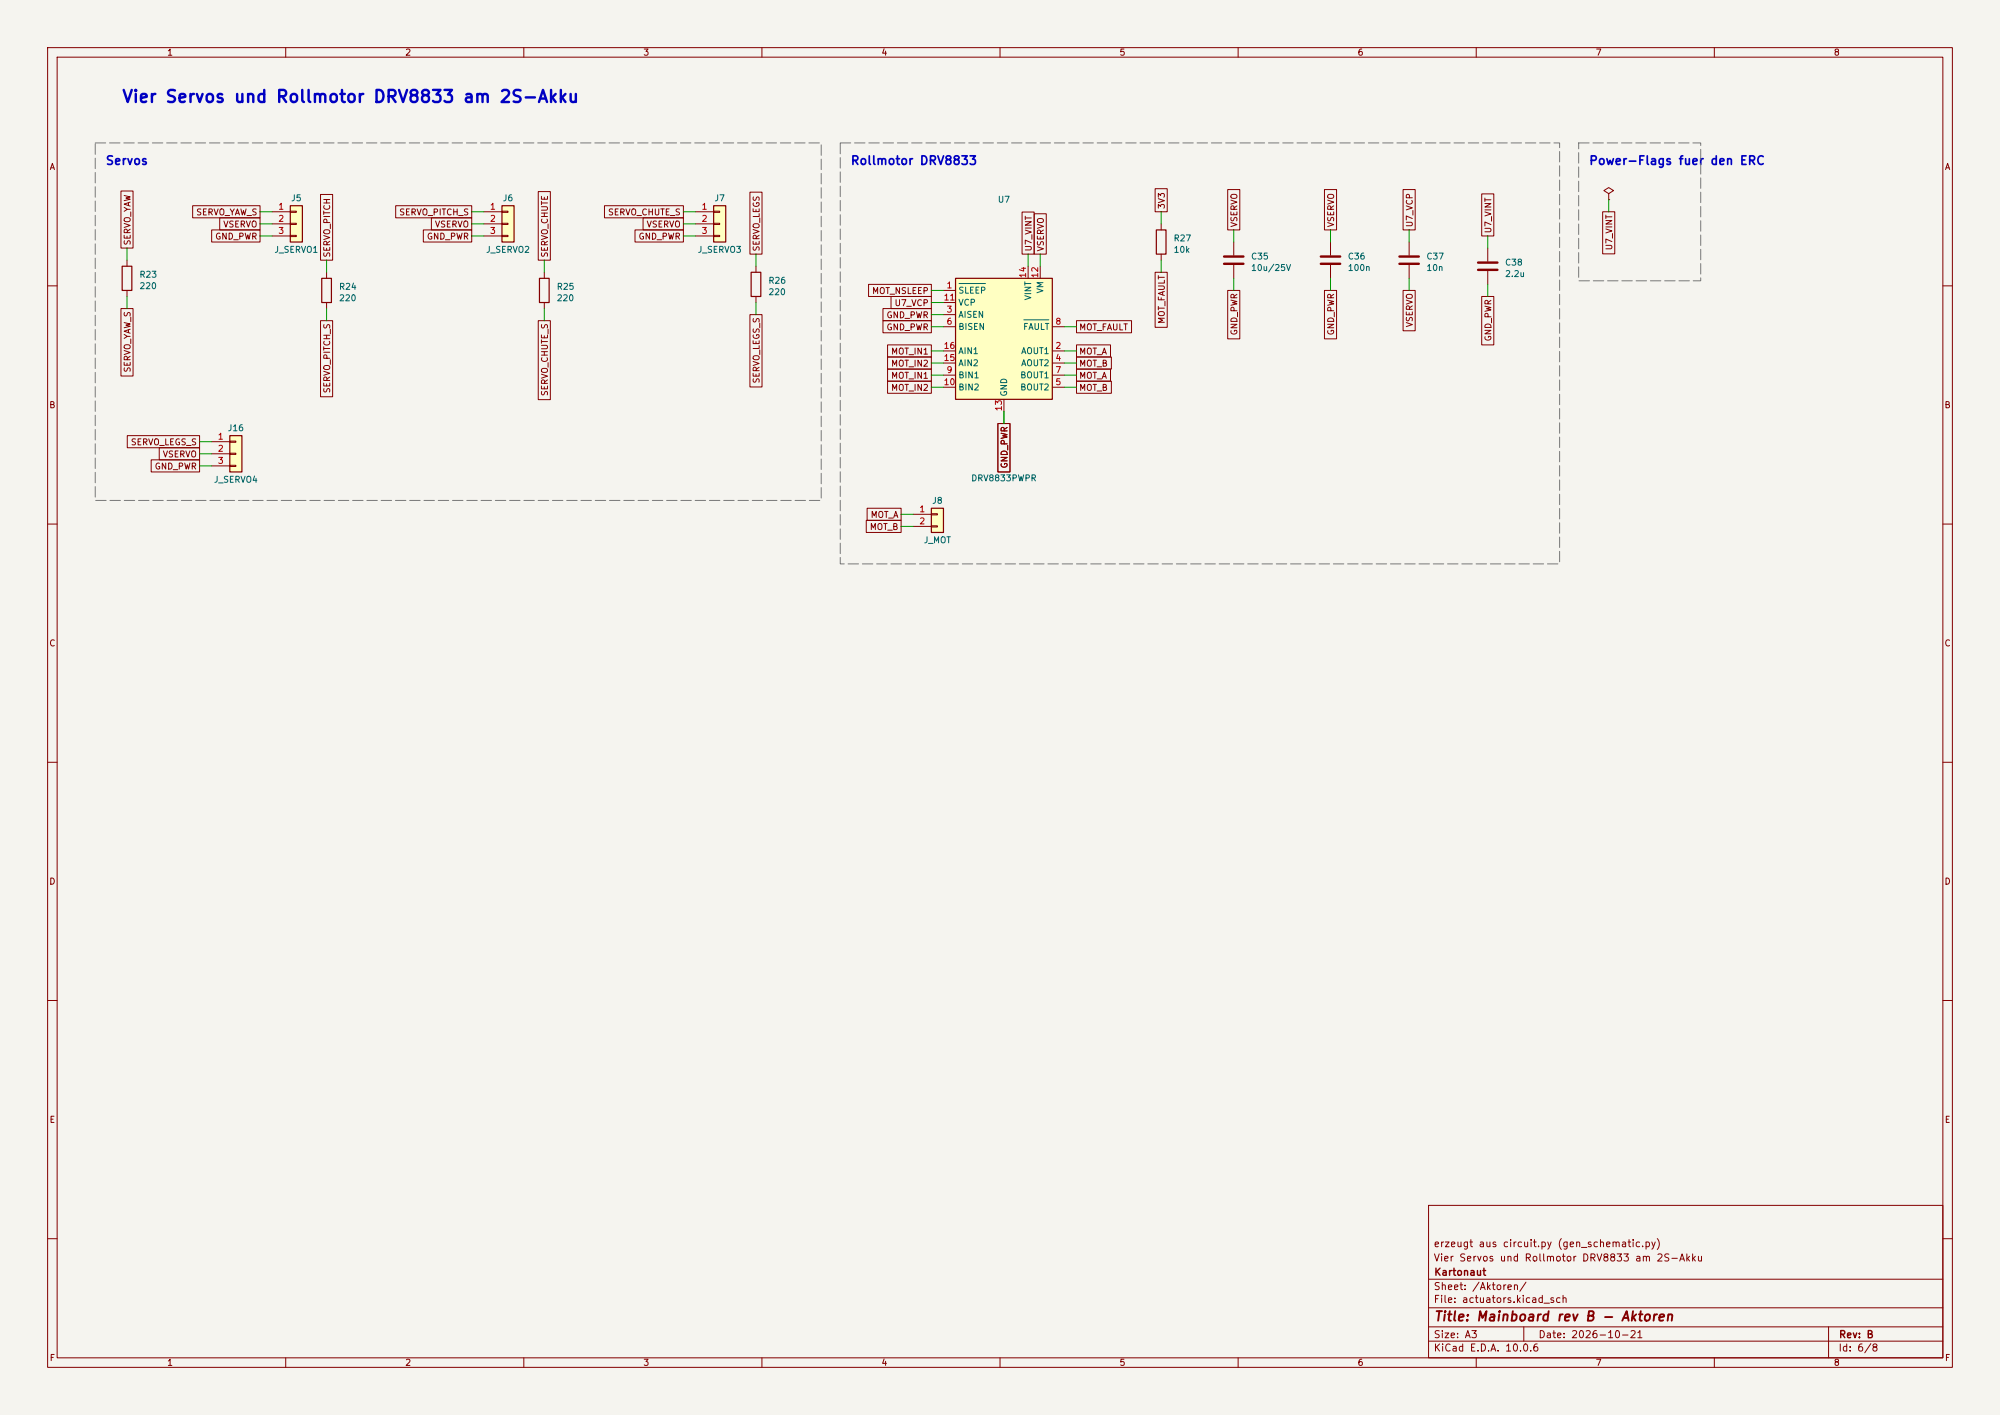
[picture p90: page 6]

Vier Servos und Rollmotor DRV8833 am 2S-Akku

Power-Flags fuer den ERC

erzeugt aus circuit.py (gen_schematic.py)
Kartonaut
Sheet: /Aktoren/
File: actuators.kicad_sch
Title: Mainboard rev B - Aktoren

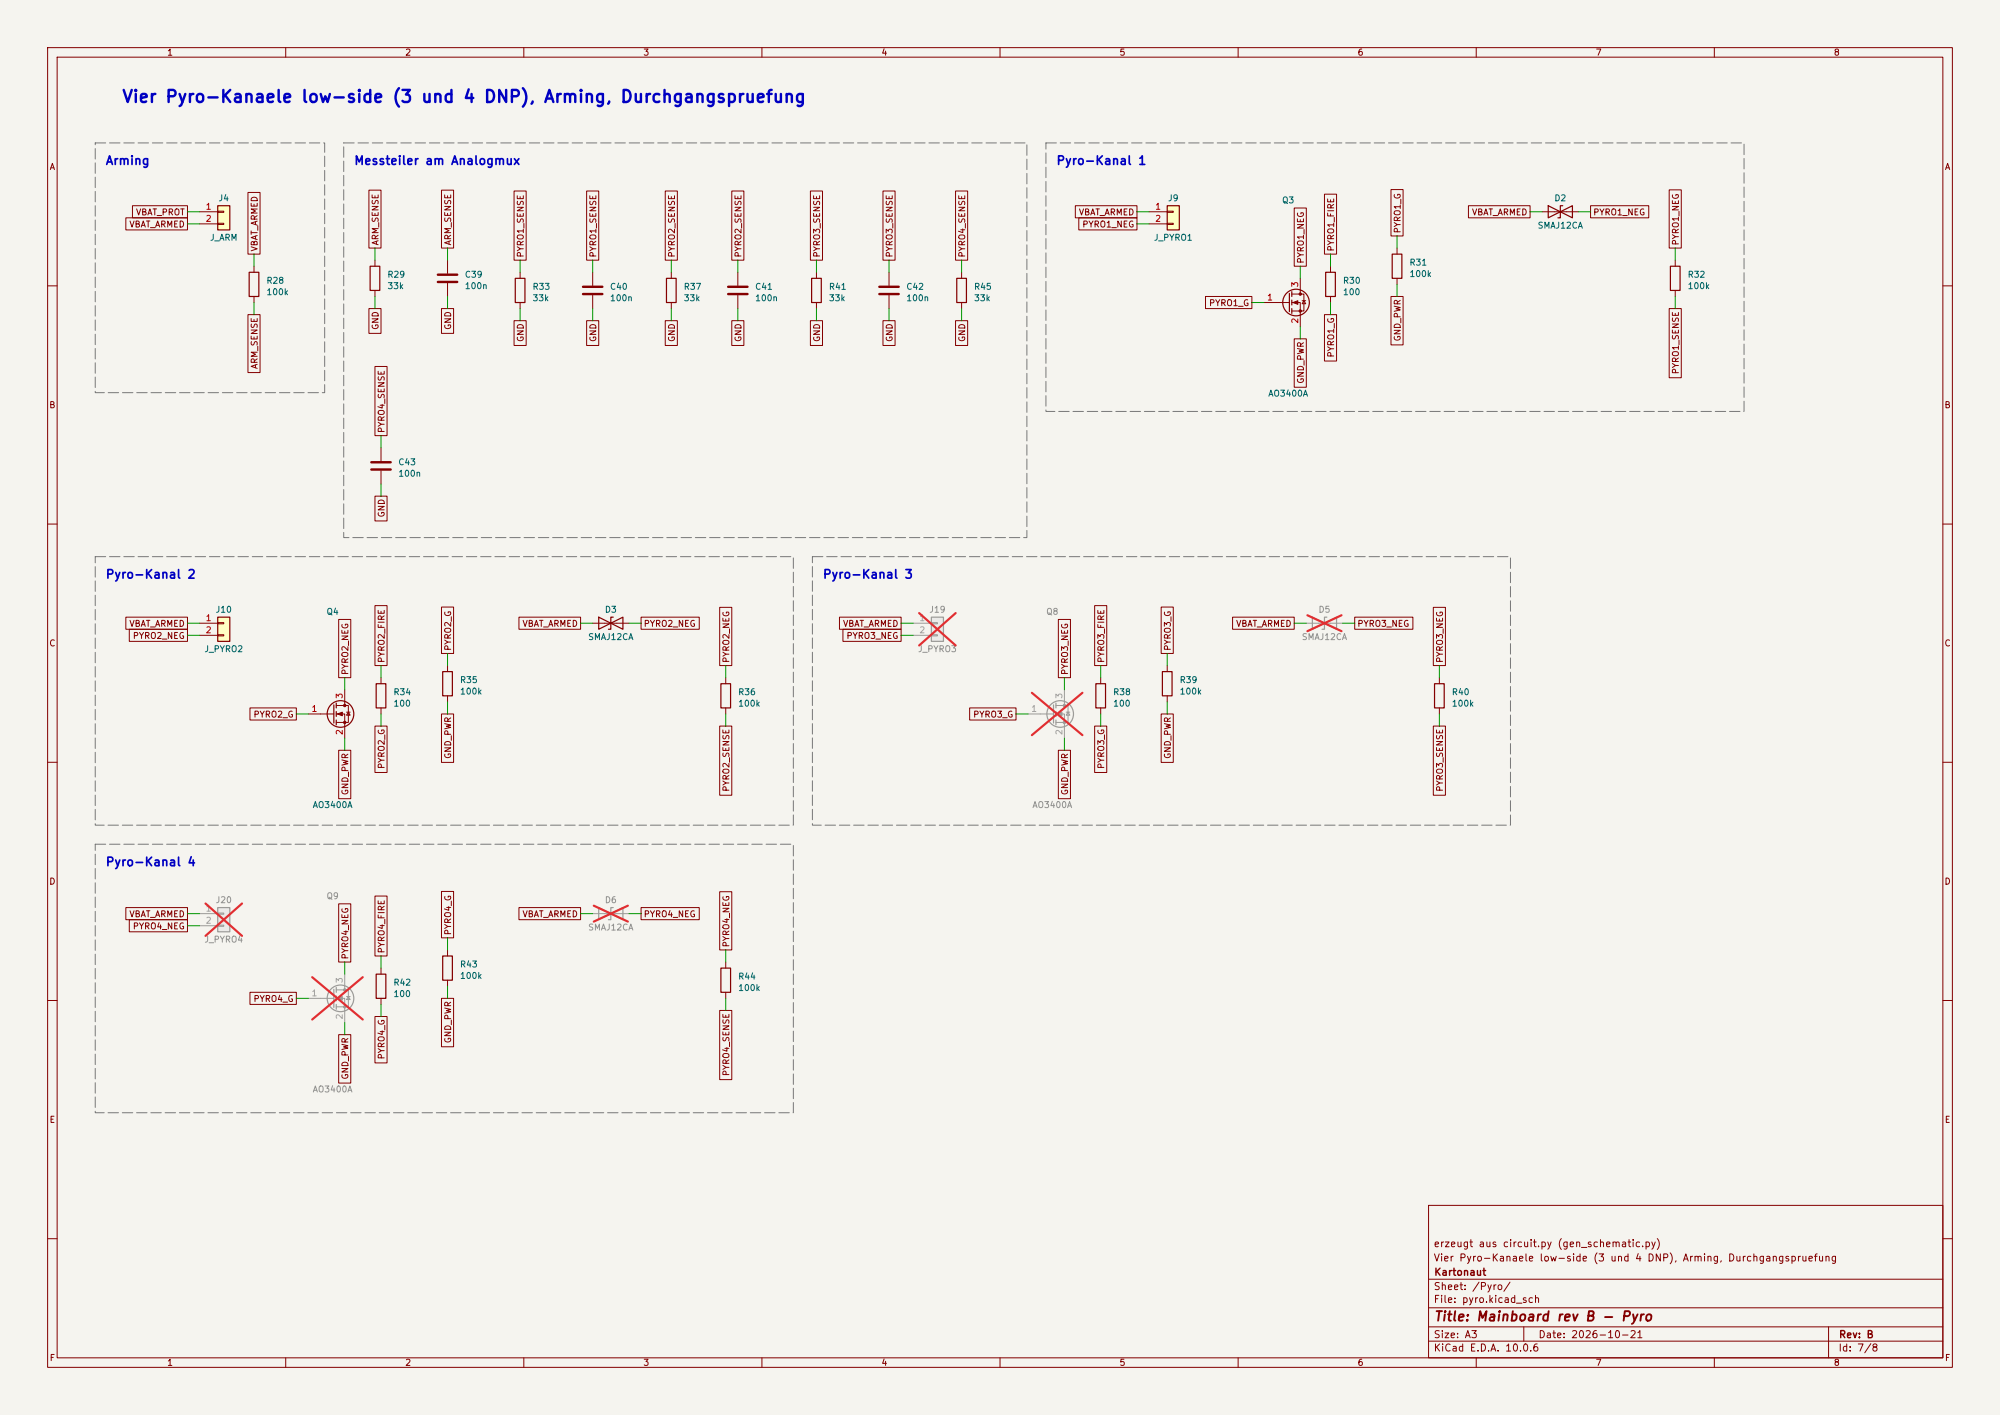
[picture p91: page 7]

Vier Pyro-Kanaele low-side (3 und 4 DNP), Arming, Durchgangspruefung

erzeugt aus circuit.py (gen_schematic.py) R44

Kartonaut
Sheet: /Pyro/
File: pyro.kicad_sch
Title: Mainboard rev B - Pyro

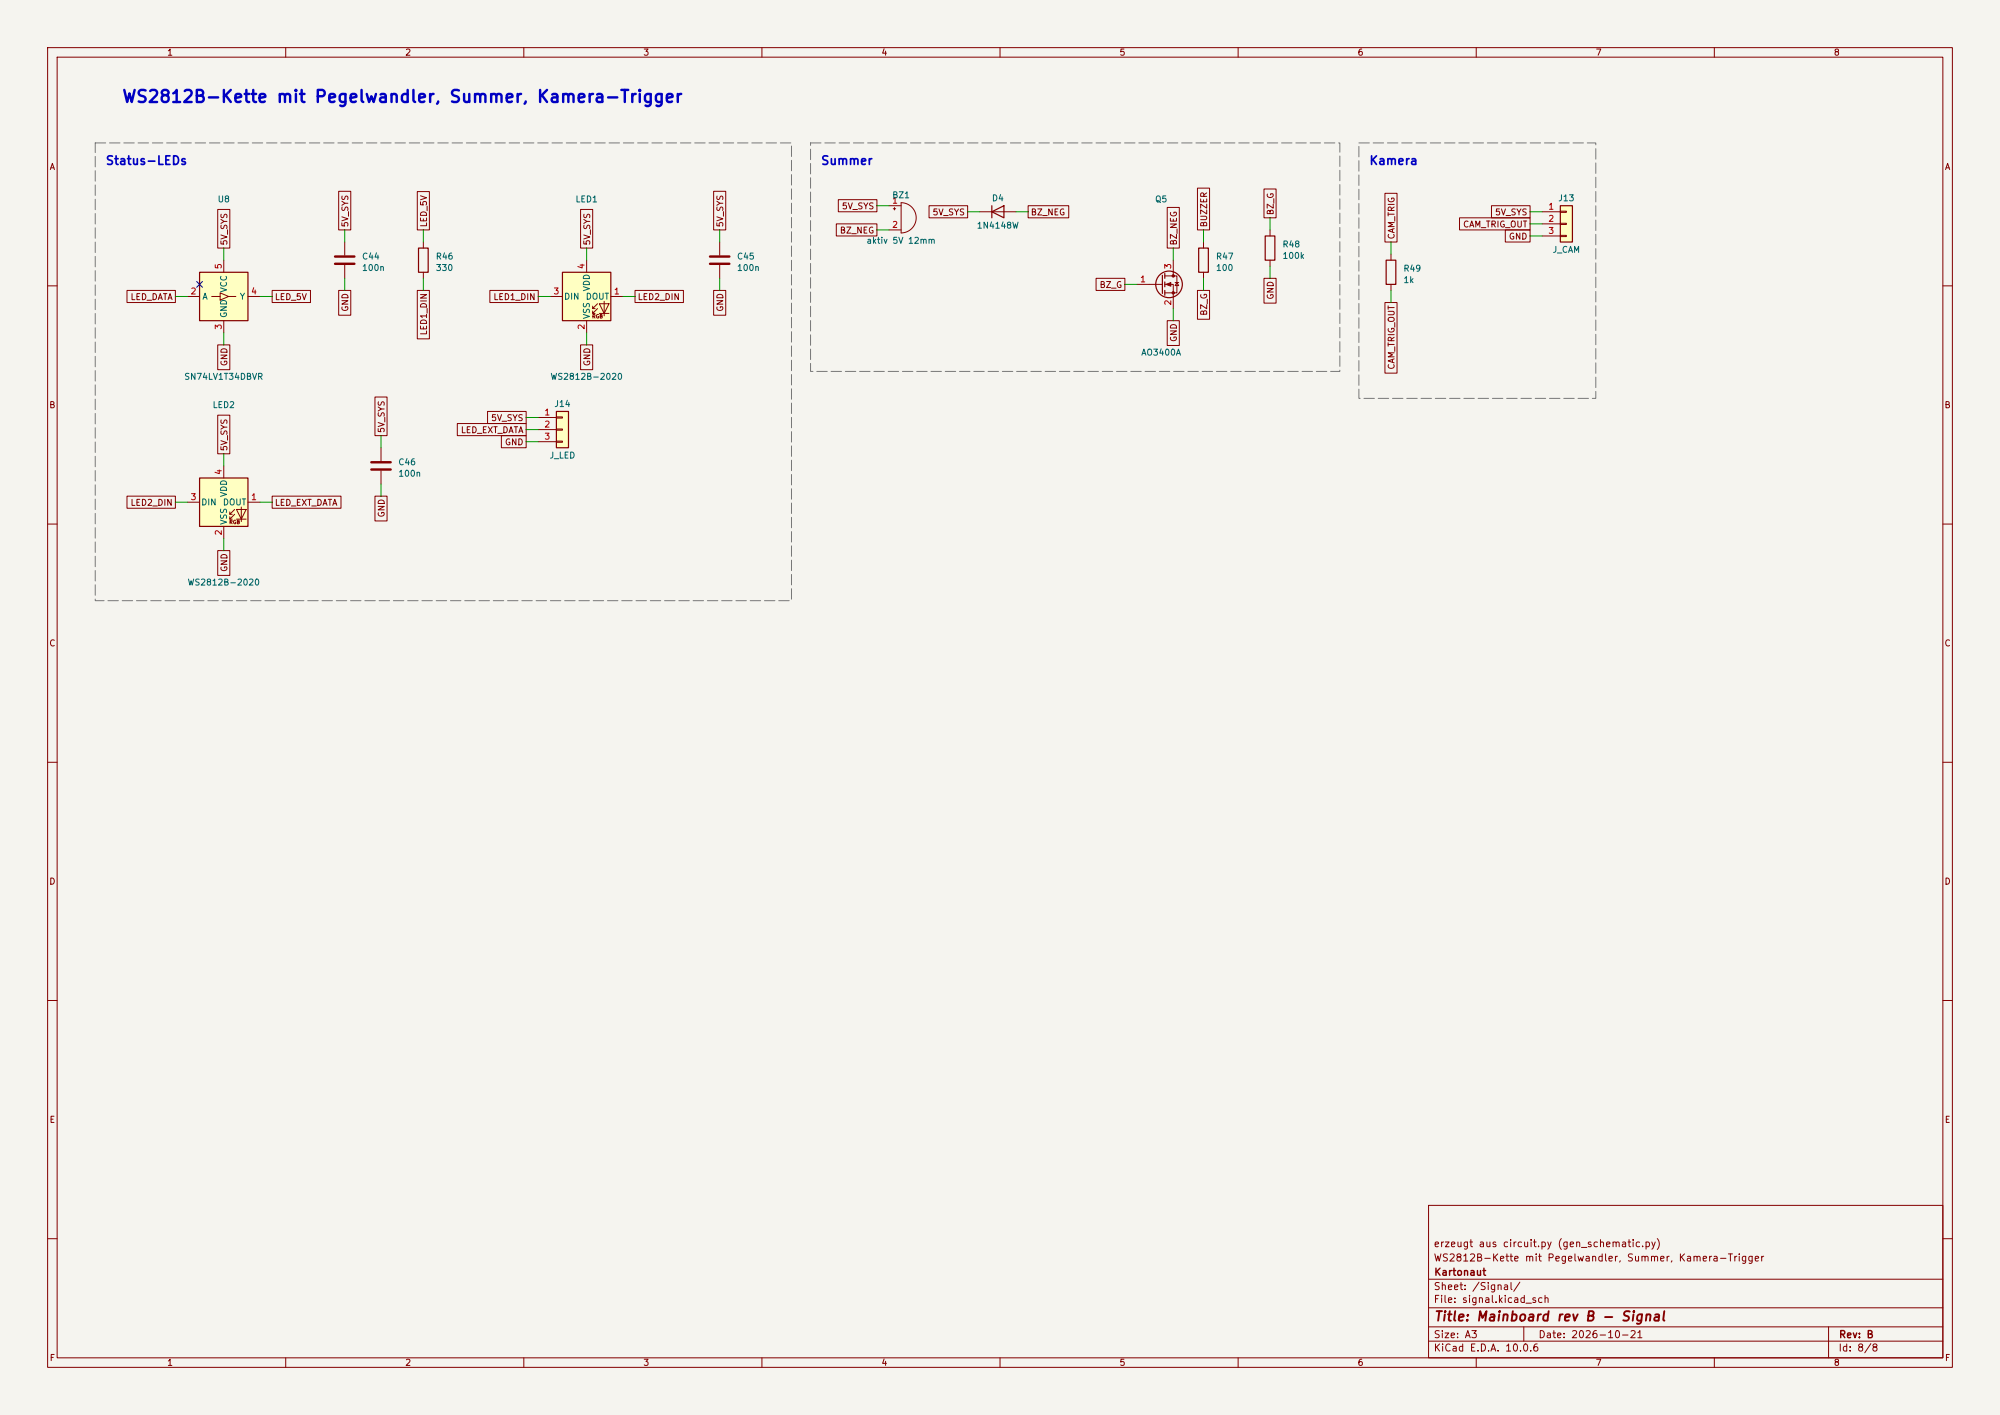
[picture p92: page 8]

WS2812B-Kette mit Pegelwandler, Summer, Kamera-Trigger

erzeugt aus circuit.py (gen_schematic.py)
Kartonaut
Sheet: /Signal/
File: signal.kicad_sch
Title: Mainboard rev B - Signal
