Jan-Philipp-Munsch/kartonaut/hardware/mainboard/kicad/img/layers.pdf

# LEGS MOT PYRO4 QWIIC

# F.Cu - Bauteilseite, Signale

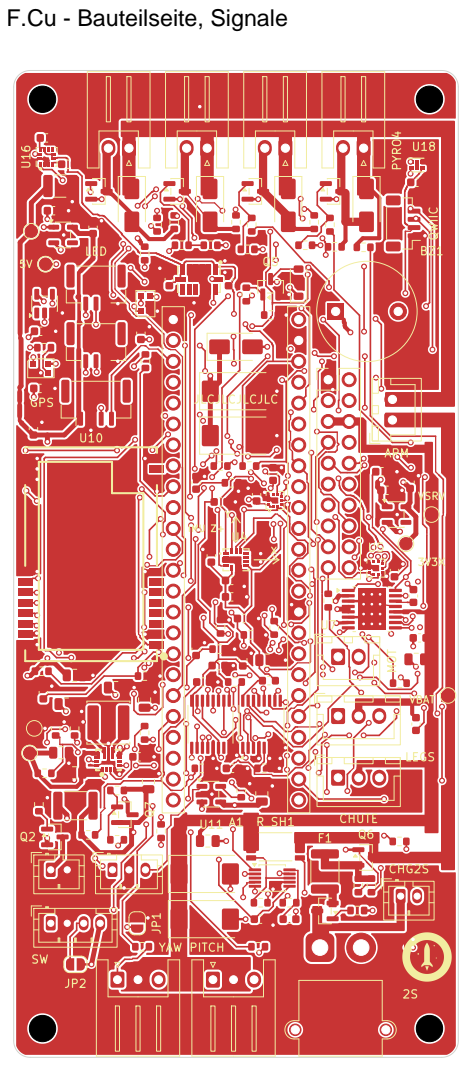
[picture p93: page 1]

# In1.Cu - GND-Flaeche

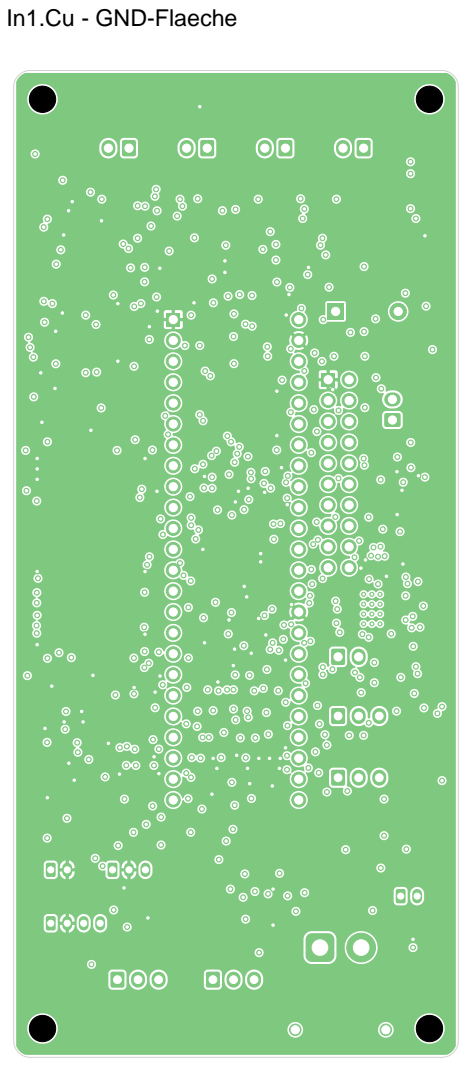
[picture p94: page 2]

# In2.Cu - Signale

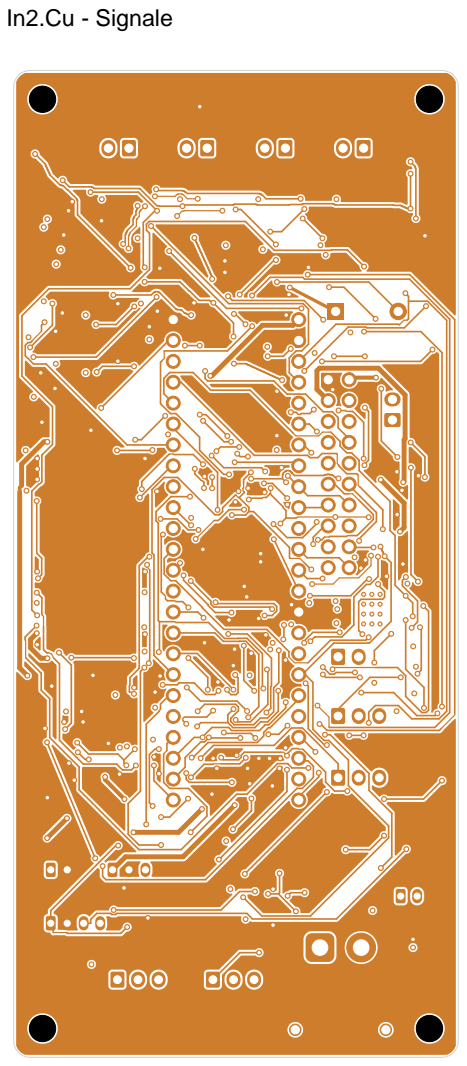
[picture p95: page 3]

# B.Cu - Versorgungsflaeche GND_PWR / 5V_SYS

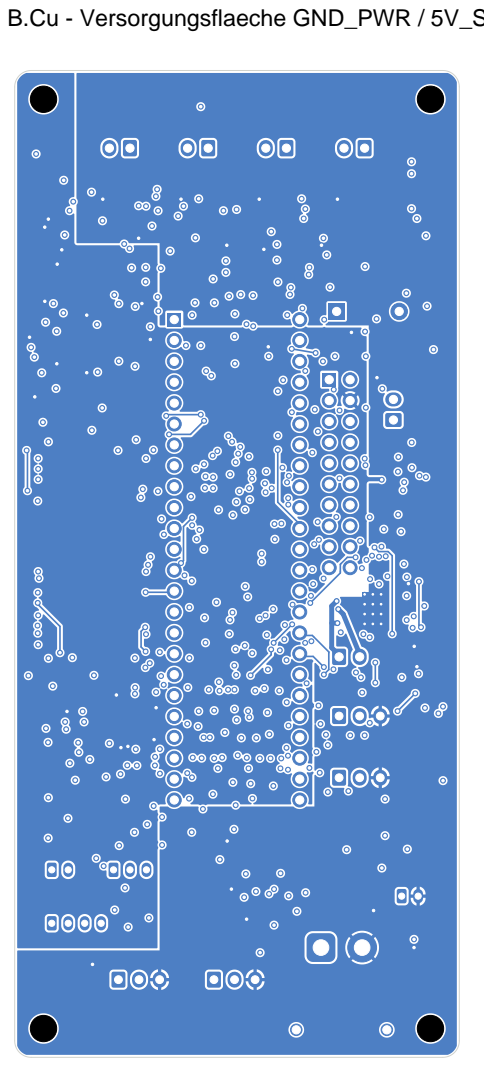
[picture p96: page 4]

LEGS MOT PYRO4 | QWIIC
C12 | D3 SMAJ12CA | R36 100k R36 R17 115k R17 SJ 2S

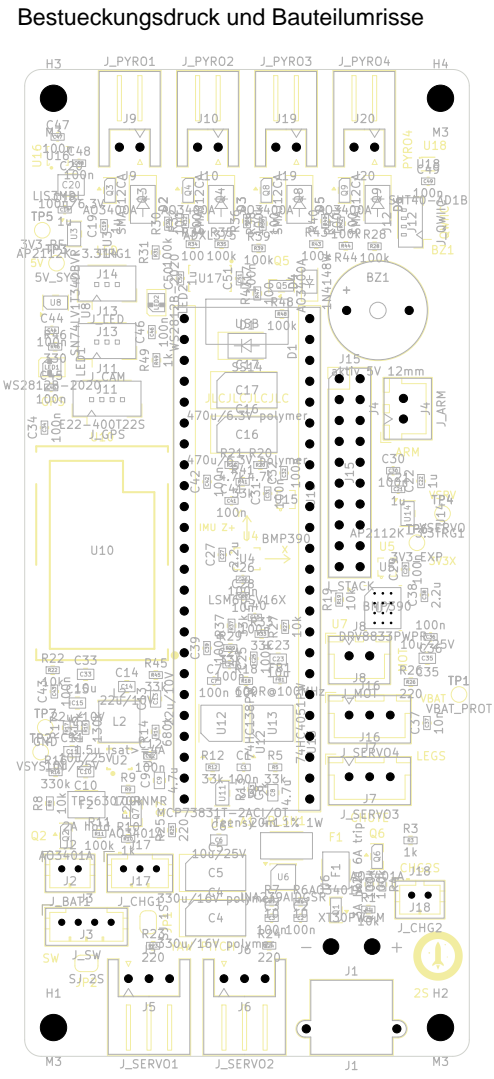
[picture p97: page 5]
