Jan-Philipp-Munsch/kartonaut/hardware/mainboard/kicad/mainboard.kicad_pcb

## KiCad design hardware/mainboard/kicad/mainboard.kicad_pcb (2026-10-26)

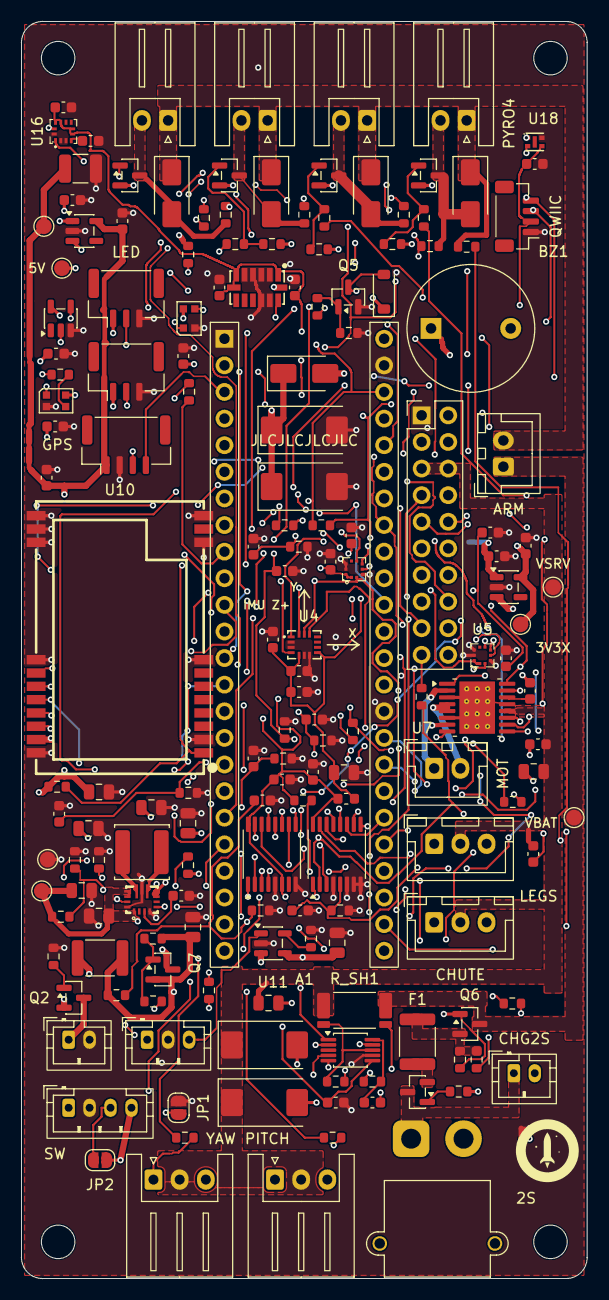
[picture p98: board mainboard.kicad_pcb from above]

Board: 4 copper layers, 54.0 x 120.0 mm, 174 parts (0 on the bottom side), 117 nets.

Parts:
A1: Teensy 4.1; Teensy41_Socket
BZ1: aktiv 5V 12mm; Buzzer_12x9.5RM7.6
C1, C2, C3, C7, C12, C24, C25, C26, C29, C30, C31, C32, C34, C36, C39, C40, C41, C42, C43, C44, C45, C46, C47, C48, C49, C51: 100n; C_0603_1608Metric
C4, C5: 330u/16V polymer; CP_EIA-7343-31_Kemet-D
C6, C10, C11, C35: 10u/25V; C_0805_2012Metric
C8, C9: 4.7u; C_0805_2012Metric
C13, C14, C15: 22u/10V; C_0805_2012Metric
C16, C17: 470u/6.3V polymer; CP_EIA-7343-31_Kemet-D
C18, C19, C21, C22, C50: 1u; C_0603_1608Metric
C20: 100u/6.3V; C_1210_3225Metric
C23, C33: 10u; C_0805_2012Metric
C27, C38: 2.2u; C_0603_1608Metric
C28, C37: 10n; C_0603_1608Metric
D1: SS14; D_SMA
D2, D3, D5, D6: SMAJ12CA; D_SMA
D4: 1N4148W; D_SOD-123
F1: 3A hold 6A trip; Fuse_1812_4532Metric
F2: 2A hold; Fuse_1812_4532Metric
FB1: 600R@100MHz; L_0603_1608Metric
H1, H2, H3, H4: M3; MountingHole_3.2mm_M3
J1: XT30PW-M; AMASS_XT30PW-M_1x02_P2.50mm_Horizontal
J2: J_BAT1; JST_PH_B2B-PH-K_1x02_P2.00mm_Vertical
J3: J_SW; JST_PH_B4B-PH-K_1x04_P2.00mm_Vertical
J4: J_ARM; JST_XH_B2B-XH-A_1x02_P2.50mm_Vertical
J5: J_SERVO1; JST_XH_S3B-XH-A_1x03_P2.50mm_Horizontal
J6: J_SERVO2; JST_XH_S3B-XH-A_1x03_P2.50mm_Horizontal
J7: J_SERVO3; JST_XH_B3B-XH-A_1x03_P2.50mm_Vertical
J8: J_MOT; JST_XH_B2B-XH-A_1x02_P2.50mm_Vertical
J9: J_PYRO1; JST_XH_S2B-XH-A_1x02_P2.50mm_Horizontal
J10: J_PYRO2; JST_XH_S2B-XH-A_1x02_P2.50mm_Horizontal
J11: J_GPS; JST_GH_BM04B-GHS-TBT_1x04-1MP_P1.25mm_Vertical
J12: J_QWIIC; JST_SH_BM04B-SRSS-TB_1x04-1MP_P1.00mm_Vertical
J13: J_CAM; JST_GH_BM03B-GHS-TBT_1x03-1MP_P1.25mm_Vertical
J14: J_LED; JST_GH_BM03B-GHS-TBT_1x03-1MP_P1.25mm_Vertical
J15: J_STACK; PinHeader_2x10_P2.54mm_Vertical
J16: J_SERVO4; JST_XH_B3B-XH-A_1x03_P2.50mm_Vertical
J17: J_CHG1; JST_PH_B3B-PH-K_1x03_P2.00mm_Vertical
J18: J_CHG2; JST_PH_B2B-PH-K_1x02_P2.00mm_Vertical
J19: J_PYRO3; JST_XH_S2B-XH-A_1x02_P2.50mm_Horizontal
J20: J_PYRO4; JST_XH_S2B-XH-A_1x02_P2.50mm_Horizontal
JP1: SJ 1S; SolderJumper-2_P1.3mm_Open_RoundedPad1.0x1.5mm
JP2: SJ 2S; SolderJumper-2_P1.3mm_Open_RoundedPad1.0x1.5mm
L2: 1.5u Isat>=4A; L_Changjiang_FNR5040S
LED1, LED2: WS2812B-2020; LED_WS2812B-2020_PLCC4_2.0x2.0mm
NT1: NetTie; NetTie-2_SMD_Pad0.5mm
Q1, Q2, Q6, Q7: AO3401A; SOT-23
Q3, Q4, Q5, Q8, Q9: AO3400A; SOT-23
R1, R8, R18, R19, R22, R27: 10k; R_0603_1608Metric
R2, R4, R9, R11, R28, R31, R32, R35, R36, R39, R40, R43, R44, R48: 100k; R_0603_1608Metric
R3, R10, R49: 1k; R_0603_1608Metric
R5, R12, R29, R33, R37, R41, R45: 33k; R_0603_1608Metric
R6, R7: 10; R_0603_1608Metric
R13: 2k; R_0603_1608Metric
R14: 680k; R_0603_1608Metric
R15: 130k; R_0603_1608Metric
R16: 330k; R_0603_1608Metric
R17: 115k; R_0603_1608Metric
R20, R21: 4.7k; R_0603_1608Metric
R23, R24, R25, R26: 220; R_0603_1608Metric
R30, R34, R38, R42, R47: 100; R_0603_1608Metric
R46: 330; R_0603_1608Metric
R_SH1: 20m 1% 1W; R_2512_Kelvin
TP1: VBAT_PROT; TestPoint_Pad_D1.5mm
TP2: VSYS_IN; TestPoint_Pad_D1.5mm
TP3: 5V_SYS; TestPoint_Pad_D1.5mm
TP4: VSERVO; TestPoint_Pad_D1.5mm
TP5: 3V3_RF; TestPoint_Pad_D1.5mm
TP6: 3V3_EXP; TestPoint_Pad_D1.5mm
TP7: GND; TestPoint_Pad_D1.5mm
U2: TPS63070RNMR; VQFN-15_L3.0-W2.5-P0.50-BL
U3, U14: AP2112K-3.3TRG1; SOT-23-5
U4: LSM6DSV16X; LGA-14_L3.0-W2.5-P0.50-TL
U5, U15: BMP390; LGA-10_L2.0-W2.0-P0.50-BL
U6: INA239AIDGSR; MSOP-10_3x3mm_P0.5mm
U7: DRV8833PWPR; HTSSOP-16-1EP_4.4x5mm_P0.65mm_EP3.4x5mm_Mask2.46x2.31mm_The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
U8: SN74LV1T34DBVR; SOT-23-5
U10: E22-400T22S; WIRELM-SMD_E22-400T22S_1
U11: MCP73831T-2ACI/OT; SOT-23-5
U12: 74HC138PW; TSSOP-16_4.4x5mm_P0.65mm
U13: 74HC4051PW; TSSOP-16_4.4x5mm_P0.65mm
U16: LIS3MDL; LGA-12_L2.0-W2.0-P0.50-BL
U17: ADXL375; LGA-14_L5.0-W3.0-P0.80-BL-1
U18: SHT40-AD1B; DFN-4_L1.5-W1.5-P0.8-TL-EP

Connections:
3V3: A1.15, A1.27, C3.1, C24.1, C25.1, C47.1, C49.1, C50.1, C51.1, FB1.1, J12.2, R18.1, R20.1, R21.1, R27.1, U6.6, U12.6, U12.16, U13.16, U16.5, U16.6, U16.9, U16.10, U17.1, U17.6, U17.7, U18.3
3V3_EXP: C22.1, J15.3, TP6.1, U14.5
3V3_RF: C19.1, C20.1, C33.1, C34.1, J11.1, R22.1, TP5.1, U3.5, U10.25
3V3_SENS: C23.1, C26.1, C27.1, C28.1, C29.1, C30.1, C31.1, C32.1, FB1.2, U4.5, U4.8, U5.1, U5.10, U15.1, U15.10
5V_SYS: BZ1.1, C13.1, C14.1, C15.1, C18.1, C21.1, C44.1, C45.1, C46.1, D1.2, D4.1, J13.1, J14.1, J15.4, LED1.4, LED2.4, R14.1, TP3.1, U2.7, U3.1, U3.3, U8.5, U14.1, U14.3
ARM_EXT: J15.19, R19.2
ARM_SENSE: C39.1, R19.1, R28.2, R29.1, U13.2
BUZZER: A1.44, R47.1
BZ_G: Q5.1, R47.2, R48.1
BZ_NEG: BZ1.2, D4.2, Q5.3
CAM_TRIG: A1.9, R49.1
CAM_TRIG_OUT: J13.2, R49.2
CHG_PROG: R13.1, U11.5
CHG_STAT: J17.3, U11.1
CS_BARO: U5.6, U12.14
CS_BARO2: U12.13, U15.6
CS_EN: A1.23, R18.2, U12.4
CS_EXT0: J15.10, U12.11
CS_EXT1: J15.11, U12.10
CS_EXT2: J15.12, U12.9
CS_IMU: U4.12, U12.15
CS_INA: U6.1, U12.12
EXT_RX: A1.30, J15.16
EXT_TX: A1.31, J15.17
GND: A1.1, A1.26, A1.39, C1.2, C3.2, C7.2, C8.2, C9.2, C10.2, C11.2, C12.2, C13.2, C14.2, C15.2, C16.2, C17.2, C18.2, C19.2, C20.2, C21.2, C22.2, C23.2, C24.2, C25.2, C26.2, C27.2, C28.2, C29.2, C30.2, C31.2, C32.2, C33.2, C34.2, C39.2, C40.2, C41.2, C42.2, C43.2, C44.2, C45.2, C46.2, C47.2, C48.2, C49.2, C50.2, C51.2, J2.2, J3.2, J11.2, J12.1, J13.3, J14.3, J15.1, J17.2, JP1.2, LED1.2, LED2.2, NT1.2, Q5.2, R5.2, R8.2, R12.2, R13.2, R15.2, R17.2, R29.2, R33.2, R37.2, R41.2, R45.2, R48.2, TP7.1, U2.4, U2.10, U2.15, U3.2, U4.2, U4.3, U4.6, U4.7, U5.3, U5.8, U5.9, U6.7, U8.3, U10.2, U10.8, U10.11, U10.13, U10.14, U10.15, U10.16, U10.19, U10.26, U11.2, U12.5, U12.8, U13.4, U13.6, U13.7, U13.8, U14.2, U15.3, U15.8, U15.9, U16.2, U16.3, U16.12, U17.2, U17.3, U17.4, U17.5, U17.11, U17.12, U18.4
GND_PWR: C4.2, C5.2, C6.2, C35.2, C36.2, C38.2, J1.2, J3.4, J5.3, J6.3, J7.3, J15.2, J16.3, J18.2, JP2.2, NT1.1, Q3.2, Q4.2, Q8.2, Q9.2, R1.2, R31.2, R35.2, R39.2, R43.2, U7.3, U7.6, U7.13, U7.17
GPS_RX: A1.3, J11.4
GPS_TX: A1.2, J11.3
IMU_INT: A1.6, U4.4
INA_INN: C2.2, R7.2, U6.9
INA_INP: C2.1, R6.2, U6.10
IRQ_EXT: A1.34, J15.13
ISENS_N: R7.1, R_SH1.3, U6.8
ISENS_P: R6.1, R_SH1.2
LED1_DIN: LED1.3, R46.2
LED2_DIN: LED1.1, LED2.3
LED_5V: R46.1, U8.4
LED_DATA: A1.7, U8.2
LED_EXT_DATA: J14.2, LED2.1
LORA_AUX: A1.45, U10.24
LORA_M0: A1.35, U10.20
LORA_M1: A1.24, U10.21
LORA_NRST: A1.8, R22.2, U10.1
LORA_RXD: A1.46, U10.22
LORA_TXD: A1.47, U10.23
MAG_C1: C48.1, U16.4
MOT_A: J8.1, U7.2, U7.7
MOT_B: J8.2, U7.4, U7.5
MOT_FAULT: A1.10, R27.2, U7.8
MOT_IN1: A1.4, U7.9, U7.16
MOT_IN2: A1.5, U7.10, U7.15
MOT_NSLEEP: A1.41, U7.1
MUX_OUT: A1.16, U13.3
NRST_EXT: A1.36, J15.20
PWM_EXT: A1.48, J15.18
PYRO1_FIRE: A1.28, R30.1
PYRO1_G: Q3.1, R30.2, R31.1
PYRO1_NEG: D2.2, J9.2, Q3.3, R32.1
PYRO1_SENSE: C40.1, R32.2, R33.1, U13.13
PYRO2_FIRE: A1.29, R34.1
PYRO2_G: Q4.1, R34.2, R35.1
PYRO2_NEG: D3.2, J10.2, Q4.3, R36.1
PYRO2_SENSE: C41.1, R36.2, R37.1, U13.14
PYRO3_FIRE: A1.40, R38.1
PYRO3_G: Q8.1, R38.2, R39.1
PYRO3_NEG: D5.2, J19.2, Q8.3, R40.1
PYRO3_SENSE: C42.1, R40.2, R41.1, U13.15
PYRO4_FIRE: A1.37, R42.1
PYRO4_G: Q9.1, R42.2, R43.1
PYRO4_NEG: D6.2, J20.2, Q9.3, R44.1
PYRO4_SENSE: C43.1, R44.2, R45.1, U13.12
Q1_G: Q1.1, R1.1
Q2_G: Q2.1, R8.1
Q6_G: Q6.1, R2.1, R3.1
Q7_G: Q7.1, R9.1, R10.1
SCL: A1.32, J12.4, J15.15, R21.2, U16.1, U17.14, U18.2
SDA: A1.33, J12.3, J15.14, R20.2, U16.11, U17.13, U18.1
SEL0: A1.43, U12.1, U13.11
SEL1: A1.17, U12.2, U13.10
SEL2: A1.22, U12.3, U13.9
SERVO_CHUTE: A1.11, R25.1
SERVO_CHUTE_S: J7.1, R25.2
SERVO_LEGS: A1.12, R26.1
SERVO_LEGS_S: J16.1, R26.2
SERVO_PITCH: A1.21, R24.1
SERVO_PITCH_S: J6.1, R24.2
SERVO_YAW: A1.20, R23.1
SERVO_YAW_S: J5.1, R23.2
SPI0_MISO: A1.14, J15.9
SPI0_MOSI: A1.13, J15.8
SPI0_SCK: A1.38, J15.7
SPI1_MISO: A1.42, U4.1, U5.5, U6.4, U15.5
SPI1_MOSI: A1.18, U4.14, U5.4, U6.2, U15.4
SPI1_SCK: A1.19, U4.13, U5.2, U6.5, U15.2
SW1_G: J3.1, JP1.1, R10.2
SW2_G: J3.3, JP2.1, R3.2
TEENSY_VIN: A1.25, C16.1, C17.1, D1.1
U2_EN: R16.2, R17.1, U2.14
U2_FB: R14.2, R15.1, U2.5
U2_L1: L2.1, U2.11
U2_L2: L2.2, U2.9
U2_VAUX: C12.1, U2.3
U7_VCP: C37.1, U7.11
U7_VINT: C38.1, U7.14
VBAT1_F: C9.1, F2.2, Q7.2, R9.2, R11.1, U11.3
VBAT1_RAW: J2.1, Q2.3
VBAT1_REV: F2.1, Q2.2
VBAT1_SENSE: C7.1, R11.2, R12.1, U13.1
VBAT2_F: F1.2, Q6.2, R2.2, R4.1
VBAT2_RAW: J1.1, J18.1, Q1.3
VBAT2_REV: F1.1, Q1.2
VBAT2_SENSE: C1.1, R4.2, R5.1, U13.5
VBAT_ARMED: D2.1, D3.1, D5.1, D6.1, J4.2, J9.1, J10.1, J19.1, J20.1, R28.1
VBAT_PROT: J4.1, Q6.3, R_SH1.1, TP1.1
VBUS_CHG: C8.1, J17.1, U11.4
VSERVO: C4.1, C5.1, C6.1, C35.1, C36.1, C37.2, J5.2, J6.2, J7.2, J15.5, J15.6, J16.2, R_SH1.4, TP4.1, U7.12
VSYS_IN: C10.1, C11.1, Q7.3, R16.1, TP2.1, U2.1, U2.12
