Jan-Philipp-Munsch/kartonaut/hardware/mainboard/kicad/make_guide.py

"""Rundgang durch die Platine als PDF: RUNDGANG_PLATINE.pdf (system Python with Pillow and reportlab).

    "%LOCALAPPDATA%/Programs/KiCad/10.0/bin/python.exe" guide_dump.py     # board geometry -> out/guide/board.json
    python make_guide.py                                                  # pictures and PDF

Uses the renders in img/ (./make.sh img) and draws its own pictures from the board (guide_figures.py)."""
import json
from pathlib import Path

from PIL import Image
from reportlab.lib import colors
from reportlab.lib.enums import TA_CENTER
from reportlab.lib.pagesizes import A4
from reportlab.lib.styles import ParagraphStyle
from reportlab.lib.units import cm
from reportlab.pdfbase import pdfmetrics
from reportlab.pdfbase.ttfonts import TTFont
from reportlab.platypus import (Image as RLImage, KeepTogether, PageBreak, Paragraph, SimpleDocTemplate, Spacer,
                                Table, TableStyle)

import guide_figures as gf

HERE = Path(__file__).resolve().parent
OUT = HERE / "RUNDGANG_PLATINE.pdf"
pdfmetrics.registerFont(TTFont("Arial", "C:/Windows/Fonts/arial.ttf"))
pdfmetrics.registerFont(TTFont("Arial-Bold", "C:/Windows/Fonts/arialbd.ttf"))
pdfmetrics.registerFont(TTFont("Arial-Italic", "C:/Windows/Fonts/ariali.ttf"))
from reportlab.pdfbase.pdfmetrics import registerFontFamily
registerFontFamily("Arial", normal="Arial", bold="Arial-Bold", italic="Arial-Italic", boldItalic="Arial-Bold")
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
