Jan-Philipp-Munsch/kartonaut/(commit log)

2025-10-13 kalman filter optimization
2025-10-20 Gyro integration and radio test
2025-10-26 deleted groundcode
2026-10-15 groundcode als eigenes Repo ignorieren
2026-10-20 Firmware: Flugschleife in main.cpp wiederhergestellt, Parameter in Config.h, Regler-Schnittstelle ohne doppelte Integration, Gyro-Bit- und Logger-Fixes, Test-Sketches als examples/
    - Main.ino -> main.cpp, loop() wieder aktiv (MOSFET-Test nach examples/pyro_mosfet_test)
    - Gewinne, Servo-Geometrie, Fenster, Gyro-Offsets, PWM-Parameter nach Config.h
    - Control_updatePY/updateRoll nehmen den Winkel aus main.cpp, RollOutput-Struct
    - Read_IMU prueft DMP_header_bitmap_Gyro statt Gyro_Calibr
    - LoopTimer_slack_us() an SDLogger_logFrame, unskaliertes CSV-Format mit 40 Kanaelen
    - sketches/ (auskommentierte Monolithe) geloescht, Radio_test -> examples/radio_beacon
    - platformio.ini: lib_deps auf genutzte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
2026-10-20 Repo: README, Projektdatei, Mainboard rev A und Render-Skript aufgenommen, eLab aus dem Index
    - README.md als Einstieg fuer die Veroeffentlichung, spacecode/README.md fuer die Firmware
    - PROJECT.md, hardware/mainboard/ und docs/ (seit 15.10. untracked) ins Repo
    - eLab/ (OneNote) aus dem Index, bleibt lokal; .gitignore erweitert
    - Verweise auf geloeschte Sketches und Main.ino in Hardware-README und PROJECT.md angepasst
    - PROJECT.md: Befunde 9 und 10, Aenderungsprotokoll 20.10.
2026-10-20 Veroeffentlichung: MIT-Lizenz, englisches README (deutsch als README.de.md), lokale Pfade aus PROJECT.md
2026-10-21 Plan 21.10.: Mainboard-Review mit Bauteilalternativen und Kosten, Portierung der Simulation nach Python, Baudokumentation, offene Fragen
2026-10-21 Baudokumentation angelegt, Bestellungen Klima/SRT als Inventar, Plan um Servos W5652H, LoRa, TSP E12-0 und Rohrmass ergaenzt
2026-10-21 Plan: Versorgungskonzept (ein Akku mit Buck-Boost oder zwei Akkus) und Layout-Checkliste fuer rev B
2026-10-21 Versorgung: Variante B festgelegt (1S fuer Elektronik, 2S fuer Servos, Rollmotor, Pyro), Schaltungsstruktur und Strombudget
2026-10-21 Mainboard rev B spezifiziert: zwei Akkus, ICM-42688-P, BMP390, LoRa E22-400T22S, W5652H am 2S, Pinbelegung, Stueckliste, Testplan; rev A archiviert; Antworten vom 21.10. in Plan, Projektdatei und Bau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
2026-10-21 Simulation: 6DOF-Modell von Simulink nach Python portiert (simulation/, Paket tvcsim)
    Port von TVC6DOF_sim.slx, TVC6DOF.m und pid_tuner.m: Dynamik, Schub, Avionics, Estimator,
    Regler, Aktuator 1:1; Servo-Uebertragungsfunktion aus den Sprungantworten neu gefittet
    (PT2 mit Totzeit, K 1/6, 5,8 Hz, 30 ms); Treibstoffkurve aus dem Signal Builder der .slx
    ausgelesen. Zweiter Regler rechnet wie Control.cpp (Kp 5, Ki 0, Kd 1, Skala -100, Servo-
    Fenster, Gain 23) und ist ueber kd = Kd/100 mit dem Simulink-Regler vergleichbar.
    Tests (21), Skripte fuer Nominallauf, Monte-Carlo, PID-Raster, Servo-Fit und Reglervergleich.
    Ergebnis im README: Firmware-Gewinne stabilisieren, Tuner-Gewinne (kd 0,385) schwin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
2026-10-21 Simulation: Plots mit zweizeiligem Titel und gleich skalierten 3D-Achsen, drei Bilder fuer das README unter docs/img/sim
    Servo-Fit, Reglervergleich (preload, spezifische Kraft) und Monte-Carlo (preload) als tracked
    Kopien mit 150 dpi; run_montecarlo.py sichert die Trajektorien als npz und kann daraus neu
    plotten (--replot).
2026-10-21 Mainboard rev B: Design Guide mit Abbildungen, Bestellplan, Elektronik-Zusammenfassung
    - docs/DesignGuide_Mainboard_revB.md (+ PDF ueber docs/build_design_guide.py, Chrome headless):
    Elektronik auf einen Blick, rev A -> rev B, Einbau, Versorgung, Sensorik, Funk, Aktoren,
    Pyro, Pinbelegung, Layout-Regeln, Fertigung, Inbetriebnahme, Fragen an den Reviewer, Stueckliste
    - hardware/mainboard/figures.py erzeugt img/: Blockschaltbild, Versorgungsbaum, Pyro-Kanal,
    Teensy-Pinbelegung, Einbau-Laengsschnitt, Weg zur Platine
    - hardware/mainboard/ORDER.md: Vorab-Bestellliste, Tore 1-4, JLCPCB-Parameter und Dateien,
    LCSC-Status der Hauptbauteile (BMP390 zuletzt ohne Bestand -> BMP388, TPS63070 sch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
2026-10-21 CAD: Blender-Inventur, Massenmodell und parametrisches CadQuery-Modell in cad/
    Inventur der 16 Blender-Dateien (cad/blender_inventory.md, Renderbilder docs/img/cad/blender_*.png):
    juengster Stand je Baugruppe, Ueberholtes, Masskonflikte mit den gekauften Teilen; model_rocket.blend
    enthaelt den Kardan in der alten Kopie ohne Servotaschen.
    Massenmodell als Stabmodell (cad/mass_model.py -> mass_properties.md/.json): Start 981 g, Schwerpunkt
    448 mm ab Duese, Hebelarm Kardan-Schwerpunkt 0,37 m, Ixx = Iyy = 0,110 kg m^2, Izz = 0,0010 kg m^2;
    Brennschluss und ohne Motor ebenso.
    Parametrisches Modell (cad/params.py, Module Rumpf/Kardan/Flugcomputer/Kolben/Beine, cad/build.py):
    STEP/STL je Baugrupp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
2026-10-21 README neu gegliedert (en/de): Uebersicht, Projektstand, Simulationsergebnisse, rev B mit Design Guide, CAD-Modell mit Massen; Projektdatei mit Befunden 11-15, Baudoku und Plan nachgezogen
2026-10-21 Simulation: dritter Fahrzeugsatz aus dem CAD-Massenmodell (VehicleParams.cad, --vehicle cad), Gewinnvergleich damit im README
    Liest cad/mass_properties.json (Startzustand): m_dry = 981 g - 28 g, Hebelarm 0,372 m,
    Ix = Izz (laengs), Iy/Iz = Ixx/Iyy, seitliche Schwerpunktlage als mis_y/mis_z. Test fuer den
    Achsentausch. Ergebnis: Firmware-Gewinne halten die Brennphase unter 4 Grad Kippwinkel,
    die E12 traegt die 1,0 kg aber nur auf 9 m.
2026-10-21 Befund 12: Ergebnis mit dem CAD-Massenmodell (9 m Gipfel, Schub-Gewicht 1,1)
2026-10-21 Inventar: Carbonstaebe fuer die Landebeine (Conrad) und Pruefstand-Antrieb (Banggood: BR2814, ESC, Propeller, 4S-LiPo, Lader); TVC-Pruefstand als Paket 15 und in den READMEs
2026-10-21 Pruefstand als cad/testrig.py (Gestell, Rahmen, Klemmkragen, Prop-Adapter BR2814, Schutzkaefig, Kollisionspruefung, Renderbilder); Simulation mit Boden: Rampe haelt, Lauf endet bei der Landung, Befun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
2026-10-21 Simulation: Schalter --single-motor (Erstflug ohne zweite Zuendung), README-Reglervergleich damit neu gerechnet; Renderbilder aus dem Rig-Build
2026-10-21 Monte-Carlo-Bild mit Boden: Trajektorien enden bei der Landung
2026-10-21 KiCad-Projekt rev B: Schaltung als Code (circuit.py), Schaltplan mit 7 Blaettern (ERC sauber), Platinen-Generator mit Platzierungsentwurf; Ablauf und offene Punkte in kicad/README.md
2026-10-21 Projektdatei und READMEs: KiCad-Projekt rev B (Schaltplan aus Code, ERC sauber, Platzierung im Entwurf) aufgenommen
2026-10-21 Tor-1-Pruefung: Netzliste circuit.py gegen Spezifikation rev B (konform, vier Hinweise); Spezifikation um Pin 8 MOT_FAULT und entfallenen Reset-Taster ergaenzt
2026-10-21 Design Guide und Bestellplan auf den KiCad-Stand und die Tor-1-Pruefung gezogen
    - Pin 8 MOT_FAULT in der Pinbelegung, Reset-Taster entfallen, SMBJ12CA, KiCad-Status im Ablaufbild
    - ORDER.md: Tor 1 mit Netzlistenpruefung und offenen Hinweisen (FB2, Doppelpins, E22 NRST, ICM RESV),
    Tor 2 mit Platzierungsstand und 1,2-mm-Bahnen, ICM-42688-P Herstellerpruefung (Tokmas-Datenblatt),
    Zoll 3 EUR je Position seit 07/2026, Verweis auf Fertiger_2026-10-21.md
    - Guide: KiCad-Entscheidungen, Fertigervergleich, Reviewer-Frage 10 aus der Pruefung, Anhang B
2026-10-21 Platine rev B geroutet: alle 134 Footprints platziert, DRC ohne Fehler, 3 offene Verbindungen; Renders und Lagenbilder; Fertigervergleich
    - Lagen: In1 GND, B.Cu geteilte Versorgungsflaeche GND_PWR/5V_SYS, Plane-Vias an jedem SMD-Pad
    - Freerouting 2.5.0 (JAR, Temurin 25) mit zwei Nachlaeufen auf fixierter Verdrahtung und kollisionsgeprueften Stummeln
    - check_design.py: Netzliste gegen Spezifikation §4 (OK), make.sh fuer die ganze Kette
    - 3D-Modelle Teensy 4.1 und XT30PW-M (CadQuery), Renders und layers.pdf in kicad/img
    - Fertiger_2026-10-21.md: JLCPCB empfohlen, Aisler als EU-Rueckfall, BMP390 bei JLC nicht lieferbar
    - naechster Schritt laut kicad/README.md §8: Review-Punkte A1-A5 (review_k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
2026-10-21 KiCad: Hinweis zu den TPS63070-Doppelpins in build_lib.py; Punkte der Netzlistenpruefung (FB2 offen, E22-NRST, ICM-Hersteller) in den naechsten Schritten, RESV-Belegung gegen DS-000347 bestaetigt
2026-10-21 Review KiCad-Projekt rev B (zweite Meinung): Schaltung gegen Datenblaetter, Layout-Pruefskript
    Befunde A1-A8 vor der Bestellung: TPS63070-Ausgangskapazitaet ueber Datenblatt,
    1S-Unterspannungsabschaltung im Flug, Hauptschalter im Strompfad ueber JST-PH, Sicherungen je Akku,
    Kelvin-Abgriff am Shunt, 2S-Netze auf der 0,5-oz-Innenlage an der IMU vorbei, 1S-Zuleitung 0,25 mm,
    5V_SERVO 0,15 mm. B/C: SPI fuer das Barometer, Summer-Pin, LED-Kette, Polymer-Elkos, Erweiterung fuer
    Landung, Redundanz, Kosten, Logo. review_check_layout.py prueft Stromnetze, Kelvin, IMU-Umfeld.
2026-10-21 KiCad-README: naechste Schritte um die Layout-Punkte A6-A8 des Reviews erweitert (Strompfade als F.Cu-Flaechen vorab)
2026-10-21 Doku auf den Review-Stand: READMEs, Projektdatei, Design Guide (PDF neu), Fertiger-Entscheidung, Bestellliste
    READMEs und PROJECT.md: Platine geroutet, Zweitmeinung-Review mit acht A-Punkten, naechste Schritte.
    Fertiger_2026-10-21.md: Entscheidung JLCPCB Economic (BMP388 statt des nicht lieferbaren BMP390,
    Aisler als Rueckfall mit Ausloesern). ORDER.md: Tore mit den Review-Punkten, Teilestatus und neue Teile,
    Kosten, Bestellliste nach Haendlern (7.1 jetzt, 7.2 mit der Platine, 7.3 Reserve-Chips, 7.4 Reihenfolge).
    Design Guide: Stand, Review-Antworten zu den Reviewer-Fragen, Dateien. Spezifikation: Zeiger auf das Review.
2026-10-22 Fragerunde 22.10.: Entscheidungen E1-E8, Bauteile nach Schiene und Schnittstelle, Rohrmaterial-Recherche
2026-10-22 Komponenten 22.10.: Rollmotor direkt am 2S (kein Buck), Stapelstecker J_STACK, Pin-Bilanz mit CS-Decoder und Analogmux
2026-10-22 CAD Erstflug-Konfiguration: Rohr 700 mm (min. 665), 719 g, Luken A/B im Kuppler, Schlüsselschalter-Kragen, Kolbenabstand 11 mm
    params.layout(config) mit voll/erstflug, Massenmodell für alle Varianten (PROP_*-Namenskonflikt behoben),
    build.py --config erstflug mit Prüfung von Luken, Steckerräumen und Kolbenbohrung, Renders hatches_*.png.
2026-10-22 Prüfung Erstflug-CAD: Luke A bis v = 115 (gerader Micro-USB-Stecker), drei M2 im unteren Rohr, Wartung und SD-Lage im README; Schnittstellen Rakete/Pad/Bodenstation/Handy
2026-10-22 Bodenstation: Konzept, Sicherheit, Schaltung mit Zündkreis, Stückliste und ESP32-S3-Firmware mit Weboberfläche
    README (Startsperre, Ablauf am Startplatz, Abweichungen von S3: Luftrate 9,6 kbit/s,
    SRD-Sendeleistung, E22-T22D), Schaltung.md (Pinbelegung, Durchgangsprüfung 1 mA sicher /
    6,2 mA scharf, Zündstrom ca. 8 A), PlatformIO-Projekt: WLAN-AP, WebSocket JSON,
    Zünd-Zustandsautomat, E22-Konfiguration, Funkprotokoll als austauschbarer Platzhalter.
2026-10-22 Start- und Landepad (cad/landingpad.py): Achteck 1250 aus zwei Hälften mit Stahlblech, Strahlplatte 100 mm unter der Düse, drei abnehmbare Stützen mit Auflagen und Führungen (1,5 mm Luft, 160 mm), Zü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
2026-10-22 Datenblatt MS-MB-B rev B (LaTeX, 17 Seiten): Grenzwerte, Pinbelegung, Funktion, Mechanik, Stueckliste aus circuit.py, beschlossene Aenderungen
2026-10-22 Erstflug-CAD nach zweiter Prüfung: Rohr 500 + 200 mit Stoßkuppler (131 + 569 nicht herstellbar), Fenster 14 mm mit Stangenlücke als Prüfung, Wandprüfung der Steckerräume, Öse der Spitze im Schnurraum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
2026-10-22 Startrampe statt Start-/Landepad: Siebdruck 600 × 600 mit Loch Ø 130 (Strahl in die Erde), drei Gewindestangen-Beine M10 einzeln verstellbar (bis 23° Neigung), abgestrebte Stützen außerhalb des Strah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
2026-10-22 Bodenstation Sparvariante (Module, ca. 80 € statt 130 €, ein Abend Bauzeit) und Budgetplan bis zum Erstflug
    groundstation: Stückliste in Spar- und Lochraster-Variante, gleiche Schaltung und Firmware;
    E22 und Antenne aus ORDER 0.3/0.4 nicht doppelt gezählt. docs/Budget_2026-10-22.md:
    offene Posten nach Block und Zeitpunkt (ca. 1070 € + 15 % Reserve), Inventar, Sparhebel,
    Unsicherheiten (Versicherung bis 20 g Treibsatz, Platinenlauf).
2026-10-22 Kartonaut: Name, Missionsabzeichen, Bestückungsdruck neu, Lötstopp blau
    - Projekt heißt Kartonaut (Karton + Astronaut); Flüge werden hochgezählt, Erstflug = Kartonaut 1
    - Abzeichen als Polygone in hardware/mainboard/kicad/logo.py, SVGs in docs/brand/
    - spacecode/ -> firmware/, Bodenstation-Repo groundcode -> kartonaut-ground (Links, .gitignore)
    - gen_pcb.py silk: Bestückungsdruck nur neu setzen, auf der gerouteten Platine; 1,0 mm Schrift,
    freie Plätze statt Überlappungen, Kurznamen an den Steckern, Testpunkte mit Netznamen,
    kleines Abzeichen vorn; hinten Abzeichen 20 mm und Steckerbelegung
    - Stackup JLC04161H-7628 mit blauem Lötstopp im Board, Renders mit Stackup-Farben
    - DRC-Dr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
2026-10-22 Firmware rev B vorbereitet: Pins, SPI-Treiber ICM-42688-P/BMP390/INA239, Inbetriebnahme-Programm, Pin-Abgleich; Plan bis zum Erstflug
    - lib/mainboard_revb: BoardRevB.h nach circuit.py der Platinen-Session (74HC138-CS-Decoder,
    74HC4051-Mux), BusRevB (SPI1 auf 26/27/39), Treiber ICM42688, BMP390 (erkennt BMP388), INA239
    - examples/revb_bringup: sichere Ausgaenge, dann je Baustein OK/FEHL (Mux, IMU, Barometer,
    INA239, LoRa-Parameter, GPS); Umgebung revb_bringup
    - tools/check_board_pins.py: BoardRevB.h gegen TEENSY, U12 und U13 in circuit.py
    - docs/Plan_2026-10-22.md: Straenge A-E, Meilensteine M1-M7
    Baut warnungsfrei, nicht am Geraet getestet.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
2026-10-22 CI auf GitHub Actions: alle PlatformIO-Umgebungen, Simulationstests, Pin-Abgleich rev B
    Die Umgebungen werden aus platformio.ini gelesen. Der Pin-Abgleich meldet eine Warnung statt
    eines Fehlers, solange circuit.py auf main noch keinen CS-Decoder hat (Exit-Code 2).
2026-10-22 Bauanleitung Kartonaut 1 in Modulbauweise: Prüfung des Erstflug-CAD, Schlitten ohne Gewindestangen, Zeichnungen, 1:1-Bohrschablonen, Teile-Checkliste
    Prüfung (18 Befunde): Kolben blockiert am 80-mm-Stoßkuppler, Antenne/GPS in der abgesprengten Spitze,
    TVC-Stecker der Platine im unteren Endring, Druckteile im Massenmodell halb so schwer wie gezeichnet,
    Kardanschrauben bei 45 Grad an der Rampenführung, symmetrische Lochbilder, Gewinde direkt im Druck.
    Konzept: Rohr 200 + 500 mit dem Stoß im Avionik-Kuppler, Schlitten mit Ausstoßspant auf der Kupplerkante,
    3 x M3 in Einschmelzmuttern bei 0/135/225 Grad, Luken 20/22 mm, Schlüsselring mit Kabelgitter, ca. 757 g.
    cad/modular.py: Druckteile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
2026-10-22 Bauanleitung Stand 2: nach dem gebauten Kardan, CO2-Ausstoß, Schirm in Rohr C, ohne Rollmotor und Schlüsselschalter, Teileliste mit Bestell- und Druckstatus
    Rohr A 125 (Schubstangen-Kardan, gebaut), Rohr B 176 mit Schlitten, Kuppler J1 75 in B verklebt mit
    Schraubring, Spant mit Band zwischen B und C, Rohr C 258 mit CO2-Modul und Schirm 100 x 70. Alle
    Radialschrauben 0/90/180/270 Grad, Rampenführungen auf 45 Grad versetzt. GPS unter dem Spant, LoRa-Wendel
    unten. Kollisionsprüfung frei, ca. 706 g, 794 mm. Zeichnungen Z1-Z6, Schablonen S1-S4 neu.
2026-10-22 Experiment E01: Servo-Kardan-Identifikation als vorgefertigter Versuch
    Sketch firmware/examples/servo_ident (Umgebung servo_ident): fährt je TVC-Achse
    Treppe, Sprünge, Wechselsprünge und zwei Chirps auf den Servo und zeichnet mit
    500 Hz Kommando, Drehrate und Beschleunigung einer ICM-20948 auf dem Motorrohr
    als CSV über USB auf. Servos als 16-Bit-PWM mit der Grad-Puls-Abbildung von
    PWMServo, Fenster und Pins aus Config.h, Befehle über die serielle Konsole.
    Auswertung simulation/tvcsim/ident.py und scripts/ident_servo.py: Kardanwinkel
    aus dem Gyro mit Schwerkraft-Verankerung gegen Drift, statische Kennlinie mit
    Hysterese, Sprungkennwerte, PT2-Fit mit gebrochener Totzeit, Frequenzgang au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
2026-10-22 Bauanleitung Stand 2b: Muttern statt Einschmelzmuttern, 2S LemonRC 450, Spitze über halben Kuppler, konkrete Bestellliste
    Radialschrauben T1-T3 greifen in M3-Muttern in nach innen offenen Sechskant-Taschen; Platine, Scheibe und
    Schalterbrett direkt in 2,6-mm-Kernlöcher. 2S-Fach für LemonRC 2S 450 (55 x 30 x 10). Klima-Spitze über den
    zweiten halben Kuppler (25 mm in der Spitze verklebt), Rohr C 195 mm, Gesamtlänge 731 mm, ca. 689 g.
    Teileliste mit Artikelnummern (Reichelt, Berrybase, Ebyte), Hinweise zum alten GPS, TODO Quaternion.
2026-10-22 Gesamtmodell der geplanten Rakete (Stand 2b) als farbige Baugruppe: STEP und GLB aus cad/modular.py
2026-10-22 Gedruckten Kardan (Blender 12.06.2025) ins Gesamtmodell: Netze aus outer/inner_gimbal_dual_TVC, Lage nach den Schrauben
    Flanschbohrungen der Druckdatei liegen bei 45/135/225/315 Grad; Grundfläche bei z = 38 (Bohrungen auf 44),
    Drehung -45 Grad. GLB zeigt die echten Teile, STEP behält den Hüllkörper. Servotaschen damit bei 225/315 Grad,
    Hinweis zu den Rampenführungen in der Bauanleitung (O1, O4).
2026-10-22 Flug-Firmware: Gyro-Quaternion, Zustandsautomat, Pyro, Telemetrie, Watchdog, zwei Sensor-Backends (Plan B1–B8)
    B1 Attitude.*: Lage als Quaternion aus dem Gyro, Init aus der Schwerkraft auf dem
    Pad, Regelfehler aus dem Oben-Vektor in Servoachsen (Befund 3), Rollwinkel.
    B2 FlightState.*: SAFE → PAD_READY → BOOST → COAST → APOGEE → DESCENT → LANDED,
    ABORT; Schwellen und Zeitrückfälle in Config.h, Ereignisse mit Zeitstempel.
    B3 Pyro.*: Zündung nur in APOGEE/DESCENT, mindestens 2 s nach dem Start, mit ARM
    und Durchgang; 80-ms-Puls, Abbruch bei Durchgangsverlust, Wiederholung,
    Reservekanal. Auf dem Breakout-Aufbau gesperrt (keine Messung).
    B4 Telemetry.h/Crc16.h: Rahmen A5 5A mit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
2026-10-22 Mainboard rev B1: Review A1-A8 und Entscheidungen E1-E10 eingearbeitet, 2S-Pfad als F.Cu-Flaechen, 28 Verbindungen offen
    Schaltung (circuit.py, ERC 0, Netzliste gegen README §4 OK): Hold-up hinter D1, EN-Teiler 330k/115k,
    P-FET-Lastschalter je Akku, Polyfuse je Akku, Kelvin-Shunt mit INA239 an SPI1, BMP390 an SPI1,
    74HC138/74HC4051 mit gemeinsamer Adresse, J_STACK 2x10 mit LDO 3V3_EXP, 1S-Lader MCP73831,
    J_CHG2, vier Pyro-Kanaele (3/4 DNP), vierter Servo, alle Servos und Rollmotor an VSERVO,
    3V3_SENS, eine WS2812B-Kette, Summer Pin 37, E22 NRST Pin 6; 166 Bauteile.
    Platine (gen_pcb.py): neue Platzierung, 2S-Pfad, Pyro-Ausgaenge und VSYS_IN als F.Cu-Flaechen mit
    Sperrflaechen fuer Freerouti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
2026-10-22 Servos, Hebel und Drahtbügel im Gesamtmodell; Servofenster aus der Druckdatei (207/336 Grad), Rampenführungen 45/135/250 Grad
    W5652H in den Servotaschen der Blender-Dateien, Hebel 15 mm hängend, Draht 2 mm 30 mm senkrecht (schematisch,
    Bügel nicht in der Rohrprüfung). Fenster in Rohr A an der berechneten Lage; Zeichnungen und Schablonen mit
    Bestand-Fenstern, Naht der Abwicklung auf 300 Grad (330 lag im Fenster).
2026-10-22 Servohebel und Drahtbügel nach Jans Fotos: Hebel nach oben, Bügel innen an der Wand um 90° zum Stift am angetriebenen Teil
2026-10-22 Zusammenführung 22.10.: Bodenstation und Startrampe gemergt, Massenbudget Stand 2b (723 g), Simulation stand2b, READMEs und Dokus auf Kartonaut 1
    - cad/mass_stand2b.py: Stabmodell der Modulbauweise (Rohr A/B/C, Schlitten mit Spant, CO2-Modul, LoRa-Wendel,
    Schalterbrett): 723 g Start, Schwerpunkt 256 mm, Hebelarm 0,186 m, Ixx 0,0213, Izz 0,00047 kg m^2 -> .md/.json
    - simulation: Fahrzeugsatz stand2b (VehicleParams.stand2b, --vehicle stand2b in run_nominal/compare_gains), Test;
    Ergebnis im README: 63 m Gipfel am E12, Brennphase < 2 Grad Kipp, Landung 9,3 s, Monte-Carlo 63,4 +- 0,4 m
    - README.md / README.de.md neu: Kartonaut 1 Stand 2b auf einen Blick, Projektstand, Bauanleitung, Massenbud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
2026-10-22 Projektdatei und Budget: Entscheidungen Jan 22.10. nachts (abgelegener Startplatz: Versicherung und Funk-Tastgrad nicht relevant; Quaternion laut Jan umgestellt, noch nicht im Repo; Leichtbau der Dru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
2026-10-22 Physik-Durchsicht und Landebrennen mit dem zweiten Motor (Simulation und Firmware)
    Physik (docs/Physik_Review_2026-10-23.md, Befunde P1–P8): Luftwiderstand als
    Option VehicleParams.cd_a in eom(), Beschleunigungs- und Treibstoffmodell
    eingeordnet, Zündung nach Zeit ersetzt, Bodenkontakt mit Hüpfern, Servos im
    freien Fall auf Mitte (coast_center), Platzhalter benannt.
    Simulation: tvcsim/landing.py mit impact_cost (1D-Brennen mit Bodenkontakt),
    LandingPlanner (Zündung im Minimum der Aufsetzkosten für jetzt gegen einen Takt
    später, um den Zündverzug vorausgesagt), IgnitionTable, net_braking_dv;
    MotorParams.second_mode="landing" mit Zündverzug und Schubtoleranz; sim.py
    Landemodus, Konta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
2026-10-22 Leichtbau Druckteile Stand 2c, Gewichtshebel bis 593 g, Reglergewinne per Bayes-Optimierung, Landestudie mit unseren Massen
    - cad/modular.py, modular_params.py: Spantplatte 3,5 mm mit 5-mm-Rand, Zapfen 2 mm, U-Profil statt Klotz,
    Bodenfenster, Scheibe 2 mm, Schraubring 2 mm; Druckmasse nach Slicer-Modell (Oberflaeche x 1 mm voll, Rest 25 %):
    96 -> 80 g. STL, Gesamtmodell, Renders, Zeichnungen, Schablonen und Bauanleitung-PDF neu; Kollisionspruefung frei
    - cad/mass_stand2b.py: 705 g Start (Hebelarm 190 mm), Hebeltabelle und Pakete P1 672 g, P2 631 g, P3 593 g, in der JSON
    unter "levers"; Servoliste im neuen Format der Bauanleitung
    - simulation: scripts/check_stand2b_levers.py (Pakete ge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
2026-10-22 Schubdrossel nach Scout F: Modell, Landeregler und Studie in Simulation und Firmware
    Jan baut eine Drossel mit zwei Pads unter der Düse (BPS Scout F). Modell:
    Axialschub = Motorschub · f(u), f linear von 1 auf f_min, Pads mit der
    Servodynamik des Kardans; f_min unbekannt (0,3 / 0,5 / 0,7 gerechnet).
    Simulation: tvcsim/throttle.py mit ThrottleLandingController (Zündung mit
    Reserve für den schwächsten erwarteten Motor, Schubspitze ungedrosselt mit
    Schätzung des wahren Schubs aus |a|, danach zeitbasierte Führung auf Höhe 0
    und −0,5 m/s zum Brennschluss, Schubabbruch beim Aufsetzen) und
    simulate_landing_1d für Monte-Carlo; ThrottleParams; Aktuatorzustand und
    Schubfaktor in sim.py; sc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
2026-10-22 Platine rev B1: Routing-Kette repariert, Skript-Router für die Reste, 21 offene Verbindungen
    Kette (make.sh, gen_pcb.py): alles auf der Platine für Freerouting fix exportiert, SES durch
    Zusammenführen statt Ersetzen übernommen, Nachläufe auf vier Pässe, IMU-Via-Verbot als Polygon mit
    Löchern um die eigenen Masse-Vias, Patch-Schritt mit 0,2 mm Abstand; ein Lauf 25 statt 40 Minuten.
    Zwei verworfene Varianten (Power-Lagen als Signallagen, angebundene Pads ohne Netz) im Kommentar.
    Neu: gaps.py (offene Verbindungen mit Lage), close_gaps.py (Geometrie-Export, Übernahme) und
    route_gaps.py (A*-Gitterrouter 0,05 mm mit Rip-up von Signalbahnen). Damit sechs der 27 Reste
    geschlossen; die übri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
2026-10-22 Anleitung Handrouting: die 21 offenen Verbindungen mit KiCad-Koordinaten, Regeln, Reihenfolge, Abschluss
2026-10-23 WIP Handrouting rev B1: GND an U6 Pad 7 und U2 Pad 15 per Via, DRC 0 Fehler / 19 offen
    Beide GND-Punkte mit Stummel und Via auf In1 im KiCad-Router (Schieben) gezogen.
    mainboard.kicad_pro von KiCad 10 beim Öffnen normalisiert (Netzklassen unverändert).
2026-10-23 WIP Handrouting: C6 GND_PWR-Via, 5V_SYS an U14 über B.Cu, PYRO3_NEG (Messleitung über In2), DRC 0/16; Klick-Anleitung
2026-10-23 WIP Handrouting: U7_VINT kürzer neu (28 statt 45 mm, gibt In2 im Mux-Bereich frei), VBAT1_SENSE über B.Cu; DRC 0/15
2026-10-23 WIP Handrouting: CS_EXT2 neu (5,5 mm B.Cu), VSERVO C35 an die Schiene, VSERVO-Flächen unter J16 vereint; DRC 0/14
2026-10-23 Generator rev B1: Strompfade abgeriegelt, 2S-Kette und DRV8833-Kondensatoren neu platziert; neuer Lauf DRC 0/18
    - add_corridor_spines(): 0,2 mm Sperrfläche auf der Mittellinie jedes Strompfads (keine Bahnen,
    keine Vias); die geschrumpfte Sperre aus carve_corridors() verschwand bei schmalen Pfaden, und
    Freerouting schnitt VBAT_PROT über F1 und den VM-Stich des DRV8833 durch.
    - Q6 0,8 mm nach rechts, festes Via für sein Gate (ESCAPES); R2 und R4 fest unter Q6 mit eigenen
    VBAT2_F-Pfaden; J18 mit VBAT2_RAW-Pfad zum XT30; VSERVO-Schiene bis J_STACK Pin 5/6.
    - C35, C36, C37, C38 fest an U7 bzw. an der VSERVO-Schiene statt 8 bis 14 mm entfernt.
    - Ergebnis ./make.sh pcb: 0 DRC-Fehler, 18 of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
2026-10-23 Nacharbeit Lauf 1: 10 Verbindungen per Planer und von Hand (GND an U6/U2, VSYS_IN, 5V_SYS, GND_PWR, VSERVO C37, PYRO2_SENSE); DRC 0/8
2026-10-23 Nacharbeit: PYRO3_NEG (Messleitung über In2) und PYRO4_NEG (VBAT_ARMED-Abgriff rechts um D6, R44 gedreht); DRC 0/5
2026-10-23 Nacharbeit DRV8833: ISEN-Pins 3/6 ans Wärmepad, MOT_A über zwei Vias und B.Cu zu J8.1, MOT_B über ein Via und B.Cu zu J8.2; DRC 0/2
2026-10-23 Platine rev B1: alle Verbindungen geschlossen, DRC 0 Fehler / 0 offen
    LORA_RXD (TXD-Fanout-Via versetzt, eigenes Via für RXD) und CS_EXT2 neu verlegt.
2026-10-23 Platine rev B1 fertig geroutet: Bestückungsdruck neu, Bilder, README §1/§5.5/§8 auf 0 offen
    DRC 0 Fehler, 0 nicht verbunden, Parität 0; review_check_layout.py ohne Befund (kein 2S-Netz auf In2,
    im IMU-Umfeld nur die fünf GND-Vias, Strom-Netze nur F.Cu ohne Via).
2026-10-23 Bahnen aufgeräumt: LORA_RXD, VSYS_IN, CS_EXT2, PYRO2_SENSE begradigt, Engstellen auf 0,15 mm
    326 Treppensegmente (0,05-mm-Raster des Gitter-Routers) zu 56 geraden Stücken zusammengefasst,
    Abstand je Netzklasse eingehalten; die sieben Bahnen mit 0,10 bis 0,12 mm auf 0,15 mm verbreitert
    (LORA_M1 dafür mit kleinem Knick vom 3V3_RF-Via weg). DRC 0 Fehler / 0 offen, Prüfskript ohne Befund.
2026-10-23 Rundgang durch die Platine als PDF (13 Seiten) mit Bildern aus der Platinendatei
    Lageplan der Bauteile, Lagenaufbau und warum vier Lagen, Masse- und Versorgungsflächen, Strompfade,
    Leitungen und Vias an Beispielen (Pyro 3, DRV8833, IMU-Zone), Entstehung, was der DRC prüft, KiCad-Tipps,
    Glossar. Erzeugt mit guide_dump.py (KiCad-Python) und make_guide.py.
2026-10-23 Platine rev B1: Versorgung verbreitert, Bestelldateien für JLCPCB
    widen.py setzt schmale Versorgungsstücke nach dem Handrouting auf 0,6 / 0,4 / 0,3 mm, soweit der DRC es
    zulässt: VSYS_IN durchgehend 0,6 (A7), MOT_A/MOT_B 0,6 (0,4 an den DRV8833-Pins), 5V_SYS-Zweig zum LDO 0,4,
    GND_PWR-Stich zu J_SW 0,6; offen bleibt ein 1,9-mm-Stück GND_PWR an DRV8833 Pin 13 (Reviewpunkt).
    DRC 0 Fehler, 0 offen, Parität 0, kein 2S-Netz auf In2.
    ./make.sh fab (fab.py): Gerber + Excellon als ZIP, BOM und CPL in JLC-Spalten, FAB.md mit den Teilen ohne
    LCSC-Nummer, den THT-Teilen zum Selbstlöten und den DNP-Teilen. ORDER.md §3.2 und README §3/§5.5/§8
    nachgezogen, Renders neu.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
2026-10-23 KiCad: .history (eingebettetes Git-Verzeichnis eines Editor-Plugins) aus dem Index genommen und ignoriert
2026-10-23 Review-Brief rev B1 für den Kollegen; READMEs auf den Stand der Platine (rev B1 fertig geroutet, Bestelldateien)
2026-10-23 Bestellliste: Gegenstecker und Kabel je Buchse (rev B1), Stapelstecker 2x10
2026-10-23 Platine rev B1: Magnetometer LIS3MDL und SHT40 bestückt, ADXL375 als DNP-Footprint, alle an I2C und 3V3
    Zukunftsfähigkeit (Jan, 23.10.): LIS3MDL (C478483, 0x1E) in der linken Spitzenecke, SHT40 (C2848306, 0x44)
    neben J_QWIIC, ADXL375 (C579466, 0x53, DNP) hinter dem USB-Ende des Teensy. I2C statt SPI1, weil die
    Spitze nur über das I2C-Paar erreichbar ist und SPI1 der Flugbus bleibt; 3V3 statt 3V3_SENS (45 mm).
    Pinbelegungen gegen die Datenblätter geprüft (LIS3MDL Reserved an GND, C1 100 nF; SHT40 Die-Pad frei).
    add_parts.py setzt neue Teile aus circuit.py in die fertige Platine (Netze, Blattpfad, DNP, Kupfer unter
    den Pads weg); route_gaps.py kann Masse-Vias in Inseln setzen (GND-Inseln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
2026-10-23 Firmware rev B1: Testauftrag für den Firmware-Agenten und geführter Tischtest am PC
    tools/bench_test.py fragt die Testpunktspannungen ab, flasht optional revb_bringup,
    wertet dessen Selbsttest aus und misst in Ruhe Gyro-Offset, |a| und Druckrauschen.
    Testauftrag_Agent_2026-10-23.md beschreibt Testmodus, Kalibrierung und Sicherheitsregeln.
2026-10-23 Treiber rev B1: IMU-Schnittstelle mit Werksselbsttest, LIS3MDL, SHT40, ADXL375 (nur erkennen)
    BoardRevB.h auf den Stand von circuit.py (claude/rev-b1): I2C-Adressen der neuen
    Bausteine, Schiene 3V3_EXP, Testpunkte; die Pins sind gegenüber rev B unverändert
    (check_board_pins.py: 39 Pins, 8 CS, 8 Mux-Kanäle stimmen). Imu.h kapselt die IMU
    hinter begin/whoAmI/dataReady/read/selfTest, damit ein LSM6DSV16X-Treiber ohne
    Umbau dazukommen kann. ICM42688 bekommt den Selbsttest nach dem TDK-Referenzablauf.
    revb_bringup prüft jetzt auch Magnetometer, SHT40 und ADXL375 (DNP).
    Claude-Session: https://claude.ai/code/session_01R5mm6q8m1vgrzf4qVp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
2026-10-23 Kalibrierwerte mit Version und CRC im EEPROM-Emulat, Ellipsoid-Fit und Achszuordnung
    lib/calstore: CalData.h (reines C++, CRC-32, Standardwerte, Prüfung), CalStore
    (EEPROM des Teensy, Rücklesen nach dem Schreiben), EllipsoidFit.h (Hard-/Soft-Iron
    mit Residuum und Oktanten), AxisFit.h (Magnetometer zum Körper aus einer Drehung,
    24 rechtshändige Kandidaten). Host-Tests mit g++ in test/host/. Die Flug-Firmware
    lädt den Block beim Start und warnt bei leerem oder beschädigtem Block.
    Claude-Session: https://claude.ai/code/session_01R5mm6q8m1vgrzf4qVpifDZ
2026-10-23 Testkonsole revb_test: Befehlsmenü, Prüfungen je Funktion, geführte Kalibrierung
    Neue PlatformIO-Umgebung revb_test. Feste Ausgabezeilen TEST/CAL/END/ASK/WAIT/CONFIRM
    (Proto.h). Prüfungen: Mux, IMU mit Selbsttest, Barometer, Magnetometer, SHT40,
    ADXL375, INA239 (auch unter Last), LEDs, Summer, Kamera, Servos im Fenster aus
    Config.h, Rollmotor mit nFAULT, Pyro nur mit Lämpchen nach CONFIRM, LoRa mit Ping
    und RSSI, GPS (NMEA-Parser, Host-Test), SD-Karte mit Datenrate, Loop-Timing,
    Watchdog. Kalibrierung: Gyro, sechs Lagen, Magnetometer-Ellipsoid, Achsen, Baro,
    ADC-Teiler gegen Multimeter, INA239, Servo-Trimm; cal save ins EEPROM-Emulat.
    Ohne 2S melden die betroffenen Prüfungen SKIP.
    Co-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
2026-10-23 bench_test.py treibt die Testkonsole, Parser-Tests und Host-Tests in der CI
    bench_test.py stößt die Befehle nacheinander an, beantwortet Rückfragen über die
    Tastatur, wertet TEST- und CAL-Zeilen aus und schreibt Markdown und JSON; nach
    "watchdog fire" verbindet es neu. Der alte Ablauf für revb_bringup bleibt als
    --bringup. tools/test_bench_test.py prüft Parser, Befehlssteuerung und Bericht
    mit aufgezeichneten Beispielzeilen (testdata/). CI-Job "tischtest" führt pytest
    und die g++-Tests aus.
    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
2026-10-23 Versuchsanleitungen rev B1: zwölf Versuche mit Geräten, Aufbau, Sollwerten und Protokollfeldern
    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
2026-10-23 Versuch E02: Servo -> Kardan auf rev B1 (tvc-Befehl in revb_test, Aufnahme, Durchführung)
    Die Anregungsfolge aus E01 (Treppe, Sprünge, Wechselsprünge, zwei Chirps) läuft jetzt in
    der Testkonsole: externe ICM-20948 auf dem Motorrohr an J_QWIIC, Platinen-IMU als
    Rumpfmessung in #body-Zeilen, CSV im Format von servo_ident für ident_servo.py.
    tools/capture_tvc.py nimmt einen Lauf auf. Die Durchführung (Material, Aufbau, Fenster
    prüfen, Läufe, Auswertung, Protokoll) steht in docs/experiments/E02_TVC_Charakterisierung_revB1.md.
    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
2026-10-23 Versuchsanleitungen rev B1 in der Gliederung von E02: Vorbereitung an der Konsole, Läufe mit Aufnahmebefehl, Auswertung, Grenzen
    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
2026-10-23 revb_test: Dependency-Finder auf deep, damit die Treiber über Board.h gefunden werden
    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
2026-10-23 revb_test: Treiber-Header direkt in main.cpp, damit der Dependency-Finder lib/mainboard_revb findet
    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
2026-10-24 Platine rev B1: SPI0 auf J_STACK (E11), IMU LSM6DSV16X statt ICM-42688-P (E12), DRC 0/0
    - J_STACK Pin 7/8/9 an SPI0 (Teensy 13/11/12) statt SPI1; nSLEEP -> 40, PYRO3_FIRE -> 41,
    PWM_EXT -> 33, LORA_M0 -> 16; keine Reservepins mehr (circuit.py, check_design.py, Doku)
    - IMU LSM6DSV16X (C5267406) auf dem LGA-14-Footprint des ICM: Pins 2/3 an GND, 9-11 offen
    (AN5763 Tab. 1), JLC-Preis 3,4 statt 21,5 USD; Massepfad der IMU-Pads 2/3/6/7 ueber C26,
    3V3_SENS von Pad 5 ueber C26/C28 zu Pad 8
    - die sieben neuen Wege von Hand geplant (eigene Sitzung 24.10.): 59 Vias, 13 kurze Stuecke
    auf B.Cu; SPI0_MISO 114 mm, SPI0-Takt zur Zusatzplatine hoechstens 8 MHz
    - Reststummel (PYRO1_SENSE, PYRO4_SENSE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
2026-10-24 Firmware rev B1: Pinbelegung nach E11 (SPI0 auf J_STACK), Hinweis auf LSM6DSV16X
    - BoardRevB.h: 11/12/13 = SPI0 MOSI/MISO/SCK zur Zusatzplatine, 16 LORA_M0, 33 PWM_EXT,
    40 MOT_NSLEEP, 41 PYRO3_FIRE; keine freien Pins mehr; check_board_pins.py: OK
    - Inbetriebnahme-Programm und README: IMU-Treiber bleibt vorerst ICM-42688-P, die Platine
    traegt seit 23.10. einen LSM6DSV16X (WHO_AM_I 0x70), Treiber folgt
2026-10-24 Mainboard rev B1: Prüfanleitung für das Review und Einkaufsliste (alles außer JLCPCB); Blatt Sensorik: Titel auf LSM6DSV16X
2026-10-24 Schaltplan: Blattname Sensorik mit LSM6DSV16X auch im Wurzelblatt
2026-10-26 platformio.ini: revb_test erbt die Teensy-Basis (nach dem Merge der Flug-Firmware nötig)
2026-10-26 Review-Paket rev B1, JLCPCB-Testangebot vom 23.10. und Baustellenliste zum 26.10.
    - hardware/mainboard/REVIEW_PAKET_2026-10-26.md: wo der Stand liegt, heute gelaufene Prüfungen
    (DRC 0 Fehler, Netzliste OK, Layoutskript ohne Befund), Unterlagen in Lesereihenfolge,
    Ablauf der Durchsicht, Entscheidungen vor der Bestellung (IMU-Bereich erledigt: E12 ca. 5 g am Sensor)
    - hardware/mainboard/Angebot_JLCPCB_2026-10-23.md: Testangebot mit den rev-B-Dateien, LCSC-Nummern der Passiven
    - docs/Baustellen_2026-10-26.md: offene Arbeiten nach Strängen mit Reihenfolge bis zum Erstflug
    - READMEs: Verweise auf die drei Dokumente
2026-10-26 Abschlussprüfung Mainboard rev B1 vor der Bestellung (26.10.)
    Fertigungsdaten in kicad/fab gegen Spezifikation und JLCPCB-Grenzen geprüft: zweiter DRC-Lauf mit den
    JLCPCB-Mindestwerten, Bohrdatei, Umriss, BOM/CPL-Abgleich, Lagerregeln; keine Verletzung. Die 17 KiCad-Warnungen
    betreffen nur den Bestückungsdruck. Empfehlungen für das Bestellformular. READMEs: Verweis.
2026-10-26 Mainboard rev B1: Reviewbewertung, Layoutpunkte B1-B3 eingearbeitet, Fertigungsdaten neu
    - Review_Bewertung_2026-10-26.md: die zehn Reviewfragen mit gemessenen Kupferbreiten (Abtragen bis zum
    Verbindungsabriss), Verschaltung Pin für Pin gegen TPS63070-, Ebyte-E22-T- und Sensor-Datenblätter; kein A-Punkt
    - Layout: VSYS_IN 0,6 mm auf F.Cu und 1,2 mm auf In2 (0,78 mm auf 0,9 mm am Via, SERVO_CHUTE im Weg); Stich zur
    Anode von D1 0,6 mm; Zone "VSERVO Stich DRV8833 VM" (0,30 -> 0,40 mm, Pinbreite); DRC 0 Fehler, 0 offen
    - make.sh sch exportiert out/mainboard.net (die lokale Datei war vom 22.10., rev B; out/ ist nicht im Repo);
    fab/, img/, drc.rpt neu erzeugt
    - READMEs, Abschlussprüfung u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
2026-10-26 Datenblatt MS-MB-B auf rev B1 (Version 0.2, Bestellfassung); Abbildungen und Platzierungsplan auf B1
    - MS-MB-B.tex neu gefasst: Lastschalter, Lader, SPI1-Flugbus mit 74HC138/74HC4051, INA239, LSM6DSV16X,
    J_STACK-Belegung, Zusatzsensoren, vier Pyro-Kanäle, Teensy-Pinbelegung nach README §4, Kennwerte und
    Layoutbreiten aus der Abschlussprüfung und Review-Bewertung vom 26.10., Fertigungsangaben, Änderungen
    gegenüber rev B; 21 Seiten, 0 Fehler, 0 Overfull
    - figures.py: Blockschaltbild, Versorgungsbaum, Pyro-Kanal und Teensy-Pinbelegung auf B1; outline.py:
    Zonenbeschriftung des Platzierungsplans auf B1 (Geometrie unverändert); circuit.py: Gruppenname IMU
    - READMEs, Review-Paket, kic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
2026-10-26 Thermovias DRV8833 auf 0,3 mm (Standard-Via-Option bei JLCPCB, kein Aufpreis); Fertigungsdaten und Datenblatt neu
    Die zwölf Thermovias unter dem DRV8833 hatten 0,2 mm Bohrung; JLCPCB verlangt dafür die 0,2-mm-Via-Option
    mit TG155 und Kelvin-Test (38 USD mehr). Jetzt 0,3 mm bei 0,5 mm Pad, DRC 0 Fehler, fab/ neu. Datenblatt:
    Bohrungen und Bestellparameter (grün, LeadFree HASL, Bestellung 26.10.).
2026-10-26 Bestellung JLCPCB 26.10.: Konfiguration, Bestückungsumfang, Selbstlöt-Liste; Upload-Kopien von BOM und CPL
    5 Platinen grün/HASL 30,20 USD, Standard PCBA 2 Stück 145,73 USD (LGA-Sensoren nur mit Standard), BMP388 statt
    BMP390, INA239 ohne Bestand; 19 einfache Extended-Positionen plus E22, WS2812 und THT werden selbst gelötet.
2026-10-26 Einkaufsliste: bestellfertige Körbe Reichelt (Artikelnummern, Mengen) und AliExpress
2026-10-26 Beschaffungsliste 26.10.: Selbstlöt-Teile bei Reichelt, DigiKey, LCSC mit Artikelnummern, Bestand und Bestellaufteilung
    Recherche vom 26.10.2026 (Reichelt-Suche, DigiKey-Produktseiten; Mouser nicht erreichbar). Drei Bestellungen:
    Reichelt ca. 26 EUR, DigiKey ca. 79 EUR netto (versandfrei ab 75 EUR, INA239 als Rückstand ab 02.11.), LCSC für
    E22 und XT30PW-M. Ersatztypen mit Begründung, offene Positionen mit Vorschlag.
2026-10-26 Beschaffung: Stand der Warenkörbe JLCPCB, Reichelt (26 Pos.), DigiKey (15 Pos.); Mouser ohne INA239 bis 2027
2026-10-26 Beschaffung: Bestellungen DigiKey/JLCPCB aufgegeben, Option Selbstbestückung (DigiKey-Liste, BMP384, Sensoren von LCSC)
2026-10-26 Beschaffung §6c: AliExpress-Liste für Rakete (E22, XT30PW, Pigtail, Antenne, GH/SH-Kabel) und Bodenstation
2026-10-26 Beschaffung: E22 auf 2 Stück (eine Platine), Ebyte-Shop, Bodenstation-Minimum mit E22-400T22U und Zündbox
2026-10-26 Beschaffung/Inventar: USB-C-Buchse auf die AliExpress-Liste, Bestand laut Jan (Teensy, Lader, Akkus, GPS, Motoren)
2026-10-27 JLCPCB-CPL mit Drehkorrektur: SOT-23 und LGA-14 +180, BMP +90, DRV8833 -90 (Vorschau 27.10.)
2026-10-27 JLCPCB: Zweitprüfung der Platzierung, 106 Teile, alle gepolten Bauteile richtig
2026-10-27 Beschaffung: AliExpress-Korb fuer zwei Platinen (Wendeln, 2. USB-C), Flugantenne, Servostecker, Akkupreise
2026-10-27 Plan Bordzuendung: Motorstart ueber Pyro 1 per gesichertem Funkbefehl; Einkaufsliste und READMEs nachgezogen
2026-10-27 Inventar 27.10.: GPS ist u-blox NEO-6M (GY-GPS6MV2), Teensy-Stiftleisten/Schalter/Elkos vorhanden, Epoxid offen; GPS-Halter muss auf 25-mm-Patch
2026-10-27 Druckteile Stand 2d: GPS-Halter fuer NEO-6M (Querleisten, Auflagekante), Fenster in beiden Zapfen und neben den Akkus, Kabeldurchfuehrung verlegt; Schlitten 64 -> 58 g, Start 705 g, Schwerpunkt 260 m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
2026-10-27 Beschaffung: Pigtails 15 cm, Vollstaendigkeit vor der AliExpress-Bestellung
2026-10-27 Startrampe und TVC-Pruefstand auf die gebaute Rakete: Stuetzen 45/135/250, 2 mm Fuehrungsluft, Pruefung gegen modular.build_all() mit Schraubenkoepfen, Zuendkasten entfaellt; Pruefstand eigenstaendig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
2026-10-27 Bodenstation = Board 2 als Funkbruecke; AliExpress nur E22 x2 (21,13 EUR); HC-12-Antennen, JST am 2S
2026-10-27 Bodenstation: Funkbruecke Pico + drittes E22 statt Board 2; AliExpress 3 x E22 (28,72 EUR)
2026-10-27 Funkbruecke der Bodenstation: Druckgehaeuse fuer Pico + E22 mit senkrechtem Halbwellen-Dipol (cad/groundbridge.py), STL, Bilder, Doku
2026-10-27 Passmasse nach Jans Messung (Rohr innen 72,5): Zapfen 72,1, Schraubring 69,8; STL, Bilder, Massenbudget (704 g), Doku
2026-11-10 READMEs als Schaufenster: knapper Text, Foto der gelieferten Platine rev B1, Bildergalerie, Stand 10.11.2026
2026-11-10 READMEs: Abschnitt vom Breakout-Aufbau zur Platine rev B1 mit Foto des alten Ring-Stacks
